karliedapuzzo/TDWS/README.md

# TDWS
Senior Project 2024-25: Train Detection and Warning System.<br>

Made by Raphael Jara and Karlie D'Apuzzo
