karliedapuzzo/TDWS/Schematic Files/Senior_Project_Schematic_Design/Cart_Feb04_0515PM.xls

SHOPPING CART
This is not an invoice
04-Feb-25 17:15:47
 | Mouser # | Mfr. # | Manufacturer | Customer # | Description | RoHS | Lifecycle | Order Qty. | Price (USD) | Ext.: (USD)
1 | 651-1729128 | 1729128 | Phoenix Contact |  | Fixed Terminal Blocks 2P 5.08mm 90DEG | RoHS Compliant By Exemption |  | 12 | $0.935 | $11.22
2 | 71-CRCW06031K00FKED | CRCW06031K00FKED | Vishay |  | Thick Film Resistors - SMD D11/CRCW0603 100 1K0 1% ET3 E3 | RoHS Compliant By Exemption |  | 16 | $0.033 | $0.53
3 | 667-ERA-3AED301V | ERA-3AED301V | Panasonic |  | Thin Film Resistors - SMD 0603 300ohms 25ppm 0.5% AEC-Q200 | RoHS Compliant By Exemption |  | 4 | $0.12 | $0.48
4 | 810-CGA3EDX7T1A106M0 | CGA3EDX7T1A106M080AU | TDK |  | Multilayer Ceramic Capacitors MLCC - SMD/SMT 0603,X7T,10V,10uF,+/-20%,0.8mm, AEC-Q200 | RoHS Compliant | New Product | 8 | $0.49 | $3.92
5 | 485-4479 | 4479 | Adafruit |  | Multiple Function Sensor Development Tools Adafruit Triple-axis Magnetometer - LIS3MDL - STEMMA QT / Qwiic | RoHS Compliant |  | 3 | $9.95 | $29.85
6 | 187-CL32Y476KPVVPNE | CL32Y476KPVVPNE | Samsung Electro-Mechanics |  | Multilayer Ceramic Capacitors MLCC - SMD/SMT 47uF X7S 10V 1210 Auto grade | RoHS Compliant | New Product | 8 | $1.04 | $8.32
7 | 941-C503DWANCCBEB232 | C503D-WAN-CCBEB232 | Cree LED |  | White LEDs White Round | RoHS Compliant |  | 16 | $0.273 | $4.37
8 | 474-PRT-16581 | PRT-16581 | SparkFun Electronics |  | Headers & Wire Housings Female Header - 2x18 | RoHS Compliant |  | 8 | $1.75 | $14.00
9 | 737-PH1RB-08-UA | PH1RB-08-UA | Adam Tech |  | Headers & Wire Housings CONN HEADER R/A 8POS 2.54MM | RoHS Compliant | New At Mouser | 4 | $0.23 | $0.92
10 | 653-A6FR-4101 | A6FR-4101 | Omron |  | DIP Switches / SIP Switches 4 Pole Short Actuator (white) | RoHS Compliant |  | 4 | $1.13 | $4.52
By submitting your order you agree to these terms and conditions. (https://www.mouser.com/saleterms) |  |  |  |  |  |  |  |  | Merchandise: | $78.13
Prices are reflected at the date and time shown. |  |  |  |  |  |  |  |  | Shipping Charge: | $7.99
