karliedapuzzo/TDWS/TDWS_PIC24_FILES/Main_Project/TDWS_Main_Prgram.X/queuelogs/debugtool.txt

65914 1741394754487 GEN4_TO_CONTROLLER_LOG:GEN4_DEBUG_INT_LOG_PIC24FJ128GL306 BitSetInfo: Address = 1a0, Mask = 4000, SetVal = 4000, Type = FileRegs
65914 1741394754487 GEN4_TO_CONTROLLER_LOG:GEN4_DEBUG_INT_LOG_PIC24FJ128GL306 BitSetInfo: Values:
65914 1741394754487 GEN4_TO_CONTROLLER_LOG:GEN4_DEBUG_INT_LOG_PIC24FJ128GL306 BitSetInfo: Address = 1a2, Mask = 4000, SetVal = 4000, Type = FileRegs
65914 1741394754487 GEN4_TO_CONTROLLER_LOG:GEN4_DEBUG_INT_LOG_PIC24FJ128GL306 BitSetInfo: Values:
65914 1741394754487 GEN4_TO_CONTROLLER_LOG:GEN4_DEBUG_INT_LOG_PIC24FJ128GL306 BitSetInfo: Address = 1ae, Mask = 4000, SetVal = 4000, Type = FileRegs
65914 1741394754487 GEN4_TO_CONTROLLER_LOG:GEN4_DEBUG_INT_LOG_PIC24FJ128GL306 BitSetInfo: Values:
65914 1741394754487 GEN4_TO_CONTROLLER_LOG:GEN4_DEBUG_INT_LOG_PIC24FJ128GL306 BitSetInfo: Address = 1b0, Mask = 4000, SetVal = 4000, Type = FileRegs
65914 1741394754487 GEN4_TO_CONTROLLER_LOG:GEN4_DEBUG_INT_LOG_PIC24FJ128GL306 BitSetInfo: Values:
65914 1741394754487 GEN4_TO_CONTROLLER_LOG:GEN4_DEBUG_INT_LOG_PIC24FJ128GL306 BitSetInfo: Address = 1cc, Mask = 4000, SetVal = 4000, Type = FileRegs
65914 1741394754487 GEN4_TO_CONTROLLER_LOG:GEN4_DEBUG_INT_LOG_PIC24FJ128GL306 BitSetInfo: Values:
65914 1741394754487 GEN4_TO_CONTROLLER_LOG:GEN4_DEBUG_INT_LOG_PIC24FJ128GL306 BitSetInfo: Address = 26c, Mask = 4000, SetVal = 4000, Type = FileRegs
65914 1741394754487 GEN4_TO_CONTROLLER_LOG:GEN4_DEBUG_INT_LOG_PIC24FJ128GL306 BitSetInfo: Values:
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
65914 1741394754487 GEN4_TO_CONTROLLER_LOG:GEN4_DEBUG_INT_LOG_PIC24FJ128GL306 BitSetInfo: Address = 4c4, Mask = 4000, SetVal = 4000, Type = FileRegs
65914 1741394754487 GEN4_TO_CONTROLLER_LOG:GEN4_DEBUG_INT_LOG_PIC24FJ128GL306 BitSetInfo: Values:
65914 1741394754487 GEN4_TO_CONTROLLER_LOG:GEN4_DEBUG_INT_LOG_PIC24FJ128GL306 BitSetInfo: Address = 540, Mask = 4000, SetVal = 4000, Type = FileRegs
65914 1741394754487 GEN4_TO_CONTROLLER_LOG:GEN4_DEBUG_INT_LOG_PIC24FJ128GL306 BitSetInfo: Values:
65914 1741394754487 GEN4_TO_CONTROLLER_LOG:GEN4_DEBUG_INT_LOG_PIC24FJ128GL306 BitSetInfo: Address = 65c, Mask = 4000, SetVal = 4000, Type = FileRegs
65914 1741394754487 GEN4_TO_CONTROLLER_LOG:GEN4_DEBUG_INT_LOG_PIC24FJ128GL306 BitSetInfo: Values:
65914 1741394754487 GEN4_TO_CONTROLLER_LOG:GEN4_DEBUG_INT_LOG_PIC24FJ128GL306 BitSetInfo: Address = 734, Mask = 4000, SetVal = 4000, Type = FileRegs
65914 1741394754487 GEN4_TO_CONTROLLER_LOG:GEN4_DEBUG_INT_LOG_PIC24FJ128GL306 BitSetInfo: Values:
65914 1741394754487 GEN4_TO_CONTROLLER_LOG:GEN4_DEBUG_INT_LOG_PIC24FJ128GL306 BitSetInfo: Address = fd0036, Mask = 1, SetVal = 1, Type = Emulation
65914 1741394754487 GEN4_TO_CONTROLLER_LOG:GEN4_DEBUG_INT_LOG_PIC24FJ128GL306 Payload End
65914 1741394754487 XXXX 1741394754487, Thread 65914: XXXX 1741394754487, Entering Thread 65914: Commands::runScriptWithUpload, script name = ReadRAM  
65914 1741394754487 XXXX 1741394754487, Thread 65914: XXXX 1741394754487, Entering Thread 65914: ToolCommUsb::readTransfer, sideData is 0x28 bytes long, transferDataLength is 0x2 bytes long  
65914 1741394754490 XXXX 1741394754490, Thread 65914: XXXX 1741394754490, Exiting Thread 65914: ToolCommUsb::readTransfer,  cr.status = 0x0  
65914 1741394754490 XXXX 1741394754490, Thread 65914: XXXX 1741394754490, Exiting Thread 65914: Commands::runScriptWithUpload  
65914 1741394754490 XXXX 1741394754490, Thread 65914: XXXX 1741394754490, Entering Thread 65914: Commands::runScriptWithDownload, script name = WriteRAM  
65914 1741394754495 XXXX 1741394754495, Thread 65914: XXXX 1741394754495, Exiting Thread 65914: Commands::runScriptWithDownload(WriteRAM)  
65914 1741394754495 XXXX 1741394754495, Thread 65914: XXXX 1741394754495, Entering Thread 65914: Commands::runScriptWithUpload, script name = ReadRAM  
65914 1741394754495 XXXX 1741394754495, Thread 65914: XXXX 1741394754495, Entering Thread 65914: ToolCommUsb::readTransfer, sideData is 0x28 bytes long, transferDataLength is 0x2 bytes long  
65914 1741394754498 XXXX 1741394754498, Thread 65914: XXXX 1741394754498, Exiting Thread 65914: ToolCommUsb::readTransfer,  cr.status = 0x0  
65914 1741394754498 XXXX 1741394754498, Thread 65914: XXXX 1741394754498, Exiting Thread 65914: Commands::runScriptWithUpload  
65914 1741394754498 XXXX 1741394754498, Thread 65914: XXXX 1741394754498, Entering Thread 65914: Commands::runScriptWithDownload, script name = WriteRAM  
65914 1741394754501 XXXX 1741394754501, Thread 65914: XXXX 1741394754501, Exiting Thread 65914: Commands::runScriptWithDownload(WriteRAM)  
65914 1741394754501 XXXX 1741394754501, Thread 65914: XXXX 1741394754501, Entering Thread 65914: Commands::runScriptWithUpload, script name = ReadRAM  
65914 1741394754501 XXXX 1741394754501, Thread 65914: XXXX 1741394754501, Entering Thread 65914: ToolCommUsb::readTransfer, sideData is 0x28 bytes long, transferDataLength is 0x2 bytes long  
65914 1741394754503 XXXX 1741394754503, Thread 65914: XXXX 1741394754503, Exiting Thread 65914: ToolCommUsb::readTransfer,  cr.status = 0x0  
65914 1741394754503 XXXX 1741394754503, Thread 65914: XXXX 1741394754503, Exiting Thread 65914: Commands::runScriptWithUpload  
65914 1741394754503 XXXX 1741394754503, Thread 65914: XXXX 1741394754503, Entering Thread 65914: Commands::runScriptWithDownload, script name = WriteRAM  
65914 1741394754506 XXXX 1741394754506, Thread 65914: XXXX 1741394754506, Exiting Thread 65914: Commands::runScriptWithDownload(WriteRAM)  
65914 1741394754506 XXXX 1741394754506, Thread 65914: XXXX 1741394754506, Entering Thread 65914: Commands::runScriptWithUpload, script name = ReadRAM  
65914 1741394754506 XXXX 1741394754506, Thread 65914: XXXX 1741394754506, Entering Thread 65914: ToolCommUsb::readTransfer, sideData is 0x28 bytes long, transferDataLength is 0x2 bytes long  
65914 1741394754509 XXXX 1741394754509, Thread 65914: XXXX 1741394754509, Exiting Thread 65914: ToolCommUsb::readTransfer,  cr.status = 0x0  
65914 1741394754509 XXXX 1741394754509, Thread 65914: XXXX 1741394754509, Exiting Thread 65914: Commands::runScriptWithUpload  
65914 1741394754509 XXXX 1741394754509, Thread 65914: XXXX 1741394754509, Entering Thread 65914: Commands::runScriptWithDownload, script name = WriteRAM  
65914 1741394754512 XXXX 1741394754512, Thread 65914: XXXX 1741394754512, Exiting Thread 65914: Commands::runScriptWithDownload(WriteRAM)  
65914 1741394754512 XXXX 1741394754512, Thread 65914: XXXX 1741394754512, Entering Thread 65914: Commands::runScriptWithUpload, script name = ReadRAM  
65914 1741394754512 XXXX 1741394754512, Thread 65914: XXXX 1741394754512, Entering Thread 65914: ToolCommUsb::readTransfer, sideData is 0x28 bytes long, transferDataLength is 0x2 bytes long  
65914 1741394754514 XXXX 1741394754514, Thread 65914: XXXX 1741394754514, Exiting Thread 65914: ToolCommUsb::readTransfer,  cr.status = 0x0  
65914 1741394754514 XXXX 1741394754514, Thread 65914: XXXX 1741394754514, Exiting Thread 65914: Commands::runScriptWithUpload  
65914 1741394754514 XXXX 1741394754514, Thread 65914: XXXX 1741394754514, Entering Thread 65914: Commands::runScriptWithDownload, script name = WriteRAM  
65914 1741394754517 XXXX 1741394754517, Thread 65914: XXXX 1741394754517, Exiting Thread 65914: Commands::runScriptWithDownload(WriteRAM)  
65914 1741394754517 XXXX 1741394754517, Thread 65914: XXXX 1741394754517, Entering Thread 65914: Commands::runScriptWithUpload, script name = ReadRAM  
65914 1741394754517 XXXX 1741394754517, Thread 65914: XXXX 1741394754517, Entering Thread 65914: ToolCommUsb::readTransfer, sideData is 0x28 bytes long, transferDataLength is 0x2 bytes long  
65914 1741394754521 XXXX 1741394754521, Thread 65914: XXXX 1741394754521, Exiting Thread 65914: ToolCommUsb::readTransfer,  cr.status = 0x0  
65914 1741394754521 XXXX 1741394754521, Thread 65914: XXXX 1741394754521, Exiting Thread 65914: Commands::runScriptWithUpload  
65914 1741394754521 XXXX 1741394754521, Thread 65914: XXXX 1741394754521, Entering Thread 65914: Commands::runScriptWithDownload, script name = WriteRAM  
65914 1741394754524 XXXX 1741394754524, Thread 65914: XXXX 1741394754524, Exiting Thread 65914: Commands::runScriptWithDownload(WriteRAM)  
65914 1741394754524 XXXX 1741394754524, Thread 65914: XXXX 1741394754524, Entering Thread 65914: Commands::runScriptWithUpload, script name = ReadRAM  
65914 1741394754524 XXXX 1741394754524, Thread 65914: XXXX 1741394754524, Entering Thread 65914: ToolCommUsb::readTransfer, sideData is 0x28 bytes long, transferDataLength is 0x2 bytes long  
65914 1741394754527 XXXX 1741394754527, Thread 65914: XXXX 1741394754527, Exiting Thread 65914: ToolCommUsb::readTransfer,  cr.status = 0x0  
65914 1741394754527 XXXX 1741394754527, Thread 65914: XXXX 1741394754527, Exiting Thread 65914: Commands::runScriptWithUpload  
65914 1741394754527 XXXX 1741394754527, Thread 65914: XXXX 1741394754527, Entering Thread 65914: Commands::runScriptWithDownload, script name = WriteRAM  
65914 1741394754530 XXXX 1741394754530, Thread 65914: XXXX 1741394754530, Exiting Thread 65914: Commands::runScriptWithDownload(WriteRAM)  
65914 1741394754530 XXXX 1741394754530, Thread 65914: XXXX 1741394754530, Entering Thread 65914: Commands::runScriptWithUpload, script name = ReadRAM  
65914 1741394754530 XXXX 1741394754530, Thread 65914: XXXX 1741394754530, Entering Thread 65914: ToolCommUsb::readTransfer, sideData is 0x28 bytes long, transferDataLength is 0x2 bytes long  
65914 1741394754533 XXXX 1741394754533, Thread 65914: XXXX 1741394754533, Exiting Thread 65914: ToolCommUsb::readTransfer,  cr.status = 0x0  
65914 1741394754533 XXXX 1741394754533, Thread 65914: XXXX 1741394754533, Exiting Thread 65914: Commands::runScriptWithUpload  
65914 1741394754533 XXXX 1741394754533, Thread 65914: XXXX 1741394754533, Entering Thread 65914: Commands::runScriptWithDownload, script name = WriteRAM  
65914 1741394754536 XXXX 1741394754536, Thread 65914: XXXX 1741394754536, Exiting Thread 65914: Commands::runScriptWithDownload(WriteRAM)  
65914 1741394754536 XXXX 1741394754536, Thread 65914: XXXX 1741394754536, Entering Thread 65914: Commands::runScriptWithUpload, script name = ReadRAM  
65914 1741394754536 XXXX 1741394754536, Thread 65914: XXXX 1741394754536, Entering Thread 65914: ToolCommUsb::readTransfer, sideData is 0x28 bytes long, transferDataLength is 0x2 bytes long  
65914 1741394754539 XXXX 1741394754539, Thread 65914: XXXX 1741394754539, Exiting Thread 65914: ToolCommUsb::readTransfer,  cr.status = 0x0  
65914 1741394754539 XXXX 1741394754539, Thread 65914: XXXX 1741394754539, Exiting Thread 65914: Commands::runScriptWithUpload  
65914 1741394754539 XXXX 1741394754539, Thread 65914: XXXX 1741394754539, Entering Thread 65914: Commands::runScriptWithDownload, script name = WriteRAM  
65914 1741394754542 XXXX 1741394754542, Thread 65914: XXXX 1741394754542, Exiting Thread 65914: Commands::runScriptWithDownload(WriteRAM)  
65914 1741394754542 XXXX 1741394754542, Thread 65914: XXXX 1741394754542, Entering Thread 65914: Commands::runScriptWithUpload, script name = ReadRAM  
65914 1741394754542 XXXX 1741394754542, Thread 65914: XXXX 1741394754542, Entering Thread 65914: ToolCommUsb::readTransfer, sideData is 0x28 bytes long, transferDataLength is 0x2 bytes long  
65914 1741394754545 XXXX 1741394754545, Thread 65914: XXXX 1741394754545, Exiting Thread 65914: ToolCommUsb::readTransfer,  cr.status = 0x0  
65914 1741394754545 XXXX 1741394754545, Thread 65914: XXXX 1741394754545, Exiting Thread 65914: Commands::runScriptWithUpload  
65914 1741394754545 XXXX 1741394754545, Thread 65914: XXXX 1741394754545, Entering Thread 65914: Commands::runScriptWithDownload, script name = WriteRAM  
65914 1741394754547 XXXX 1741394754547, Thread 65914: XXXX 1741394754547, Exiting Thread 65914: Commands::runScriptWithDownload(WriteRAM)  
65914 1741394754547 XXXX 1741394754547, Thread 65914: XXXX 1741394754547, Entering Thread 65914: Commands::runScriptWithUpload, script name = ReadRAM  
65914 1741394754547 XXXX 1741394754547, Thread 65914: XXXX 1741394754547, Entering Thread 65914: ToolCommUsb::readTransfer, sideData is 0x28 bytes long, transferDataLength is 0x2 bytes long  
65914 1741394754550 XXXX 1741394754550, Thread 65914: XXXX 1741394754550, Exiting Thread 65914: ToolCommUsb::readTransfer,  cr.status = 0x0  
65914 1741394754550 XXXX 1741394754550, Thread 65914: XXXX 1741394754550, Exiting Thread 65914: Commands::runScriptWithUpload  
65914 1741394754550 XXXX 1741394754550, Thread 65914: XXXX 1741394754550, Entering Thread 65914: Commands::runScriptWithDownload, script name = WriteRAM  
65914 1741394754553 XXXX 1741394754553, Thread 65914: XXXX 1741394754553, Exiting Thread 65914: Commands::runScriptWithDownload(WriteRAM)  
65914 1741394754553 XXXX 1741394754553, Thread 65914: XXXX 1741394754553, Entering Thread 65914: Commands::runScriptWithUpload, script name = ReadRAM  
65914 1741394754553 XXXX 1741394754553, Thread 65914: XXXX 1741394754553, Entering Thread 65914: ToolCommUsb::readTransfer, sideData is 0x28 bytes long, transferDataLength is 0x2 bytes long  
65914 1741394754557 XXXX 1741394754557, Thread 65914: XXXX 1741394754557, Exiting Thread 65914: ToolCommUsb::readTransfer,  cr.status = 0x0  
65914 1741394754557 XXXX 1741394754557, Thread 65914: XXXX 1741394754557, Exiting Thread 65914: Commands::runScriptWithUpload  
65914 1741394754557 XXXX 1741394754557, Thread 65914: XXXX 1741394754557, Entering Thread 65914: Commands::runScriptWithDownload, script name = WriteRAM  
65914 1741394754559 XXXX 1741394754559, Thread 65914: XXXX 1741394754559, Exiting Thread 65914: Commands::runScriptWithDownload(WriteRAM)  
65914 1741394754559 XXXX 1741394754559, Thread 65914: XXXX 1741394754559, Entering Thread 65914: Commands::runScriptWithUpload, script name = ReadRAM  
65914 1741394754559 XXXX 1741394754559, Thread 65914: XXXX 1741394754559, Entering Thread 65914: ToolCommUsb::readTransfer, sideData is 0x28 bytes long, transferDataLength is 0x2 bytes long  
65914 1741394754562 XXXX 1741394754562, Thread 65914: XXXX 1741394754562, Exiting Thread 65914: ToolCommUsb::readTransfer,  cr.status = 0x0  
65914 1741394754562 XXXX 1741394754562, Thread 65914: XXXX 1741394754562, Exiting Thread 65914: Commands::runScriptWithUpload  
65914 1741394754562 XXXX 1741394754562, Thread 65914: XXXX 1741394754562, Entering Thread 65914: Commands::runScriptWithDownload, script name = WriteRAM  
65914 1741394754566 XXXX 1741394754566, Thread 65914: XXXX 1741394754566, Exiting Thread 65914: Commands::runScriptWithDownload(WriteRAM)  
65914 1741394754566 XXXX 1741394754566, Thread 65914: XXXX 1741394754566, Entering Thread 65914: Commands::runScriptWithUpload, script name = ReadRAM  
65914 1741394754566 XXXX 1741394754566, Thread 65914: XXXX 1741394754566, Entering Thread 65914: ToolCommUsb::readTransfer, sideData is 0x28 bytes long, transferDataLength is 0x2 bytes long  
65914 1741394754568 XXXX 1741394754568, Thread 65914: XXXX 1741394754568, Exiting Thread 65914: ToolCommUsb::readTransfer,  cr.status = 0x0  
65914 1741394754568 XXXX 1741394754568, Thread 65914: XXXX 1741394754568, Exiting Thread 65914: Commands::runScriptWithUpload  
65914 1741394754568 XXXX 1741394754568, Thread 65914: XXXX 1741394754568, Entering Thread 65914: Commands::runScriptWithDownload, script name = WriteRAM  
65914 1741394754570 XXXX 1741394754570, Thread 65914: XXXX 1741394754570, Exiting Thread 65914: Commands::runScriptWithDownload(WriteRAM)  
65914 1741394754570 XXXX 1741394754570, Thread 65914: XXXX 1741394754570, Entering Thread 65914: Commands::runScriptWithUpload, script name = ReadRAM  
65914 1741394754570 XXXX 1741394754570, Thread 65914: XXXX 1741394754570, Entering Thread 65914: ToolCommUsb::readTransfer, sideData is 0x28 bytes long, transferDataLength is 0x2 bytes long  
65914 1741394754573 XXXX 1741394754573, Thread 65914: XXXX 1741394754573, Exiting Thread 65914: ToolCommUsb::readTransfer,  cr.status = 0x0  
65914 1741394754573 XXXX 1741394754573, Thread 65914: XXXX 1741394754573, Exiting Thread 65914: Commands::runScriptWithUpload  
65914 1741394754573 XXXX 1741394754573, Thread 65914: XXXX 1741394754573, Entering Thread 65914: Commands::runScriptWithDownload, script name = WriteRAM  
65914 1741394754576 XXXX 1741394754576, Thread 65914: XXXX 1741394754576, Exiting Thread 65914: Commands::runScriptWithDownload(WriteRAM)  
65914 1741394754576 XXXX 1741394754576, Thread 65914: XXXX 1741394754576, Entering Thread 65914: Commands::runScriptWithUpload, script name = ReadRAM  
65914 1741394754576 XXXX 1741394754576, Thread 65914: XXXX 1741394754576, Entering Thread 65914: ToolCommUsb::readTransfer, sideData is 0x28 bytes long, transferDataLength is 0x2 bytes long  
65914 1741394754579 XXXX 1741394754579, Thread 65914: XXXX 1741394754579, Exiting Thread 65914: ToolCommUsb::readTransfer,  cr.status = 0x0  
65914 1741394754579 XXXX 1741394754579, Thread 65914: XXXX 1741394754579, Exiting Thread 65914: Commands::runScriptWithUpload  
65914 1741394754579 XXXX 1741394754579, Thread 65914: XXXX 1741394754579, Entering Thread 65914: Commands::runScriptWithDownload, script name = WriteRAM  
65914 1741394754582 XXXX 1741394754582, Thread 65914: XXXX 1741394754582, Exiting Thread 65914: Commands::runScriptWithDownload(WriteRAM)  
65914 1741394754582 XXXX 1741394754582, Thread 65914: XXXX 1741394754582, Entering Thread 65914: Commands::runScriptWithUpload, script name = ReadRAM  
65914 1741394754582 XXXX 1741394754582, Thread 65914: XXXX 1741394754582, Entering Thread 65914: ToolCommUsb::readTransfer, sideData is 0x28 bytes long, transferDataLength is 0x2 bytes long  
65914 1741394754586 XXXX 1741394754586, Thread 65914: XXXX 1741394754586, Exiting Thread 65914: ToolCommUsb::readTransfer,  cr.status = 0x0  
65914 1741394754586 XXXX 1741394754586, Thread 65914: XXXX 1741394754586, Exiting Thread 65914: Commands::runScriptWithUpload  
65914 1741394754586 XXXX 1741394754586, Thread 65914: XXXX 1741394754586, Entering Thread 65914: Commands::runScriptWithDownload, script name = WriteRAM  
65914 1741394754588 XXXX 1741394754588, Thread 65914: XXXX 1741394754588, Exiting Thread 65914: Commands::runScriptWithDownload(WriteRAM)  
65914 1741394754588 XXXX 1741394754588, Thread 65914: XXXX 1741394754588, Entering Thread 65914: Commands::runScriptWithUpload, script name = ReadRAM  
65914 1741394754588 XXXX 1741394754588, Thread 65914: XXXX 1741394754588, Entering Thread 65914: ToolCommUsb::readTransfer, sideData is 0x28 bytes long, transferDataLength is 0x2 bytes long  
65914 1741394754591 XXXX 1741394754591, Thread 65914: XXXX 1741394754591, Exiting Thread 65914: ToolCommUsb::readTransfer,  cr.status = 0x0  
65914 1741394754591 XXXX 1741394754591, Thread 65914: XXXX 1741394754591, Exiting Thread 65914: Commands::runScriptWithUpload  
65914 1741394754591 XXXX 1741394754591, Thread 65914: XXXX 1741394754591, Entering Thread 65914: Commands::runScriptWithDownload, script name = WriteRAM  
65914 1741394754593 XXXX 1741394754593, Thread 65914: XXXX 1741394754593, Exiting Thread 65914: Commands::runScriptWithDownload(WriteRAM)  
65914 1741394754593 XXXX 1741394754593, Thread 65914: XXXX 1741394754593, Entering Thread 65914: Commands::runScriptWithUpload, script name = ReadRAM  
65914 1741394754593 XXXX 1741394754593, Thread 65914: XXXX 1741394754593, Entering Thread 65914: ToolCommUsb::readTransfer, sideData is 0x28 bytes long, transferDataLength is 0x2 bytes long  
65914 1741394754596 XXXX 1741394754596, Thread 65914: XXXX 1741394754596, Exiting Thread 65914: ToolCommUsb::readTransfer,  cr.status = 0x0  
65914 1741394754596 XXXX 1741394754596, Thread 65914: XXXX 1741394754596, Exiting Thread 65914: Commands::runScriptWithUpload  
65914 1741394754596 XXXX 1741394754596, Thread 65914: XXXX 1741394754596, Entering Thread 65914: Commands::runScriptWithDownload, script name = WriteRAM  
65914 1741394754599 XXXX 1741394754599, Thread 65914: XXXX 1741394754599, Exiting Thread 65914: Commands::runScriptWithDownload(WriteRAM)  
65914 1741394754599 XXXX 1741394754599, Thread 65914: XXXX 1741394754599, Entering Thread 65914: Commands::runScriptWithUpload, script name = ReadRAM  
65914 1741394754599 XXXX 1741394754599, Thread 65914: XXXX 1741394754599, Entering Thread 65914: ToolCommUsb::readTransfer, sideData is 0x28 bytes long, transferDataLength is 0x2 bytes long  
65914 1741394754602 XXXX 1741394754602, Thread 65914: XXXX 1741394754602, Exiting Thread 65914: ToolCommUsb::readTransfer,  cr.status = 0x0  
65914 1741394754602 XXXX 1741394754602, Thread 65914: XXXX 1741394754602, Exiting Thread 65914: Commands::runScriptWithUpload  
65914 1741394754602 XXXX 1741394754602, Thread 65914: XXXX 1741394754602, Entering Thread 65914: Commands::runScriptWithDownload, script name = WriteRAM  
65914 1741394754605 XXXX 1741394754605, Thread 65914: XXXX 1741394754605, Exiting Thread 65914: Commands::runScriptWithDownload(WriteRAM)  
65914 1741394754605 XXXX 1741394754605, Thread 65914: XXXX 1741394754605, Entering Thread 65914: Commands::runScriptWithUpload, script name = ReadRAM  
65914 1741394754605 XXXX 1741394754605, Thread 65914: XXXX 1741394754605, Entering Thread 65914: ToolCommUsb::readTransfer, sideData is 0x28 bytes long, transferDataLength is 0x2 bytes long  
65914 1741394754608 XXXX 1741394754608, Thread 65914: XXXX 1741394754608, Exiting Thread 65914: ToolCommUsb::readTransfer,  cr.status = 0x0  
65914 1741394754608 XXXX 1741394754608, Thread 65914: XXXX 1741394754608, Exiting Thread 65914: Commands::runScriptWithUpload  
65914 1741394754608 XXXX 1741394754608, Thread 65914: XXXX 1741394754608, Entering Thread 65914: Commands::runScriptWithDownload, script name = WriteRAM  
65914 1741394754611 XXXX 1741394754611, Thread 65914: XXXX 1741394754611, Exiting Thread 65914: Commands::runScriptWithDownload(WriteRAM)  
65914 1741394754611 XXXX 1741394754611, Thread 65914: XXXX 1741394754611, Entering Thread 65914: Commands::runScriptWithUpload, script name = ReadRAM  
65914 1741394754611 XXXX 1741394754611, Thread 65914: XXXX 1741394754611, Entering Thread 65914: ToolCommUsb::readTransfer, sideData is 0x28 bytes long, transferDataLength is 0x2 bytes long  
65914 1741394754614 XXXX 1741394754614, Thread 65914: XXXX 1741394754614, Exiting Thread 65914: ToolCommUsb::readTransfer,  cr.status = 0x0  
65914 1741394754614 XXXX 1741394754614, Thread 65914: XXXX 1741394754614, Exiting Thread 65914: Commands::runScriptWithUpload  
65914 1741394754614 XXXX 1741394754614, Thread 65914: XXXX 1741394754614, Entering Thread 65914: Commands::runScriptWithDownload, script name = WriteRAM  
65914 1741394754618 XXXX 1741394754618, Thread 65914: XXXX 1741394754618, Exiting Thread 65914: Commands::runScriptWithDownload(WriteRAM)  
65914 1741394754618 XXXX 1741394754618, Thread 65914: XXXX 1741394754618, Entering Thread 65914: Commands::runScriptWithUpload, script name = ReadRAM  
65914 1741394754618 XXXX 1741394754618, Thread 65914: XXXX 1741394754618, Entering Thread 65914: ToolCommUsb::readTransfer, sideData is 0x28 bytes long, transferDataLength is 0x2 bytes long  
65914 1741394754621 XXXX 1741394754621, Thread 65914: XXXX 1741394754621, Exiting Thread 65914: ToolCommUsb::readTransfer,  cr.status = 0x0  
65914 1741394754621 XXXX 1741394754621, Thread 65914: XXXX 1741394754621, Exiting Thread 65914: Commands::runScriptWithUpload  
65914 1741394754621 XXXX 1741394754621, Thread 65914: XXXX 1741394754621, Entering Thread 65914: Commands::runScriptWithDownload, script name = WriteRAM  
65914 1741394754624 XXXX 1741394754624, Thread 65914: XXXX 1741394754624, Exiting Thread 65914: Commands::runScriptWithDownload(WriteRAM)  
65914 1741394754624 XXXX 1741394754624, Thread 65914: XXXX 1741394754624, Entering Thread 65914: Commands::runScriptWithUpload, script name = ReadRAM  
65914 1741394754624 XXXX 1741394754624, Thread 65914: XXXX 1741394754624, Entering Thread 65914: ToolCommUsb::readTransfer, sideData is 0x28 bytes long, transferDataLength is 0x2 bytes long  
65914 1741394754627 XXXX 1741394754627, Thread 65914: XXXX 1741394754627, Exiting Thread 65914: ToolCommUsb::readTransfer,  cr.status = 0x0  
65914 1741394754627 XXXX 1741394754627, Thread 65914: XXXX 1741394754627, Exiting Thread 65914: Commands::runScriptWithUpload  
65914 1741394754627 XXXX 1741394754627, Thread 65914: XXXX 1741394754627, Entering Thread 65914: Commands::runScriptWithDownload, script name = WriteRAM  
65914 1741394754630 XXXX 1741394754630, Thread 65914: XXXX 1741394754630, Exiting Thread 65914: Commands::runScriptWithDownload(WriteRAM)  
65914 1741394754630 XXXX 1741394754630, Thread 65914: XXXX 1741394754630, Entering Thread 65914: Commands::runScriptWithUpload, script name = ReadRAM  
65914 1741394754630 XXXX 1741394754630, Thread 65914: XXXX 1741394754630, Entering Thread 65914: ToolCommUsb::readTransfer, sideData is 0x28 bytes long, transferDataLength is 0x2 bytes long  
65914 1741394754632 XXXX 1741394754632, Thread 65914: XXXX 1741394754632, Exiting Thread 65914: ToolCommUsb::readTransfer,  cr.status = 0x0  
65914 1741394754632 XXXX 1741394754632, Thread 65914: XXXX 1741394754632, Exiting Thread 65914: Commands::runScriptWithUpload  
65914 1741394754632 XXXX 1741394754632, Thread 65914: XXXX 1741394754632, Entering Thread 65914: Commands::runScriptWithDownload, script name = WriteRAM  
65914 1741394754635 XXXX 1741394754635, Thread 65914: XXXX 1741394754635, Exiting Thread 65914: Commands::runScriptWithDownload(WriteRAM)  
65914 1741394754635 XXXX 1741394754635, Thread 65914: XXXX 1741394754635, Entering Thread 65914: Commands::runScriptWithUpload, script name = ReadRAM  
65914 1741394754635 XXXX 1741394754635, Thread 65914: XXXX 1741394754635, Entering Thread 65914: ToolCommUsb::readTransfer, sideData is 0x28 bytes long, transferDataLength is 0x2 bytes long  
65914 1741394754639 XXXX 1741394754639, Thread 65914: XXXX 1741394754639, Exiting Thread 65914: ToolCommUsb::readTransfer,  cr.status = 0x0  
65914 1741394754639 XXXX 1741394754639, Thread 65914: XXXX 1741394754639, Exiting Thread 65914: Commands::runScriptWithUpload  
65914 1741394754639 XXXX 1741394754639, Thread 65914: XXXX 1741394754639, Entering Thread 65914: Commands::runScriptWithDownload, script name = WriteRAM  
65914 1741394754640 XXXX 1741394754640, Thread 65914: XXXX 1741394754640, Exiting Thread 65914: Commands::runScriptWithDownload(WriteRAM)  
65914 1741394754640 XXXX 1741394754640, Thread 65914: XXXX 1741394754640, Entering Thread 65914: Commands::runScriptWithUpload, script name = ReadRAM  
65914 1741394754640 XXXX 1741394754640, Thread 65914: XXXX 1741394754640, Entering Thread 65914: ToolCommUsb::readTransfer, sideData is 0x28 bytes long, transferDataLength is 0x2 bytes long  
65914 1741394754643 XXXX 1741394754643, Thread 65914: XXXX 1741394754643, Exiting Thread 65914: ToolCommUsb::readTransfer,  cr.status = 0x0  
65914 1741394754643 XXXX 1741394754643, Thread 65914: XXXX 1741394754643, Exiting Thread 65914: Commands::runScriptWithUpload  
65914 1741394754643 XXXX 1741394754643, Thread 65914: XXXX 1741394754643, Entering Thread 65914: Commands::runScriptWithDownload, script name = WriteRAM  
65914 1741394754646 XXXX 1741394754646, Thread 65914: XXXX 1741394754646, Exiting Thread 65914: Commands::runScriptWithDownload(WriteRAM)  
65914 1741394754646 XXXX 1741394754646, Thread 65914: XXXX 1741394754646, Entering Thread 65914: Commands::runScriptWithUpload, script name = ReadRAM  
65914 1741394754646 XXXX 1741394754646, Thread 65914: XXXX 1741394754646, Entering Thread 65914: ToolCommUsb::readTransfer, sideData is 0x28 bytes long, transferDataLength is 0x2 bytes long  
65914 1741394754650 XXXX 1741394754650, Thread 65914: XXXX 1741394754650, Exiting Thread 65914: ToolCommUsb::readTransfer,  cr.status = 0x0  
65914 1741394754650 XXXX 1741394754650, Thread 65914: XXXX 1741394754650, Exiting Thread 65914: Commands::runScriptWithUpload  
65914 1741394754650 XXXX 1741394754650, Thread 65914: XXXX 1741394754650, Entering Thread 65914: Commands::runScriptWithDownload, script name = WriteRAM  
65914 1741394754653 XXXX 1741394754653, Thread 65914: XXXX 1741394754653, Exiting Thread 65914: Commands::runScriptWithDownload(WriteRAM)  
65914 1741394754653 XXXX 1741394754653, Thread 65914: XXXX 1741394754653, Entering Thread 65914: Commands::runScriptWithUpload, script name = ReadRAM  
65914 1741394754653 XXXX 1741394754653, Thread 65914: XXXX 1741394754653, Entering Thread 65914: ToolCommUsb::readTransfer, sideData is 0x28 bytes long, transferDataLength is 0x2 bytes long  
65914 1741394754655 XXXX 1741394754655, Thread 65914: XXXX 1741394754655, Exiting Thread 65914: ToolCommUsb::readTransfer,  cr.status = 0x0  
65914 1741394754655 XXXX 1741394754655, Thread 65914: XXXX 1741394754655, Exiting Thread 65914: Commands::runScriptWithUpload  
65914 1741394754655 XXXX 1741394754655, Thread 65914: XXXX 1741394754655, Entering Thread 65914: Commands::runScriptWithDownload, script name = WriteRAM  
65914 1741394754658 XXXX 1741394754658, Thread 65914: XXXX 1741394754658, Exiting Thread 65914: Commands::runScriptWithDownload(WriteRAM)  
65914 1741394754658 XXXX 1741394754658, Thread 65914: XXXX 1741394754658, Entering Thread 65914: Commands::runScriptWithUpload, script name = ReadRAM  
65914 1741394754658 XXXX 1741394754658, Thread 65914: XXXX 1741394754658, Entering Thread 65914: ToolCommUsb::readTransfer, sideData is 0x28 bytes long, transferDataLength is 0x2 bytes long  
65914 1741394754661 XXXX 1741394754661, Thread 65914: XXXX 1741394754661, Exiting Thread 65914: ToolCommUsb::readTransfer,  cr.status = 0x0  
65914 1741394754661 XXXX 1741394754661, Thread 65914: XXXX 1741394754661, Exiting Thread 65914: Commands::runScriptWithUpload  
65914 1741394754661 XXXX 1741394754661, Thread 65914: XXXX 1741394754661, Entering Thread 65914: Commands::runScriptWithDownload, script name = WriteRAM  
65914 1741394754664 XXXX 1741394754664, Thread 65914: XXXX 1741394754664, Exiting Thread 65914: Commands::runScriptWithDownload(WriteRAM)  
65914 1741394754664 XXXX 1741394754664, Thread 65914: XXXX 1741394754664, Entering Thread 65914: Commands::runScriptWithUpload, script name = ReadRAM  
65914 1741394754664 XXXX 1741394754664, Thread 65914: XXXX 1741394754664, Entering Thread 65914: ToolCommUsb::readTransfer, sideData is 0x28 bytes long, transferDataLength is 0x2 bytes long  
65914 1741394754668 XXXX 1741394754668, Thread 65914: XXXX 1741394754668, Exiting Thread 65914: ToolCommUsb::readTransfer,  cr.status = 0x0  
65914 1741394754668 XXXX 1741394754668, Thread 65914: XXXX 1741394754668, Exiting Thread 65914: Commands::runScriptWithUpload  
65914 1741394754668 XXXX 1741394754668, Thread 65914: XXXX 1741394754668, Entering Thread 65914: Commands::runScriptWithDownload, script name = WriteRAM  
65914 1741394754670 XXXX 1741394754670, Thread 65914: XXXX 1741394754670, Exiting Thread 65914: Commands::runScriptWithDownload(WriteRAM)  
65914 1741394754670 XXXX 1741394754670, Thread 65914: XXXX 1741394754670, Entering Thread 65914: Commands::runScriptWithUpload, script name = ReadRAM  
65914 1741394754670 XXXX 1741394754670, Thread 65914: XXXX 1741394754670, Entering Thread 65914: ToolCommUsb::readTransfer, sideData is 0x28 bytes long, transferDataLength is 0x2 bytes long  
65914 1741394754673 XXXX 1741394754673, Thread 65914: XXXX 1741394754673, Exiting Thread 65914: ToolCommUsb::readTransfer,  cr.status = 0x0  
65914 1741394754673 XXXX 1741394754673, Thread 65914: XXXX 1741394754673, Exiting Thread 65914: Commands::runScriptWithUpload  
65914 1741394754673 XXXX 1741394754673, Thread 65914: XXXX 1741394754673, Entering Thread 65914: Commands::runScriptWithDownload, script name = WriteRAM  
65914 1741394754676 XXXX 1741394754676, Thread 65914: XXXX 1741394754676, Exiting Thread 65914: Commands::runScriptWithDownload(WriteRAM)  
65914 1741394754676 XXXX 1741394754676, Thread 65914: XXXX 1741394754676, Entering Thread 65914: Commands::runScriptWithUpload, script name = ReadRAM  
65914 1741394754676 XXXX 1741394754676, Thread 65914: XXXX 1741394754676, Entering Thread 65914: ToolCommUsb::readTransfer, sideData is 0x28 bytes long, transferDataLength is 0x2 bytes long  
65914 1741394754680 XXXX 1741394754680, Thread 65914: XXXX 1741394754680, Exiting Thread 65914: ToolCommUsb::readTransfer,  cr.status = 0x0  
65914 1741394754680 XXXX 1741394754680, Thread 65914: XXXX 1741394754680, Exiting Thread 65914: Commands::runScriptWithUpload  
65914 1741394754680 XXXX 1741394754680, Thread 65914: XXXX 1741394754680, Entering Thread 65914: Commands::runScriptWithDownload, script name = WriteRAM  
65914 1741394754683 XXXX 1741394754683, Thread 65914: XXXX 1741394754683, Exiting Thread 65914: Commands::runScriptWithDownload(WriteRAM)  
65914 1741394754683 GEN4_TO_CONTROLLER_LOG:GEN4_DEBUG_INT_LOG_PIC24FJ128GL306 Post:SetFreezePerihperalInfo
65914 1741394754683 GEN4_TO_CONTROLLER_LOG:GEN4_DEBUG_INT_LOG_PIC24FJ128GL306 Return Value
65914 1741394754683 GEN4_TO_CONTROLLER_LOG:GEN4_DEBUG_INT_LOG_PIC24FJ128GL306 none
65914 1741394754683 GEN4_TO_CONTROLLER_LOG:GEN4_DEBUG_INT_LOG_PIC24FJ128GL306 Return End

65891 1741394755626 GEN4_TO_CONTROLLER_LOG:GEN4_DEBUG_INT_LOG_PIC24FJ128GL306 Pre:DebugReadTargetMemory
65891 1741394755626 GEN4_TO_CONTROLLER_LOG:GEN4_DEBUG_INT_LOG_PIC24FJ128GL306 Payload
65891 1741394755626 GEN4_TO_CONTROLLER_LOG:GEN4_DEBUG_INT_LOG_PIC24FJ128GL306 FileRegs
65891 1741394755626 GEN4_TO_CONTROLLER_LOG:GEN4_DEBUG_INT_LOG_PIC24FJ128GL306 81e
65891 1741394755626 GEN4_TO_CONTROLLER_LOG:GEN4_DEBUG_INT_LOG_PIC24FJ128GL306 81f
65891 1741394755626 GEN4_TO_CONTROLLER_LOG:GEN4_DEBUG_INT_LOG_PIC24FJ128GL306 Length = 2
65891 1741394755626 GEN4_TO_CONTROLLER_LOG:GEN4_DEBUG_INT_LOG_PIC24FJ128GL306 Payload End
65891 1741394755626 XXXX 1741394755626, Thread 65891: XXXX 1741394755626, Entering Thread 65891: Commands::runScriptWithUpload, script name = ReadRAM  
65891 1741394755626 XXXX 1741394755626, Thread 65891: XXXX 1741394755626, Entering Thread 65891: ToolCommUsb::readTransfer, sideData is 0x28 bytes long, transferDataLength is 0x2 bytes long  
65891 1741394755629 XXXX 1741394755629, Thread 65891: XXXX 1741394755629, Exiting Thread 65891: ToolCommUsb::readTransfer,  cr.status = 0x0  
65891 1741394755629 XXXX 1741394755629, Thread 65891: XXXX 1741394755629, Exiting Thread 65891: Commands::runScriptWithUpload  
65891 1741394755629 GEN4_TO_CONTROLLER_LOG:GEN4_DEBUG_INT_LOG_PIC24FJ128GL306 Post:DebugReadTargetMemory
65891 1741394755629 GEN4_TO_CONTROLLER_LOG:GEN4_DEBUG_INT_LOG_PIC24FJ128GL306 Return Value
65891 1741394755629 GEN4_TO_CONTROLLER_LOG:GEN4_DEBUG_INT_LOG_PIC24FJ128GL306 true
65891 1741394755629 GEN4_TO_CONTROLLER_LOG:GEN4_DEBUG_INT_LOG_PIC24FJ128GL306 Return End

65891 1741394755629 GEN4_TO_CONTROLLER_LOG:GEN4_DEBUG_INT_LOG_PIC24FJ128GL306 Pre:DebugReadTargetMemory
65891 1741394755629 GEN4_TO_CONTROLLER_LOG:GEN4_DEBUG_INT_LOG_PIC24FJ128GL306 Payload
65891 1741394755629 GEN4_TO_CONTROLLER_LOG:GEN4_DEBUG_INT_LOG_PIC24FJ128GL306 FileRegs
65891 1741394755629 GEN4_TO_CONTROLLER_LOG:GEN4_DEBUG_INT_LOG_PIC24FJ128GL306 88
65891 1741394755629 GEN4_TO_CONTROLLER_LOG:GEN4_DEBUG_INT_LOG_PIC24FJ128GL306 89
65891 1741394755629 GEN4_TO_CONTROLLER_LOG:GEN4_DEBUG_INT_LOG_PIC24FJ128GL306 Length = 2
65891 1741394755629 GEN4_TO_CONTROLLER_LOG:GEN4_DEBUG_INT_LOG_PIC24FJ128GL306 Payload End
65891 1741394755629 XXXX 1741394755629, Thread 65891: XXXX 1741394755629, Entering Thread 65891: Commands::runScriptWithUpload, script name = ReadRAM  
65891 1741394755629 XXXX 1741394755629, Thread 65891: XXXX 1741394755629, Entering Thread 65891: ToolCommUsb::readTransfer, sideData is 0x28 bytes long, transferDataLength is 0x2 bytes long  
65891 1741394755632 XXXX 1741394755632, Thread 65891: XXXX 1741394755632, Exiting Thread 65891: ToolCommUsb::readTransfer,  cr.status = 0x0  
65891 1741394755632 XXXX 1741394755632, Thread 65891: XXXX 1741394755632, Exiting Thread 65891: Commands::runScriptWithUpload  
65891 1741394755632 GEN4_TO_CONTROLLER_LOG:GEN4_DEBUG_INT_LOG_PIC24FJ128GL306 Post:DebugReadTargetMemory
65891 1741394755632 GEN4_TO_CONTROLLER_LOG:GEN4_DEBUG_INT_LOG_PIC24FJ128GL306 Return Value
65891 1741394755632 GEN4_TO_CONTROLLER_LOG:GEN4_DEBUG_INT_LOG_PIC24FJ128GL306 true
65891 1741394755632 GEN4_TO_CONTROLLER_LOG:GEN4_DEBUG_INT_LOG_PIC24FJ128GL306 Return End

65891 1741394755632 GEN4_TO_CONTROLLER_LOG:GEN4_DEBUG_INT_LOG_PIC24FJ128GL306 Pre:DebugReadTargetMemory
65891 1741394755632 GEN4_TO_CONTROLLER_LOG:GEN4_DEBUG_INT_LOG_PIC24FJ128GL306 Payload
65891 1741394755632 GEN4_TO_CONTROLLER_LOG:GEN4_DEBUG_INT_LOG_PIC24FJ128GL306 FileRegs
65891 1741394755632 GEN4_TO_CONTROLLER_LOG:GEN4_DEBUG_INT_LOG_PIC24FJ128GL306 98
65891 1741394755632 GEN4_TO_CONTROLLER_LOG:GEN4_DEBUG_INT_LOG_PIC24FJ128GL306 99
65891 1741394755632 GEN4_TO_CONTROLLER_LOG:GEN4_DEBUG_INT_LOG_PIC24FJ128GL306 Length = 2
65891 1741394755632 GEN4_TO_CONTROLLER_LOG:GEN4_DEBUG_INT_LOG_PIC24FJ128GL306 Payload End
65891 1741394755632 XXXX 1741394755632, Thread 65891: XXXX 1741394755632, Entering Thread 65891: Commands::runScriptWithUpload, script name = ReadRAM  
65891 1741394755632 XXXX 1741394755632, Thread 65891: XXXX 1741394755632, Entering Thread 65891: ToolCommUsb::readTransfer, sideData is 0x28 bytes long, transferDataLength is 0x2 bytes long  
65891 1741394755635 XXXX 1741394755635, Thread 65891: XXXX 1741394755635, Exiting Thread 65891: ToolCommUsb::readTransfer,  cr.status = 0x0  
65891 1741394755635 XXXX 1741394755635, Thread 65891: XXXX 1741394755635, Exiting Thread 65891: Commands::runScriptWithUpload  
65891 1741394755635 GEN4_TO_CONTROLLER_LOG:GEN4_DEBUG_INT_LOG_PIC24FJ128GL306 Post:DebugReadTargetMemory
65891 1741394755635 GEN4_TO_CONTROLLER_LOG:GEN4_DEBUG_INT_LOG_PIC24FJ128GL306 Return Value
65891 1741394755635 GEN4_TO_CONTROLLER_LOG:GEN4_DEBUG_INT_LOG_PIC24FJ128GL306 true
65891 1741394755635 GEN4_TO_CONTROLLER_LOG:GEN4_DEBUG_INT_LOG_PIC24FJ128GL306 Return End

65891 1741394755635 GEN4_TO_CONTROLLER_LOG:GEN4_DEBUG_INT_LOG_PIC24FJ128GL306 Pre:DebugReadTargetMemory
65891 1741394755635 GEN4_TO_CONTROLLER_LOG:GEN4_DEBUG_INT_LOG_PIC24FJ128GL306 Payload
65891 1741394755635 GEN4_TO_CONTROLLER_LOG:GEN4_DEBUG_INT_LOG_PIC24FJ128GL306 FileRegs
65891 1741394755635 GEN4_TO_CONTROLLER_LOG:GEN4_DEBUG_INT_LOG_PIC24FJ128GL306 178
65891 1741394755635 GEN4_TO_CONTROLLER_LOG:GEN4_DEBUG_INT_LOG_PIC24FJ128GL306 179
65891 1741394755635 GEN4_TO_CONTROLLER_LOG:GEN4_DEBUG_INT_LOG_PIC24FJ128GL306 Length = 2
65891 1741394755635 GEN4_TO_CONTROLLER_LOG:GEN4_DEBUG_INT_LOG_PIC24FJ128GL306 Payload End
65891 1741394755635 XXXX 1741394755635, Thread 65891: XXXX 1741394755635, Entering Thread 65891: Commands::runScriptWithUpload, script name = ReadRAM  
65891 1741394755635 XXXX 1741394755635, Thread 65891: XXXX 1741394755635, Entering Thread 65891: ToolCommUsb::readTransfer, sideData is 0x28 bytes long, transferDataLength is 0x2 bytes long  
65891 1741394755638 XXXX 1741394755638, Thread 65891: XXXX 1741394755638, Exiting Thread 65891: ToolCommUsb::readTransfer,  cr.status = 0x0  
65891 1741394755638 XXXX 1741394755638, Thread 65891: XXXX 1741394755638, Exiting Thread 65891: Commands::runScriptWithUpload  
65891 1741394755638 GEN4_TO_CONTROLLER_LOG:GEN4_DEBUG_INT_LOG_PIC24FJ128GL306 Post:DebugReadTargetMemory
65891 1741394755638 GEN4_TO_CONTROLLER_LOG:GEN4_DEBUG_INT_LOG_PIC24FJ128GL306 Return Value
65891 1741394755638 GEN4_TO_CONTROLLER_LOG:GEN4_DEBUG_INT_LOG_PIC24FJ128GL306 true
65891 1741394755638 GEN4_TO_CONTROLLER_LOG:GEN4_DEBUG_INT_LOG_PIC24FJ128GL306 Return End

66000 1741394755638 GEN4_TO_CONTROLLER_LOG:GEN4_DEBUG_INT_LOG_PIC24FJ128GL306 Pre:setTraceDescriptor
66000 1741394755638 GEN4_TO_CONTROLLER_LOG:GEN4_DEBUG_INT_LOG_PIC24FJ128GL306 Payload
66000 1741394755638 GEN4_TO_CONTROLLER_LOG:GEN4_DEBUG_INT_LOG_PIC24FJ128GL306 com.microchip.mplab.libs.RI4ToolsController.DataClasses.TraceDescriptor@43c3fec
66000 1741394755638 GEN4_TO_CONTROLLER_LOG:GEN4_DEBUG_INT_LOG_PIC24FJ128GL306 Payload End
66000 1741394755638 GEN4_TO_CONTROLLER_LOG:GEN4_DEBUG_INT_LOG_PIC24FJ128GL306 Post:setTraceDescriptor
66000 1741394755638 GEN4_TO_CONTROLLER_LOG:GEN4_DEBUG_INT_LOG_PIC24FJ128GL306 Return Value
66000 1741394755638 GEN4_TO_CONTROLLER_LOG:GEN4_DEBUG_INT_LOG_PIC24FJ128GL306 none
66000 1741394755638 GEN4_TO_CONTROLLER_LOG:GEN4_DEBUG_INT_LOG_PIC24FJ128GL306 Return End

65891 1741394755638 GEN4_TO_CONTROLLER_LOG:GEN4_DEBUG_INT_LOG_PIC24FJ128GL306 Pre:DebugReadTargetMemory
65891 1741394755638 GEN4_TO_CONTROLLER_LOG:GEN4_DEBUG_INT_LOG_PIC24FJ128GL306 Payload
65891 1741394755638 GEN4_TO_CONTROLLER_LOG:GEN4_DEBUG_INT_LOG_PIC24FJ128GL306 FileRegs
65891 1741394755638 GEN4_TO_CONTROLLER_LOG:GEN4_DEBUG_INT_LOG_PIC24FJ128GL306 196
65891 1741394755638 GEN4_TO_CONTROLLER_LOG:GEN4_DEBUG_INT_LOG_PIC24FJ128GL306 197
65891 1741394755638 GEN4_TO_CONTROLLER_LOG:GEN4_DEBUG_INT_LOG_PIC24FJ128GL306 Length = 2
65891 1741394755638 GEN4_TO_CONTROLLER_LOG:GEN4_DEBUG_INT_LOG_PIC24FJ128GL306 Payload End
65891 1741394755638 XXXX 1741394755638, Thread 65891: XXXX 1741394755638, Entering Thread 65891: Commands::runScriptWithUpload, script name = ReadRAM  
65891 1741394755638 XXXX 1741394755638, Thread 65891: XXXX 1741394755638, Entering Thread 65891: ToolCommUsb::readTransfer, sideData is 0x28 bytes long, transferDataLength is 0x2 bytes long  
65891 1741394755641 XXXX 1741394755641, Thread 65891: XXXX 1741394755641, Exiting Thread 65891: ToolCommUsb::readTransfer,  cr.status = 0x0  
65891 1741394755641 XXXX 1741394755641, Thread 65891: XXXX 1741394755641, Exiting Thread 65891: Commands::runScriptWithUpload  
65891 1741394755641 GEN4_TO_CONTROLLER_LOG:GEN4_DEBUG_INT_LOG_PIC24FJ128GL306 Post:DebugReadTargetMemory
65891 1741394755641 GEN4_TO_CONTROLLER_LOG:GEN4_DEBUG_INT_LOG_PIC24FJ128GL306 Return Value
65891 1741394755641 GEN4_TO_CONTROLLER_LOG:GEN4_DEBUG_INT_LOG_PIC24FJ128GL306 true
65891 1741394755641 GEN4_TO_CONTROLLER_LOG:GEN4_DEBUG_INT_LOG_PIC24FJ128GL306 Return End

66000 1741394755641 GEN4_TO_CONTROLLER_LOG:GEN4_DEBUG_INT_LOG_PIC24FJ128GL306 Pre:DebugWriteTargetMemory
66000 1741394755641 GEN4_TO_CONTROLLER_LOG:GEN4_DEBUG_INT_LOG_PIC24FJ128GL306 Payload
66000 1741394755641 GEN4_TO_CONTROLLER_LOG:GEN4_DEBUG_INT_LOG_PIC24FJ128GL306 Emulation
66000 1741394755641 GEN4_TO_CONTROLLER_LOG:GEN4_DEBUG_INT_LOG_PIC24FJ128GL306 fd0000
66000 1741394755641 GEN4_TO_CONTROLLER_LOG:GEN4_DEBUG_INT_LOG_PIC24FJ128GL306 fd004f
66000 1741394755641 GEN4_TO_CONTROLLER_LOG:GEN4_DEBUG_INT_LOG_PIC24FJ128GL306 Length = 80
66000 1741394755641 GEN4_TO_CONTROLLER_LOG:GEN4_DEBUG_INT_LOG_PIC24FJ128GL306 Payload End
66000 1741394755641 XXXX 1741394755641, Thread 66000: XXXX 1741394755641, Entering Thread 66000: Commands::runScriptWithDownload, script name = WriteEmu  
66000 1741394755651 XXXX 1741394755651, Thread 66000: XXXX 1741394755651, Exiting Thread 66000: Commands::runScriptWithDownload(WriteEmu)  
66000 1741394755651 GEN4_TO_CONTROLLER_LOG:GEN4_DEBUG_INT_LOG_PIC24FJ128GL306 Post:DebugWriteTargetMemory
66000 1741394755651 GEN4_TO_CONTROLLER_LOG:GEN4_DEBUG_INT_LOG_PIC24FJ128GL306 Return Value
66000 1741394755651 GEN4_TO_CONTROLLER_LOG:GEN4_DEBUG_INT_LOG_PIC24FJ128GL306 true
66000 1741394755651 GEN4_TO_CONTROLLER_LOG:GEN4_DEBUG_INT_LOG_PIC24FJ128GL306 Return End

65891 1741394755651 GEN4_TO_CONTROLLER_LOG:GEN4_DEBUG_INT_LOG_PIC24FJ128GL306 Pre:DebugReadTargetMemory
65891 1741394755651 GEN4_TO_CONTROLLER_LOG:GEN4_DEBUG_INT_LOG_PIC24FJ128GL306 Payload
65891 1741394755651 GEN4_TO_CONTROLLER_LOG:GEN4_DEBUG_INT_LOG_PIC24FJ128GL306 FileRegs
65891 1741394755651 GEN4_TO_CONTROLLER_LOG:GEN4_DEBUG_INT_LOG_PIC24FJ128GL306 19c
65891 1741394755651 GEN4_TO_CONTROLLER_LOG:GEN4_DEBUG_INT_LOG_PIC24FJ128GL306 19d
65891 1741394755651 GEN4_TO_CONTROLLER_LOG:GEN4_DEBUG_INT_LOG_PIC24FJ128GL306 Length = 2
65891 1741394755651 GEN4_TO_CONTROLLER_LOG:GEN4_DEBUG_INT_LOG_PIC24FJ128GL306 Payload End
65891 1741394755651 XXXX 1741394755651, Thread 65891: XXXX 1741394755651, Entering Thread 65891: Commands::runScriptWithUpload, script name = ReadRAM  
65891 1741394755651 XXXX 1741394755651, Thread 65891: XXXX 1741394755651, Entering Thread 65891: ToolCommUsb::readTransfer, sideData is 0x28 bytes long, transferDataLength is 0x2 bytes long  
65891 1741394755654 XXXX 1741394755654, Thread 65891: XXXX 1741394755654, Exiting Thread 65891: ToolCommUsb::readTransfer,  cr.status = 0x0  
65891 1741394755654 XXXX 1741394755654, Thread 65891: XXXX 1741394755654, Exiting Thread 65891: Commands::runScriptWithUpload  
65891 1741394755654 GEN4_TO_CONTROLLER_LOG:GEN4_DEBUG_INT_LOG_PIC24FJ128GL306 Post:DebugReadTargetMemory
65891 1741394755654 GEN4_TO_CONTROLLER_LOG:GEN4_DEBUG_INT_LOG_PIC24FJ128GL306 Return Value
65891 1741394755654 GEN4_TO_CONTROLLER_LOG:GEN4_DEBUG_INT_LOG_PIC24FJ128GL306 true
65891 1741394755654 GEN4_TO_CONTROLLER_LOG:GEN4_DEBUG_INT_LOG_PIC24FJ128GL306 Return End

66000 1741394755654 GEN4_TO_CONTROLLER_LOG:GEN4_DEBUG_INT_LOG_PIC24FJ128GL306 Pre:SetFreezePerihperalInfo
66000 1741394755654 GEN4_TO_CONTROLLER_LOG:GEN4_DEBUG_INT_LOG_PIC24FJ128GL306 Payload
66000 1741394755654 GEN4_TO_CONTROLLER_LOG:GEN4_DEBUG_INT_LOG_PIC24FJ128GL306 BitSetInfo: Values:
66000 1741394755654 GEN4_TO_CONTROLLER_LOG:GEN4_DEBUG_INT_LOG_PIC24FJ128GL306 BitSetInfo: Address = 106, Mask = 4000, SetVal = 4000, Type = FileRegs
66000 1741394755654 GEN4_TO_CONTROLLER_LOG:GEN4_DEBUG_INT_LOG_PIC24FJ128GL306 BitSetInfo: Values:
66000 1741394755654 GEN4_TO_CONTROLLER_LOG:GEN4_DEBUG_INT_LOG_PIC24FJ128GL306 BitSetInfo: Address = 114, Mask = 4000, SetVal = 4000, Type = FileRegs
66000 1741394755654 GEN4_TO_CONTROLLER_LOG:GEN4_DEBUG_INT_LOG_PIC24FJ128GL306 BitSetInfo: Values:
66000 1741394755654 GEN4_TO_CONTROLLER_LOG:GEN4_DEBUG_INT_LOG_PIC24FJ128GL306 BitSetInfo: Address = 158, Mask = 4000, SetVal = 4000, Type = FileRegs
66000 1741394755654 GEN4_TO_CONTROLLER_LOG:GEN4_DEBUG_INT_LOG_PIC24FJ128GL306 BitSetInfo: Values:
66000 1741394755654 GEN4_TO_CONTROLLER_LOG:GEN4_DEBUG_INT_LOG_PIC24FJ128GL306 BitSetInfo: Address = 168, Mask = 4000, SetVal = 4000, Type = FileRegs
66000 1741394755654 GEN4_TO_CONTROLLER_LOG:GEN4_DEBUG_INT_LOG_PIC24FJ128GL306 BitSetInfo: Values:
66000 1741394755654 GEN4_TO_CONTROLLER_LOG:GEN4_DEBUG_INT_LOG_PIC24FJ128GL306 BitSetInfo: Address = 194, Mask = 4000, SetVal = 4000, Type = FileRegs
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
66000 1741394755654 GEN4_TO_CONTROLLER_LOG:GEN4_DEBUG_INT_LOG_PIC24FJ128GL306 BitSetInfo: Values:
66000 1741394755654 GEN4_TO_CONTROLLER_LOG:GEN4_DEBUG_INT_LOG_PIC24FJ128GL306 BitSetInfo: Address = 464, Mask = 4000, SetVal = 4000, Type = FileRegs
66000 1741394755654 GEN4_TO_CONTROLLER_LOG:GEN4_DEBUG_INT_LOG_PIC24FJ128GL306 BitSetInfo: Values:
66000 1741394755654 GEN4_TO_CONTROLLER_LOG:GEN4_DEBUG_INT_LOG_PIC24FJ128GL306 BitSetInfo: Address = 470, Mask = 4000, SetVal = 4000, Type = FileRegs
66000 1741394755654 GEN4_TO_CONTROLLER_LOG:GEN4_DEBUG_INT_LOG_PIC24FJ128GL306 BitSetInfo: Values:
66000 1741394755654 GEN4_TO_CONTROLLER_LOG:GEN4_DEBUG_INT_LOG_PIC24FJ128GL306 BitSetInfo: Address = 47c, Mask = 4000, SetVal = 4000, Type = FileRegs
66000 1741394755654 GEN4_TO_CONTROLLER_LOG:GEN4_DEBUG_INT_LOG_PIC24FJ128GL306 BitSetInfo: Values:
66000 1741394755654 GEN4_TO_CONTROLLER_LOG:GEN4_DEBUG_INT_LOG_PIC24FJ128GL306 BitSetInfo: Address = 488, Mask = 4000, SetVal = 4000, Type = FileRegs
66000 1741394755654 GEN4_TO_CONTROLLER_LOG:GEN4_DEBUG_INT_LOG_PIC24FJ128GL306 BitSetInfo: Values:
66000 1741394755654 GEN4_TO_CONTROLLER_LOG:GEN4_DEBUG_INT_LOG_PIC24FJ128GL306 BitSetInfo: Address = 49a, Mask = 4000, SetVal = 4000, Type = FileRegs
66000 1741394755654 GEN4_TO_CONTROLLER_LOG:GEN4_DEBUG_INT_LOG_PIC24FJ128GL306 BitSetInfo: Values:
66000 1741394755654 GEN4_TO_CONTROLLER_LOG:GEN4_DEBUG_INT_LOG_PIC24FJ128GL306 BitSetInfo: Address = 4aa, Mask = 4000, SetVal = 4000, Type = FileRegs
66000 1741394755654 GEN4_TO_CONTROLLER_LOG:GEN4_DEBUG_INT_LOG_PIC24FJ128GL306 BitSetInfo: Values:
66000 1741394755654 GEN4_TO_CONTROLLER_LOG:GEN4_DEBUG_INT_LOG_PIC24FJ128GL306 BitSetInfo: Address = 4c4, Mask = 4000, SetVal = 4000, Type = FileRegs
66000 1741394755654 GEN4_TO_CONTROLLER_LOG:GEN4_DEBUG_INT_LOG_PIC24FJ128GL306 BitSetInfo: Values:
66000 1741394755654 GEN4_TO_CONTROLLER_LOG:GEN4_DEBUG_INT_LOG_PIC24FJ128GL306 BitSetInfo: Address = 540, Mask = 4000, SetVal = 4000, Type = FileRegs
66000 1741394755654 GEN4_TO_CONTROLLER_LOG:GEN4_DEBUG_INT_LOG_PIC24FJ128GL306 BitSetInfo: Values:
66000 1741394755654 GEN4_TO_CONTROLLER_LOG:GEN4_DEBUG_INT_LOG_PIC24FJ128GL306 BitSetInfo: Address = 65c, Mask = 4000, SetVal = 4000, Type = FileRegs
66000 1741394755654 GEN4_TO_CONTROLLER_LOG:GEN4_DEBUG_INT_LOG_PIC24FJ128GL306 BitSetInfo: Values:
66000 1741394755654 GEN4_TO_CONTROLLER_LOG:GEN4_DEBUG_INT_LOG_PIC24FJ128GL306 BitSetInfo: Address = 734, Mask = 4000, SetVal = 4000, Type = FileRegs
66000 1741394755654 GEN4_TO_CONTROLLER_LOG:GEN4_DEBUG_INT_LOG_PIC24FJ128GL306 BitSetInfo: Values:
66000 1741394755654 GEN4_TO_CONTROLLER_LOG:GEN4_DEBUG_INT_LOG_PIC24FJ128GL306 BitSetInfo: Address = fd0036, Mask = 1, SetVal = 1, Type = Emulation
66000 1741394755654 GEN4_TO_CONTROLLER_LOG:GEN4_DEBUG_INT_LOG_PIC24FJ128GL306 Payload End
66000 1741394755654 XXXX 1741394755654, Thread 66000: XXXX 1741394755654, Entering Thread 66000: Commands::runScriptWithUpload, script name = ReadRAM  
66000 1741394755654 XXXX 1741394755654, Thread 66000: XXXX 1741394755654, Entering Thread 66000: ToolCommUsb::readTransfer, sideData is 0x28 bytes long, transferDataLength is 0x2 bytes long  
66000 1741394755657 XXXX 1741394755657, Thread 66000: XXXX 1741394755657, Exiting Thread 66000: ToolCommUsb::readTransfer,  cr.status = 0x0  
66000 1741394755657 XXXX 1741394755657, Thread 66000: XXXX 1741394755657, Exiting Thread 66000: Commands::runScriptWithUpload  
66000 1741394755657 XXXX 1741394755657, Thread 66000: XXXX 1741394755657, Entering Thread 66000: Commands::runScriptWithDownload, script name = WriteRAM  
66000 1741394755661 XXXX 1741394755661, Thread 66000: XXXX 1741394755661, Exiting Thread 66000: Commands::runScriptWithDownload(WriteRAM)  
66000 1741394755661 XXXX 1741394755661, Thread 66000: XXXX 1741394755661, Entering Thread 66000: Commands::runScriptWithUpload, script name = ReadRAM  
66000 1741394755661 XXXX 1741394755661, Thread 66000: XXXX 1741394755661, Entering Thread 66000: ToolCommUsb::readTransfer, sideData is 0x28 bytes long, transferDataLength is 0x2 bytes long  
66000 1741394755664 XXXX 1741394755664, Thread 66000: XXXX 1741394755664, Exiting Thread 66000: ToolCommUsb::readTransfer,  cr.status = 0x0  
66000 1741394755664 XXXX 1741394755664, Thread 66000: XXXX 1741394755664, Exiting Thread 66000: Commands::runScriptWithUpload  
66000 1741394755664 XXXX 1741394755664, Thread 66000: XXXX 1741394755664, Entering Thread 66000: Commands::runScriptWithDownload, script name = WriteRAM  
66000 1741394755666 XXXX 1741394755666, Thread 66000: XXXX 1741394755666, Exiting Thread 66000: Commands::runScriptWithDownload(WriteRAM)  
66000 1741394755666 XXXX 1741394755666, Thread 66000: XXXX 1741394755666, Entering Thread 66000: Commands::runScriptWithUpload, script name = ReadRAM  
66000 1741394755666 XXXX 1741394755666, Thread 66000: XXXX 1741394755666, Entering Thread 66000: ToolCommUsb::readTransfer, sideData is 0x28 bytes long, transferDataLength is 0x2 bytes long  
66000 1741394755670 XXXX 1741394755670, Thread 66000: XXXX 1741394755670, Exiting Thread 66000: ToolCommUsb::readTransfer,  cr.status = 0x0  
66000 1741394755670 XXXX 1741394755670, Thread 66000: XXXX 1741394755670, Exiting Thread 66000: Commands::runScriptWithUpload  
66000 1741394755670 XXXX 1741394755670, Thread 66000: XXXX 1741394755670, Entering Thread 66000: Commands::runScriptWithDownload, script name = WriteRAM  
66000 1741394755673 XXXX 1741394755673, Thread 66000: XXXX 1741394755673, Exiting Thread 66000: Commands::runScriptWithDownload(WriteRAM)  
66000 1741394755673 XXXX 1741394755673, Thread 66000: XXXX 1741394755673, Entering Thread 66000: Commands::runScriptWithUpload, script name = ReadRAM  
66000 1741394755673 XXXX 1741394755673, Thread 66000: XXXX 1741394755673, Entering Thread 66000: ToolCommUsb::readTransfer, sideData is 0x28 bytes long, transferDataLength is 0x2 bytes long  
66000 1741394755676 XXXX 1741394755676, Thread 66000: XXXX 1741394755676, Exiting Thread 66000: ToolCommUsb::readTransfer,  cr.status = 0x0  
66000 1741394755676 XXXX 1741394755676, Thread 66000: XXXX 1741394755676, Exiting Thread 66000: Commands::runScriptWithUpload  
66000 1741394755676 XXXX 1741394755676, Thread 66000: XXXX 1741394755676, Entering Thread 66000: Commands::runScriptWithDownload, script name = WriteRAM  
66000 1741394755679 XXXX 1741394755679, Thread 66000: XXXX 1741394755679, Exiting Thread 66000: Commands::runScriptWithDownload(WriteRAM)  
66000 1741394755679 XXXX 1741394755679, Thread 66000: XXXX 1741394755679, Entering Thread 66000: Commands::runScriptWithUpload, script name = ReadRAM  
66000 1741394755679 XXXX 1741394755679, Thread 66000: XXXX 1741394755679, Entering Thread 66000: ToolCommUsb::readTransfer, sideData is 0x28 bytes long, transferDataLength is 0x2 bytes long  
66000 1741394755682 XXXX 1741394755682, Thread 66000: XXXX 1741394755682, Exiting Thread 66000: ToolCommUsb::readTransfer,  cr.status = 0x0  
66000 1741394755682 XXXX 1741394755682, Thread 66000: XXXX 1741394755682, Exiting Thread 66000: Commands::runScriptWithUpload  
66000 1741394755682 XXXX 1741394755682, Thread 66000: XXXX 1741394755682, Entering Thread 66000: Commands::runScriptWithDownload, script name = WriteRAM  
66000 1741394755685 XXXX 1741394755685, Thread 66000: XXXX 1741394755685, Exiting Thread 66000: Commands::runScriptWithDownload(WriteRAM)  
66000 1741394755685 XXXX 1741394755685, Thread 66000: XXXX 1741394755685, Entering Thread 66000: Commands::runScriptWithUpload, script name = ReadRAM  
66000 1741394755685 XXXX 1741394755685, Thread 66000: XXXX 1741394755685, Entering Thread 66000: ToolCommUsb::readTransfer, sideData is 0x28 bytes long, transferDataLength is 0x2 bytes long  
66000 1741394755688 XXXX 1741394755688, Thread 66000: XXXX 1741394755688, Exiting Thread 66000: ToolCommUsb::readTransfer,  cr.status = 0x0  
66000 1741394755688 XXXX 1741394755688, Thread 66000: XXXX 1741394755688, Exiting Thread 66000: Commands::runScriptWithUpload  
66000 1741394755688 XXXX 1741394755688, Thread 66000: XXXX 1741394755688, Entering Thread 66000: Commands::runScriptWithDownload, script name = WriteRAM  
66000 1741394755691 XXXX 1741394755691, Thread 66000: XXXX 1741394755691, Exiting Thread 66000: Commands::runScriptWithDownload(WriteRAM)  
66000 1741394755691 XXXX 1741394755691, Thread 66000: XXXX 1741394755691, Entering Thread 66000: Commands::runScriptWithUpload, script name = ReadRAM  
66000 1741394755691 XXXX 1741394755691, Thread 66000: XXXX 1741394755691, Entering Thread 66000: ToolCommUsb::readTransfer, sideData is 0x28 bytes long, transferDataLength is 0x2 bytes long  
66000 1741394755693 XXXX 1741394755693, Thread 66000: XXXX 1741394755693, Exiting Thread 66000: ToolCommUsb::readTransfer,  cr.status = 0x0  
66000 1741394755693 XXXX 1741394755693, Thread 66000: XXXX 1741394755693, Exiting Thread 66000: Commands::runScriptWithUpload  
66000 1741394755694 XXXX 1741394755694, Thread 66000: XXXX 1741394755693, Entering Thread 66000: Commands::runScriptWithDownload, script name = WriteRAM  
66000 1741394755696 XXXX 1741394755696, Thread 66000: XXXX 1741394755696, Exiting Thread 66000: Commands::runScriptWithDownload(WriteRAM)  
66000 1741394755696 XXXX 1741394755696, Thread 66000: XXXX 1741394755696, Entering Thread 66000: Commands::runScriptWithUpload, script name = ReadRAM  
66000 1741394755696 XXXX 1741394755696, Thread 66000: XXXX 1741394755696, Entering Thread 66000: ToolCommUsb::readTransfer, sideData is 0x28 bytes long, transferDataLength is 0x2 bytes long  
66000 1741394755700 XXXX 1741394755700, Thread 66000: XXXX 1741394755700, Exiting Thread 66000: ToolCommUsb::readTransfer,  cr.status = 0x0  
66000 1741394755700 XXXX 1741394755700, Thread 66000: XXXX 1741394755700, Exiting Thread 66000: Commands::runScriptWithUpload  
66000 1741394755700 XXXX 1741394755700, Thread 66000: XXXX 1741394755700, Entering Thread 66000: Commands::runScriptWithDownload, script name = WriteRAM  
66000 1741394755703 XXXX 1741394755703, Thread 66000: XXXX 1741394755703, Exiting Thread 66000: Commands::runScriptWithDownload(WriteRAM)  
66000 1741394755703 XXXX 1741394755703, Thread 66000: XXXX 1741394755703, Entering Thread 66000: Commands::runScriptWithUpload, script name = ReadRAM  
66000 1741394755703 XXXX 1741394755703, Thread 66000: XXXX 1741394755703, Entering Thread 66000: ToolCommUsb::readTransfer, sideData is 0x28 bytes long, transferDataLength is 0x2 bytes long  
66000 1741394755706 XXXX 1741394755706, Thread 66000: XXXX 1741394755706, Exiting Thread 66000: ToolCommUsb::readTransfer,  cr.status = 0x0  
66000 1741394755706 XXXX 1741394755706, Thread 66000: XXXX 1741394755706, Exiting Thread 66000: Commands::runScriptWithUpload  
66000 1741394755706 XXXX 1741394755706, Thread 66000: XXXX 1741394755706, Entering Thread 66000: Commands::runScriptWithDownload, script name = WriteRAM  
66000 1741394755708 XXXX 1741394755708, Thread 66000: XXXX 1741394755708, Exiting Thread 66000: Commands::runScriptWithDownload(WriteRAM)  
66000 1741394755709 XXXX 1741394755709, Thread 66000: XXXX 1741394755709, Entering Thread 66000: Commands::runScriptWithUpload, script name = ReadRAM  
66000 1741394755709 XXXX 1741394755709, Thread 66000: XXXX 1741394755709, Entering Thread 66000: ToolCommUsb::readTransfer, sideData is 0x28 bytes long, transferDataLength is 0x2 bytes long  
66000 1741394755711 XXXX 1741394755711, Thread 66000: XXXX 1741394755711, Exiting Thread 66000: ToolCommUsb::readTransfer,  cr.status = 0x0  
66000 1741394755711 XXXX 1741394755711, Thread 66000: XXXX 1741394755711, Exiting Thread 66000: Commands::runScriptWithUpload  
66000 1741394755711 XXXX 1741394755711, Thread 66000: XXXX 1741394755711, Entering Thread 66000: Commands::runScriptWithDownload, script name = WriteRAM  
66000 1741394755714 XXXX 1741394755714, Thread 66000: XXXX 1741394755714, Exiting Thread 66000: Commands::runScriptWithDownload(WriteRAM)  
66000 1741394755714 XXXX 1741394755714, Thread 66000: XXXX 1741394755714, Entering Thread 66000: Commands::runScriptWithUpload, script name = ReadRAM  
66000 1741394755714 XXXX 1741394755714, Thread 66000: XXXX 1741394755714, Entering Thread 66000: ToolCommUsb::readTransfer, sideData is 0x28 bytes long, transferDataLength is 0x2 bytes long  
66000 1741394755717 XXXX 1741394755717, Thread 66000: XXXX 1741394755717, Exiting Thread 66000: ToolCommUsb::readTransfer,  cr.status = 0x0  
66000 1741394755717 XXXX 1741394755717, Thread 66000: XXXX 1741394755717, Exiting Thread 66000: Commands::runScriptWithUpload  
66000 1741394755717 XXXX 1741394755717, Thread 66000: XXXX 1741394755717, Entering Thread 66000: Commands::runScriptWithDownload, script name = WriteRAM  
66000 1741394755720 XXXX 1741394755720, Thread 66000: XXXX 1741394755720, Exiting Thread 66000: Commands::runScriptWithDownload(WriteRAM)  
66000 1741394755720 XXXX 1741394755720, Thread 66000: XXXX 1741394755720, Entering Thread 66000: Commands::runScriptWithUpload, script name = ReadRAM  
66000 1741394755720 XXXX 1741394755720, Thread 66000: XXXX 1741394755720, Entering Thread 66000: ToolCommUsb::readTransfer, sideData is 0x28 bytes long, transferDataLength is 0x2 bytes long  
66000 1741394755723 XXXX 1741394755723, Thread 66000: XXXX 1741394755723, Exiting Thread 66000: ToolCommUsb::readTransfer,  cr.status = 0x0  
66000 1741394755723 XXXX 1741394755723, Thread 66000: XXXX 1741394755723, Exiting Thread 66000: Commands::runScriptWithUpload  
66000 1741394755723 XXXX 1741394755723, Thread 66000: XXXX 1741394755723, Entering Thread 66000: Commands::runScriptWithDownload, script name = WriteRAM  
66000 1741394755727 XXXX 1741394755727, Thread 66000: XXXX 1741394755727, Exiting Thread 66000: Commands::runScriptWithDownload(WriteRAM)  
66000 1741394755727 XXXX 1741394755727, Thread 66000: XXXX 1741394755727, Entering Thread 66000: Commands::runScriptWithUpload, script name = ReadRAM  
66000 1741394755727 XXXX 1741394755727, Thread 66000: XXXX 1741394755727, Entering Thread 66000: ToolCommUsb::readTransfer, sideData is 0x28 bytes long, transferDataLength is 0x2 bytes long  
66000 1741394755729 XXXX 1741394755729, Thread 66000: XXXX 1741394755729, Exiting Thread 66000: ToolCommUsb::readTransfer,  cr.status = 0x0  
66000 1741394755729 XXXX 1741394755729, Thread 66000: XXXX 1741394755729, Exiting Thread 66000: Commands::runScriptWithUpload  
66000 1741394755729 XXXX 1741394755729, Thread 66000: XXXX 1741394755729, Entering Thread 66000: Commands::runScriptWithDownload, script name = WriteRAM  
66000 1741394755732 XXXX 1741394755732, Thread 66000: XXXX 1741394755732, Exiting Thread 66000: Commands::runScriptWithDownload(WriteRAM)  
66000 1741394755732 XXXX 1741394755732, Thread 66000: XXXX 1741394755732, Entering Thread 66000: Commands::runScriptWithUpload, script name = ReadRAM  
66000 1741394755732 XXXX 1741394755732, Thread 66000: XXXX 1741394755732, Entering Thread 66000: ToolCommUsb::readTransfer, sideData is 0x28 bytes long, transferDataLength is 0x2 bytes long  
66000 1741394755734 XXXX 1741394755734, Thread 66000: XXXX 1741394755734, Exiting Thread 66000: ToolCommUsb::readTransfer,  cr.status = 0x0  
66000 1741394755734 XXXX 1741394755734, Thread 66000: XXXX 1741394755734, Exiting Thread 66000: Commands::runScriptWithUpload  
66000 1741394755734 XXXX 1741394755734, Thread 66000: XXXX 1741394755734, Entering Thread 66000: Commands::runScriptWithDownload, script name = WriteRAM  
66000 1741394755737 XXXX 1741394755737, Thread 66000: XXXX 1741394755737, Exiting Thread 66000: Commands::runScriptWithDownload(WriteRAM)  
66000 1741394755737 XXXX 1741394755737, Thread 66000: XXXX 1741394755737, Entering Thread 66000: Commands::runScriptWithUpload, script name = ReadRAM  
66000 1741394755737 XXXX 1741394755737, Thread 66000: XXXX 1741394755737, Entering Thread 66000: ToolCommUsb::readTransfer, sideData is 0x28 bytes long, transferDataLength is 0x2 bytes long  
66000 1741394755741 XXXX 1741394755741, Thread 66000: XXXX 1741394755741, Exiting Thread 66000: ToolCommUsb::readTransfer,  cr.status = 0x0  
66000 1741394755741 XXXX 1741394755741, Thread 66000: XXXX 1741394755741, Exiting Thread 66000: Commands::runScriptWithUpload  
66000 1741394755741 XXXX 1741394755741, Thread 66000: XXXX 1741394755741, Entering Thread 66000: Commands::runScriptWithDownload, script name = WriteRAM  
66000 1741394755744 XXXX 1741394755744, Thread 66000: XXXX 1741394755744, Exiting Thread 66000: Commands::runScriptWithDownload(WriteRAM)  
66000 1741394755744 XXXX 1741394755744, Thread 66000: XXXX 1741394755744, Entering Thread 66000: Commands::runScriptWithUpload, script name = ReadRAM  
66000 1741394755744 XXXX 1741394755744, Thread 66000: XXXX 1741394755744, Entering Thread 66000: ToolCommUsb::readTransfer, sideData is 0x28 bytes long, transferDataLength is 0x2 bytes long  
66000 1741394755747 XXXX 1741394755747, Thread 66000: XXXX 1741394755747, Exiting Thread 66000: ToolCommUsb::readTransfer,  cr.status = 0x0  
66000 1741394755747 XXXX 1741394755747, Thread 66000: XXXX 1741394755747, Exiting Thread 66000: Commands::runScriptWithUpload  
66000 1741394755747 XXXX 1741394755747, Thread 66000: XXXX 1741394755747, Entering Thread 66000: Commands::runScriptWithDownload, script name = WriteRAM  
66000 1741394755750 XXXX 1741394755750, Thread 66000: XXXX 1741394755750, Exiting Thread 66000: Commands::runScriptWithDownload(WriteRAM)  
66000 1741394755750 XXXX 1741394755750, Thread 66000: XXXX 1741394755750, Entering Thread 66000: Commands::runScriptWithUpload, script name = ReadRAM  
66000 1741394755750 XXXX 1741394755750, Thread 66000: XXXX 1741394755750, Entering Thread 66000: ToolCommUsb::readTransfer, sideData is 0x28 bytes long, transferDataLength is 0x2 bytes long  
66000 1741394755753 XXXX 1741394755753, Thread 66000: XXXX 1741394755753, Exiting Thread 66000: ToolCommUsb::readTransfer,  cr.status = 0x0  
66000 1741394755753 XXXX 1741394755753, Thread 66000: XXXX 1741394755753, Exiting Thread 66000: Commands::runScriptWithUpload  
66000 1741394755753 XXXX 1741394755753, Thread 66000: XXXX 1741394755753, Entering Thread 66000: Commands::runScriptWithDownload, script name = WriteRAM  
66000 1741394755756 XXXX 1741394755756, Thread 66000: XXXX 1741394755756, Exiting Thread 66000: Commands::runScriptWithDownload(WriteRAM)  
66000 1741394755756 XXXX 1741394755756, Thread 66000: XXXX 1741394755756, Entering Thread 66000: Commands::runScriptWithUpload, script name = ReadRAM  
66000 1741394755756 XXXX 1741394755756, Thread 66000: XXXX 1741394755756, Entering Thread 66000: ToolCommUsb::readTransfer, sideData is 0x28 bytes long, transferDataLength is 0x2 bytes long  
66000 1741394755759 XXXX 1741394755759, Thread 66000: XXXX 1741394755759, Exiting Thread 66000: ToolCommUsb::readTransfer,  cr.status = 0x0  
66000 1741394755759 XXXX 1741394755759, Thread 66000: XXXX 1741394755759, Exiting Thread 66000: Commands::runScriptWithUpload  
66000 1741394755759 XXXX 1741394755759, Thread 66000: XXXX 1741394755759, Entering Thread 66000: Commands::runScriptWithDownload, script name = WriteRAM  
66000 1741394755762 XXXX 1741394755762, Thread 66000: XXXX 1741394755762, Exiting Thread 66000: Commands::runScriptWithDownload(WriteRAM)  
66000 1741394755762 XXXX 1741394755762, Thread 66000: XXXX 1741394755762, Entering Thread 66000: Commands::runScriptWithUpload, script name = ReadRAM  
66000 1741394755762 XXXX 1741394755762, Thread 66000: XXXX 1741394755762, Entering Thread 66000: ToolCommUsb::readTransfer, sideData is 0x28 bytes long, transferDataLength is 0x2 bytes long  
66000 1741394755765 XXXX 1741394755765, Thread 66000: XXXX 1741394755765, Exiting Thread 66000: ToolCommUsb::readTransfer,  cr.status = 0x0  
66000 1741394755765 XXXX 1741394755765, Thread 66000: XXXX 1741394755765, Exiting Thread 66000: Commands::runScriptWithUpload  
66000 1741394755765 XXXX 1741394755765, Thread 66000: XXXX 1741394755765, Entering Thread 66000: Commands::runScriptWithDownload, script name = WriteRAM  
66000 1741394755768 XXXX 1741394755768, Thread 66000: XXXX 1741394755768, Exiting Thread 66000: Commands::runScriptWithDownload(WriteRAM)  
66000 1741394755768 XXXX 1741394755768, Thread 66000: XXXX 1741394755768, Entering Thread 66000: Commands::runScriptWithUpload, script name = ReadRAM  
66000 1741394755768 XXXX 1741394755768, Thread 66000: XXXX 1741394755768, Entering Thread 66000: ToolCommUsb::readTransfer, sideData is 0x28 bytes long, transferDataLength is 0x2 bytes long  
66000 1741394755770 XXXX 1741394755770, Thread 66000: XXXX 1741394755770, Exiting Thread 66000: ToolCommUsb::readTransfer,  cr.status = 0x0  
66000 1741394755770 XXXX 1741394755770, Thread 66000: XXXX 1741394755770, Exiting Thread 66000: Commands::runScriptWithUpload  
66000 1741394755770 XXXX 1741394755770, Thread 66000: XXXX 1741394755770, Entering Thread 66000: Commands::runScriptWithDownload, script name = WriteRAM  
66000 1741394755773 XXXX 1741394755773, Thread 66000: XXXX 1741394755773, Exiting Thread 66000: Commands::runScriptWithDownload(WriteRAM)  
66000 1741394755773 XXXX 1741394755773, Thread 66000: XXXX 1741394755773, Entering Thread 66000: Commands::runScriptWithUpload, script name = ReadRAM  
66000 1741394755773 XXXX 1741394755773, Thread 66000: XXXX 1741394755773, Entering Thread 66000: ToolCommUsb::readTransfer, sideData is 0x28 bytes long, transferDataLength is 0x2 bytes long  
66000 1741394755776 XXXX 1741394755776, Thread 66000: XXXX 1741394755776, Exiting Thread 66000: ToolCommUsb::readTransfer,  cr.status = 0x0  
66000 1741394755776 XXXX 1741394755776, Thread 66000: XXXX 1741394755776, Exiting Thread 66000: Commands::runScriptWithUpload  
66000 1741394755776 XXXX 1741394755776, Thread 66000: XXXX 1741394755776, Entering Thread 66000: Commands::runScriptWithDownload, script name = WriteRAM  
66000 1741394755779 XXXX 1741394755779, Thread 66000: XXXX 1741394755779, Exiting Thread 66000: Commands::runScriptWithDownload(WriteRAM)  
66000 1741394755779 XXXX 1741394755779, Thread 66000: XXXX 1741394755779, Entering Thread 66000: Commands::runScriptWithUpload, script name = ReadRAM  
66000 1741394755779 XXXX 1741394755779, Thread 66000: XXXX 1741394755779, Entering Thread 66000: ToolCommUsb::readTransfer, sideData is 0x28 bytes long, transferDataLength is 0x2 bytes long  
66000 1741394755782 XXXX 1741394755782, Thread 66000: XXXX 1741394755782, Exiting Thread 66000: ToolCommUsb::readTransfer,  cr.status = 0x0  
66000 1741394755782 XXXX 1741394755782, Thread 66000: XXXX 1741394755782, Exiting Thread 66000: Commands::runScriptWithUpload  
66000 1741394755782 XXXX 1741394755782, Thread 66000: XXXX 1741394755782, Entering Thread 66000: Commands::runScriptWithDownload, script name = WriteRAM  
66000 1741394755786 XXXX 1741394755786, Thread 66000: XXXX 1741394755786, Exiting Thread 66000: Commands::runScriptWithDownload(WriteRAM)  
66000 1741394755786 XXXX 1741394755786, Thread 66000: XXXX 1741394755786, Entering Thread 66000: Commands::runScriptWithUpload, script name = ReadRAM  
66000 1741394755786 XXXX 1741394755786, Thread 66000: XXXX 1741394755786, Entering Thread 66000: ToolCommUsb::readTransfer, sideData is 0x28 bytes long, transferDataLength is 0x2 bytes long  
66000 1741394755788 XXXX 1741394755788, Thread 66000: XXXX 1741394755788, Exiting Thread 66000: ToolCommUsb::readTransfer,  cr.status = 0x0  
66000 1741394755788 XXXX 1741394755788, Thread 66000: XXXX 1741394755788, Exiting Thread 66000: Commands::runScriptWithUpload  
66000 1741394755788 XXXX 1741394755788, Thread 66000: XXXX 1741394755788, Entering Thread 66000: Commands::runScriptWithDownload, script name = WriteRAM  
66000 1741394755791 XXXX 1741394755791, Thread 66000: XXXX 1741394755791, Exiting Thread 66000: Commands::runScriptWithDownload(WriteRAM)  
66000 1741394755791 XXXX 1741394755791, Thread 66000: XXXX 1741394755791, Entering Thread 66000: Commands::runScriptWithUpload, script name = ReadRAM  
66000 1741394755791 XXXX 1741394755791, Thread 66000: XXXX 1741394755791, Entering Thread 66000: ToolCommUsb::readTransfer, sideData is 0x28 bytes long, transferDataLength is 0x2 bytes long  
66000 1741394755794 XXXX 1741394755794, Thread 66000: XXXX 1741394755794, Exiting Thread 66000: ToolCommUsb::readTransfer,  cr.status = 0x0  
66000 1741394755794 XXXX 1741394755794, Thread 66000: XXXX 1741394755794, Exiting Thread 66000: Commands::runScriptWithUpload  
66000 1741394755794 XXXX 1741394755794, Thread 66000: XXXX 1741394755794, Entering Thread 66000: Commands::runScriptWithDownload, script name = WriteRAM  
66000 1741394755797 XXXX 1741394755797, Thread 66000: XXXX 1741394755797, Exiting Thread 66000: Commands::runScriptWithDownload(WriteRAM)  
66000 1741394755797 XXXX 1741394755797, Thread 66000: XXXX 1741394755797, Entering Thread 66000: Commands::runScriptWithUpload, script name = ReadRAM  
66000 1741394755797 XXXX 1741394755797, Thread 66000: XXXX 1741394755797, Entering Thread 66000: ToolCommUsb::readTransfer, sideData is 0x28 bytes long, transferDataLength is 0x2 bytes long  
66000 1741394755801 XXXX 1741394755801, Thread 66000: XXXX 1741394755801, Exiting Thread 66000: ToolCommUsb::readTransfer,  cr.status = 0x0  
66000 1741394755801 XXXX 1741394755801, Thread 66000: XXXX 1741394755801, Exiting Thread 66000: Commands::runScriptWithUpload  
66000 1741394755801 XXXX 1741394755801, Thread 66000: XXXX 1741394755801, Entering Thread 66000: Commands::runScriptWithDownload, script name = WriteRAM  
66000 1741394755803 XXXX 1741394755803, Thread 66000: XXXX 1741394755803, Exiting Thread 66000: Commands::runScriptWithDownload(WriteRAM)  
66000 1741394755803 XXXX 1741394755803, Thread 66000: XXXX 1741394755803, Entering Thread 66000: Commands::runScriptWithUpload, script name = ReadRAM  
66000 1741394755803 XXXX 1741394755803, Thread 66000: XXXX 1741394755803, Entering Thread 66000: ToolCommUsb::readTransfer, sideData is 0x28 bytes long, transferDataLength is 0x2 bytes long  
66000 1741394755806 XXXX 1741394755806, Thread 66000: XXXX 1741394755806, Exiting Thread 66000: ToolCommUsb::readTransfer,  cr.status = 0x0  
66000 1741394755806 XXXX 1741394755806, Thread 66000: XXXX 1741394755806, Exiting Thread 66000: Commands::runScriptWithUpload  
66000 1741394755806 XXXX 1741394755806, Thread 66000: XXXX 1741394755806, Entering Thread 66000: Commands::runScriptWithDownload, script name = WriteRAM  
66000 1741394755809 XXXX 1741394755809, Thread 66000: XXXX 1741394755809, Exiting Thread 66000: Commands::runScriptWithDownload(WriteRAM)  
66000 1741394755809 XXXX 1741394755809, Thread 66000: XXXX 1741394755809, Entering Thread 66000: Commands::runScriptWithUpload, script name = ReadRAM  
66000 1741394755809 XXXX 1741394755809, Thread 66000: XXXX 1741394755809, Entering Thread 66000: ToolCommUsb::readTransfer, sideData is 0x28 bytes long, transferDataLength is 0x2 bytes long  
66000 1741394755812 XXXX 1741394755812, Thread 66000: XXXX 1741394755812, Exiting Thread 66000: ToolCommUsb::readTransfer,  cr.status = 0x0  
66000 1741394755812 XXXX 1741394755812, Thread 66000: XXXX 1741394755812, Exiting Thread 66000: Commands::runScriptWithUpload  
66000 1741394755812 XXXX 1741394755812, Thread 66000: XXXX 1741394755812, Entering Thread 66000: Commands::runScriptWithDownload, script name = WriteRAM  
66000 1741394755815 XXXX 1741394755815, Thread 66000: XXXX 1741394755815, Exiting Thread 66000: Commands::runScriptWithDownload(WriteRAM)  
66000 1741394755815 XXXX 1741394755815, Thread 66000: XXXX 1741394755815, Entering Thread 66000: Commands::runScriptWithUpload, script name = ReadRAM  
66000 1741394755815 XXXX 1741394755815, Thread 66000: XXXX 1741394755815, Entering Thread 66000: ToolCommUsb::readTransfer, sideData is 0x28 bytes long, transferDataLength is 0x2 bytes long  
66000 1741394755819 XXXX 1741394755819, Thread 66000: XXXX 1741394755819, Exiting Thread 66000: ToolCommUsb::readTransfer,  cr.status = 0x0  
66000 1741394755819 XXXX 1741394755819, Thread 66000: XXXX 1741394755819, Exiting Thread 66000: Commands::runScriptWithUpload  
66000 1741394755819 XXXX 1741394755819, Thread 66000: XXXX 1741394755819, Entering Thread 66000: Commands::runScriptWithDownload, script name = WriteRAM  
66000 1741394755822 XXXX 1741394755822, Thread 66000: XXXX 1741394755822, Exiting Thread 66000: Commands::runScriptWithDownload(WriteRAM)  
66000 1741394755822 XXXX 1741394755822, Thread 66000: XXXX 1741394755822, Entering Thread 66000: Commands::runScriptWithUpload, script name = ReadRAM  
66000 1741394755822 XXXX 1741394755822, Thread 66000: XXXX 1741394755822, Entering Thread 66000: ToolCommUsb::readTransfer, sideData is 0x28 bytes long, transferDataLength is 0x2 bytes long  
66000 1741394755824 XXXX 1741394755824, Thread 66000: XXXX 1741394755824, Exiting Thread 66000: ToolCommUsb::readTransfer,  cr.status = 0x0  
66000 1741394755824 XXXX 1741394755824, Thread 66000: XXXX 1741394755824, Exiting Thread 66000: Commands::runScriptWithUpload  
66000 1741394755824 XXXX 1741394755824, Thread 66000: XXXX 1741394755824, Entering Thread 66000: Commands::runScriptWithDownload, script name = WriteRAM  
66000 1741394755827 XXXX 1741394755827, Thread 66000: XXXX 1741394755827, Exiting Thread 66000: Commands::runScriptWithDownload(WriteRAM)  
66000 1741394755827 XXXX 1741394755827, Thread 66000: XXXX 1741394755827, Entering Thread 66000: Commands::runScriptWithUpload, script name = ReadRAM  
66000 1741394755827 XXXX 1741394755827, Thread 66000: XXXX 1741394755827, Entering Thread 66000: ToolCommUsb::readTransfer, sideData is 0x28 bytes long, transferDataLength is 0x2 bytes long  
66000 1741394755830 XXXX 1741394755830, Thread 66000: XXXX 1741394755830, Exiting Thread 66000: ToolCommUsb::readTransfer,  cr.status = 0x0  
66000 1741394755830 XXXX 1741394755830, Thread 66000: XXXX 1741394755830, Exiting Thread 66000: Commands::runScriptWithUpload  
66000 1741394755830 XXXX 1741394755830, Thread 66000: XXXX 1741394755830, Entering Thread 66000: Commands::runScriptWithDownload, script name = WriteRAM  
66000 1741394755834 XXXX 1741394755834, Thread 66000: XXXX 1741394755834, Exiting Thread 66000: Commands::runScriptWithDownload(WriteRAM)  
66000 1741394755834 XXXX 1741394755834, Thread 66000: XXXX 1741394755834, Entering Thread 66000: Commands::runScriptWithUpload, script name = ReadRAM  
66000 1741394755834 XXXX 1741394755834, Thread 66000: XXXX 1741394755834, Entering Thread 66000: ToolCommUsb::readTransfer, sideData is 0x28 bytes long, transferDataLength is 0x2 bytes long  
66000 1741394755837 XXXX 1741394755837, Thread 66000: XXXX 1741394755837, Exiting Thread 66000: ToolCommUsb::readTransfer,  cr.status = 0x0  
66000 1741394755837 XXXX 1741394755837, Thread 66000: XXXX 1741394755837, Exiting Thread 66000: Commands::runScriptWithUpload  
66000 1741394755837 XXXX 1741394755837, Thread 66000: XXXX 1741394755837, Entering Thread 66000: Commands::runScriptWithDownload, script name = WriteRAM  
66000 1741394755839 XXXX 1741394755839, Thread 66000: XXXX 1741394755839, Exiting Thread 66000: Commands::runScriptWithDownload(WriteRAM)  
66000 1741394755839 XXXX 1741394755839, Thread 66000: XXXX 1741394755839, Entering Thread 66000: Commands::runScriptWithUpload, script name = ReadRAM  
66000 1741394755839 XXXX 1741394755839, Thread 66000: XXXX 1741394755839, Entering Thread 66000: ToolCommUsb::readTransfer, sideData is 0x28 bytes long, transferDataLength is 0x2 bytes long  
66000 1741394755841 XXXX 1741394755841, Thread 66000: XXXX 1741394755841, Exiting Thread 66000: ToolCommUsb::readTransfer,  cr.status = 0x0  
66000 1741394755841 XXXX 1741394755841, Thread 66000: XXXX 1741394755841, Exiting Thread 66000: Commands::runScriptWithUpload  
66000 1741394755841 XXXX 1741394755841, Thread 66000: XXXX 1741394755841, Entering Thread 66000: Commands::runScriptWithDownload, script name = WriteRAM  
66000 1741394755845 XXXX 1741394755845, Thread 66000: XXXX 1741394755845, Exiting Thread 66000: Commands::runScriptWithDownload(WriteRAM)  
66000 1741394755845 XXXX 1741394755845, Thread 66000: XXXX 1741394755845, Entering Thread 66000: Commands::runScriptWithUpload, script name = ReadRAM  
66000 1741394755845 XXXX 1741394755845, Thread 66000: XXXX 1741394755845, Entering Thread 66000: ToolCommUsb::readTransfer, sideData is 0x28 bytes long, transferDataLength is 0x2 bytes long  
66000 1741394755847 XXXX 1741394755847, Thread 66000: XXXX 1741394755847, Exiting Thread 66000: ToolCommUsb::readTransfer,  cr.status = 0x0  
66000 1741394755847 XXXX 1741394755847, Thread 66000: XXXX 1741394755847, Exiting Thread 66000: Commands::runScriptWithUpload  
66000 1741394755847 XXXX 1741394755847, Thread 66000: XXXX 1741394755847, Entering Thread 66000: Commands::runScriptWithDownload, script name = WriteRAM  
66000 1741394755850 XXXX 1741394755850, Thread 66000: XXXX 1741394755850, Exiting Thread 66000: Commands::runScriptWithDownload(WriteRAM)  
66000 1741394755850 GEN4_TO_CONTROLLER_LOG:GEN4_DEBUG_INT_LOG_PIC24FJ128GL306 Post:SetFreezePerihperalInfo
66000 1741394755850 GEN4_TO_CONTROLLER_LOG:GEN4_DEBUG_INT_LOG_PIC24FJ128GL306 Return Value
66000 1741394755850 GEN4_TO_CONTROLLER_LOG:GEN4_DEBUG_INT_LOG_PIC24FJ128GL306 none
66000 1741394755850 GEN4_TO_CONTROLLER_LOG:GEN4_DEBUG_INT_LOG_PIC24FJ128GL306 Return End

65891 1741394755850 GEN4_TO_CONTROLLER_LOG:GEN4_DEBUG_INT_LOG_PIC24FJ128GL306 Pre:DebugReadTargetMemory
65891 1741394755850 GEN4_TO_CONTROLLER_LOG:GEN4_DEBUG_INT_LOG_PIC24FJ128GL306 Payload
65891 1741394755850 GEN4_TO_CONTROLLER_LOG:GEN4_DEBUG_INT_LOG_PIC24FJ128GL306 FileRegs
65891 1741394755850 GEN4_TO_CONTROLLER_LOG:GEN4_DEBUG_INT_LOG_PIC24FJ128GL306 1a0
65891 1741394755850 GEN4_TO_CONTROLLER_LOG:GEN4_DEBUG_INT_LOG_PIC24FJ128GL306 1a1
65891 1741394755850 GEN4_TO_CONTROLLER_LOG:GEN4_DEBUG_INT_LOG_PIC24FJ128GL306 Length = 2
65891 1741394755850 GEN4_TO_CONTROLLER_LOG:GEN4_DEBUG_INT_LOG_PIC24FJ128GL306 Payload End
65891 1741394755850 XXXX 1741394755850, Thread 65891: XXXX 1741394755850, Entering Thread 65891: Commands::runScriptWithUpload, script name = ReadRAM  
65891 1741394755850 XXXX 1741394755850, Thread 65891: XXXX 1741394755850, Entering Thread 65891: ToolCommUsb::readTransfer, sideData is 0x28 bytes long, transferDataLength is 0x2 bytes long  
65891 1741394755853 XXXX 1741394755853, Thread 65891: XXXX 1741394755853, Exiting Thread 65891: ToolCommUsb::readTransfer,  cr.status = 0x0  
65891 1741394755853 XXXX 1741394755853, Thread 65891: XXXX 1741394755853, Exiting Thread 65891: Commands::runScriptWithUpload  
65891 1741394755853 GEN4_TO_CONTROLLER_LOG:GEN4_DEBUG_INT_LOG_PIC24FJ128GL306 Post:DebugReadTargetMemory
65891 1741394755853 GEN4_TO_CONTROLLER_LOG:GEN4_DEBUG_INT_LOG_PIC24FJ128GL306 Return Value
65891 1741394755853 GEN4_TO_CONTROLLER_LOG:GEN4_DEBUG_INT_LOG_PIC24FJ128GL306 true
65891 1741394755853 GEN4_TO_CONTROLLER_LOG:GEN4_DEBUG_INT_LOG_PIC24FJ128GL306 Return End

66000 1741394755853 GEN4_TO_CONTROLLER_LOG:GEN4_DEBUG_INT_LOG_PIC24FJ128GL306 Pre:GetPC
66000 1741394755853 GEN4_TO_CONTROLLER_LOG:GEN4_DEBUG_INT_LOG_PIC24FJ128GL306 Payload
66000 1741394755853 GEN4_TO_CONTROLLER_LOG:GEN4_DEBUG_INT_LOG_PIC24FJ128GL306 null
66000 1741394755853 GEN4_TO_CONTROLLER_LOG:GEN4_DEBUG_INT_LOG_PIC24FJ128GL306 Payload End
66000 1741394755853 XXXX 1741394755853, Thread 66000: XXXX 1741394755853, Entering Thread 66000: Commands::runScriptBasic, script name = GetPC, timeOut = -1 ms  
66000 1741394755855 XXXX 1741394755855, Thread 66000: XXXX 1741394755855, Exiting Thread 66000: Commands::runScriptBasic  
66000 1741394755855 GEN4_TO_CONTROLLER_LOG:GEN4_DEBUG_INT_LOG_PIC24FJ128GL306 Post:GetPC
66000 1741394755855 GEN4_TO_CONTROLLER_LOG:GEN4_DEBUG_INT_LOG_PIC24FJ128GL306 Return Value
66000 1741394755855 GEN4_TO_CONTROLLER_LOG:GEN4_DEBUG_INT_LOG_PIC24FJ128GL306 0
66000 1741394755855 GEN4_TO_CONTROLLER_LOG:GEN4_DEBUG_INT_LOG_PIC24FJ128GL306 Return End

66000 1741394755855 GEN4_TO_CONTROLLER_LOG:GEN4_DEBUG_INT_LOG_PIC24FJ128GL306 Pre:SetSoftwareBreakpoint
66000 1741394755855 GEN4_TO_CONTROLLER_LOG:GEN4_DEBUG_INT_LOG_PIC24FJ128GL306 Payload
66000 1741394755855 GEN4_TO_CONTROLLER_LOG:GEN4_DEBUG_INT_LOG_PIC24FJ128GL306 27b0
66000 1741394755855 GEN4_TO_CONTROLLER_LOG:GEN4_DEBUG_INT_LOG_PIC24FJ128GL306 da4000
66000 1741394755855 GEN4_TO_CONTROLLER_LOG:GEN4_DEBUG_INT_LOG_PIC24FJ128GL306 4
66000 1741394755855 GEN4_TO_CONTROLLER_LOG:GEN4_DEBUG_INT_LOG_PIC24FJ128GL306 Payload End
66000 1741394755855 XXXX 1741394755855, Thread 66000: XXXX 1741394755855, Entering Thread 66000: Commands::runScriptWithUpload, script name = ReadProgmemDE  
66000 1741394755855 XXXX 1741394755855, Thread 66000: XXXX 1741394755855, Entering Thread 66000: ToolCommUsb::readTransfer, sideData is 0x29 bytes long, transferDataLength is 0xc00 bytes long  
66000 1741394756247 XXXX 1741394756247, Thread 66000: XXXX 1741394756247, Exiting Thread 66000: ToolCommUsb::readTransfer,  cr.status = 0x0  
66000 1741394756247 XXXX 1741394756247, Thread 66000: XXXX 1741394756247, Exiting Thread 66000: Commands::runScriptWithUpload  
66000 1741394756247 XXXX 1741394756247, Thread 66000: XXXX 1741394756247, Entering Thread 66000: Commands::runScriptWithDownload, script name = WriteProgmemDE  
66000 1741394756566 XXXX 1741394756566, Thread 66000: XXXX 1741394756566, Exiting Thread 66000: Commands::runScriptWithDownload(WriteProgmemDE)  
66000 1741394756566 GEN4_TO_CONTROLLER_LOG:GEN4_DEBUG_INT_LOG_PIC24FJ128GL306 Post:SetSoftwareBreakpoint
66000 1741394756566 GEN4_TO_CONTROLLER_LOG:GEN4_DEBUG_INT_LOG_PIC24FJ128GL306 Return Value
66000 1741394756566 GEN4_TO_CONTROLLER_LOG:GEN4_DEBUG_INT_LOG_PIC24FJ128GL306 eb0000
66000 1741394756566 GEN4_TO_CONTROLLER_LOG:GEN4_DEBUG_INT_LOG_PIC24FJ128GL306 Return End

65891 1741394756566 GEN4_TO_CONTROLLER_LOG:GEN4_DEBUG_INT_LOG_PIC24FJ128GL306 Pre:DebugReadTargetMemory
65891 1741394756566 GEN4_TO_CONTROLLER_LOG:GEN4_DEBUG_INT_LOG_PIC24FJ128GL306 Payload
65891 1741394756566 GEN4_TO_CONTROLLER_LOG:GEN4_DEBUG_INT_LOG_PIC24FJ128GL306 FileRegs
65891 1741394756566 GEN4_TO_CONTROLLER_LOG:GEN4_DEBUG_INT_LOG_PIC24FJ128GL306 42
65891 1741394756566 GEN4_TO_CONTROLLER_LOG:GEN4_DEBUG_INT_LOG_PIC24FJ128GL306 43
65891 1741394756566 GEN4_TO_CONTROLLER_LOG:GEN4_DEBUG_INT_LOG_PIC24FJ128GL306 Length = 2
65891 1741394756566 GEN4_TO_CONTROLLER_LOG:GEN4_DEBUG_INT_LOG_PIC24FJ128GL306 Payload End
65891 1741394756566 XXXX 1741394756566, Thread 65891: XXXX 1741394756566, Entering Thread 65891: Commands::runScriptWithUpload, script name = ReadRAM  
65891 1741394756566 XXXX 1741394756566, Thread 65891: XXXX 1741394756566, Entering Thread 65891: ToolCommUsb::readTransfer, sideData is 0x28 bytes long, transferDataLength is 0x2 bytes long  
65891 1741394756571 XXXX 1741394756571, Thread 65891: XXXX 1741394756571, Exiting Thread 65891: ToolCommUsb::readTransfer,  cr.status = 0x0  
65891 1741394756571 XXXX 1741394756571, Thread 65891: XXXX 1741394756571, Exiting Thread 65891: Commands::runScriptWithUpload  
65891 1741394756571 GEN4_TO_CONTROLLER_LOG:GEN4_DEBUG_INT_LOG_PIC24FJ128GL306 Post:DebugReadTargetMemory
65891 1741394756571 GEN4_TO_CONTROLLER_LOG:GEN4_DEBUG_INT_LOG_PIC24FJ128GL306 Return Value
65891 1741394756571 GEN4_TO_CONTROLLER_LOG:GEN4_DEBUG_INT_LOG_PIC24FJ128GL306 true
65891 1741394756571 GEN4_TO_CONTROLLER_LOG:GEN4_DEBUG_INT_LOG_PIC24FJ128GL306 Return End

66000 1741394756571 GEN4_TO_CONTROLLER_LOG:GEN4_DEBUG_INT_LOG_PIC24FJ128GL306 Pre:GetPC
66000 1741394756571 GEN4_TO_CONTROLLER_LOG:GEN4_DEBUG_INT_LOG_PIC24FJ128GL306 Payload
66000 1741394756571 GEN4_TO_CONTROLLER_LOG:GEN4_DEBUG_INT_LOG_PIC24FJ128GL306 null
66000 1741394756571 GEN4_TO_CONTROLLER_LOG:GEN4_DEBUG_INT_LOG_PIC24FJ128GL306 Payload End
66000 1741394756571 XXXX 1741394756571, Thread 66000: XXXX 1741394756571, Entering Thread 66000: Commands::runScriptBasic, script name = GetPC, timeOut = -1 ms  
66000 1741394756572 XXXX 1741394756572, Thread 66000: XXXX 1741394756572, Exiting Thread 66000: Commands::runScriptBasic  
66000 1741394756572 GEN4_TO_CONTROLLER_LOG:GEN4_DEBUG_INT_LOG_PIC24FJ128GL306 Post:GetPC
66000 1741394756572 GEN4_TO_CONTROLLER_LOG:GEN4_DEBUG_INT_LOG_PIC24FJ128GL306 Return Value
66000 1741394756572 GEN4_TO_CONTROLLER_LOG:GEN4_DEBUG_INT_LOG_PIC24FJ128GL306 0
66000 1741394756572 GEN4_TO_CONTROLLER_LOG:GEN4_DEBUG_INT_LOG_PIC24FJ128GL306 Return End

66000 1741394756572 GEN4_TO_CONTROLLER_LOG:GEN4_DEBUG_INT_LOG_PIC24FJ128GL306 Pre:GetPC
66000 1741394756572 GEN4_TO_CONTROLLER_LOG:GEN4_DEBUG_INT_LOG_PIC24FJ128GL306 Payload
66000 1741394756572 GEN4_TO_CONTROLLER_LOG:GEN4_DEBUG_INT_LOG_PIC24FJ128GL306 null
66000 1741394756572 GEN4_TO_CONTROLLER_LOG:GEN4_DEBUG_INT_LOG_PIC24FJ128GL306 Payload End
66000 1741394756572 XXXX 1741394756572, Thread 66000: XXXX 1741394756572, Entering Thread 66000: Commands::runScriptBasic, script name = GetPC, timeOut = -1 ms  
66000 1741394756574 XXXX 1741394756572, Thread 66000: XXXX 1741394756572, Exiting Thread 66000: Commands::runScriptBasic  
66000 1741394756574 GEN4_TO_CONTROLLER_LOG:GEN4_DEBUG_INT_LOG_PIC24FJ128GL306 Post:GetPC
66000 1741394756574 GEN4_TO_CONTROLLER_LOG:GEN4_DEBUG_INT_LOG_PIC24FJ128GL306 Return Value
66000 1741394756574 GEN4_TO_CONTROLLER_LOG:GEN4_DEBUG_INT_LOG_PIC24FJ128GL306 0
66000 1741394756574 GEN4_TO_CONTROLLER_LOG:GEN4_DEBUG_INT_LOG_PIC24FJ128GL306 Return End

66000 1741394756574 GEN4_TO_CONTROLLER_LOG:GEN4_DEBUG_INT_LOG_PIC24FJ128GL306 Pre:SetSoftwareBreakpoint
66000 1741394756574 GEN4_TO_CONTROLLER_LOG:GEN4_DEBUG_INT_LOG_PIC24FJ128GL306 Payload
66000 1741394756574 GEN4_TO_CONTROLLER_LOG:GEN4_DEBUG_INT_LOG_PIC24FJ128GL306 25e8
66000 1741394756574 GEN4_TO_CONTROLLER_LOG:GEN4_DEBUG_INT_LOG_PIC24FJ128GL306 da4000
66000 1741394756574 GEN4_TO_CONTROLLER_LOG:GEN4_DEBUG_INT_LOG_PIC24FJ128GL306 4
66000 1741394756574 GEN4_TO_CONTROLLER_LOG:GEN4_DEBUG_INT_LOG_PIC24FJ128GL306 Payload End
66000 1741394756574 XXXX 1741394756574, Thread 66000: XXXX 1741394756574, Entering Thread 66000: Commands::runScriptWithUpload, script name = ReadProgmemDE  
66000 1741394756574 XXXX 1741394756574, Thread 66000: XXXX 1741394756574, Entering Thread 66000: ToolCommUsb::readTransfer, sideData is 0x29 bytes long, transferDataLength is 0xc00 bytes long  
66000 1741394756964 XXXX 1741394756964, Thread 66000: XXXX 1741394756964, Exiting Thread 66000: ToolCommUsb::readTransfer,  cr.status = 0x0  
66000 1741394756964 XXXX 1741394756964, Thread 66000: XXXX 1741394756964, Exiting Thread 66000: Commands::runScriptWithUpload  
66000 1741394756964 XXXX 1741394756964, Thread 66000: XXXX 1741394756964, Entering Thread 66000: Commands::runScriptWithDownload, script name = WriteProgmemDE  
66000 1741394757286 XXXX 1741394757286, Thread 66000: XXXX 1741394757286, Exiting Thread 66000: Commands::runScriptWithDownload(WriteProgmemDE)  
66000 1741394757286 GEN4_TO_CONTROLLER_LOG:GEN4_DEBUG_INT_LOG_PIC24FJ128GL306 Post:SetSoftwareBreakpoint
66000 1741394757286 GEN4_TO_CONTROLLER_LOG:GEN4_DEBUG_INT_LOG_PIC24FJ128GL306 Return Value
66000 1741394757286 GEN4_TO_CONTROLLER_LOG:GEN4_DEBUG_INT_LOG_PIC24FJ128GL306 209cd0
66000 1741394757286 GEN4_TO_CONTROLLER_LOG:GEN4_DEBUG_INT_LOG_PIC24FJ128GL306 Return End

66000 1741394757286 GEN4_TO_CONTROLLER_LOG:GEN4_DEBUG_INT_LOG_PIC24FJ128GL306 Pre:GetPC
66000 1741394757286 GEN4_TO_CONTROLLER_LOG:GEN4_DEBUG_INT_LOG_PIC24FJ128GL306 Payload
66000 1741394757286 GEN4_TO_CONTROLLER_LOG:GEN4_DEBUG_INT_LOG_PIC24FJ128GL306 null
66000 1741394757286 GEN4_TO_CONTROLLER_LOG:GEN4_DEBUG_INT_LOG_PIC24FJ128GL306 Payload End
66000 1741394757286 XXXX 1741394757286, Thread 66000: XXXX 1741394757286, Entering Thread 66000: Commands::runScriptBasic, script name = GetPC, timeOut = -1 ms  
66000 1741394757287 XXXX 1741394757287, Thread 66000: XXXX 1741394757287, Exiting Thread 66000: Commands::runScriptBasic  
66000 1741394757287 GEN4_TO_CONTROLLER_LOG:GEN4_DEBUG_INT_LOG_PIC24FJ128GL306 Post:GetPC
66000 1741394757287 GEN4_TO_CONTROLLER_LOG:GEN4_DEBUG_INT_LOG_PIC24FJ128GL306 Return Value
66000 1741394757287 GEN4_TO_CONTROLLER_LOG:GEN4_DEBUG_INT_LOG_PIC24FJ128GL306 0
66000 1741394757287 GEN4_TO_CONTROLLER_LOG:GEN4_DEBUG_INT_LOG_PIC24FJ128GL306 Return End

66000 1741394757287 GEN4_TO_CONTROLLER_LOG:GEN4_DEBUG_INT_LOG_PIC24FJ128GL306 Pre:GetPC
66000 1741394757287 GEN4_TO_CONTROLLER_LOG:GEN4_DEBUG_INT_LOG_PIC24FJ128GL306 Payload
66000 1741394757287 GEN4_TO_CONTROLLER_LOG:GEN4_DEBUG_INT_LOG_PIC24FJ128GL306 null
66000 1741394757287 GEN4_TO_CONTROLLER_LOG:GEN4_DEBUG_INT_LOG_PIC24FJ128GL306 Payload End
66000 1741394757287 XXXX 1741394757287, Thread 66000: XXXX 1741394757287, Entering Thread 66000: Commands::runScriptBasic, script name = GetPC, timeOut = -1 ms  
66000 1741394757289 XXXX 1741394757289, Thread 66000: XXXX 1741394757289, Exiting Thread 66000: Commands::runScriptBasic  
66000 1741394757289 GEN4_TO_CONTROLLER_LOG:GEN4_DEBUG_INT_LOG_PIC24FJ128GL306 Post:GetPC
66000 1741394757289 GEN4_TO_CONTROLLER_LOG:GEN4_DEBUG_INT_LOG_PIC24FJ128GL306 Return Value
66000 1741394757289 GEN4_TO_CONTROLLER_LOG:GEN4_DEBUG_INT_LOG_PIC24FJ128GL306 0
66000 1741394757289 GEN4_TO_CONTROLLER_LOG:GEN4_DEBUG_INT_LOG_PIC24FJ128GL306 Return End

66000 1741394757289 GEN4_TO_CONTROLLER_LOG:GEN4_DEBUG_INT_LOG_PIC24FJ128GL306 Pre:SetSoftwareBreakpoint
66000 1741394757289 GEN4_TO_CONTROLLER_LOG:GEN4_DEBUG_INT_LOG_PIC24FJ128GL306 Payload
66000 1741394757289 GEN4_TO_CONTROLLER_LOG:GEN4_DEBUG_INT_LOG_PIC24FJ128GL306 260e
66000 1741394757289 GEN4_TO_CONTROLLER_LOG:GEN4_DEBUG_INT_LOG_PIC24FJ128GL306 da4000
66000 1741394757289 GEN4_TO_CONTROLLER_LOG:GEN4_DEBUG_INT_LOG_PIC24FJ128GL306 4
66000 1741394757289 GEN4_TO_CONTROLLER_LOG:GEN4_DEBUG_INT_LOG_PIC24FJ128GL306 Payload End
66000 1741394757289 XXXX 1741394757289, Thread 66000: XXXX 1741394757289, Entering Thread 66000: Commands::runScriptWithUpload, script name = ReadProgmemDE  
66000 1741394757289 XXXX 1741394757289, Thread 66000: XXXX 1741394757289, Entering Thread 66000: ToolCommUsb::readTransfer, sideData is 0x29 bytes long, transferDataLength is 0xc00 bytes long  
66000 1741394757680 XXXX 1741394757680, Thread 66000: XXXX 1741394757680, Exiting Thread 66000: ToolCommUsb::readTransfer,  cr.status = 0x0  
66000 1741394757680 XXXX 1741394757680, Thread 66000: XXXX 1741394757680, Exiting Thread 66000: Commands::runScriptWithUpload  
66000 1741394757680 XXXX 1741394757680, Thread 66000: XXXX 1741394757680, Entering Thread 66000: Commands::runScriptWithDownload, script name = WriteProgmemDE  
66000 1741394758000 XXXX 1741394758000, Thread 66000: XXXX 1741394758000, Exiting Thread 66000: Commands::runScriptWithDownload(WriteProgmemDE)  
66000 1741394758000 GEN4_TO_CONTROLLER_LOG:GEN4_DEBUG_INT_LOG_PIC24FJ128GL306 Post:SetSoftwareBreakpoint
66000 1741394758000 GEN4_TO_CONTROLLER_LOG:GEN4_DEBUG_INT_LOG_PIC24FJ128GL306 Return Value
66000 1741394758000 GEN4_TO_CONTROLLER_LOG:GEN4_DEBUG_INT_LOG_PIC24FJ128GL306 eb0000
66000 1741394758000 GEN4_TO_CONTROLLER_LOG:GEN4_DEBUG_INT_LOG_PIC24FJ128GL306 Return End

66000 1741394758000 GEN4_TO_CONTROLLER_LOG:GEN4_DEBUG_INT_LOG_PIC24FJ128GL306 Pre:GetPC
66000 1741394758000 GEN4_TO_CONTROLLER_LOG:GEN4_DEBUG_INT_LOG_PIC24FJ128GL306 Payload
66000 1741394758000 GEN4_TO_CONTROLLER_LOG:GEN4_DEBUG_INT_LOG_PIC24FJ128GL306 null
66000 1741394758000 GEN4_TO_CONTROLLER_LOG:GEN4_DEBUG_INT_LOG_PIC24FJ128GL306 Payload End
66000 1741394758002 XXXX 1741394758002, Thread 66000: XXXX 1741394758000, Entering Thread 66000: Commands::runScriptBasic, script name = GetPC, timeOut = -1 ms  
66000 1741394758004 XXXX 1741394758004, Thread 66000: XXXX 1741394758004, Exiting Thread 66000: Commands::runScriptBasic  
66000 1741394758004 GEN4_TO_CONTROLLER_LOG:GEN4_DEBUG_INT_LOG_PIC24FJ128GL306 Post:GetPC
66000 1741394758004 GEN4_TO_CONTROLLER_LOG:GEN4_DEBUG_INT_LOG_PIC24FJ128GL306 Return Value
66000 1741394758004 GEN4_TO_CONTROLLER_LOG:GEN4_DEBUG_INT_LOG_PIC24FJ128GL306 0
66000 1741394758004 GEN4_TO_CONTROLLER_LOG:GEN4_DEBUG_INT_LOG_PIC24FJ128GL306 Return End

66000 1741394758004 GEN4_TO_CONTROLLER_LOG:GEN4_DEBUG_INT_LOG_PIC24FJ128GL306 Pre:GetPC
66000 1741394758004 GEN4_TO_CONTROLLER_LOG:GEN4_DEBUG_INT_LOG_PIC24FJ128GL306 Payload
66000 1741394758004 GEN4_TO_CONTROLLER_LOG:GEN4_DEBUG_INT_LOG_PIC24FJ128GL306 null
66000 1741394758004 GEN4_TO_CONTROLLER_LOG:GEN4_DEBUG_INT_LOG_PIC24FJ128GL306 Payload End
66000 1741394758004 XXXX 1741394758004, Thread 66000: XXXX 1741394758004, Entering Thread 66000: Commands::runScriptBasic, script name = GetPC, timeOut = -1 ms  
66000 1741394758005 XXXX 1741394758005, Thread 66000: XXXX 1741394758005, Exiting Thread 66000: Commands::runScriptBasic  
66000 1741394758005 GEN4_TO_CONTROLLER_LOG:GEN4_DEBUG_INT_LOG_PIC24FJ128GL306 Post:GetPC
66000 1741394758005 GEN4_TO_CONTROLLER_LOG:GEN4_DEBUG_INT_LOG_PIC24FJ128GL306 Return Value
66000 1741394758005 GEN4_TO_CONTROLLER_LOG:GEN4_DEBUG_INT_LOG_PIC24FJ128GL306 0
66000 1741394758005 GEN4_TO_CONTROLLER_LOG:GEN4_DEBUG_INT_LOG_PIC24FJ128GL306 Return End

66000 1741394758005 GEN4_TO_CONTROLLER_LOG:GEN4_DEBUG_INT_LOG_PIC24FJ128GL306 Pre:SetSoftwareBreakpoint
66000 1741394758005 GEN4_TO_CONTROLLER_LOG:GEN4_DEBUG_INT_LOG_PIC24FJ128GL306 Payload
66000 1741394758005 GEN4_TO_CONTROLLER_LOG:GEN4_DEBUG_INT_LOG_PIC24FJ128GL306 2628
66000 1741394758005 GEN4_TO_CONTROLLER_LOG:GEN4_DEBUG_INT_LOG_PIC24FJ128GL306 da4000
66000 1741394758005 GEN4_TO_CONTROLLER_LOG:GEN4_DEBUG_INT_LOG_PIC24FJ128GL306 4
66000 1741394758005 GEN4_TO_CONTROLLER_LOG:GEN4_DEBUG_INT_LOG_PIC24FJ128GL306 Payload End
66000 1741394758005 XXXX 1741394758005, Thread 66000: XXXX 1741394758005, Entering Thread 66000: Commands::runScriptWithUpload, script name = ReadProgmemDE  
66000 1741394758005 XXXX 1741394758005, Thread 66000: XXXX 1741394758005, Entering Thread 66000: ToolCommUsb::readTransfer, sideData is 0x29 bytes long, transferDataLength is 0xc00 bytes long  
66000 1741394758397 XXXX 1741394758397, Thread 66000: XXXX 1741394758397, Exiting Thread 66000: ToolCommUsb::readTransfer,  cr.status = 0x0  
66000 1741394758397 XXXX 1741394758397, Thread 66000: XXXX 1741394758397, Exiting Thread 66000: Commands::runScriptWithUpload  
66000 1741394758397 XXXX 1741394758397, Thread 66000: XXXX 1741394758397, Entering Thread 66000: Commands::runScriptWithDownload, script name = WriteProgmemDE  
66000 1741394758718 XXXX 1741394758718, Thread 66000: XXXX 1741394758718, Exiting Thread 66000: Commands::runScriptWithDownload(WriteProgmemDE)  
66000 1741394758718 GEN4_TO_CONTROLLER_LOG:GEN4_DEBUG_INT_LOG_PIC24FJ128GL306 Post:SetSoftwareBreakpoint
66000 1741394758718 GEN4_TO_CONTROLLER_LOG:GEN4_DEBUG_INT_LOG_PIC24FJ128GL306 Return Value
66000 1741394758718 GEN4_TO_CONTROLLER_LOG:GEN4_DEBUG_INT_LOG_PIC24FJ128GL306 ef287c
66000 1741394758718 GEN4_TO_CONTROLLER_LOG:GEN4_DEBUG_INT_LOG_PIC24FJ128GL306 Return End

66000 1741394758718 GEN4_TO_CONTROLLER_LOG:GEN4_DEBUG_INT_LOG_PIC24FJ128GL306 Pre:GetPC
66000 1741394758718 GEN4_TO_CONTROLLER_LOG:GEN4_DEBUG_INT_LOG_PIC24FJ128GL306 Payload
66000 1741394758718 GEN4_TO_CONTROLLER_LOG:GEN4_DEBUG_INT_LOG_PIC24FJ128GL306 null
66000 1741394758718 GEN4_TO_CONTROLLER_LOG:GEN4_DEBUG_INT_LOG_PIC24FJ128GL306 Payload End
66000 1741394758718 XXXX 1741394758718, Thread 66000: XXXX 1741394758718, Entering Thread 66000: Commands::runScriptBasic, script name = GetPC, timeOut = -1 ms  
66000 1741394758720 XXXX 1741394758720, Thread 66000: XXXX 1741394758720, Exiting Thread 66000: Commands::runScriptBasic  
66000 1741394758720 GEN4_TO_CONTROLLER_LOG:GEN4_DEBUG_INT_LOG_PIC24FJ128GL306 Post:GetPC
66000 1741394758720 GEN4_TO_CONTROLLER_LOG:GEN4_DEBUG_INT_LOG_PIC24FJ128GL306 Return Value
66000 1741394758720 GEN4_TO_CONTROLLER_LOG:GEN4_DEBUG_INT_LOG_PIC24FJ128GL306 0
66000 1741394758720 GEN4_TO_CONTROLLER_LOG:GEN4_DEBUG_INT_LOG_PIC24FJ128GL306 Return End

66000 1741394758720 GEN4_TO_CONTROLLER_LOG:GEN4_DEBUG_INT_LOG_PIC24FJ128GL306 Pre:GetPC
66000 1741394758720 GEN4_TO_CONTROLLER_LOG:GEN4_DEBUG_INT_LOG_PIC24FJ128GL306 Payload
66000 1741394758720 GEN4_TO_CONTROLLER_LOG:GEN4_DEBUG_INT_LOG_PIC24FJ128GL306 null
66000 1741394758720 GEN4_TO_CONTROLLER_LOG:GEN4_DEBUG_INT_LOG_PIC24FJ128GL306 Payload End
66000 1741394758720 XXXX 1741394758720, Thread 66000: XXXX 1741394758720, Entering Thread 66000: Commands::runScriptBasic, script name = GetPC, timeOut = -1 ms  
66000 1741394758723 XXXX 1741394758723, Thread 66000: XXXX 1741394758723, Exiting Thread 66000: Commands::runScriptBasic  
66000 1741394758723 GEN4_TO_CONTROLLER_LOG:GEN4_DEBUG_INT_LOG_PIC24FJ128GL306 Post:GetPC
66000 1741394758723 GEN4_TO_CONTROLLER_LOG:GEN4_DEBUG_INT_LOG_PIC24FJ128GL306 Return Value
66000 1741394758723 GEN4_TO_CONTROLLER_LOG:GEN4_DEBUG_INT_LOG_PIC24FJ128GL306 0
66000 1741394758723 GEN4_TO_CONTROLLER_LOG:GEN4_DEBUG_INT_LOG_PIC24FJ128GL306 Return End

66000 1741394758723 GEN4_TO_CONTROLLER_LOG:GEN4_DEBUG_INT_LOG_PIC24FJ128GL306 Pre:SetSoftwareBreakpoint
66000 1741394758723 GEN4_TO_CONTROLLER_LOG:GEN4_DEBUG_INT_LOG_PIC24FJ128GL306 Payload
66000 1741394758723 GEN4_TO_CONTROLLER_LOG:GEN4_DEBUG_INT_LOG_PIC24FJ128GL306 263a
66000 1741394758723 GEN4_TO_CONTROLLER_LOG:GEN4_DEBUG_INT_LOG_PIC24FJ128GL306 da4000
66000 1741394758723 GEN4_TO_CONTROLLER_LOG:GEN4_DEBUG_INT_LOG_PIC24FJ128GL306 4
66000 1741394758723 GEN4_TO_CONTROLLER_LOG:GEN4_DEBUG_INT_LOG_PIC24FJ128GL306 Payload End
66000 1741394758723 XXXX 1741394758723, Thread 66000: XXXX 1741394758723, Entering Thread 66000: Commands::runScriptWithUpload, script name = ReadProgmemDE  
66000 1741394758723 XXXX 1741394758723, Thread 66000: XXXX 1741394758723, Entering Thread 66000: ToolCommUsb::readTransfer, sideData is 0x29 bytes long, transferDataLength is 0xc00 bytes long  
66000 1741394759113 XXXX 1741394759113, Thread 66000: XXXX 1741394759113, Exiting Thread 66000: ToolCommUsb::readTransfer,  cr.status = 0x0  
66000 1741394759113 XXXX 1741394759113, Thread 66000: XXXX 1741394759113, Exiting Thread 66000: Commands::runScriptWithUpload  
66000 1741394759113 XXXX 1741394759113, Thread 66000: XXXX 1741394759113, Entering Thread 66000: Commands::runScriptWithDownload, script name = WriteProgmemDE  
66000 1741394759434 XXXX 1741394759434, Thread 66000: XXXX 1741394759434, Exiting Thread 66000: Commands::runScriptWithDownload(WriteProgmemDE)  
66000 1741394759434 GEN4_TO_CONTROLLER_LOG:GEN4_DEBUG_INT_LOG_PIC24FJ128GL306 Post:SetSoftwareBreakpoint
66000 1741394759434 GEN4_TO_CONTROLLER_LOG:GEN4_DEBUG_INT_LOG_PIC24FJ128GL306 Return Value
66000 1741394759434 GEN4_TO_CONTROLLER_LOG:GEN4_DEBUG_INT_LOG_PIC24FJ128GL306 209cf0
66000 1741394759434 GEN4_TO_CONTROLLER_LOG:GEN4_DEBUG_INT_LOG_PIC24FJ128GL306 Return End

66000 1741394759434 GEN4_TO_CONTROLLER_LOG:GEN4_DEBUG_INT_LOG_PIC24FJ128GL306 Pre:GetPC
66000 1741394759434 GEN4_TO_CONTROLLER_LOG:GEN4_DEBUG_INT_LOG_PIC24FJ128GL306 Payload
66000 1741394759434 GEN4_TO_CONTROLLER_LOG:GEN4_DEBUG_INT_LOG_PIC24FJ128GL306 null
66000 1741394759434 GEN4_TO_CONTROLLER_LOG:GEN4_DEBUG_INT_LOG_PIC24FJ128GL306 Payload End
66000 1741394759434 XXXX 1741394759434, Thread 66000: XXXX 1741394759434, Entering Thread 66000: Commands::runScriptBasic, script name = GetPC, timeOut = -1 ms  
66000 1741394759436 XXXX 1741394759436, Thread 66000: XXXX 1741394759436, Exiting Thread 66000: Commands::runScriptBasic  
66000 1741394759436 GEN4_TO_CONTROLLER_LOG:GEN4_DEBUG_INT_LOG_PIC24FJ128GL306 Post:GetPC
66000 1741394759436 GEN4_TO_CONTROLLER_LOG:GEN4_DEBUG_INT_LOG_PIC24FJ128GL306 Return Value
66000 1741394759436 GEN4_TO_CONTROLLER_LOG:GEN4_DEBUG_INT_LOG_PIC24FJ128GL306 0
66000 1741394759436 GEN4_TO_CONTROLLER_LOG:GEN4_DEBUG_INT_LOG_PIC24FJ128GL306 Return End

66000 1741394759436 GEN4_TO_CONTROLLER_LOG:GEN4_DEBUG_INT_LOG_PIC24FJ128GL306 Pre:GetPC
66000 1741394759436 GEN4_TO_CONTROLLER_LOG:GEN4_DEBUG_INT_LOG_PIC24FJ128GL306 Payload
66000 1741394759436 GEN4_TO_CONTROLLER_LOG:GEN4_DEBUG_INT_LOG_PIC24FJ128GL306 null
66000 1741394759436 GEN4_TO_CONTROLLER_LOG:GEN4_DEBUG_INT_LOG_PIC24FJ128GL306 Payload End
66000 1741394759436 XXXX 1741394759436, Thread 66000: XXXX 1741394759436, Entering Thread 66000: Commands::runScriptBasic, script name = GetPC, timeOut = -1 ms  
66000 1741394759438 XXXX 1741394759438, Thread 66000: XXXX 1741394759438, Exiting Thread 66000: Commands::runScriptBasic  
66000 1741394759438 GEN4_TO_CONTROLLER_LOG:GEN4_DEBUG_INT_LOG_PIC24FJ128GL306 Post:GetPC
66000 1741394759438 GEN4_TO_CONTROLLER_LOG:GEN4_DEBUG_INT_LOG_PIC24FJ128GL306 Return Value
66000 1741394759438 GEN4_TO_CONTROLLER_LOG:GEN4_DEBUG_INT_LOG_PIC24FJ128GL306 0
66000 1741394759438 GEN4_TO_CONTROLLER_LOG:GEN4_DEBUG_INT_LOG_PIC24FJ128GL306 Return End

66000 1741394759438 GEN4_TO_CONTROLLER_LOG:GEN4_DEBUG_INT_LOG_PIC24FJ128GL306 Pre:GetPC
66000 1741394759438 GEN4_TO_CONTROLLER_LOG:GEN4_DEBUG_INT_LOG_PIC24FJ128GL306 Payload
66000 1741394759438 GEN4_TO_CONTROLLER_LOG:GEN4_DEBUG_INT_LOG_PIC24FJ128GL306 null
66000 1741394759438 GEN4_TO_CONTROLLER_LOG:GEN4_DEBUG_INT_LOG_PIC24FJ128GL306 Payload End
66000 1741394759438 XXXX 1741394759438, Thread 66000: XXXX 1741394759438, Entering Thread 66000: Commands::runScriptBasic, script name = GetPC, timeOut = -1 ms  
66000 1741394759439 XXXX 1741394759439, Thread 66000: XXXX 1741394759439, Exiting Thread 66000: Commands::runScriptBasic  
66000 1741394759439 GEN4_TO_CONTROLLER_LOG:GEN4_DEBUG_INT_LOG_PIC24FJ128GL306 Post:GetPC
66000 1741394759439 GEN4_TO_CONTROLLER_LOG:GEN4_DEBUG_INT_LOG_PIC24FJ128GL306 Return Value
66000 1741394759439 GEN4_TO_CONTROLLER_LOG:GEN4_DEBUG_INT_LOG_PIC24FJ128GL306 0
66000 1741394759439 GEN4_TO_CONTROLLER_LOG:GEN4_DEBUG_INT_LOG_PIC24FJ128GL306 Return End

66000 1741394759443 GEN4_TO_CONTROLLER_LOG:GEN4_DEBUG_INT_LOG_PIC24FJ128GL306 Pre:RunTarget
66000 1741394759443 GEN4_TO_CONTROLLER_LOG:GEN4_DEBUG_INT_LOG_PIC24FJ128GL306 Payload
66000 1741394759443 GEN4_TO_CONTROLLER_LOG:GEN4_DEBUG_INT_LOG_PIC24FJ128GL306 com.microchip.mplab.mdbcore.RI4Tool.DebugHandler@252eca98
66000 1741394759443 GEN4_TO_CONTROLLER_LOG:GEN4_DEBUG_INT_LOG_PIC24FJ128GL306 Payload End
66000 1741394759443 XXXX 1741394759443, Thread 66000: XXXX 1741394759443, Entering Thread 66000: Commands::runScriptBasic, script name = Run, timeOut = -1 ms  
66000 1741394759444 XXXX 1741394759444, Thread 66000: XXXX 1741394759444, Exiting Thread 66000: Commands::runScriptBasic  
66000 1741394759444 GEN4_TO_CONTROLLER_LOG:GEN4_DEBUG_INT_LOG_PIC24FJ128GL306 Post:RunTarget
66000 1741394759444 GEN4_TO_CONTROLLER_LOG:GEN4_DEBUG_INT_LOG_PIC24FJ128GL306 Return Value
66000 1741394759444 GEN4_TO_CONTROLLER_LOG:GEN4_DEBUG_INT_LOG_PIC24FJ128GL306 true
66000 1741394759444 GEN4_TO_CONTROLLER_LOG:GEN4_DEBUG_INT_LOG_PIC24FJ128GL306 Return End
66000 1741394759700 XXXX 1741394759700, Thread 66000: XXXX 1741394759700, Entering Thread 66000: Commands::runScriptBasic, script name = GetHaltStatus, timeOut = -1 ms  
66000 1741394759702 XXXX 1741394759702, Thread 66000: XXXX 1741394759702, Exiting Thread 66000: Commands::runScriptBasic  
66000 1741394759801 XXXX 1741394759801, Thread 66000: XXXX 1741394759801, Entering Thread 66000: Commands::runScriptBasic, script name = GetHaltStatus, timeOut = -1 ms  
66000 1741394759802 XXXX 1741394759802, Thread 66000: XXXX 1741394759802, Exiting Thread 66000: Commands::runScriptBasic  
66000 1741394759902 XXXX 1741394759902, Thread 66000: XXXX 1741394759902, Entering Thread 66000: Commands::runScriptBasic, script name = GetHaltStatus, timeOut = -1 ms  
66000 1741394759903 XXXX 1741394759903, Thread 66000: XXXX 1741394759903, Exiting Thread 66000: Commands::runScriptBasic  
66000 1741394760002 XXXX 1741394760002, Thread 66000: XXXX 1741394760002, Entering Thread 66000: Commands::runScriptBasic, script name = GetHaltStatus, timeOut = -1 ms  
66000 1741394760003 XXXX 1741394760003, Thread 66000: XXXX 1741394760003, Exiting Thread 66000: Commands::runScriptBasic  
66000 1741394760103 XXXX 1741394760103, Thread 66000: XXXX 1741394760103, Entering Thread 66000: Commands::runScriptBasic, script name = GetHaltStatus, timeOut = -1 ms  
66000 1741394760105 XXXX 1741394760105, Thread 66000: XXXX 1741394760105, Exiting Thread 66000: Commands::runScriptBasic  
66000 1741394760204 XXXX 1741394760204, Thread 66000: XXXX 1741394760204, Entering Thread 66000: Commands::runScriptBasic, script name = GetHaltStatus, timeOut = -1 ms  
66000 1741394760204 XXXX 1741394760204, Thread 66000: XXXX 1741394760204, Exiting Thread 66000: Commands::runScriptBasic  
66000 1741394760307 XXXX 1741394760307, Thread 66000: XXXX 1741394760307, Entering Thread 66000: Commands::runScriptBasic, script name = GetHaltStatus, timeOut = -1 ms  
66000 1741394760308 XXXX 1741394760308, Thread 66000: XXXX 1741394760308, Exiting Thread 66000: Commands::runScriptBasic  
66000 1741394760408 XXXX 1741394760408, Thread 66000: XXXX 1741394760408, Entering Thread 66000: Commands::runScriptBasic, script name = GetHaltStatus, timeOut = -1 ms  
66000 1741394760408 XXXX 1741394760408, Thread 66000: XXXX 1741394760408, Exiting Thread 66000: Commands::runScriptBasic  
66000 1741394760510 XXXX 1741394760510, Thread 66000: XXXX 1741394760510, Entering Thread 66000: Commands::runScriptBasic, script name = GetHaltStatus, timeOut = -1 ms  
66000 1741394760510 XXXX 1741394760510, Thread 66000: XXXX 1741394760510, Exiting Thread 66000: Commands::runScriptBasic  
66000 1741394760612 XXXX 1741394760612, Thread 66000: XXXX 1741394760612, Entering Thread 66000: Commands::runScriptBasic, script name = GetHaltStatus, timeOut = -1 ms  
66000 1741394760612 XXXX 1741394760612, Thread 66000: XXXX 1741394760612, Exiting Thread 66000: Commands::runScriptBasic  
66000 1741394760715 XXXX 1741394760715, Thread 66000: XXXX 1741394760715, Entering Thread 66000: Commands::runScriptBasic, script name = GetHaltStatus, timeOut = -1 ms  
66000 1741394760717 XXXX 1741394760717, Thread 66000: XXXX 1741394760717, Exiting Thread 66000: Commands::runScriptBasic  
66000 1741394760817 XXXX 1741394760817, Thread 66000: XXXX 1741394760817, Entering Thread 66000: Commands::runScriptBasic, script name = GetHaltStatus, timeOut = -1 ms  
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
66000 1741394763258 XXXX 1741394763258, Thread 66000: XXXX 1741394763258, Exiting Thread 66000: Commands::runScriptBasic  
66000 1741394763359 XXXX 1741394763359, Thread 66000: XXXX 1741394763359, Entering Thread 66000: Commands::runScriptBasic, script name = GetHaltStatus, timeOut = -1 ms  
66000 1741394763360 XXXX 1741394763360, Thread 66000: XXXX 1741394763360, Exiting Thread 66000: Commands::runScriptBasic  
66000 1741394763459 XXXX 1741394763459, Thread 66000: XXXX 1741394763459, Entering Thread 66000: Commands::runScriptBasic, script name = GetHaltStatus, timeOut = -1 ms  
66000 1741394763459 XXXX 1741394763459, Thread 66000: XXXX 1741394763459, Exiting Thread 66000: Commands::runScriptBasic  
66000 1741394763560 XXXX 1741394763560, Thread 66000: XXXX 1741394763560, Entering Thread 66000: Commands::runScriptBasic, script name = GetHaltStatus, timeOut = -1 ms  
66000 1741394763562 XXXX 1741394763562, Thread 66000: XXXX 1741394763562, Exiting Thread 66000: Commands::runScriptBasic  
66000 1741394763661 XXXX 1741394763661, Thread 66000: XXXX 1741394763661, Entering Thread 66000: Commands::runScriptBasic, script name = GetHaltStatus, timeOut = -1 ms  
66000 1741394763661 XXXX 1741394763661, Thread 66000: XXXX 1741394763661, Exiting Thread 66000: Commands::runScriptBasic  
66000 1741394763762 XXXX 1741394763762, Thread 66000: XXXX 1741394763762, Entering Thread 66000: Commands::runScriptBasic, script name = GetHaltStatus, timeOut = -1 ms  
66000 1741394763763 XXXX 1741394763763, Thread 66000: XXXX 1741394763763, Exiting Thread 66000: Commands::runScriptBasic  
66000 1741394763863 XXXX 1741394763863, Thread 66000: XXXX 1741394763863, Entering Thread 66000: Commands::runScriptBasic, script name = GetHaltStatus, timeOut = -1 ms  
66000 1741394763863 XXXX 1741394763863, Thread 66000: XXXX 1741394763863, Exiting Thread 66000: Commands::runScriptBasic  
66000 1741394763965 XXXX 1741394763965, Thread 66000: XXXX 1741394763965, Entering Thread 66000: Commands::runScriptBasic, script name = GetHaltStatus, timeOut = -1 ms  
66000 1741394763965 XXXX 1741394763965, Thread 66000: XXXX 1741394763965, Exiting Thread 66000: Commands::runScriptBasic  
66000 1741394764066 XXXX 1741394764066, Thread 66000: XXXX 1741394764066, Entering Thread 66000: Commands::runScriptBasic, script name = GetHaltStatus, timeOut = -1 ms  
66000 1741394764066 XXXX 1741394764066, Thread 66000: XXXX 1741394764066, Exiting Thread 66000: Commands::runScriptBasic  
66000 1741394764168 XXXX 1741394764168, Thread 66000: XXXX 1741394764168, Entering Thread 66000: Commands::runScriptBasic, script name = GetHaltStatus, timeOut = -1 ms  
66000 1741394764169 XXXX 1741394764169, Thread 66000: XXXX 1741394764169, Exiting Thread 66000: Commands::runScriptBasic  
66000 1741394764270 XXXX 1741394764270, Thread 66000: XXXX 1741394764270, Entering Thread 66000: Commands::runScriptBasic, script name = GetHaltStatus, timeOut = -1 ms  
66000 1741394764270 XXXX 1741394764270, Thread 66000: XXXX 1741394764270, Exiting Thread 66000: Commands::runScriptBasic  

65891 1741394764330 GEN4_TO_CONTROLLER_LOG:GEN4_DEBUG_INT_LOG_PIC24FJ128GL306 Pre:DebugReadTargetMemory
65891 1741394764330 GEN4_TO_CONTROLLER_LOG:GEN4_DEBUG_INT_LOG_PIC24FJ128GL306 Payload
65891 1741394764330 GEN4_TO_CONTROLLER_LOG:GEN4_DEBUG_INT_LOG_PIC24FJ128GL306 FileRegs
65891 1741394764330 GEN4_TO_CONTROLLER_LOG:GEN4_DEBUG_INT_LOG_PIC24FJ128GL306 1c
65891 1741394764330 GEN4_TO_CONTROLLER_LOG:GEN4_DEBUG_INT_LOG_PIC24FJ128GL306 1d
65891 1741394764330 GEN4_TO_CONTROLLER_LOG:GEN4_DEBUG_INT_LOG_PIC24FJ128GL306 Length = 2
65891 1741394764330 GEN4_TO_CONTROLLER_LOG:GEN4_DEBUG_INT_LOG_PIC24FJ128GL306 Payload End
65891 1741394764330 XXXX 1741394764330, Thread 65891: XXXX 1741394764330, Entering Thread 65891: Commands::runScriptWithUpload, script name = ReadRAM  
65891 1741394764330 XXXX 1741394764330, Thread 65891: XXXX 1741394764330, Entering Thread 65891: ToolCommUsb::readTransfer, sideData is 0x28 bytes long, transferDataLength is 0x2 bytes long  
43 1741394828397 GEN4_CONNECT_DIAGNOSTICS:Calling Update on plug and play observer com.microchip.mplab.mdbcore.RI4Tool.RI4ToolBase$RI4PlugNPlayObserver@6e586484
43 1741394828397 GEN4_CONNECT_DIAGNOSTICS:Entering plug and play Update(). Attached PID = 810b
43 1741394828397 GEN4_CONNECT_DIAGNOSTICS:Entering MPLABCommEvent handler
43 1741394828397 GEN4_CONNECT_DIAGNOSTICS:MPLABCommEvent.pid = 810b
43 1741394828397 GEN4_CONNECT_DIAGNOSTICS:eventType = MPLABCOMM_TOOL_UNPLUGGED
43 1741394828569 GEN4_CONNECT_DIAGNOSTICS:Exiting plug and play Update()
65888 1741394838570 GEN4_CONNECT_DIAGNOSTICS:MPLABCommTool is null
66134 1741394925284 XXXX 1741394925284, Thread 66134: ToolCommUsb::read, com.Received returned -1 
66134 1741394925285 XXXX 1741394925285, Thread 66134: ToolCommUsb::DataReader::run, fatal RI4ControllerException: {null} 
65891 1741394925288 XXXX 1741394925288, Thread 65891: com.Send returned false 

65888 1741394925288 GEN4_TO_CONTROLLER_LOG:GEN4_CONNECT_INT_LOG_PIC24FJ128GL306 Pre:GetFirmwareInfo
65888 1741394925288 GEN4_TO_CONTROLLER_LOG:GEN4_CONNECT_INT_LOG_PIC24FJ128GL306 Payload
65888 1741394925288 GEN4_TO_CONTROLLER_LOG:GEN4_CONNECT_INT_LOG_PIC24FJ128GL306 null
65888 1741394925288 GEN4_TO_CONTROLLER_LOG:GEN4_CONNECT_INT_LOG_PIC24FJ128GL306 Payload End
65888 1741394925288 XXXX 1741394925288, Thread 65888: com.Send returned false 
65888 1741394925288 XXXX 1741394925288, Thread 65888: execCommand: exception after writeSideChanel null 
65888 1741394925288 GEN4_CONNECT_DIAGNOSTICS:Removing plug and play observer com.microchip.mplab.mdbcore.RI4Tool.RI4ToolBase$RI4PlugNPlayObserver@6e586484
65888 1741394925288 GEN4_CONNECT_DIAGNOSTICS:Begin PlugNPlayObservers list dump:
65888 1741394925288 GEN4_CONNECT_DIAGNOSTICS:End PlugNPlayObservers list dump:
