karliedapuzzo/TDWS/TDWS_PIC24_FILES/Test_projects/LoRa_receiver_test.X/queuelogs/debugtool.txt

10680 1736374535199 XXXX 1736374535199, Thread 10680: XXXX 1736374535199, Exiting Thread 10680: Commands::runScriptBasic  
10680 1736374535300 XXXX 1736374535300, Thread 10680: XXXX 1736374535300, Entering Thread 10680: Commands::runScriptBasic, script name = GetHaltStatus, timeOut = -1 ms  
10680 1736374535301 XXXX 1736374535301, Thread 10680: XXXX 1736374535301, Exiting Thread 10680: Commands::runScriptBasic  
10680 1736374535401 XXXX 1736374535401, Thread 10680: XXXX 1736374535401, Entering Thread 10680: Commands::runScriptBasic, script name = GetHaltStatus, timeOut = -1 ms  
10680 1736374535403 XXXX 1736374535403, Thread 10680: XXXX 1736374535403, Exiting Thread 10680: Commands::runScriptBasic  
10680 1736374535503 XXXX 1736374535503, Thread 10680: XXXX 1736374535503, Entering Thread 10680: Commands::runScriptBasic, script name = GetHaltStatus, timeOut = -1 ms  
10680 1736374535503 XXXX 1736374535503, Thread 10680: XXXX 1736374535503, Exiting Thread 10680: Commands::runScriptBasic  
10680 1736374535603 XXXX 1736374535603, Thread 10680: XXXX 1736374535603, Entering Thread 10680: Commands::runScriptBasic, script name = GetHaltStatus, timeOut = -1 ms  
10680 1736374535603 XXXX 1736374535603, Thread 10680: XXXX 1736374535603, Exiting Thread 10680: Commands::runScriptBasic  
10680 1736374535705 XXXX 1736374535705, Thread 10680: XXXX 1736374535705, Entering Thread 10680: Commands::runScriptBasic, script name = GetHaltStatus, timeOut = -1 ms  
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
10680 1736374585390 XXXX 1736374585390, Thread 10680: XXXX 1736374585390, Exiting Thread 10680: Commands::runScriptBasic  
10680 1736374585493 XXXX 1736374585493, Thread 10680: XXXX 1736374585493, Entering Thread 10680: Commands::runScriptBasic, script name = GetHaltStatus, timeOut = -1 ms  
10680 1736374585495 XXXX 1736374585495, Thread 10680: XXXX 1736374585495, Exiting Thread 10680: Commands::runScriptBasic  
10680 1736374585593 XXXX 1736374585593, Thread 10680: XXXX 1736374585593, Entering Thread 10680: Commands::runScriptBasic, script name = GetHaltStatus, timeOut = -1 ms  
10680 1736374585593 XXXX 1736374585593, Thread 10680: XXXX 1736374585593, Exiting Thread 10680: Commands::runScriptBasic  
10680 1736374585694 XXXX 1736374585694, Thread 10680: XXXX 1736374585694, Entering Thread 10680: Commands::runScriptBasic, script name = GetHaltStatus, timeOut = -1 ms  
10680 1736374585694 XXXX 1736374585694, Thread 10680: XXXX 1736374585694, Exiting Thread 10680: Commands::runScriptBasic  
10680 1736374585796 XXXX 1736374585796, Thread 10680: XXXX 1736374585796, Entering Thread 10680: Commands::runScriptBasic, script name = GetHaltStatus, timeOut = -1 ms  
10680 1736374585798 XXXX 1736374585798, Thread 10680: XXXX 1736374585798, Exiting Thread 10680: Commands::runScriptBasic  
10680 1736374585897 XXXX 1736374585897, Thread 10680: XXXX 1736374585897, Entering Thread 10680: Commands::runScriptBasic, script name = GetHaltStatus, timeOut = -1 ms  
10680 1736374585898 XXXX 1736374585898, Thread 10680: XXXX 1736374585898, Exiting Thread 10680: Commands::runScriptBasic  
10680 1736374585998 XXXX 1736374585998, Thread 10680: XXXX 1736374585998, Entering Thread 10680: Commands::runScriptBasic, script name = GetHaltStatus, timeOut = -1 ms  
10680 1736374586001 XXXX 1736374586001, Thread 10680: com.Send returned false 
10680 1736374586002 XXXX 1736374586002, Thread 10680: transfer: exception after writeHeaderAndGetResult null 
10680 1736374586002 XXXX 1736374586002, Thread 10680: XXXX 1736374586002, Entering Thread 10680: ToolCommUsb::recoverFromProtocolError, type = NO_SCRIPT  
10680 1736374586002 XXXX 1736374586002, Thread 10680: Send Abort Script Engine Command 
10680 1736374586002 XXXX 1736374586002, Thread 10680: XXXX 1736374586002, Entering Thread 10680: ToolCommUsb::killScriptEngine  
10680 1736374586002 XXXX 1736374586002, Thread 10680: com.Send returned false 
10680 1736374586002 XXXX 1736374586002, Thread 10680: Failed sending Abort Script Engine Command. Set nuclear option = true 
10680 1736374586002 XXXX 1736374586002, Thread 10680: About to nuke 
10680 1736374586002 XXXX 1736374586002, Thread 10680: XXXX 1736374586002, Entering Thread 10680: ToolCommUsb::nuclearOption  
10680 1736374586004 XXXX 1736374586004, Thread 10680: com.Send returned false
