karliedapuzzo/TDWS/TDWS_PIC24_FILES/Test_projects/radar_TDWS.X/queuelogs/debugtool.txt

299 1741642282776 GEN4_CONNECT_DIAGNOSTICS:Removing plug and play observer com.microchip.mplab.mdbcore.RI4Tool.RI4ToolBase$RI4PlugNPlayObserver@692da397
299 1741642282776 GEN4_CONNECT_DIAGNOSTICS:Begin PlugNPlayObservers list dump:
299 1741642282776 GEN4_CONNECT_DIAGNOSTICS:End PlugNPlayObservers list dump:
299 1741642282837 GEN4_CONNECT_DIAGNOSTICS:Calling RIDbgToolCom.Disconnect
299 1741642282837 GEN4_CONNECT_DIAGNOSTICS:Calling MPLABCommTool.Detach to remove tool from plug and play list
299 1741642282837 GEN4_CONNECT_DIAGNOSTICS:Calling RIDbgToolCom.DisconnectFromMPlabComm
299 1741642282837 GEN4_CONNECT_DIAGNOSTICS:Calling MPLABCommTool.Disconnect
310 1741642314553 GEN4_CONNECT_DIAGNOSTICS:MPLABCommTool is NOT null
310 1741642314553 GEN4_CONNECT_DIAGNOSTICS:AttachedToolPID = 9036, AttachedToolVID = 4d8
310 1741642314553 GEN4_CONNECT_DIAGNOSTICS:transport type = USB
310 1741642314553 GEN4_CONNECT_DIAGNOSTICS:AttachedToolPID = 9036, AttachedToolVID = 4d8
310 1741642314557 com.microchip.mplab.mdbcore.RealICETool.RIDbgToolCom
310 1741642314557 GEN4_CONNECT_DIAGNOSTICS:Before MPLABCommTool.Connect()
310 1741642314559 GEN4_CONNECT_DIAGNOSTICS:After MPLABCommTool.Connect()
310 1741642314559 GEN4_CONNECT_DIAGNOSTICS:MPLABCommTool.Connect() returned MPLABCOMM_NO_ERROR
310 1741642314559 GEN4_CONNECT_DIAGNOSTICS:Attaching to MPLABCommTool plugnplay
310 1741642314559 GEN4_CONNECT_DIAGNOSTICS:Adding new plug and play observer com.microchip.mplab.mdbcore.RI4Tool.RI4ToolBase$RI4PlugNPlayObserver@4bab2744
310 1741642314559 GEN4_CONNECT_DIAGNOSTICS:Begin PlugNPlayObservers list dump:
310 1741642314559 GEN4_CONNECT_DIAGNOSTICS:com.microchip.mplab.mdbcore.RI4Tool.RI4ToolBase$RI4PlugNPlayObserver@4bab2744
310 1741642314559 GEN4_CONNECT_DIAGNOSTICS:End PlugNPlayObservers list dump:
310 1741642314559 GEN4_CONNECT_DIAGNOSTICS:Registering for alternate PNP notifications. CommPnPCriteria.cPIDList = [9035], CommPnPCriteria.cSerialNumber = 020026702ryn038688

310 1741642314731 GEN4_TO_CONTROLLER_LOG:GEN4_INIT_INT_LOG_PIC24FJ128GL306 Pre:init
310 1741642314731 GEN4_TO_CONTROLLER_LOG:GEN4_INIT_INT_LOG_PIC24FJ128GL306 Payload
310 1741642314731 GEN4_TO_CONTROLLER_LOG:GEN4_INIT_INT_LOG_PIC24FJ128GL306 DeviceInfo: Values:
310 1741642314731 GEN4_TO_CONTROLLER_LOG:GEN4_INIT_INT_LOG_PIC24FJ128GL306 DeviceInfo: pcAddress = 0000002e, Vpp = 3.25, useRowEraseIfVoltageIsLow = false, voltageBelowWhichUseRowErase = 0.00, deviceName = PIC24FJ128GL306, programmerType = PIC24FJ
310 1741642314731 GEN4_TO_CONTROLLER_LOG:GEN4_INIT_INT_LOG_PIC24FJ128GL306 DeviceInfo: MemInfo values:
310 1741642314731 GEN4_TO_CONTROLLER_LOG:GEN4_INIT_INT_LOG_PIC24FJ128GL306 DeviceInfo: mask = ffffff, exists = true, startAddr = 00000000, endAddr = 00015eff, rowSize = 0800, rowEraseSize = 0800, addrInc = 0002, widthProgram = 0004
310 1741642314731 GEN4_TO_CONTROLLER_LOG:GEN4_INIT_INT_LOG_PIC24FJ128GL306 DeviceInfo: mask = ffffff, exists = true, startAddr = 00015f00, endAddr = 00015fff, rowSize = 0001, rowEraseSize = 0000, addrInc = 0002, widthProgram = 0004
310 1741642314731 GEN4_TO_CONTROLLER_LOG:GEN4_INIT_INT_LOG_PIC24FJ128GL306 DeviceInfo: mask = 0000, exists = false, startAddr = 00000000, endAddr = 00000000, rowSize = 0000, rowEraseSize = 0000, addrInc = 0000, widthProgram = 0000
310 1741642314731 GEN4_TO_CONTROLLER_LOG:GEN4_INIT_INT_LOG_PIC24FJ128GL306 DeviceInfo: mask = 0000, exists = false, startAddr = 00000000, endAddr = 00000000, rowSize = 0000, rowEraseSize = 0000, addrInc = 0000, widthProgram = 0000
310 1741642314731 GEN4_TO_CONTROLLER_LOG:GEN4_INIT_INT_LOG_PIC24FJ128GL306 DeviceInfo: mask = 0000, exists = false, startAddr = 00000000, endAddr = 00000000, rowSize = 0000, rowEraseSize = 0000, addrInc = 0000, widthProgram = 0000
310 1741642314731 GEN4_TO_CONTROLLER_LOG:GEN4_INIT_INT_LOG_PIC24FJ128GL306 DeviceInfo: mask = ffffff, exists = true, startAddr = 00800000, endAddr = 008017ff, rowSize = 0800, rowEraseSize = 0800, addrInc = 0002, widthProgram = 0004
310 1741642314731 GEN4_TO_CONTROLLER_LOG:GEN4_INIT_INT_LOG_PIC24FJ128GL306 DeviceInfo: mask = 0000, exists = false, startAddr = 00000000, endAddr = 00000000, rowSize = 0000, rowEraseSize = 0000, addrInc = 0002, widthProgram = 0002
310 1741642314731 GEN4_TO_CONTROLLER_LOG:GEN4_INIT_INT_LOG_PIC24FJ128GL306 DeviceInfo: mask = 0000, exists = false, startAddr = 00000000, endAddr = 00000000, rowSize = 0000, rowEraseSize = 0000, addrInc = 0000, widthProgram = 0000
310 1741642314731 GEN4_TO_CONTROLLER_LOG:GEN4_INIT_INT_LOG_PIC24FJ128GL306 DeviceInfo: mask = 0000, exists = false, startAddr = 00000000, endAddr = 00000000, rowSize = 0000, rowEraseSize = 0000, addrInc = 0000, widthProgram = 0000
310 1741642314731 GEN4_TO_CONTROLLER_LOG:GEN4_INIT_INT_LOG_PIC24FJ128GL306 DeviceInfo: mask = 0000, exists = false, startAddr = 00000000, endAddr = 00000000, rowSize = 0000, rowEraseSize = 0000, addrInc = 0000, widthProgram = 0000
310 1741642314731 GEN4_TO_CONTROLLER_LOG:GEN4_INIT_INT_LOG_PIC24FJ128GL306 DeviceInfo: mask = 0000, exists = false, startAddr = 00000000, endAddr = 00000000, rowSize = 0000, rowEraseSize = 0000, addrInc = 0002, widthProgram = 0002
310 1741642314731 GEN4_TO_CONTROLLER_LOG:GEN4_INIT_INT_LOG_PIC24FJ128GL306 DeviceInfo: mask = 0000, exists = false, startAddr = 00000000, endAddr = 00000000, rowSize = 0000, rowEraseSize = 0000, addrInc = 0000, widthProgram = 0000
310 1741642314731 GEN4_TO_CONTROLLER_LOG:GEN4_INIT_INT_LOG_PIC24FJ128GL306 DeviceInfo: mask = 0000, exists = false, startAddr = 00000000, endAddr = 00000000, rowSize = 0000, rowEraseSize = 0000, addrInc = 0000, widthProgram = 0000
310 1741642314731 GEN4_TO_CONTROLLER_LOG:GEN4_INIT_INT_LOG_PIC24FJ128GL306 DeviceInfo: mask = ffffff, exists = true, startAddr = 00801700, endAddr = 008017ff, rowSize = 0001, rowEraseSize = 0000, addrInc = 0002, widthProgram = 0004
310 1741642314731 GEN4_TO_CONTROLLER_LOG:GEN4_INIT_INT_LOG_PIC24FJ128GL306 DeviceInfo: mask = 0000, exists = false, startAddr = 00000000, endAddr = 00000000, rowSize = 0000, rowEraseSize = 0000, addrInc = 0000, widthProgram = 0000
310 1741642314731 GEN4_TO_CONTROLLER_LOG:GEN4_INIT_INT_LOG_PIC24FJ128GL306 DeviceInfo: mask = 0000, exists = false, startAddr = 00000000, endAddr = 00000000, rowSize = 0000, rowEraseSize = 0000, addrInc = 0000, widthProgram = 0000
310 1741642314731 GEN4_TO_CONTROLLER_LOG:GEN4_INIT_INT_LOG_PIC24FJ128GL306 DeviceInfo: mask = 7fffffff, exists = true, startAddr = 00ff0000, endAddr = 00ff0003, rowSize = 0001, rowEraseSize = 0000, addrInc = 0001, widthProgram = 0001
310 1741642314731 GEN4_TO_CONTROLLER_LOG:GEN4_INIT_INT_LOG_PIC24FJ128GL306 DeviceInfo: mask = 0000, exists = false, startAddr = 00000000, endAddr = 00000000, rowSize = 0000, rowEraseSize = 0000, addrInc = 0000, widthProgram = 0000
310 1741642314731 GEN4_TO_CONTROLLER_LOG:GEN4_INIT_INT_LOG_PIC24FJ128GL306 DeviceInfo: mask = 0000, exists = false, startAddr = 00000000, endAddr = 00000000, rowSize = 0000, rowEraseSize = 0000, addrInc = 0000, widthProgram = 0000
310 1741642314731 GEN4_TO_CONTROLLER_LOG:GEN4_INIT_INT_LOG_PIC24FJ128GL306 DeviceInfo: mask = 0000, exists = false, startAddr = 00000000, endAddr = 00000000, rowSize = 0000, rowEraseSize = 0000, addrInc = 0000, widthProgram = 0000
310 1741642314731 GEN4_TO_CONTROLLER_LOG:GEN4_INIT_INT_LOG_PIC24FJ128GL306 DeviceInfo: mask = 0000, exists = false, startAddr = 00000000, endAddr = 00000000, rowSize = 0000, rowEraseSize = 0000, addrInc = 0000, widthProgram = 0000
310 1741642314731 GEN4_TO_CONTROLLER_LOG:GEN4_INIT_INT_LOG_PIC24FJ128GL306 DeviceInfo: mask = 0000, exists = false, startAddr = 00000000, endAddr = 00000000, rowSize = 0000, rowEraseSize = 0000, addrInc = 0000, widthProgram = 0000
310 1741642314731 GEN4_TO_CONTROLLER_LOG:GEN4_INIT_INT_LOG_PIC24FJ128GL306 DeviceInfo: mask = 0000, exists = true, startAddr = 00801600, endAddr = 00801609, rowSize = 0000, rowEraseSize = 0000, addrInc = 0002, widthProgram = 0004
310 1741642314731 GEN4_TO_CONTROLLER_LOG:GEN4_INIT_INT_LOG_PIC24FJ128GL306 DeviceInfo: CfgRequiredBitsMask Values:
310 1741642314731 GEN4_TO_CONTROLLER_LOG:GEN4_INIT_INT_LOG_PIC24FJ128GL306 Address = 00015f00, Mask = 00008fef
310 1741642314731 GEN4_TO_CONTROLLER_LOG:GEN4_INIT_INT_LOG_PIC24FJ128GL306 Address = 00015f10, Mask = 00001fff
310 1741642314731 GEN4_TO_CONTROLLER_LOG:GEN4_INIT_INT_LOG_PIC24FJ128GL306 Address = 00015f14, Mask = 00ff7fff
310 1741642314731 GEN4_TO_CONTROLLER_LOG:GEN4_INIT_INT_LOG_PIC24FJ128GL306 Address = 00015f18, Mask = 000000ff
310 1741642314731 GEN4_TO_CONTROLLER_LOG:GEN4_INIT_INT_LOG_PIC24FJ128GL306 Address = 00015f1c, Mask = 000000ff
310 1741642314731 GEN4_TO_CONTROLLER_LOG:GEN4_INIT_INT_LOG_PIC24FJ128GL306 Address = 00015f20, Mask = 00006bff
310 1741642314731 GEN4_TO_CONTROLLER_LOG:GEN4_INIT_INT_LOG_PIC24FJ128GL306 Address = 00015f24, Mask = 0000000f
310 1741642314731 GEN4_TO_CONTROLLER_LOG:GEN4_INIT_INT_LOG_PIC24FJ128GL306 Address = 00015f28, Mask = 00000003
310 1741642314731 GEN4_TO_CONTROLLER_LOG:GEN4_INIT_INT_LOG_PIC24FJ128GL306 Address = 00015f2c, Mask = 0000ffff
310 1741642314731 GEN4_TO_CONTROLLER_LOG:GEN4_INIT_INT_LOG_PIC24FJ128GL306 Address = 00015f30, Mask = 0000ffff
310 1741642314731 GEN4_TO_CONTROLLER_LOG:GEN4_INIT_INT_LOG_PIC24FJ128GL306 Address = 00015f34, Mask = 0000ffff
310 1741642314731 GEN4_TO_CONTROLLER_LOG:GEN4_INIT_INT_LOG_PIC24FJ128GL306 Address = 00015f38, Mask = 0000ffff
310 1741642314731 GEN4_TO_CONTROLLER_LOG:GEN4_INIT_INT_LOG_PIC24FJ128GL306 Address = 00015f3c, Mask = 00000001
310 1741642314731 GEN4_TO_CONTROLLER_LOG:GEN4_INIT_INT_LOG_PIC24FJ128GL306 Address = 00015f40, Mask = 0000041e
310 1741642314731 GEN4_TO_CONTROLLER_LOG:GEN4_INIT_INT_LOG_PIC24FJ128GL306 BasicInfo: Values:
310 1741642314731 GEN4_TO_CONTROLLER_LOG:GEN4_INIT_INT_LOG_PIC24FJ128GL306 BasicInfo: InputStream = com.microchip.mplab.libs.toolpacksupport.EquatableFileInputStream@a3c86b5, ToolFlavor = PIC32C
310 1741642314731 GEN4_TO_CONTROLLER_LOG:GEN4_INIT_INT_LOG_PIC24FJ128GL306 Payload End
310 1741642314732 GEN4_TO_CONTROLLER_LOG:GEN4_INIT_INT_LOG_PIC24FJ128GL306 Post:init
310 1741642314732 GEN4_TO_CONTROLLER_LOG:GEN4_INIT_INT_LOG_PIC24FJ128GL306 Return Value
310 1741642314732 GEN4_TO_CONTROLLER_LOG:GEN4_INIT_INT_LOG_PIC24FJ128GL306 none
310 1741642314732 GEN4_TO_CONTROLLER_LOG:GEN4_INIT_INT_LOG_PIC24FJ128GL306 Return End

310 1741642314733 GEN4_TO_CONTROLLER_LOG:GEN4_INIT_INT_LOG_PIC24FJ128GL306 Pre:GetInterfaceProvider
310 1741642314733 GEN4_TO_CONTROLLER_LOG:GEN4_INIT_INT_LOG_PIC24FJ128GL306 Payload
310 1741642314733 GEN4_TO_CONTROLLER_LOG:GEN4_INIT_INT_LOG_PIC24FJ128GL306 RI4DebugInterface
310 1741642314733 GEN4_TO_CONTROLLER_LOG:GEN4_INIT_INT_LOG_PIC24FJ128GL306 Payload End
310 1741642314733 GEN4_TO_CONTROLLER_LOG:GEN4_INIT_INT_LOG_PIC24FJ128GL306 Post:GetInterfaceProvider
310 1741642314733 GEN4_TO_CONTROLLER_LOG:GEN4_INIT_INT_LOG_PIC24FJ128GL306 Return Value
310 1741642314733 GEN4_TO_CONTROLLER_LOG:GEN4_INIT_INT_LOG_PIC24FJ128GL306 com.microchip.mplab.libs.RI4ToolsController.implementations.RI4DebugInterfaceImpl@c0d4d40
310 1741642314733 GEN4_TO_CONTROLLER_LOG:GEN4_INIT_INT_LOG_PIC24FJ128GL306 Return End

310 1741642314733 GEN4_TO_CONTROLLER_LOG:GEN4_INIT_INT_LOG_PIC24FJ128GL306 Pre:GetInterfaceProvider
310 1741642314733 GEN4_TO_CONTROLLER_LOG:GEN4_INIT_INT_LOG_PIC24FJ128GL306 Payload
310 1741642314733 GEN4_TO_CONTROLLER_LOG:GEN4_INIT_INT_LOG_PIC24FJ128GL306 RI4ProgramInterface
310 1741642314733 GEN4_TO_CONTROLLER_LOG:GEN4_INIT_INT_LOG_PIC24FJ128GL306 Payload End
310 1741642314733 GEN4_TO_CONTROLLER_LOG:GEN4_INIT_INT_LOG_PIC24FJ128GL306 Post:GetInterfaceProvider
310 1741642314733 GEN4_TO_CONTROLLER_LOG:GEN4_INIT_INT_LOG_PIC24FJ128GL306 Return Value
310 1741642314733 GEN4_TO_CONTROLLER_LOG:GEN4_INIT_INT_LOG_PIC24FJ128GL306 com.microchip.mplab.libs.RI4ToolsController.implementations.RI4ProgramInterfaceImpl@5de615b1
310 1741642314733 GEN4_TO_CONTROLLER_LOG:GEN4_INIT_INT_LOG_PIC24FJ128GL306 Return End

310 1741642314734 GEN4_TO_CONTROLLER_LOG:GEN4_INIT_INT_LOG_PIC24FJ128GL306 Pre:GetInterfaceProvider
310 1741642314734 GEN4_TO_CONTROLLER_LOG:GEN4_INIT_INT_LOG_PIC24FJ128GL306 Payload
310 1741642314734 GEN4_TO_CONTROLLER_LOG:GEN4_INIT_INT_LOG_PIC24FJ128GL306 RI4ConnectInterface
310 1741642314734 GEN4_TO_CONTROLLER_LOG:GEN4_INIT_INT_LOG_PIC24FJ128GL306 Payload End
310 1741642314734 GEN4_TO_CONTROLLER_LOG:GEN4_INIT_INT_LOG_PIC24FJ128GL306 Post:GetInterfaceProvider
310 1741642314734 GEN4_TO_CONTROLLER_LOG:GEN4_INIT_INT_LOG_PIC24FJ128GL306 Return Value
310 1741642314734 GEN4_TO_CONTROLLER_LOG:GEN4_INIT_INT_LOG_PIC24FJ128GL306 com.microchip.mplab.libs.PK4ToolsController.PK4ConnectInterfaceImpl@4fe5984e
310 1741642314734 GEN4_TO_CONTROLLER_LOG:GEN4_INIT_INT_LOG_PIC24FJ128GL306 Return End

310 1741642314734 GEN4_TO_CONTROLLER_LOG:GEN4_INIT_INT_LOG_PIC24FJ128GL306 Pre:GetInterfaceProvider
310 1741642314734 GEN4_TO_CONTROLLER_LOG:GEN4_INIT_INT_LOG_PIC24FJ128GL306 Payload
310 1741642314734 GEN4_TO_CONTROLLER_LOG:GEN4_INIT_INT_LOG_PIC24FJ128GL306 RI4ControllerDiagnosticsInterface
310 1741642314734 GEN4_TO_CONTROLLER_LOG:GEN4_INIT_INT_LOG_PIC24FJ128GL306 Payload End
310 1741642314734 GEN4_TO_CONTROLLER_LOG:GEN4_INIT_INT_LOG_PIC24FJ128GL306 Post:GetInterfaceProvider
310 1741642314734 GEN4_TO_CONTROLLER_LOG:GEN4_INIT_INT_LOG_PIC24FJ128GL306 Return Value
310 1741642314734 GEN4_TO_CONTROLLER_LOG:GEN4_INIT_INT_LOG_PIC24FJ128GL306 com.microchip.mplab.libs.RI4ToolsController.implementations.RI4ControllerDiagnosticsInterfaceImpl@34ec5647
310 1741642314734 GEN4_TO_CONTROLLER_LOG:GEN4_INIT_INT_LOG_PIC24FJ128GL306 Return End

310 1741642314734 GEN4_TO_CONTROLLER_LOG:GEN4_INIT_INT_LOG_PIC24FJ128GL306 Pre:GetInterfaceProvider
310 1741642314734 GEN4_TO_CONTROLLER_LOG:GEN4_INIT_INT_LOG_PIC24FJ128GL306 Payload
310 1741642314734 GEN4_TO_CONTROLLER_LOG:GEN4_INIT_INT_LOG_PIC24FJ128GL306 ProgrammerToGo
310 1741642314734 GEN4_TO_CONTROLLER_LOG:GEN4_INIT_INT_LOG_PIC24FJ128GL306 Payload End
310 1741642314734 GEN4_TO_CONTROLLER_LOG:GEN4_INIT_INT_LOG_PIC24FJ128GL306 Post:GetInterfaceProvider
310 1741642314734 GEN4_TO_CONTROLLER_LOG:GEN4_INIT_INT_LOG_PIC24FJ128GL306 Return Value
310 1741642314734 GEN4_TO_CONTROLLER_LOG:GEN4_INIT_INT_LOG_PIC24FJ128GL306 com.microchip.mplab.libs.RI4ToolsController.implementations.ProgrammerToGoImpl@52ed7ad7
310 1741642314734 GEN4_TO_CONTROLLER_LOG:GEN4_INIT_INT_LOG_PIC24FJ128GL306 Return End

310 1741642314734 GEN4_TO_CONTROLLER_LOG:GEN4_INIT_INT_LOG_PIC24FJ128GL306 Pre:GetInterfaceProvider
310 1741642314734 GEN4_TO_CONTROLLER_LOG:GEN4_INIT_INT_LOG_PIC24FJ128GL306 Payload
310 1741642314734 GEN4_TO_CONTROLLER_LOG:GEN4_INIT_INT_LOG_PIC24FJ128GL306 Status
310 1741642314734 GEN4_TO_CONTROLLER_LOG:GEN4_INIT_INT_LOG_PIC24FJ128GL306 Payload End
310 1741642314734 GEN4_TO_CONTROLLER_LOG:GEN4_INIT_INT_LOG_PIC24FJ128GL306 Post:GetInterfaceProvider
310 1741642314734 GEN4_TO_CONTROLLER_LOG:GEN4_INIT_INT_LOG_PIC24FJ128GL306 Return Value
310 1741642314734 GEN4_TO_CONTROLLER_LOG:GEN4_INIT_INT_LOG_PIC24FJ128GL306 null
310 1741642314734 GEN4_TO_CONTROLLER_LOG:GEN4_INIT_INT_LOG_PIC24FJ128GL306 Return End

310 1741642314742 GEN4_TO_CONTROLLER_LOG:GEN4_PROGRAM_INT_LOG_PIC24FJ128GL306 Pre:SetProgramExec
310 1741642314742 GEN4_TO_CONTROLLER_LOG:GEN4_PROGRAM_INT_LOG_PIC24FJ128GL306 Payload
310 1741642314742 GEN4_TO_CONTROLLER_LOG:GEN4_PROGRAM_INT_LOG_PIC24FJ128GL306 Test
310 1741642314742 GEN4_TO_CONTROLLER_LOG:GEN4_PROGRAM_INT_LOG_PIC24FJ128GL306 800000
310 1741642314742 GEN4_TO_CONTROLLER_LOG:GEN4_PROGRAM_INT_LOG_PIC24FJ128GL306 Length = 3108
310 1741642314742 GEN4_TO_CONTROLLER_LOG:GEN4_PROGRAM_INT_LOG_PIC24FJ128GL306 Payload End
310 1741642314742 GEN4_TO_CONTROLLER_LOG:GEN4_PROGRAM_INT_LOG_PIC24FJ128GL306 Post:SetProgramExec
310 1741642314742 GEN4_TO_CONTROLLER_LOG:GEN4_PROGRAM_INT_LOG_PIC24FJ128GL306 Return Value
310 1741642314742 GEN4_TO_CONTROLLER_LOG:GEN4_PROGRAM_INT_LOG_PIC24FJ128GL306 true
310 1741642314742 GEN4_TO_CONTROLLER_LOG:GEN4_PROGRAM_INT_LOG_PIC24FJ128GL306 Return End

310 1741642314746 GEN4_TO_CONTROLLER_LOG:GEN4_PROGRAM_INT_LOG_PIC24FJ128GL306 Pre:SetDebugExec
310 1741642314746 GEN4_TO_CONTROLLER_LOG:GEN4_PROGRAM_INT_LOG_PIC24FJ128GL306 Payload
310 1741642314746 GEN4_TO_CONTROLLER_LOG:GEN4_PROGRAM_INT_LOG_PIC24FJ128GL306 Test
310 1741642314746 GEN4_TO_CONTROLLER_LOG:GEN4_PROGRAM_INT_LOG_PIC24FJ128GL306 800000
310 1741642314746 GEN4_TO_CONTROLLER_LOG:GEN4_PROGRAM_INT_LOG_PIC24FJ128GL306 Length = 2640
310 1741642314746 GEN4_TO_CONTROLLER_LOG:GEN4_PROGRAM_INT_LOG_PIC24FJ128GL306 Payload End
310 1741642314747 GEN4_TO_CONTROLLER_LOG:GEN4_PROGRAM_INT_LOG_PIC24FJ128GL306 Post:SetDebugExec
310 1741642314747 GEN4_TO_CONTROLLER_LOG:GEN4_PROGRAM_INT_LOG_PIC24FJ128GL306 Return Value
310 1741642314747 GEN4_TO_CONTROLLER_LOG:GEN4_PROGRAM_INT_LOG_PIC24FJ128GL306 true
310 1741642314747 GEN4_TO_CONTROLLER_LOG:GEN4_PROGRAM_INT_LOG_PIC24FJ128GL306 Return End

310 1741642314747 GEN4_TO_CONTROLLER_LOG:GEN4_CONNECT_INT_LOG_PIC24FJ128GL306 Pre:EstablishCommunincations
310 1741642314747 GEN4_TO_CONTROLLER_LOG:GEN4_CONNECT_INT_LOG_PIC24FJ128GL306 Payload
310 1741642314747 GEN4_TO_CONTROLLER_LOG:GEN4_CONNECT_INT_LOG_PIC24FJ128GL306 com.microchip.mplab.mdbcore.PK5Tool.PK5Com@1ae51053
310 1741642314747 GEN4_TO_CONTROLLER_LOG:GEN4_CONNECT_INT_LOG_PIC24FJ128GL306 Payload End
310 1741642314748 GEN4_TO_CONTROLLER_LOG:GEN4_CONNECT_INT_LOG_PIC24FJ128GL306 Post:EstablishCommunincations
310 1741642314748 GEN4_TO_CONTROLLER_LOG:GEN4_CONNECT_INT_LOG_PIC24FJ128GL306 Return Value
310 1741642314748 GEN4_TO_CONTROLLER_LOG:GEN4_CONNECT_INT_LOG_PIC24FJ128GL306 true
310 1741642314748 GEN4_TO_CONTROLLER_LOG:GEN4_CONNECT_INT_LOG_PIC24FJ128GL306 Return End

310 1741642314748 GEN4_TO_CONTROLLER_LOG:GEN4_CONNECT_INT_LOG_PIC24FJ128GL306 Pre:GetFirmwareInfo
310 1741642314748 GEN4_TO_CONTROLLER_LOG:GEN4_CONNECT_INT_LOG_PIC24FJ128GL306 Payload
310 1741642314748 GEN4_TO_CONTROLLER_LOG:GEN4_CONNECT_INT_LOG_PIC24FJ128GL306 null
310 1741642314748 GEN4_TO_CONTROLLER_LOG:GEN4_CONNECT_INT_LOG_PIC24FJ128GL306 Payload End
310 1741642314749 GEN4_CONNECT_DIAGNOSTICS:MPLABCommTool is null

310 1741642314749 GEN4_TO_CONTROLLER_LOG:GEN4_CONNECT_INT_LOG_PIC24FJ128GL306 Pre:GetFirmwareInfo
310 1741642314749 GEN4_TO_CONTROLLER_LOG:GEN4_CONNECT_INT_LOG_PIC24FJ128GL306 Payload
310 1741642314749 GEN4_TO_CONTROLLER_LOG:GEN4_CONNECT_INT_LOG_PIC24FJ128GL306 null
310 1741642314749 GEN4_TO_CONTROLLER_LOG:GEN4_CONNECT_INT_LOG_PIC24FJ128GL306 Payload End
310 1741642314752 GEN4_CONNECT_DIAGNOSTICS:Removing plug and play observer com.microchip.mplab.mdbcore.RI4Tool.RI4ToolBase$RI4PlugNPlayObserver@4bab2744
310 1741642314752 GEN4_CONNECT_DIAGNOSTICS:Begin PlugNPlayObservers list dump:
310 1741642314752 GEN4_CONNECT_DIAGNOSTICS:End PlugNPlayObservers list dump:
310 1741642314806 GEN4_CONNECT_DIAGNOSTICS:Calling RIDbgToolCom.Disconnect
310 1741642314806 GEN4_CONNECT_DIAGNOSTICS:Calling MPLABCommTool.Detach to remove tool from plug and play list
310 1741642314806 GEN4_CONNECT_DIAGNOSTICS:Calling RIDbgToolCom.DisconnectFromMPlabComm
310 1741642314806 GEN4_CONNECT_DIAGNOSTICS:Calling MPLABCommTool.Disconnect
465 1741642346235 GEN4_CONNECT_DIAGNOSTICS:MPLABCommTool is NOT null
465 1741642346235 GEN4_CONNECT_DIAGNOSTICS:AttachedToolPID = 9036, AttachedToolVID = 4d8
465 1741642346235 GEN4_CONNECT_DIAGNOSTICS:transport type = USB
465 1741642346235 GEN4_CONNECT_DIAGNOSTICS:AttachedToolPID = 9036, AttachedToolVID = 4d8
465 1741642346237 com.microchip.mplab.mdbcore.RealICETool.RIDbgToolCom
465 1741642346237 GEN4_CONNECT_DIAGNOSTICS:Before MPLABCommTool.Connect()
465 1741642346239 GEN4_CONNECT_DIAGNOSTICS:After MPLABCommTool.Connect()
465 1741642346239 GEN4_CONNECT_DIAGNOSTICS:MPLABCommTool.Connect() returned MPLABCOMM_NO_ERROR
465 1741642346239 GEN4_CONNECT_DIAGNOSTICS:Attaching to MPLABCommTool plugnplay
465 1741642346239 GEN4_CONNECT_DIAGNOSTICS:Adding new plug and play observer com.microchip.mplab.mdbcore.RI4Tool.RI4ToolBase$RI4PlugNPlayObserver@1521f9bf
465 1741642346239 GEN4_CONNECT_DIAGNOSTICS:Begin PlugNPlayObservers list dump:
465 1741642346239 GEN4_CONNECT_DIAGNOSTICS:com.microchip.mplab.mdbcore.RI4Tool.RI4ToolBase$RI4PlugNPlayObserver@1521f9bf
465 1741642346239 GEN4_CONNECT_DIAGNOSTICS:End PlugNPlayObservers list dump:
465 1741642346239 GEN4_CONNECT_DIAGNOSTICS:Registering for alternate PNP notifications. CommPnPCriteria.cPIDList = [9035], CommPnPCriteria.cSerialNumber = 020026702ryn038688

465 1741642346311 GEN4_TO_CONTROLLER_LOG:GEN4_INIT_INT_LOG_PIC24FJ128GL306 Pre:init
465 1741642346311 GEN4_TO_CONTROLLER_LOG:GEN4_INIT_INT_LOG_PIC24FJ128GL306 Payload
465 1741642346311 GEN4_TO_CONTROLLER_LOG:GEN4_INIT_INT_LOG_PIC24FJ128GL306 DeviceInfo: Values:
465 1741642346311 GEN4_TO_CONTROLLER_LOG:GEN4_INIT_INT_LOG_PIC24FJ128GL306 DeviceInfo: pcAddress = 0000002e, Vpp = 3.25, useRowEraseIfVoltageIsLow = false, voltageBelowWhichUseRowErase = 0.00, deviceName = PIC24FJ128GL306, programmerType = PIC24FJ
465 1741642346311 GEN4_TO_CONTROLLER_LOG:GEN4_INIT_INT_LOG_PIC24FJ128GL306 DeviceInfo: MemInfo values:
465 1741642346311 GEN4_TO_CONTROLLER_LOG:GEN4_INIT_INT_LOG_PIC24FJ128GL306 DeviceInfo: mask = ffffff, exists = true, startAddr = 00000000, endAddr = 00015eff, rowSize = 0800, rowEraseSize = 0800, addrInc = 0002, widthProgram = 0004
465 1741642346311 GEN4_TO_CONTROLLER_LOG:GEN4_INIT_INT_LOG_PIC24FJ128GL306 DeviceInfo: mask = ffffff, exists = true, startAddr = 00015f00, endAddr = 00015fff, rowSize = 0001, rowEraseSize = 0000, addrInc = 0002, widthProgram = 0004
465 1741642346311 GEN4_TO_CONTROLLER_LOG:GEN4_INIT_INT_LOG_PIC24FJ128GL306 DeviceInfo: mask = 0000, exists = false, startAddr = 00000000, endAddr = 00000000, rowSize = 0000, rowEraseSize = 0000, addrInc = 0000, widthProgram = 0000
465 1741642346311 GEN4_TO_CONTROLLER_LOG:GEN4_INIT_INT_LOG_PIC24FJ128GL306 DeviceInfo: mask = 0000, exists = false, startAddr = 00000000, endAddr = 00000000, rowSize = 0000, rowEraseSize = 0000, addrInc = 0000, widthProgram = 0000
465 1741642346311 GEN4_TO_CONTROLLER_LOG:GEN4_INIT_INT_LOG_PIC24FJ128GL306 DeviceInfo: mask = 0000, exists = false, startAddr = 00000000, endAddr = 00000000, rowSize = 0000, rowEraseSize = 0000, addrInc = 0000, widthProgram = 0000
465 1741642346312 GEN4_TO_CONTROLLER_LOG:GEN4_INIT_INT_LOG_PIC24FJ128GL306 DeviceInfo: mask = ffffff, exists = true, startAddr = 00800000, endAddr = 008017ff, rowSize = 0800, rowEraseSize = 0800, addrInc = 0002, widthProgram = 0004
465 1741642346312 GEN4_TO_CONTROLLER_LOG:GEN4_INIT_INT_LOG_PIC24FJ128GL306 DeviceInfo: mask = 0000, exists = false, startAddr = 00000000, endAddr = 00000000, rowSize = 0000, rowEraseSize = 0000, addrInc = 0002, widthProgram = 0002
465 1741642346312 GEN4_TO_CONTROLLER_LOG:GEN4_INIT_INT_LOG_PIC24FJ128GL306 DeviceInfo: mask = 0000, exists = false, startAddr = 00000000, endAddr = 00000000, rowSize = 0000, rowEraseSize = 0000, addrInc = 0000, widthProgram = 0000
465 1741642346312 GEN4_TO_CONTROLLER_LOG:GEN4_INIT_INT_LOG_PIC24FJ128GL306 DeviceInfo: mask = 0000, exists = false, startAddr = 00000000, endAddr = 00000000, rowSize = 0000, rowEraseSize = 0000, addrInc = 0000, widthProgram = 0000
465 1741642346312 GEN4_TO_CONTROLLER_LOG:GEN4_INIT_INT_LOG_PIC24FJ128GL306 DeviceInfo: mask = 0000, exists = false, startAddr = 00000000, endAddr = 00000000, rowSize = 0000, rowEraseSize = 0000, addrInc = 0000, widthProgram = 0000
465 1741642346312 GEN4_TO_CONTROLLER_LOG:GEN4_INIT_INT_LOG_PIC24FJ128GL306 DeviceInfo: mask = 0000, exists = false, startAddr = 00000000, endAddr = 00000000, rowSize = 0000, rowEraseSize = 0000, addrInc = 0002, widthProgram = 0002
465 1741642346312 GEN4_TO_CONTROLLER_LOG:GEN4_INIT_INT_LOG_PIC24FJ128GL306 DeviceInfo: mask = 0000, exists = false, startAddr = 00000000, endAddr = 00000000, rowSize = 0000, rowEraseSize = 0000, addrInc = 0000, widthProgram = 0000
465 1741642346312 GEN4_TO_CONTROLLER_LOG:GEN4_INIT_INT_LOG_PIC24FJ128GL306 DeviceInfo: mask = 0000, exists = false, startAddr = 00000000, endAddr = 00000000, rowSize = 0000, rowEraseSize = 0000, addrInc = 0000, widthProgram = 0000
465 1741642346312 GEN4_TO_CONTROLLER_LOG:GEN4_INIT_INT_LOG_PIC24FJ128GL306 DeviceInfo: mask = ffffff, exists = true, startAddr = 00801700, endAddr = 008017ff, rowSize = 0001, rowEraseSize = 0000, addrInc = 0002, widthProgram = 0004
465 1741642346312 GEN4_TO_CONTROLLER_LOG:GEN4_INIT_INT_LOG_PIC24FJ128GL306 DeviceInfo: mask = 0000, exists = false, startAddr = 00000000, endAddr = 00000000, rowSize = 0000, rowEraseSize = 0000, addrInc = 0000, widthProgram = 0000
465 1741642346312 GEN4_TO_CONTROLLER_LOG:GEN4_INIT_INT_LOG_PIC24FJ128GL306 DeviceInfo: mask = 0000, exists = false, startAddr = 00000000, endAddr = 00000000, rowSize = 0000, rowEraseSize = 0000, addrInc = 0000, widthProgram = 0000
465 1741642346312 GEN4_TO_CONTROLLER_LOG:GEN4_INIT_INT_LOG_PIC24FJ128GL306 DeviceInfo: mask = 7fffffff, exists = true, startAddr = 00ff0000, endAddr = 00ff0003, rowSize = 0001, rowEraseSize = 0000, addrInc = 0001, widthProgram = 0001
465 1741642346312 GEN4_TO_CONTROLLER_LOG:GEN4_INIT_INT_LOG_PIC24FJ128GL306 DeviceInfo: mask = 0000, exists = false, startAddr = 00000000, endAddr = 00000000, rowSize = 0000, rowEraseSize = 0000, addrInc = 0000, widthProgram = 0000
465 1741642346312 GEN4_TO_CONTROLLER_LOG:GEN4_INIT_INT_LOG_PIC24FJ128GL306 DeviceInfo: mask = 0000, exists = false, startAddr = 00000000, endAddr = 00000000, rowSize = 0000, rowEraseSize = 0000, addrInc = 0000, widthProgram = 0000
465 1741642346312 GEN4_TO_CONTROLLER_LOG:GEN4_INIT_INT_LOG_PIC24FJ128GL306 DeviceInfo: mask = 0000, exists = false, startAddr = 00000000, endAddr = 00000000, rowSize = 0000, rowEraseSize = 0000, addrInc = 0000, widthProgram = 0000
465 1741642346312 GEN4_TO_CONTROLLER_LOG:GEN4_INIT_INT_LOG_PIC24FJ128GL306 DeviceInfo: mask = 0000, exists = false, startAddr = 00000000, endAddr = 00000000, rowSize = 0000, rowEraseSize = 0000, addrInc = 0000, widthProgram = 0000
465 1741642346312 GEN4_TO_CONTROLLER_LOG:GEN4_INIT_INT_LOG_PIC24FJ128GL306 DeviceInfo: mask = 0000, exists = false, startAddr = 00000000, endAddr = 00000000, rowSize = 0000, rowEraseSize = 0000, addrInc = 0000, widthProgram = 0000
465 1741642346312 GEN4_TO_CONTROLLER_LOG:GEN4_INIT_INT_LOG_PIC24FJ128GL306 DeviceInfo: mask = 0000, exists = true, startAddr = 00801600, endAddr = 00801609, rowSize = 0000, rowEraseSize = 0000, addrInc = 0002, widthProgram = 0004
465 1741642346312 GEN4_TO_CONTROLLER_LOG:GEN4_INIT_INT_LOG_PIC24FJ128GL306 DeviceInfo: CfgRequiredBitsMask Values:
465 1741642346312 GEN4_TO_CONTROLLER_LOG:GEN4_INIT_INT_LOG_PIC24FJ128GL306 Address = 00015f00, Mask = 00008fef
465 1741642346312 GEN4_TO_CONTROLLER_LOG:GEN4_INIT_INT_LOG_PIC24FJ128GL306 Address = 00015f10, Mask = 00001fff
465 1741642346312 GEN4_TO_CONTROLLER_LOG:GEN4_INIT_INT_LOG_PIC24FJ128GL306 Address = 00015f14, Mask = 00ff7fff
465 1741642346312 GEN4_TO_CONTROLLER_LOG:GEN4_INIT_INT_LOG_PIC24FJ128GL306 Address = 00015f18, Mask = 000000ff
465 1741642346312 GEN4_TO_CONTROLLER_LOG:GEN4_INIT_INT_LOG_PIC24FJ128GL306 Address = 00015f1c, Mask = 000000ff
465 1741642346312 GEN4_TO_CONTROLLER_LOG:GEN4_INIT_INT_LOG_PIC24FJ128GL306 Address = 00015f20, Mask = 00006bff
465 1741642346312 GEN4_TO_CONTROLLER_LOG:GEN4_INIT_INT_LOG_PIC24FJ128GL306 Address = 00015f24, Mask = 0000000f
465 1741642346312 GEN4_TO_CONTROLLER_LOG:GEN4_INIT_INT_LOG_PIC24FJ128GL306 Address = 00015f28, Mask = 00000003
465 1741642346312 GEN4_TO_CONTROLLER_LOG:GEN4_INIT_INT_LOG_PIC24FJ128GL306 Address = 00015f2c, Mask = 0000ffff
465 1741642346312 GEN4_TO_CONTROLLER_LOG:GEN4_INIT_INT_LOG_PIC24FJ128GL306 Address = 00015f30, Mask = 0000ffff
465 1741642346312 GEN4_TO_CONTROLLER_LOG:GEN4_INIT_INT_LOG_PIC24FJ128GL306 Address = 00015f34, Mask = 0000ffff
465 1741642346312 GEN4_TO_CONTROLLER_LOG:GEN4_INIT_INT_LOG_PIC24FJ128GL306 Address = 00015f38, Mask = 0000ffff
465 1741642346312 GEN4_TO_CONTROLLER_LOG:GEN4_INIT_INT_LOG_PIC24FJ128GL306 Address = 00015f3c, Mask = 00000001
465 1741642346312 GEN4_TO_CONTROLLER_LOG:GEN4_INIT_INT_LOG_PIC24FJ128GL306 Address = 00015f40, Mask = 0000041e
465 1741642346312 GEN4_TO_CONTROLLER_LOG:GEN4_INIT_INT_LOG_PIC24FJ128GL306 BasicInfo: Values:
465 1741642346312 GEN4_TO_CONTROLLER_LOG:GEN4_INIT_INT_LOG_PIC24FJ128GL306 BasicInfo: InputStream = com.microchip.mplab.libs.toolpacksupport.EquatableFileInputStream@a3c86b5, ToolFlavor = PIC32C
465 1741642346312 GEN4_TO_CONTROLLER_LOG:GEN4_INIT_INT_LOG_PIC24FJ128GL306 Payload End
465 1741642346312 GEN4_TO_CONTROLLER_LOG:GEN4_INIT_INT_LOG_PIC24FJ128GL306 Post:init
465 1741642346312 GEN4_TO_CONTROLLER_LOG:GEN4_INIT_INT_LOG_PIC24FJ128GL306 Return Value
465 1741642346312 GEN4_TO_CONTROLLER_LOG:GEN4_INIT_INT_LOG_PIC24FJ128GL306 none
465 1741642346312 GEN4_TO_CONTROLLER_LOG:GEN4_INIT_INT_LOG_PIC24FJ128GL306 Return End

465 1741642346312 GEN4_TO_CONTROLLER_LOG:GEN4_INIT_INT_LOG_PIC24FJ128GL306 Pre:GetInterfaceProvider
465 1741642346312 GEN4_TO_CONTROLLER_LOG:GEN4_INIT_INT_LOG_PIC24FJ128GL306 Payload
465 1741642346312 GEN4_TO_CONTROLLER_LOG:GEN4_INIT_INT_LOG_PIC24FJ128GL306 RI4DebugInterface
465 1741642346312 GEN4_TO_CONTROLLER_LOG:GEN4_INIT_INT_LOG_PIC24FJ128GL306 Payload End
465 1741642346312 GEN4_TO_CONTROLLER_LOG:GEN4_INIT_INT_LOG_PIC24FJ128GL306 Post:GetInterfaceProvider
465 1741642346312 GEN4_TO_CONTROLLER_LOG:GEN4_INIT_INT_LOG_PIC24FJ128GL306 Return Value
465 1741642346312 GEN4_TO_CONTROLLER_LOG:GEN4_INIT_INT_LOG_PIC24FJ128GL306 com.microchip.mplab.libs.RI4ToolsController.implementations.RI4DebugInterfaceImpl@2eb19861
465 1741642346312 GEN4_TO_CONTROLLER_LOG:GEN4_INIT_INT_LOG_PIC24FJ128GL306 Return End

465 1741642346313 GEN4_TO_CONTROLLER_LOG:GEN4_INIT_INT_LOG_PIC24FJ128GL306 Pre:GetInterfaceProvider
465 1741642346313 GEN4_TO_CONTROLLER_LOG:GEN4_INIT_INT_LOG_PIC24FJ128GL306 Payload
465 1741642346313 GEN4_TO_CONTROLLER_LOG:GEN4_INIT_INT_LOG_PIC24FJ128GL306 RI4ProgramInterface
465 1741642346313 GEN4_TO_CONTROLLER_LOG:GEN4_INIT_INT_LOG_PIC24FJ128GL306 Payload End
465 1741642346313 GEN4_TO_CONTROLLER_LOG:GEN4_INIT_INT_LOG_PIC24FJ128GL306 Post:GetInterfaceProvider
465 1741642346313 GEN4_TO_CONTROLLER_LOG:GEN4_INIT_INT_LOG_PIC24FJ128GL306 Return Value
465 1741642346313 GEN4_TO_CONTROLLER_LOG:GEN4_INIT_INT_LOG_PIC24FJ128GL306 com.microchip.mplab.libs.RI4ToolsController.implementations.RI4ProgramInterfaceImpl@72bec2e4
465 1741642346313 GEN4_TO_CONTROLLER_LOG:GEN4_INIT_INT_LOG_PIC24FJ128GL306 Return End

465 1741642346315 GEN4_TO_CONTROLLER_LOG:GEN4_INIT_INT_LOG_PIC24FJ128GL306 Pre:GetInterfaceProvider
465 1741642346315 GEN4_TO_CONTROLLER_LOG:GEN4_INIT_INT_LOG_PIC24FJ128GL306 Payload
465 1741642346315 GEN4_TO_CONTROLLER_LOG:GEN4_INIT_INT_LOG_PIC24FJ128GL306 RI4ConnectInterface
465 1741642346315 GEN4_TO_CONTROLLER_LOG:GEN4_INIT_INT_LOG_PIC24FJ128GL306 Payload End
465 1741642346315 GEN4_TO_CONTROLLER_LOG:GEN4_INIT_INT_LOG_PIC24FJ128GL306 Post:GetInterfaceProvider
465 1741642346315 GEN4_TO_CONTROLLER_LOG:GEN4_INIT_INT_LOG_PIC24FJ128GL306 Return Value
465 1741642346315 GEN4_TO_CONTROLLER_LOG:GEN4_INIT_INT_LOG_PIC24FJ128GL306 com.microchip.mplab.libs.PK4ToolsController.PK4ConnectInterfaceImpl@6848310d
465 1741642346315 GEN4_TO_CONTROLLER_LOG:GEN4_INIT_INT_LOG_PIC24FJ128GL306 Return End

465 1741642346315 GEN4_TO_CONTROLLER_LOG:GEN4_INIT_INT_LOG_PIC24FJ128GL306 Pre:GetInterfaceProvider
465 1741642346315 GEN4_TO_CONTROLLER_LOG:GEN4_INIT_INT_LOG_PIC24FJ128GL306 Payload
465 1741642346315 GEN4_TO_CONTROLLER_LOG:GEN4_INIT_INT_LOG_PIC24FJ128GL306 RI4ControllerDiagnosticsInterface
465 1741642346315 GEN4_TO_CONTROLLER_LOG:GEN4_INIT_INT_LOG_PIC24FJ128GL306 Payload End
465 1741642346315 GEN4_TO_CONTROLLER_LOG:GEN4_INIT_INT_LOG_PIC24FJ128GL306 Post:GetInterfaceProvider
465 1741642346315 GEN4_TO_CONTROLLER_LOG:GEN4_INIT_INT_LOG_PIC24FJ128GL306 Return Value
465 1741642346315 GEN4_TO_CONTROLLER_LOG:GEN4_INIT_INT_LOG_PIC24FJ128GL306 com.microchip.mplab.libs.RI4ToolsController.implementations.RI4ControllerDiagnosticsInterfaceImpl@51bbacdd
465 1741642346315 GEN4_TO_CONTROLLER_LOG:GEN4_INIT_INT_LOG_PIC24FJ128GL306 Return End

465 1741642346315 GEN4_TO_CONTROLLER_LOG:GEN4_INIT_INT_LOG_PIC24FJ128GL306 Pre:GetInterfaceProvider
465 1741642346315 GEN4_TO_CONTROLLER_LOG:GEN4_INIT_INT_LOG_PIC24FJ128GL306 Payload
465 1741642346315 GEN4_TO_CONTROLLER_LOG:GEN4_INIT_INT_LOG_PIC24FJ128GL306 ProgrammerToGo
465 1741642346315 GEN4_TO_CONTROLLER_LOG:GEN4_INIT_INT_LOG_PIC24FJ128GL306 Payload End
465 1741642346315 GEN4_TO_CONTROLLER_LOG:GEN4_INIT_INT_LOG_PIC24FJ128GL306 Post:GetInterfaceProvider
465 1741642346315 GEN4_TO_CONTROLLER_LOG:GEN4_INIT_INT_LOG_PIC24FJ128GL306 Return Value
465 1741642346315 GEN4_TO_CONTROLLER_LOG:GEN4_INIT_INT_LOG_PIC24FJ128GL306 com.microchip.mplab.libs.RI4ToolsController.implementations.ProgrammerToGoImpl@73eb541b
465 1741642346315 GEN4_TO_CONTROLLER_LOG:GEN4_INIT_INT_LOG_PIC24FJ128GL306 Return End

465 1741642346315 GEN4_TO_CONTROLLER_LOG:GEN4_INIT_INT_LOG_PIC24FJ128GL306 Pre:GetInterfaceProvider
465 1741642346315 GEN4_TO_CONTROLLER_LOG:GEN4_INIT_INT_LOG_PIC24FJ128GL306 Payload
465 1741642346315 GEN4_TO_CONTROLLER_LOG:GEN4_INIT_INT_LOG_PIC24FJ128GL306 Status
465 1741642346315 GEN4_TO_CONTROLLER_LOG:GEN4_INIT_INT_LOG_PIC24FJ128GL306 Payload End
465 1741642346315 GEN4_TO_CONTROLLER_LOG:GEN4_INIT_INT_LOG_PIC24FJ128GL306 Post:GetInterfaceProvider
465 1741642346315 GEN4_TO_CONTROLLER_LOG:GEN4_INIT_INT_LOG_PIC24FJ128GL306 Return Value
465 1741642346315 GEN4_TO_CONTROLLER_LOG:GEN4_INIT_INT_LOG_PIC24FJ128GL306 null
465 1741642346315 GEN4_TO_CONTROLLER_LOG:GEN4_INIT_INT_LOG_PIC24FJ128GL306 Return End

465 1741642346324 GEN4_TO_CONTROLLER_LOG:GEN4_PROGRAM_INT_LOG_PIC24FJ128GL306 Pre:SetProgramExec
465 1741642346324 GEN4_TO_CONTROLLER_LOG:GEN4_PROGRAM_INT_LOG_PIC24FJ128GL306 Payload
465 1741642346324 GEN4_TO_CONTROLLER_LOG:GEN4_PROGRAM_INT_LOG_PIC24FJ128GL306 Test
465 1741642346324 GEN4_TO_CONTROLLER_LOG:GEN4_PROGRAM_INT_LOG_PIC24FJ128GL306 800000
465 1741642346324 GEN4_TO_CONTROLLER_LOG:GEN4_PROGRAM_INT_LOG_PIC24FJ128GL306 Length = 3108
465 1741642346324 GEN4_TO_CONTROLLER_LOG:GEN4_PROGRAM_INT_LOG_PIC24FJ128GL306 Payload End
465 1741642346325 GEN4_TO_CONTROLLER_LOG:GEN4_PROGRAM_INT_LOG_PIC24FJ128GL306 Post:SetProgramExec
465 1741642346325 GEN4_TO_CONTROLLER_LOG:GEN4_PROGRAM_INT_LOG_PIC24FJ128GL306 Return Value
465 1741642346325 GEN4_TO_CONTROLLER_LOG:GEN4_PROGRAM_INT_LOG_PIC24FJ128GL306 true
465 1741642346325 GEN4_TO_CONTROLLER_LOG:GEN4_PROGRAM_INT_LOG_PIC24FJ128GL306 Return End

465 1741642346328 GEN4_TO_CONTROLLER_LOG:GEN4_PROGRAM_INT_LOG_PIC24FJ128GL306 Pre:SetDebugExec
465 1741642346328 GEN4_TO_CONTROLLER_LOG:GEN4_PROGRAM_INT_LOG_PIC24FJ128GL306 Payload
465 1741642346328 GEN4_TO_CONTROLLER_LOG:GEN4_PROGRAM_INT_LOG_PIC24FJ128GL306 Test
465 1741642346328 GEN4_TO_CONTROLLER_LOG:GEN4_PROGRAM_INT_LOG_PIC24FJ128GL306 800000
465 1741642346328 GEN4_TO_CONTROLLER_LOG:GEN4_PROGRAM_INT_LOG_PIC24FJ128GL306 Length = 2640
465 1741642346328 GEN4_TO_CONTROLLER_LOG:GEN4_PROGRAM_INT_LOG_PIC24FJ128GL306 Payload End
465 1741642346328 GEN4_TO_CONTROLLER_LOG:GEN4_PROGRAM_INT_LOG_PIC24FJ128GL306 Post:SetDebugExec
465 1741642346328 GEN4_TO_CONTROLLER_LOG:GEN4_PROGRAM_INT_LOG_PIC24FJ128GL306 Return Value
465 1741642346328 GEN4_TO_CONTROLLER_LOG:GEN4_PROGRAM_INT_LOG_PIC24FJ128GL306 true
465 1741642346328 GEN4_TO_CONTROLLER_LOG:GEN4_PROGRAM_INT_LOG_PIC24FJ128GL306 Return End

465 1741642346328 GEN4_TO_CONTROLLER_LOG:GEN4_CONNECT_INT_LOG_PIC24FJ128GL306 Pre:EstablishCommunincations
465 1741642346328 GEN4_TO_CONTROLLER_LOG:GEN4_CONNECT_INT_LOG_PIC24FJ128GL306 Payload
465 1741642346328 GEN4_TO_CONTROLLER_LOG:GEN4_CONNECT_INT_LOG_PIC24FJ128GL306 com.microchip.mplab.mdbcore.PK5Tool.PK5Com@6660fdc4
465 1741642346328 GEN4_TO_CONTROLLER_LOG:GEN4_CONNECT_INT_LOG_PIC24FJ128GL306 Payload End
465 1741642346328 GEN4_TO_CONTROLLER_LOG:GEN4_CONNECT_INT_LOG_PIC24FJ128GL306 Post:EstablishCommunincations
465 1741642346328 GEN4_TO_CONTROLLER_LOG:GEN4_CONNECT_INT_LOG_PIC24FJ128GL306 Return Value
465 1741642346328 GEN4_TO_CONTROLLER_LOG:GEN4_CONNECT_INT_LOG_PIC24FJ128GL306 true
465 1741642346328 GEN4_TO_CONTROLLER_LOG:GEN4_CONNECT_INT_LOG_PIC24FJ128GL306 Return End

465 1741642346328 GEN4_TO_CONTROLLER_LOG:GEN4_CONNECT_INT_LOG_PIC24FJ128GL306 Pre:GetFirmwareInfo
465 1741642346328 GEN4_TO_CONTROLLER_LOG:GEN4_CONNECT_INT_LOG_PIC24FJ128GL306 Payload
465 1741642346328 GEN4_TO_CONTROLLER_LOG:GEN4_CONNECT_INT_LOG_PIC24FJ128GL306 null
465 1741642346328 GEN4_TO_CONTROLLER_LOG:GEN4_CONNECT_INT_LOG_PIC24FJ128GL306 Payload End
465 1741642346330 GEN4_TO_CONTROLLER_LOG:GEN4_CONNECT_INT_LOG_PIC24FJ128GL306 Post:GetFirmwareInfo
465 1741642346330 GEN4_TO_CONTROLLER_LOG:GEN4_CONNECT_INT_LOG_PIC24FJ128GL306 Return Value
465 1741642346330 GEN4_TO_CONTROLLER_LOG:GEN4_CONNECT_INT_LOG_PIC24FJ128GL306 FirmwareInfo: Values:
465 1741642346330 GEN4_TO_CONTROLLER_LOG:GEN4_CONNECT_INT_LOG_PIC24FJ128GL306 FirmwareInfo: boot = false, bootVer = 00.00.10, apVer = 02.01.38, fpgaVer = ff.ff.ff, scriptVer = 00.06.71, macAddress = 0505083705471804948484949485155, devID = a1020e01, devID1 = 2, devSN0 = ffffffff, devSN1 = ffffffff, serialNumber = 020026702RYN038688, appCommitID = null, scriptCommitID = 74cdf38a4d, PCB_ID = 2
465 1741642346330 GEN4_TO_CONTROLLER_LOG:GEN4_CONNECT_INT_LOG_PIC24FJ128GL306 Return End
465 1741642346334 XXXX 1741642346334, Thread 465: XXXX 1741642346334, Entering Thread 465: Commands::runScriptWithUpload with script contents. contents[0] = 0x5e, ...  
465 1741642346335 XXXX 1741642346335, Thread 465: XXXX 1741642346335, Entering Thread 465: ToolCommUsb::readTransfer, sideData is 0xd bytes long, transferDataLength is 0x4 bytes long  
465 1741642346337 XXXX 1741642346337, Thread 465: ToolCommUsb::writeHeaderAndGetResponse, response does not meach. got = 0x200afe1, expected 0xd 
465 1741642346337 XXXX 1741642346337, Thread 465: readTransfer: exception after writeHeaderAndGetAck Protocol failure: In writeHeaderAndGetResponse expected 0xd received 0x200afe1 
465 1741642346337 XXXX 1741642346337, Thread 465: XXXX 1741642346337, Entering Thread 465: ToolCommUsb::recoverFromProtocolError, type = NO_SCRIPT  
465 1741642346337 XXXX 1741642346337, Thread 465: Send Abort Script Engine Command 
465 1741642346337 XXXX 1741642346337, Thread 465: XXXX 1741642346337, Entering Thread 465: ToolCommUsb::killScriptEngine  
465 1741642346338 XXXX 1741642346338, Thread 465: XXXX 1741642346338, Exiting Thread 465: ToolCommUsb::killScriptEngine  
465 1741642346339 XXXX 1741642346338, Thread 465: Successfully Sent Abort Script EngineCommand 
465 1741642346339 XXXX 1741642346339, Thread 465: Exiting recoverFromProtocolError 
465 1741642346339 XXXX 1741642346339, Thread 465: XXXX 1741642346339, Exiting Thread 465: ToolCommUsb::recoverFromProtocolError,  
465 1741642346339 XXXX 1741642346339, Thread 465: readTransfer: after recoverFromProtocolError 
465 1741642346340 GEN4_CONNECT_DIAGNOSTICS:ENTERING: com.microchip.mplab.mdbcore.RI4Tool.ConnectionHandler.CheckForFWUpdates()
465 1741642346348 GEN4_CONNECT_DIAGNOSTICS:Created FirmwareUpdateHandler com.microchip.mplab.mdbcore.PK5Tool.PK5FirmwareUpdateHandler@29d2eddb
465 1741642346348 GEN4_CONNECT_DIAGNOSTICS:ENTERING: com.microchip.mplab.mdbcore.RI4Tool.FirmwareUpdateHandler.GetUpdateInfo()
465 1741642346349 GEN4_CONNECT_DIAGNOSTICS:Parsing file  for firmware updates
465 1741642346349 GEN4_CONNECT_DIAGNOSTICS:ENTERING: com.microchip.mplab.mdbcore.RI4Tool.FirmwareUpdateHandler.ri4ParseSelectedVersionsFromJamFile()
465 1741642346349 GEN4_CONNECT_DIAGNOSTICS:Jame file line = app.hex,020138
465 1741642346349 GEN4_CONNECT_DIAGNOSTICS:Jame file line = boot.hex,000010
465 1741642346349 GEN4_CONNECT_DIAGNOSTICS:Jame file line = scripts.xml,000671
465 1741642346351 GEN4_CONNECT_DIAGNOSTICS:Selected firmware version for Boot = 00.00.10
465 1741642346351 GEN4_CONNECT_DIAGNOSTICS:Selected firmware version for ap = 02.01.38
465 1741642346351 GEN4_CONNECT_DIAGNOSTICS:EXITING: com.microchip.mplab.mdbcore.RI4Tool.FirmwareUpdateHandler.ri4ParseSelectedVersionsFromJamFile()
465 1741642346351 GEN4_CONNECT_DIAGNOSTICS:EXITING: com.microchip.mplab.mdbcore.RI4Tool.FirmwareUpdateHandler.GetUpdateInfo()
465 1741642346351 GEN4_CONNECT_DIAGNOSTICS:ENTERING: com.microchip.mplab.mdbcore.RI4Tool.FirmwareUpdateHandler.updateRI4ToolsFirmware(FirmwareInfo, UpdateMessage)
465 1741642346355 GEN4_CONNECT_DIAGNOSTICS:appNeedsUpdate returned false
465 1741642346355 GEN4_CONNECT_DIAGNOSTICS:EXITING: com.microchip.mplab.mdbcore.RI4Tool.FirmwareUpdateHandler.updateRI4ToolsFirmware(FirmwareInfo, UpdateMessage)
465 1741642346356 GEN4_CONNECT_DIAGNOSTICS:EXITING: com.microchip.mplab.mdbcore.RI4Tool.ConnectionHandler.CheckForFWUpdates()

465 1741642346358 GEN4_TO_CONTROLLER_LOG:GEN4_CONNECT_INT_LOG_PIC24FJ128GL306 Pre:SetPowerInfo
465 1741642346358 GEN4_TO_CONTROLLER_LOG:GEN4_CONNECT_INT_LOG_PIC24FJ128GL306 Payload
465 1741642346358 GEN4_TO_CONTROLLER_LOG:GEN4_CONNECT_INT_LOG_PIC24FJ128GL306 PowerInfo: Values:
465 1741642346359 GEN4_TO_CONTROLLER_LOG:GEN4_CONNECT_INT_LOG_PIC24FJ128GL306 PowerInfo: shotDownSystem = false, isToolPower = false, voltage = 3.250000, useVppFirst = false, useLowVoltageProgramming = true, useMaintainActivePower = false
465 1741642346359 GEN4_TO_CONTROLLER_LOG:GEN4_CONNECT_INT_LOG_PIC24FJ128GL306 Payload End
465 1741642346359 XXXX 1741642346359, Thread 465: XXXX 1741642346359, Entering Thread 465: Commands::runScriptBasic with script contents. contents[0] = 0x39, ...  
465 1741642346360 XXXX 1741642346360, Thread 465: XXXX 1741642346360, Exiting Thread 465: Commands::runScriptBasic  
465 1741642346360 XXXX 1741642346360, Thread 465: XXXX 1741642346360, Entering Thread 465: Commands::runScriptBasic with script contents. contents[0] = 0x46, ...  
465 1741642346361 XXXX 1741642346361, Thread 465: ToolCommUsb::writeHeaderAndGetResponse, response does not meach. got = 0x7, expected 0xd 
465 1741642346361 XXXX 1741642346361, Thread 465: transfer: exception after writeHeaderAndGetResult Protocol failure: In writeHeaderAndGetResponse expected 0xd received 0x7 
465 1741642346361 XXXX 1741642346361, Thread 465: XXXX 1741642346361, Entering Thread 465: ToolCommUsb::recoverFromProtocolError, type = NO_SCRIPT  
465 1741642346361 XXXX 1741642346361, Thread 465: Send Abort Script Engine Command 
465 1741642346361 XXXX 1741642346361, Thread 465: XXXX 1741642346361, Entering Thread 465: ToolCommUsb::killScriptEngine  
465 1741642346362 GEN4_CONNECT_DIAGNOSTICS:MPLABCommTool is null

465 1741642346362 GEN4_TO_CONTROLLER_LOG:GEN4_CONNECT_INT_LOG_PIC24FJ128GL306 Pre:GetFirmwareInfo
465 1741642346362 GEN4_TO_CONTROLLER_LOG:GEN4_CONNECT_INT_LOG_PIC24FJ128GL306 Payload
465 1741642346362 GEN4_TO_CONTROLLER_LOG:GEN4_CONNECT_INT_LOG_PIC24FJ128GL306 null
465 1741642346362 GEN4_TO_CONTROLLER_LOG:GEN4_CONNECT_INT_LOG_PIC24FJ128GL306 Payload End
465 1741642346363 GEN4_CONNECT_DIAGNOSTICS:Removing plug and play observer com.microchip.mplab.mdbcore.RI4Tool.RI4ToolBase$RI4PlugNPlayObserver@1521f9bf
465 1741642346363 GEN4_CONNECT_DIAGNOSTICS:Begin PlugNPlayObservers list dump:
465 1741642346363 GEN4_CONNECT_DIAGNOSTICS:End PlugNPlayObservers list dump:
465 1741642346417 GEN4_CONNECT_DIAGNOSTICS:Calling RIDbgToolCom.Disconnect
465 1741642346417 GEN4_CONNECT_DIAGNOSTICS:Calling MPLABCommTool.Detach to remove tool from plug and play list
465 1741642346417 GEN4_CONNECT_DIAGNOSTICS:Calling RIDbgToolCom.DisconnectFromMPlabComm
465 1741642346417 GEN4_CONNECT_DIAGNOSTICS:Calling MPLABCommTool.Disconnect
477 1741642363819 GEN4_CONNECT_DIAGNOSTICS:MPLABCommTool is NOT null
477 1741642363819 GEN4_CONNECT_DIAGNOSTICS:AttachedToolPID = 9036, AttachedToolVID = 4d8
477 1741642363819 GEN4_CONNECT_DIAGNOSTICS:transport type = USB
477 1741642363819 GEN4_CONNECT_DIAGNOSTICS:AttachedToolPID = 9036, AttachedToolVID = 4d8
477 1741642363822 com.microchip.mplab.mdbcore.RealICETool.RIDbgToolCom
477 1741642363822 GEN4_CONNECT_DIAGNOSTICS:Before MPLABCommTool.Connect()
477 1741642363823 GEN4_CONNECT_DIAGNOSTICS:After MPLABCommTool.Connect()
477 1741642363823 GEN4_CONNECT_DIAGNOSTICS:MPLABCommTool.Connect() returned MPLABCOMM_NO_ERROR
477 1741642363824 GEN4_CONNECT_DIAGNOSTICS:Attaching to MPLABCommTool plugnplay
477 1741642363824 GEN4_CONNECT_DIAGNOSTICS:Adding new plug and play observer com.microchip.mplab.mdbcore.RI4Tool.RI4ToolBase$RI4PlugNPlayObserver@65a99556
477 1741642363824 GEN4_CONNECT_DIAGNOSTICS:Begin PlugNPlayObservers list dump:
477 1741642363824 GEN4_CONNECT_DIAGNOSTICS:com.microchip.mplab.mdbcore.RI4Tool.RI4ToolBase$RI4PlugNPlayObserver@65a99556
477 1741642363824 GEN4_CONNECT_DIAGNOSTICS:End PlugNPlayObservers list dump:
477 1741642363824 GEN4_CONNECT_DIAGNOSTICS:Registering for alternate PNP notifications. CommPnPCriteria.cPIDList = [9035], CommPnPCriteria.cSerialNumber = 020026702ryn038688

477 1741642363899 GEN4_TO_CONTROLLER_LOG:GEN4_INIT_INT_LOG_PIC24FJ128GL306 Pre:init
477 1741642363899 GEN4_TO_CONTROLLER_LOG:GEN4_INIT_INT_LOG_PIC24FJ128GL306 Payload
477 1741642363899 GEN4_TO_CONTROLLER_LOG:GEN4_INIT_INT_LOG_PIC24FJ128GL306 DeviceInfo: Values:
477 1741642363899 GEN4_TO_CONTROLLER_LOG:GEN4_INIT_INT_LOG_PIC24FJ128GL306 DeviceInfo: pcAddress = 0000002e, Vpp = 3.25, useRowEraseIfVoltageIsLow = false, voltageBelowWhichUseRowErase = 0.00, deviceName = PIC24FJ128GL306, programmerType = PIC24FJ
477 1741642363899 GEN4_TO_CONTROLLER_LOG:GEN4_INIT_INT_LOG_PIC24FJ128GL306 DeviceInfo: MemInfo values:
477 1741642363899 GEN4_TO_CONTROLLER_LOG:GEN4_INIT_INT_LOG_PIC24FJ128GL306 DeviceInfo: mask = ffffff, exists = true, startAddr = 00000000, endAddr = 00015eff, rowSize = 0800, rowEraseSize = 0800, addrInc = 0002, widthProgram = 0004
477 1741642363899 GEN4_TO_CONTROLLER_LOG:GEN4_INIT_INT_LOG_PIC24FJ128GL306 DeviceInfo: mask = ffffff, exists = true, startAddr = 00015f00, endAddr = 00015fff, rowSize = 0001, rowEraseSize = 0000, addrInc = 0002, widthProgram = 0004
477 1741642363899 GEN4_TO_CONTROLLER_LOG:GEN4_INIT_INT_LOG_PIC24FJ128GL306 DeviceInfo: mask = 0000, exists = false, startAddr = 00000000, endAddr = 00000000, rowSize = 0000, rowEraseSize = 0000, addrInc = 0000, widthProgram = 0000
477 1741642363899 GEN4_TO_CONTROLLER_LOG:GEN4_INIT_INT_LOG_PIC24FJ128GL306 DeviceInfo: mask = 0000, exists = false, startAddr = 00000000, endAddr = 00000000, rowSize = 0000, rowEraseSize = 0000, addrInc = 0000, widthProgram = 0000
477 1741642363899 GEN4_TO_CONTROLLER_LOG:GEN4_INIT_INT_LOG_PIC24FJ128GL306 DeviceInfo: mask = 0000, exists = false, startAddr = 00000000, endAddr = 00000000, rowSize = 0000, rowEraseSize = 0000, addrInc = 0000, widthProgram = 0000
477 1741642363899 GEN4_TO_CONTROLLER_LOG:GEN4_INIT_INT_LOG_PIC24FJ128GL306 DeviceInfo: mask = ffffff, exists = true, startAddr = 00800000, endAddr = 008017ff, rowSize = 0800, rowEraseSize = 0800, addrInc = 0002, widthProgram = 0004
477 1741642363899 GEN4_TO_CONTROLLER_LOG:GEN4_INIT_INT_LOG_PIC24FJ128GL306 DeviceInfo: mask = 0000, exists = false, startAddr = 00000000, endAddr = 00000000, rowSize = 0000, rowEraseSize = 0000, addrInc = 0002, widthProgram = 0002
477 1741642363899 GEN4_TO_CONTROLLER_LOG:GEN4_INIT_INT_LOG_PIC24FJ128GL306 DeviceInfo: mask = 0000, exists = false, startAddr = 00000000, endAddr = 00000000, rowSize = 0000, rowEraseSize = 0000, addrInc = 0000, widthProgram = 0000
477 1741642363899 GEN4_TO_CONTROLLER_LOG:GEN4_INIT_INT_LOG_PIC24FJ128GL306 DeviceInfo: mask = 0000, exists = false, startAddr = 00000000, endAddr = 00000000, rowSize = 0000, rowEraseSize = 0000, addrInc = 0000, widthProgram = 0000
477 1741642363899 GEN4_TO_CONTROLLER_LOG:GEN4_INIT_INT_LOG_PIC24FJ128GL306 DeviceInfo: mask = 0000, exists = false, startAddr = 00000000, endAddr = 00000000, rowSize = 0000, rowEraseSize = 0000, addrInc = 0000, widthProgram = 0000
477 1741642363899 GEN4_TO_CONTROLLER_LOG:GEN4_INIT_INT_LOG_PIC24FJ128GL306 DeviceInfo: mask = 0000, exists = false, startAddr = 00000000, endAddr = 00000000, rowSize = 0000, rowEraseSize = 0000, addrInc = 0002, widthProgram = 0002
477 1741642363899 GEN4_TO_CONTROLLER_LOG:GEN4_INIT_INT_LOG_PIC24FJ128GL306 DeviceInfo: mask = 0000, exists = false, startAddr = 00000000, endAddr = 00000000, rowSize = 0000, rowEraseSize = 0000, addrInc = 0000, widthProgram = 0000
477 1741642363899 GEN4_TO_CONTROLLER_LOG:GEN4_INIT_INT_LOG_PIC24FJ128GL306 DeviceInfo: mask = 0000, exists = false, startAddr = 00000000, endAddr = 00000000, rowSize = 0000, rowEraseSize = 0000, addrInc = 0000, widthProgram = 0000
477 1741642363899 GEN4_TO_CONTROLLER_LOG:GEN4_INIT_INT_LOG_PIC24FJ128GL306 DeviceInfo: mask = ffffff, exists = true, startAddr = 00801700, endAddr = 008017ff, rowSize = 0001, rowEraseSize = 0000, addrInc = 0002, widthProgram = 0004
477 1741642363899 GEN4_TO_CONTROLLER_LOG:GEN4_INIT_INT_LOG_PIC24FJ128GL306 DeviceInfo: mask = 0000, exists = false, startAddr = 00000000, endAddr = 00000000, rowSize = 0000, rowEraseSize = 0000, addrInc = 0000, widthProgram = 0000
477 1741642363899 GEN4_TO_CONTROLLER_LOG:GEN4_INIT_INT_LOG_PIC24FJ128GL306 DeviceInfo: mask = 0000, exists = false, startAddr = 00000000, endAddr = 00000000, rowSize = 0000, rowEraseSize = 0000, addrInc = 0000, widthProgram = 0000
477 1741642363899 GEN4_TO_CONTROLLER_LOG:GEN4_INIT_INT_LOG_PIC24FJ128GL306 DeviceInfo: mask = 7fffffff, exists = true, startAddr = 00ff0000, endAddr = 00ff0003, rowSize = 0001, rowEraseSize = 0000, addrInc = 0001, widthProgram = 0001
477 1741642363900 GEN4_TO_CONTROLLER_LOG:GEN4_INIT_INT_LOG_PIC24FJ128GL306 DeviceInfo: mask = 0000, exists = false, startAddr = 00000000, endAddr = 00000000, rowSize = 0000, rowEraseSize = 0000, addrInc = 0000, widthProgram = 0000
477 1741642363900 GEN4_TO_CONTROLLER_LOG:GEN4_INIT_INT_LOG_PIC24FJ128GL306 DeviceInfo: mask = 0000, exists = false, startAddr = 00000000, endAddr = 00000000, rowSize = 0000, rowEraseSize = 0000, addrInc = 0000, widthProgram = 0000
477 1741642363900 GEN4_TO_CONTROLLER_LOG:GEN4_INIT_INT_LOG_PIC24FJ128GL306 DeviceInfo: mask = 0000, exists = false, startAddr = 00000000, endAddr = 00000000, rowSize = 0000, rowEraseSize = 0000, addrInc = 0000, widthProgram = 0000
477 1741642363900 GEN4_TO_CONTROLLER_LOG:GEN4_INIT_INT_LOG_PIC24FJ128GL306 DeviceInfo: mask = 0000, exists = false, startAddr = 00000000, endAddr = 00000000, rowSize = 0000, rowEraseSize = 0000, addrInc = 0000, widthProgram = 0000
477 1741642363900 GEN4_TO_CONTROLLER_LOG:GEN4_INIT_INT_LOG_PIC24FJ128GL306 DeviceInfo: mask = 0000, exists = false, startAddr = 00000000, endAddr = 00000000, rowSize = 0000, rowEraseSize = 0000, addrInc = 0000, widthProgram = 0000
477 1741642363900 GEN4_TO_CONTROLLER_LOG:GEN4_INIT_INT_LOG_PIC24FJ128GL306 DeviceInfo: mask = 0000, exists = true, startAddr = 00801600, endAddr = 00801609, rowSize = 0000, rowEraseSize = 0000, addrInc = 0002, widthProgram = 0004
477 1741642363900 GEN4_TO_CONTROLLER_LOG:GEN4_INIT_INT_LOG_PIC24FJ128GL306 DeviceInfo: CfgRequiredBitsMask Values:
477 1741642363900 GEN4_TO_CONTROLLER_LOG:GEN4_INIT_INT_LOG_PIC24FJ128GL306 Address = 00015f00, Mask = 00008fef
477 1741642363900 GEN4_TO_CONTROLLER_LOG:GEN4_INIT_INT_LOG_PIC24FJ128GL306 Address = 00015f10, Mask = 00001fff
477 1741642363900 GEN4_TO_CONTROLLER_LOG:GEN4_INIT_INT_LOG_PIC24FJ128GL306 Address = 00015f14, Mask = 00ff7fff
477 1741642363900 GEN4_TO_CONTROLLER_LOG:GEN4_INIT_INT_LOG_PIC24FJ128GL306 Address = 00015f18, Mask = 000000ff
477 1741642363900 GEN4_TO_CONTROLLER_LOG:GEN4_INIT_INT_LOG_PIC24FJ128GL306 Address = 00015f1c, Mask = 000000ff
477 1741642363900 GEN4_TO_CONTROLLER_LOG:GEN4_INIT_INT_LOG_PIC24FJ128GL306 Address = 00015f20, Mask = 00006bff
477 1741642363900 GEN4_TO_CONTROLLER_LOG:GEN4_INIT_INT_LOG_PIC24FJ128GL306 Address = 00015f24, Mask = 0000000f
477 1741642363900 GEN4_TO_CONTROLLER_LOG:GEN4_INIT_INT_LOG_PIC24FJ128GL306 Address = 00015f28, Mask = 00000003
477 1741642363900 GEN4_TO_CONTROLLER_LOG:GEN4_INIT_INT_LOG_PIC24FJ128GL306 Address = 00015f2c, Mask = 0000ffff
477 1741642363900 GEN4_TO_CONTROLLER_LOG:GEN4_INIT_INT_LOG_PIC24FJ128GL306 Address = 00015f30, Mask = 0000ffff
477 1741642363900 GEN4_TO_CONTROLLER_LOG:GEN4_INIT_INT_LOG_PIC24FJ128GL306 Address = 00015f34, Mask = 0000ffff
477 1741642363900 GEN4_TO_CONTROLLER_LOG:GEN4_INIT_INT_LOG_PIC24FJ128GL306 Address = 00015f38, Mask = 0000ffff
477 1741642363900 GEN4_TO_CONTROLLER_LOG:GEN4_INIT_INT_LOG_PIC24FJ128GL306 Address = 00015f3c, Mask = 00000001
477 1741642363900 GEN4_TO_CONTROLLER_LOG:GEN4_INIT_INT_LOG_PIC24FJ128GL306 Address = 00015f40, Mask = 0000041e
477 1741642363900 GEN4_TO_CONTROLLER_LOG:GEN4_INIT_INT_LOG_PIC24FJ128GL306 BasicInfo: Values:
477 1741642363900 GEN4_TO_CONTROLLER_LOG:GEN4_INIT_INT_LOG_PIC24FJ128GL306 BasicInfo: InputStream = com.microchip.mplab.libs.toolpacksupport.EquatableFileInputStream@a3c86b5, ToolFlavor = PIC32C
477 1741642363900 GEN4_TO_CONTROLLER_LOG:GEN4_INIT_INT_LOG_PIC24FJ128GL306 Payload End
477 1741642363900 GEN4_TO_CONTROLLER_LOG:GEN4_INIT_INT_LOG_PIC24FJ128GL306 Post:init
477 1741642363900 GEN4_TO_CONTROLLER_LOG:GEN4_INIT_INT_LOG_PIC24FJ128GL306 Return Value
477 1741642363900 GEN4_TO_CONTROLLER_LOG:GEN4_INIT_INT_LOG_PIC24FJ128GL306 none
477 1741642363900 GEN4_TO_CONTROLLER_LOG:GEN4_INIT_INT_LOG_PIC24FJ128GL306 Return End

477 1741642363900 GEN4_TO_CONTROLLER_LOG:GEN4_INIT_INT_LOG_PIC24FJ128GL306 Pre:GetInterfaceProvider
477 1741642363900 GEN4_TO_CONTROLLER_LOG:GEN4_INIT_INT_LOG_PIC24FJ128GL306 Payload
477 1741642363900 GEN4_TO_CONTROLLER_LOG:GEN4_INIT_INT_LOG_PIC24FJ128GL306 RI4DebugInterface
477 1741642363900 GEN4_TO_CONTROLLER_LOG:GEN4_INIT_INT_LOG_PIC24FJ128GL306 Payload End
477 1741642363900 GEN4_TO_CONTROLLER_LOG:GEN4_INIT_INT_LOG_PIC24FJ128GL306 Post:GetInterfaceProvider
477 1741642363900 GEN4_TO_CONTROLLER_LOG:GEN4_INIT_INT_LOG_PIC24FJ128GL306 Return Value
477 1741642363900 GEN4_TO_CONTROLLER_LOG:GEN4_INIT_INT_LOG_PIC24FJ128GL306 com.microchip.mplab.libs.RI4ToolsController.implementations.RI4DebugInterfaceImpl@48cdb33c
477 1741642363900 GEN4_TO_CONTROLLER_LOG:GEN4_INIT_INT_LOG_PIC24FJ128GL306 Return End

477 1741642363901 GEN4_TO_CONTROLLER_LOG:GEN4_INIT_INT_LOG_PIC24FJ128GL306 Pre:GetInterfaceProvider
477 1741642363901 GEN4_TO_CONTROLLER_LOG:GEN4_INIT_INT_LOG_PIC24FJ128GL306 Payload
477 1741642363901 GEN4_TO_CONTROLLER_LOG:GEN4_INIT_INT_LOG_PIC24FJ128GL306 RI4ProgramInterface
477 1741642363901 GEN4_TO_CONTROLLER_LOG:GEN4_INIT_INT_LOG_PIC24FJ128GL306 Payload End
477 1741642363901 GEN4_TO_CONTROLLER_LOG:GEN4_INIT_INT_LOG_PIC24FJ128GL306 Post:GetInterfaceProvider
477 1741642363901 GEN4_TO_CONTROLLER_LOG:GEN4_INIT_INT_LOG_PIC24FJ128GL306 Return Value
477 1741642363901 GEN4_TO_CONTROLLER_LOG:GEN4_INIT_INT_LOG_PIC24FJ128GL306 com.microchip.mplab.libs.RI4ToolsController.implementations.RI4ProgramInterfaceImpl@61e78c56
477 1741642363901 GEN4_TO_CONTROLLER_LOG:GEN4_INIT_INT_LOG_PIC24FJ128GL306 Return End

477 1741642363901 GEN4_TO_CONTROLLER_LOG:GEN4_INIT_INT_LOG_PIC24FJ128GL306 Pre:GetInterfaceProvider
477 1741642363901 GEN4_TO_CONTROLLER_LOG:GEN4_INIT_INT_LOG_PIC24FJ128GL306 Payload
477 1741642363901 GEN4_TO_CONTROLLER_LOG:GEN4_INIT_INT_LOG_PIC24FJ128GL306 RI4ConnectInterface
477 1741642363901 GEN4_TO_CONTROLLER_LOG:GEN4_INIT_INT_LOG_PIC24FJ128GL306 Payload End
477 1741642363901 GEN4_TO_CONTROLLER_LOG:GEN4_INIT_INT_LOG_PIC24FJ128GL306 Post:GetInterfaceProvider
477 1741642363901 GEN4_TO_CONTROLLER_LOG:GEN4_INIT_INT_LOG_PIC24FJ128GL306 Return Value
477 1741642363901 GEN4_TO_CONTROLLER_LOG:GEN4_INIT_INT_LOG_PIC24FJ128GL306 com.microchip.mplab.libs.PK4ToolsController.PK4ConnectInterfaceImpl@7eebe9b1
477 1741642363901 GEN4_TO_CONTROLLER_LOG:GEN4_INIT_INT_LOG_PIC24FJ128GL306 Return End

477 1741642363901 GEN4_TO_CONTROLLER_LOG:GEN4_INIT_INT_LOG_PIC24FJ128GL306 Pre:GetInterfaceProvider
477 1741642363901 GEN4_TO_CONTROLLER_LOG:GEN4_INIT_INT_LOG_PIC24FJ128GL306 Payload
477 1741642363901 GEN4_TO_CONTROLLER_LOG:GEN4_INIT_INT_LOG_PIC24FJ128GL306 RI4ControllerDiagnosticsInterface
477 1741642363901 GEN4_TO_CONTROLLER_LOG:GEN4_INIT_INT_LOG_PIC24FJ128GL306 Payload End
477 1741642363901 GEN4_TO_CONTROLLER_LOG:GEN4_INIT_INT_LOG_PIC24FJ128GL306 Post:GetInterfaceProvider
477 1741642363901 GEN4_TO_CONTROLLER_LOG:GEN4_INIT_INT_LOG_PIC24FJ128GL306 Return Value
477 1741642363901 GEN4_TO_CONTROLLER_LOG:GEN4_INIT_INT_LOG_PIC24FJ128GL306 com.microchip.mplab.libs.RI4ToolsController.implementations.RI4ControllerDiagnosticsInterfaceImpl@d672638
477 1741642363901 GEN4_TO_CONTROLLER_LOG:GEN4_INIT_INT_LOG_PIC24FJ128GL306 Return End

477 1741642363901 GEN4_TO_CONTROLLER_LOG:GEN4_INIT_INT_LOG_PIC24FJ128GL306 Pre:GetInterfaceProvider
477 1741642363901 GEN4_TO_CONTROLLER_LOG:GEN4_INIT_INT_LOG_PIC24FJ128GL306 Payload
477 1741642363901 GEN4_TO_CONTROLLER_LOG:GEN4_INIT_INT_LOG_PIC24FJ128GL306 ProgrammerToGo
477 1741642363901 GEN4_TO_CONTROLLER_LOG:GEN4_INIT_INT_LOG_PIC24FJ128GL306 Payload End
477 1741642363901 GEN4_TO_CONTROLLER_LOG:GEN4_INIT_INT_LOG_PIC24FJ128GL306 Post:GetInterfaceProvider
477 1741642363901 GEN4_TO_CONTROLLER_LOG:GEN4_INIT_INT_LOG_PIC24FJ128GL306 Return Value
477 1741642363901 GEN4_TO_CONTROLLER_LOG:GEN4_INIT_INT_LOG_PIC24FJ128GL306 com.microchip.mplab.libs.RI4ToolsController.implementations.ProgrammerToGoImpl@289630fb
477 1741642363901 GEN4_TO_CONTROLLER_LOG:GEN4_INIT_INT_LOG_PIC24FJ128GL306 Return End

477 1741642363901 GEN4_TO_CONTROLLER_LOG:GEN4_INIT_INT_LOG_PIC24FJ128GL306 Pre:GetInterfaceProvider
477 1741642363901 GEN4_TO_CONTROLLER_LOG:GEN4_INIT_INT_LOG_PIC24FJ128GL306 Payload
477 1741642363901 GEN4_TO_CONTROLLER_LOG:GEN4_INIT_INT_LOG_PIC24FJ128GL306 Status
477 1741642363901 GEN4_TO_CONTROLLER_LOG:GEN4_INIT_INT_LOG_PIC24FJ128GL306 Payload End
477 1741642363901 GEN4_TO_CONTROLLER_LOG:GEN4_INIT_INT_LOG_PIC24FJ128GL306 Post:GetInterfaceProvider
477 1741642363901 GEN4_TO_CONTROLLER_LOG:GEN4_INIT_INT_LOG_PIC24FJ128GL306 Return Value
477 1741642363901 GEN4_TO_CONTROLLER_LOG:GEN4_INIT_INT_LOG_PIC24FJ128GL306 null
477 1741642363901 GEN4_TO_CONTROLLER_LOG:GEN4_INIT_INT_LOG_PIC24FJ128GL306 Return End

477 1741642363925 GEN4_TO_CONTROLLER_LOG:GEN4_PROGRAM_INT_LOG_PIC24FJ128GL306 Pre:SetProgramExec
477 1741642363925 GEN4_TO_CONTROLLER_LOG:GEN4_PROGRAM_INT_LOG_PIC24FJ128GL306 Payload
477 1741642363925 GEN4_TO_CONTROLLER_LOG:GEN4_PROGRAM_INT_LOG_PIC24FJ128GL306 Test
477 1741642363925 GEN4_TO_CONTROLLER_LOG:GEN4_PROGRAM_INT_LOG_PIC24FJ128GL306 800000
477 1741642363925 GEN4_TO_CONTROLLER_LOG:GEN4_PROGRAM_INT_LOG_PIC24FJ128GL306 Length = 3108
477 1741642363925 GEN4_TO_CONTROLLER_LOG:GEN4_PROGRAM_INT_LOG_PIC24FJ128GL306 Payload End
477 1741642363925 GEN4_TO_CONTROLLER_LOG:GEN4_PROGRAM_INT_LOG_PIC24FJ128GL306 Post:SetProgramExec
477 1741642363925 GEN4_TO_CONTROLLER_LOG:GEN4_PROGRAM_INT_LOG_PIC24FJ128GL306 Return Value
477 1741642363925 GEN4_TO_CONTROLLER_LOG:GEN4_PROGRAM_INT_LOG_PIC24FJ128GL306 true
477 1741642363925 GEN4_TO_CONTROLLER_LOG:GEN4_PROGRAM_INT_LOG_PIC24FJ128GL306 Return End

477 1741642363930 GEN4_TO_CONTROLLER_LOG:GEN4_PROGRAM_INT_LOG_PIC24FJ128GL306 Pre:SetDebugExec
477 1741642363930 GEN4_TO_CONTROLLER_LOG:GEN4_PROGRAM_INT_LOG_PIC24FJ128GL306 Payload
477 1741642363930 GEN4_TO_CONTROLLER_LOG:GEN4_PROGRAM_INT_LOG_PIC24FJ128GL306 Test
477 1741642363930 GEN4_TO_CONTROLLER_LOG:GEN4_PROGRAM_INT_LOG_PIC24FJ128GL306 800000
477 1741642363930 GEN4_TO_CONTROLLER_LOG:GEN4_PROGRAM_INT_LOG_PIC24FJ128GL306 Length = 2640
477 1741642363930 GEN4_TO_CONTROLLER_LOG:GEN4_PROGRAM_INT_LOG_PIC24FJ128GL306 Payload End
477 1741642363930 GEN4_TO_CONTROLLER_LOG:GEN4_PROGRAM_INT_LOG_PIC24FJ128GL306 Post:SetDebugExec
477 1741642363930 GEN4_TO_CONTROLLER_LOG:GEN4_PROGRAM_INT_LOG_PIC24FJ128GL306 Return Value
477 1741642363930 GEN4_TO_CONTROLLER_LOG:GEN4_PROGRAM_INT_LOG_PIC24FJ128GL306 true
477 1741642363930 GEN4_TO_CONTROLLER_LOG:GEN4_PROGRAM_INT_LOG_PIC24FJ128GL306 Return End

477 1741642363940 GEN4_TO_CONTROLLER_LOG:GEN4_CONNECT_INT_LOG_PIC24FJ128GL306 Pre:EstablishCommunincations
477 1741642363940 GEN4_TO_CONTROLLER_LOG:GEN4_CONNECT_INT_LOG_PIC24FJ128GL306 Payload
477 1741642363940 GEN4_TO_CONTROLLER_LOG:GEN4_CONNECT_INT_LOG_PIC24FJ128GL306 com.microchip.mplab.mdbcore.PK5Tool.PK5Com@34490ee4
477 1741642363940 GEN4_TO_CONTROLLER_LOG:GEN4_CONNECT_INT_LOG_PIC24FJ128GL306 Payload End
477 1741642363940 GEN4_TO_CONTROLLER_LOG:GEN4_CONNECT_INT_LOG_PIC24FJ128GL306 Post:EstablishCommunincations
477 1741642363940 GEN4_TO_CONTROLLER_LOG:GEN4_CONNECT_INT_LOG_PIC24FJ128GL306 Return Value
477 1741642363940 GEN4_TO_CONTROLLER_LOG:GEN4_CONNECT_INT_LOG_PIC24FJ128GL306 true
477 1741642363940 GEN4_TO_CONTROLLER_LOG:GEN4_CONNECT_INT_LOG_PIC24FJ128GL306 Return End

477 1741642363940 GEN4_TO_CONTROLLER_LOG:GEN4_CONNECT_INT_LOG_PIC24FJ128GL306 Pre:GetFirmwareInfo
477 1741642363940 GEN4_TO_CONTROLLER_LOG:GEN4_CONNECT_INT_LOG_PIC24FJ128GL306 Payload
477 1741642363940 GEN4_TO_CONTROLLER_LOG:GEN4_CONNECT_INT_LOG_PIC24FJ128GL306 null
477 1741642363940 GEN4_TO_CONTROLLER_LOG:GEN4_CONNECT_INT_LOG_PIC24FJ128GL306 Payload End
477 1741642363943 GEN4_TO_CONTROLLER_LOG:GEN4_CONNECT_INT_LOG_PIC24FJ128GL306 Post:GetFirmwareInfo
477 1741642363943 GEN4_TO_CONTROLLER_LOG:GEN4_CONNECT_INT_LOG_PIC24FJ128GL306 Return Value
477 1741642363943 GEN4_TO_CONTROLLER_LOG:GEN4_CONNECT_INT_LOG_PIC24FJ128GL306 FirmwareInfo: Values:
477 1741642363944 GEN4_TO_CONTROLLER_LOG:GEN4_CONNECT_INT_LOG_PIC24FJ128GL306 FirmwareInfo: boot = false, bootVer = 00.00.10, apVer = 02.01.38, fpgaVer = ff.ff.ff, scriptVer = 00.06.71, macAddress = 0505083705471804948484949485155, devID = a1020e01, devID1 = 2, devSN0 = ffffffff, devSN1 = ffffffff, serialNumber = 020026702RYN038688, appCommitID = null, scriptCommitID = 74cdf38a4d, PCB_ID = 2
477 1741642363944 GEN4_TO_CONTROLLER_LOG:GEN4_CONNECT_INT_LOG_PIC24FJ128GL306 Return End
477 1741642363944 XXXX 1741642363944, Thread 477: XXXX 1741642363944, Entering Thread 477: Commands::runScriptWithUpload with script contents. contents[0] = 0x5e, ...  
477 1741642363944 XXXX 1741642363944, Thread 477: XXXX 1741642363944, Entering Thread 477: ToolCommUsb::readTransfer, sideData is 0xd bytes long, transferDataLength is 0x4 bytes long  
477 1741642363973 XXXX 1741642363973, Thread 477: ToolCommUsb::writeHeaderAndGetResponse, response does not meach. got = 0x200afe1, expected 0xd 
477 1741642363973 XXXX 1741642363973, Thread 477: readTransfer: exception after writeHeaderAndGetAck Protocol failure: In writeHeaderAndGetResponse expected 0xd received 0x200afe1 
477 1741642363973 XXXX 1741642363973, Thread 477: XXXX 1741642363973, Entering Thread 477: ToolCommUsb::recoverFromProtocolError, type = NO_SCRIPT  
477 1741642363974 XXXX 1741642363973, Thread 477: Send Abort Script Engine Command 
477 1741642363974 XXXX 1741642363974, Thread 477: XXXX 1741642363974, Entering Thread 477: ToolCommUsb::killScriptEngine  
477 1741642363975 XXXX 1741642363975, Thread 477: XXXX 1741642363975, Exiting Thread 477: ToolCommUsb::killScriptEngine  
477 1741642363975 XXXX 1741642363975, Thread 477: Successfully Sent Abort Script EngineCommand 
477 1741642363975 XXXX 1741642363975, Thread 477: Exiting recoverFromProtocolError 
477 1741642363975 XXXX 1741642363975, Thread 477: XXXX 1741642363975, Exiting Thread 477: ToolCommUsb::recoverFromProtocolError,  
477 1741642363975 XXXX 1741642363975, Thread 477: readTransfer: after recoverFromProtocolError 
477 1741642363976 GEN4_CONNECT_DIAGNOSTICS:ENTERING: com.microchip.mplab.mdbcore.RI4Tool.ConnectionHandler.CheckForFWUpdates()
477 1741642363976 GEN4_CONNECT_DIAGNOSTICS:Created FirmwareUpdateHandler com.microchip.mplab.mdbcore.PK5Tool.PK5FirmwareUpdateHandler@75ce8c83
477 1741642363976 GEN4_CONNECT_DIAGNOSTICS:ENTERING: com.microchip.mplab.mdbcore.RI4Tool.FirmwareUpdateHandler.GetUpdateInfo()
477 1741642363977 GEN4_CONNECT_DIAGNOSTICS:Parsing file  for firmware updates
477 1741642363977 GEN4_CONNECT_DIAGNOSTICS:ENTERING: com.microchip.mplab.mdbcore.RI4Tool.FirmwareUpdateHandler.ri4ParseSelectedVersionsFromJamFile()
477 1741642363977 GEN4_CONNECT_DIAGNOSTICS:Jame file line = app.hex,020138
477 1741642363977 GEN4_CONNECT_DIAGNOSTICS:Jame file line = boot.hex,000010
477 1741642363977 GEN4_CONNECT_DIAGNOSTICS:Jame file line = scripts.xml,000671
477 1741642363977 GEN4_CONNECT_DIAGNOSTICS:Selected firmware version for Boot = 00.00.10
477 1741642363977 GEN4_CONNECT_DIAGNOSTICS:Selected firmware version for ap = 02.01.38
477 1741642363977 GEN4_CONNECT_DIAGNOSTICS:EXITING: com.microchip.mplab.mdbcore.RI4Tool.FirmwareUpdateHandler.ri4ParseSelectedVersionsFromJamFile()
477 1741642363977 GEN4_CONNECT_DIAGNOSTICS:EXITING: com.microchip.mplab.mdbcore.RI4Tool.FirmwareUpdateHandler.GetUpdateInfo()
477 1741642363977 GEN4_CONNECT_DIAGNOSTICS:ENTERING: com.microchip.mplab.mdbcore.RI4Tool.FirmwareUpdateHandler.updateRI4ToolsFirmware(FirmwareInfo, UpdateMessage)
477 1741642363981 GEN4_CONNECT_DIAGNOSTICS:appNeedsUpdate returned false
477 1741642363981 GEN4_CONNECT_DIAGNOSTICS:EXITING: com.microchip.mplab.mdbcore.RI4Tool.FirmwareUpdateHandler.updateRI4ToolsFirmware(FirmwareInfo, UpdateMessage)
477 1741642363981 GEN4_CONNECT_DIAGNOSTICS:EXITING: com.microchip.mplab.mdbcore.RI4Tool.ConnectionHandler.CheckForFWUpdates()

477 1741642363983 GEN4_TO_CONTROLLER_LOG:GEN4_CONNECT_INT_LOG_PIC24FJ128GL306 Pre:SetPowerInfo
477 1741642363983 GEN4_TO_CONTROLLER_LOG:GEN4_CONNECT_INT_LOG_PIC24FJ128GL306 Payload
477 1741642363983 GEN4_TO_CONTROLLER_LOG:GEN4_CONNECT_INT_LOG_PIC24FJ128GL306 PowerInfo: Values:
477 1741642363983 GEN4_TO_CONTROLLER_LOG:GEN4_CONNECT_INT_LOG_PIC24FJ128GL306 PowerInfo: shotDownSystem = false, isToolPower = false, voltage = 3.250000, useVppFirst = false, useLowVoltageProgramming = true, useMaintainActivePower = false
477 1741642363983 GEN4_TO_CONTROLLER_LOG:GEN4_CONNECT_INT_LOG_PIC24FJ128GL306 Payload End
477 1741642363983 XXXX 1741642363983, Thread 477: XXXX 1741642363983, Entering Thread 477: Commands::runScriptBasic with script contents. contents[0] = 0x39, ...  
477 1741642363985 GEN4_CONNECT_DIAGNOSTICS:MPLABCommTool is null

477 1741642363985 GEN4_TO_CONTROLLER_LOG:GEN4_CONNECT_INT_LOG_PIC24FJ128GL306 Pre:GetFirmwareInfo
477 1741642363985 GEN4_TO_CONTROLLER_LOG:GEN4_CONNECT_INT_LOG_PIC24FJ128GL306 Payload
477 1741642363985 GEN4_TO_CONTROLLER_LOG:GEN4_CONNECT_INT_LOG_PIC24FJ128GL306 null
477 1741642363985 GEN4_TO_CONTROLLER_LOG:GEN4_CONNECT_INT_LOG_PIC24FJ128GL306 Payload End
477 1741642363986 GEN4_CONNECT_DIAGNOSTICS:Removing plug and play observer com.microchip.mplab.mdbcore.RI4Tool.RI4ToolBase$RI4PlugNPlayObserver@65a99556
477 1741642363986 GEN4_CONNECT_DIAGNOSTICS:Begin PlugNPlayObservers list dump:
477 1741642363986 GEN4_CONNECT_DIAGNOSTICS:End PlugNPlayObservers list dump:
477 1741642364037 GEN4_CONNECT_DIAGNOSTICS:Calling RIDbgToolCom.Disconnect
477 1741642364037 GEN4_CONNECT_DIAGNOSTICS:Calling MPLABCommTool.Detach to remove tool from plug and play list
477 1741642364037 GEN4_CONNECT_DIAGNOSTICS:Calling RIDbgToolCom.DisconnectFromMPlabComm
477 1741642364037 GEN4_CONNECT_DIAGNOSTICS:Calling MPLABCommTool.Disconnect
491 1741642374332 GEN4_CONNECT_DIAGNOSTICS:MPLABCommTool is NOT null
491 1741642374332 GEN4_CONNECT_DIAGNOSTICS:AttachedToolPID = 9036, AttachedToolVID = 4d8
491 1741642374332 GEN4_CONNECT_DIAGNOSTICS:transport type = USB
491 1741642374332 GEN4_CONNECT_DIAGNOSTICS:AttachedToolPID = 9036, AttachedToolVID = 4d8
491 1741642374335 com.microchip.mplab.mdbcore.RealICETool.RIDbgToolCom
491 1741642374335 GEN4_CONNECT_DIAGNOSTICS:Before MPLABCommTool.Connect()
491 1741642374337 GEN4_CONNECT_DIAGNOSTICS:After MPLABCommTool.Connect()
491 1741642374337 GEN4_CONNECT_DIAGNOSTICS:MPLABCommTool.Connect() returned MPLABCOMM_NO_ERROR
491 1741642374337 GEN4_CONNECT_DIAGNOSTICS:Attaching to MPLABCommTool plugnplay
491 1741642374337 GEN4_CONNECT_DIAGNOSTICS:Adding new plug and play observer com.microchip.mplab.mdbcore.RI4Tool.RI4ToolBase$RI4PlugNPlayObserver@185c4a37
491 1741642374337 GEN4_CONNECT_DIAGNOSTICS:Begin PlugNPlayObservers list dump:
491 1741642374337 GEN4_CONNECT_DIAGNOSTICS:com.microchip.mplab.mdbcore.RI4Tool.RI4ToolBase$RI4PlugNPlayObserver@185c4a37
491 1741642374337 GEN4_CONNECT_DIAGNOSTICS:End PlugNPlayObservers list dump:
491 1741642374337 GEN4_CONNECT_DIAGNOSTICS:Registering for alternate PNP notifications. CommPnPCriteria.cPIDList = [9035], CommPnPCriteria.cSerialNumber = 020026702ryn038688

491 1741642374415 GEN4_TO_CONTROLLER_LOG:GEN4_INIT_INT_LOG_PIC24FJ128GL306 Pre:init
491 1741642374415 GEN4_TO_CONTROLLER_LOG:GEN4_INIT_INT_LOG_PIC24FJ128GL306 Payload
491 1741642374415 GEN4_TO_CONTROLLER_LOG:GEN4_INIT_INT_LOG_PIC24FJ128GL306 DeviceInfo: Values:
491 1741642374415 GEN4_TO_CONTROLLER_LOG:GEN4_INIT_INT_LOG_PIC24FJ128GL306 DeviceInfo: pcAddress = 0000002e, Vpp = 3.25, useRowEraseIfVoltageIsLow = false, voltageBelowWhichUseRowErase = 0.00, deviceName = PIC24FJ128GL306, programmerType = PIC24FJ
491 1741642374415 GEN4_TO_CONTROLLER_LOG:GEN4_INIT_INT_LOG_PIC24FJ128GL306 DeviceInfo: MemInfo values:
491 1741642374415 GEN4_TO_CONTROLLER_LOG:GEN4_INIT_INT_LOG_PIC24FJ128GL306 DeviceInfo: mask = ffffff, exists = true, startAddr = 00000000, endAddr = 00015eff, rowSize = 0800, rowEraseSize = 0800, addrInc = 0002, widthProgram = 0004
491 1741642374415 GEN4_TO_CONTROLLER_LOG:GEN4_INIT_INT_LOG_PIC24FJ128GL306 DeviceInfo: mask = ffffff, exists = true, startAddr = 00015f00, endAddr = 00015fff, rowSize = 0001, rowEraseSize = 0000, addrInc = 0002, widthProgram = 0004
491 1741642374415 GEN4_TO_CONTROLLER_LOG:GEN4_INIT_INT_LOG_PIC24FJ128GL306 DeviceInfo: mask = 0000, exists = false, startAddr = 00000000, endAddr = 00000000, rowSize = 0000, rowEraseSize = 0000, addrInc = 0000, widthProgram = 0000
491 1741642374415 GEN4_TO_CONTROLLER_LOG:GEN4_INIT_INT_LOG_PIC24FJ128GL306 DeviceInfo: mask = 0000, exists = false, startAddr = 00000000, endAddr = 00000000, rowSize = 0000, rowEraseSize = 0000, addrInc = 0000, widthProgram = 0000
491 1741642374415 GEN4_TO_CONTROLLER_LOG:GEN4_INIT_INT_LOG_PIC24FJ128GL306 DeviceInfo: mask = 0000, exists = false, startAddr = 00000000, endAddr = 00000000, rowSize = 0000, rowEraseSize = 0000, addrInc = 0000, widthProgram = 0000
491 1741642374415 GEN4_TO_CONTROLLER_LOG:GEN4_INIT_INT_LOG_PIC24FJ128GL306 DeviceInfo: mask = ffffff, exists = true, startAddr = 00800000, endAddr = 008017ff, rowSize = 0800, rowEraseSize = 0800, addrInc = 0002, widthProgram = 0004
491 1741642374415 GEN4_TO_CONTROLLER_LOG:GEN4_INIT_INT_LOG_PIC24FJ128GL306 DeviceInfo: mask = 0000, exists = false, startAddr = 00000000, endAddr = 00000000, rowSize = 0000, rowEraseSize = 0000, addrInc = 0002, widthProgram = 0002
491 1741642374415 GEN4_TO_CONTROLLER_LOG:GEN4_INIT_INT_LOG_PIC24FJ128GL306 DeviceInfo: mask = 0000, exists = false, startAddr = 00000000, endAddr = 00000000, rowSize = 0000, rowEraseSize = 0000, addrInc = 0000, widthProgram = 0000
491 1741642374415 GEN4_TO_CONTROLLER_LOG:GEN4_INIT_INT_LOG_PIC24FJ128GL306 DeviceInfo: mask = 0000, exists = false, startAddr = 00000000, endAddr = 00000000, rowSize = 0000, rowEraseSize = 0000, addrInc = 0000, widthProgram = 0000
491 1741642374415 GEN4_TO_CONTROLLER_LOG:GEN4_INIT_INT_LOG_PIC24FJ128GL306 DeviceInfo: mask = 0000, exists = false, startAddr = 00000000, endAddr = 00000000, rowSize = 0000, rowEraseSize = 0000, addrInc = 0000, widthProgram = 0000
491 1741642374415 GEN4_TO_CONTROLLER_LOG:GEN4_INIT_INT_LOG_PIC24FJ128GL306 DeviceInfo: mask = 0000, exists = false, startAddr = 00000000, endAddr = 00000000, rowSize = 0000, rowEraseSize = 0000, addrInc = 0002, widthProgram = 0002
491 1741642374415 GEN4_TO_CONTROLLER_LOG:GEN4_INIT_INT_LOG_PIC24FJ128GL306 DeviceInfo: mask = 0000, exists = false, startAddr = 00000000, endAddr = 00000000, rowSize = 0000, rowEraseSize = 0000, addrInc = 0000, widthProgram = 0000
491 1741642374415 GEN4_TO_CONTROLLER_LOG:GEN4_INIT_INT_LOG_PIC24FJ128GL306 DeviceInfo: mask = 0000, exists = false, startAddr = 00000000, endAddr = 00000000, rowSize = 0000, rowEraseSize = 0000, addrInc = 0000, widthProgram = 0000
491 1741642374415 GEN4_TO_CONTROLLER_LOG:GEN4_INIT_INT_LOG_PIC24FJ128GL306 DeviceInfo: mask = ffffff, exists = true, startAddr = 00801700, endAddr = 008017ff, rowSize = 0001, rowEraseSize = 0000, addrInc = 0002, widthProgram = 0004
491 1741642374415 GEN4_TO_CONTROLLER_LOG:GEN4_INIT_INT_LOG_PIC24FJ128GL306 DeviceInfo: mask = 0000, exists = false, startAddr = 00000000, endAddr = 00000000, rowSize = 0000, rowEraseSize = 0000, addrInc = 0000, widthProgram = 0000
491 1741642374415 GEN4_TO_CONTROLLER_LOG:GEN4_INIT_INT_LOG_PIC24FJ128GL306 DeviceInfo: mask = 0000, exists = false, startAddr = 00000000, endAddr = 00000000, rowSize = 0000, rowEraseSize = 0000, addrInc = 0000, widthProgram = 0000
491 1741642374415 GEN4_TO_CONTROLLER_LOG:GEN4_INIT_INT_LOG_PIC24FJ128GL306 DeviceInfo: mask = 7fffffff, exists = true, startAddr = 00ff0000, endAddr = 00ff0003, rowSize = 0001, rowEraseSize = 0000, addrInc = 0001, widthProgram = 0001
491 1741642374415 GEN4_TO_CONTROLLER_LOG:GEN4_INIT_INT_LOG_PIC24FJ128GL306 DeviceInfo: mask = 0000, exists = false, startAddr = 00000000, endAddr = 00000000, rowSize = 0000, rowEraseSize = 0000, addrInc = 0000, widthProgram = 0000
491 1741642374415 GEN4_TO_CONTROLLER_LOG:GEN4_INIT_INT_LOG_PIC24FJ128GL306 DeviceInfo: mask = 0000, exists = false, startAddr = 00000000, endAddr = 00000000, rowSize = 0000, rowEraseSize = 0000, addrInc = 0000, widthProgram = 0000
491 1741642374415 GEN4_TO_CONTROLLER_LOG:GEN4_INIT_INT_LOG_PIC24FJ128GL306 DeviceInfo: mask = 0000, exists = false, startAddr = 00000000, endAddr = 00000000, rowSize = 0000, rowEraseSize = 0000, addrInc = 0000, widthProgram = 0000
491 1741642374415 GEN4_TO_CONTROLLER_LOG:GEN4_INIT_INT_LOG_PIC24FJ128GL306 DeviceInfo: mask = 0000, exists = false, startAddr = 00000000, endAddr = 00000000, rowSize = 0000, rowEraseSize = 0000, addrInc = 0000, widthProgram = 0000
491 1741642374415 GEN4_TO_CONTROLLER_LOG:GEN4_INIT_INT_LOG_PIC24FJ128GL306 DeviceInfo: mask = 0000, exists = false, startAddr = 00000000, endAddr = 00000000, rowSize = 0000, rowEraseSize = 0000, addrInc = 0000, widthProgram = 0000
491 1741642374415 GEN4_TO_CONTROLLER_LOG:GEN4_INIT_INT_LOG_PIC24FJ128GL306 DeviceInfo: mask = 0000, exists = true, startAddr = 00801600, endAddr = 00801609, rowSize = 0000, rowEraseSize = 0000, addrInc = 0002, widthProgram = 0004
491 1741642374415 GEN4_TO_CONTROLLER_LOG:GEN4_INIT_INT_LOG_PIC24FJ128GL306 DeviceInfo: CfgRequiredBitsMask Values:
491 1741642374416 GEN4_TO_CONTROLLER_LOG:GEN4_INIT_INT_LOG_PIC24FJ128GL306 Address = 00015f00, Mask = 00008fef
491 1741642374416 GEN4_TO_CONTROLLER_LOG:GEN4_INIT_INT_LOG_PIC24FJ128GL306 Address = 00015f10, Mask = 00001fff
491 1741642374416 GEN4_TO_CONTROLLER_LOG:GEN4_INIT_INT_LOG_PIC24FJ128GL306 Address = 00015f14, Mask = 00ff7fff
491 1741642374416 GEN4_TO_CONTROLLER_LOG:GEN4_INIT_INT_LOG_PIC24FJ128GL306 Address = 00015f18, Mask = 000000ff
491 1741642374416 GEN4_TO_CONTROLLER_LOG:GEN4_INIT_INT_LOG_PIC24FJ128GL306 Address = 00015f1c, Mask = 000000ff
491 1741642374416 GEN4_TO_CONTROLLER_LOG:GEN4_INIT_INT_LOG_PIC24FJ128GL306 Address = 00015f20, Mask = 00006bff
491 1741642374416 GEN4_TO_CONTROLLER_LOG:GEN4_INIT_INT_LOG_PIC24FJ128GL306 Address = 00015f24, Mask = 0000000f
491 1741642374416 GEN4_TO_CONTROLLER_LOG:GEN4_INIT_INT_LOG_PIC24FJ128GL306 Address = 00015f28, Mask = 00000003
491 1741642374416 GEN4_TO_CONTROLLER_LOG:GEN4_INIT_INT_LOG_PIC24FJ128GL306 Address = 00015f2c, Mask = 0000ffff
491 1741642374416 GEN4_TO_CONTROLLER_LOG:GEN4_INIT_INT_LOG_PIC24FJ128GL306 Address = 00015f30, Mask = 0000ffff
491 1741642374416 GEN4_TO_CONTROLLER_LOG:GEN4_INIT_INT_LOG_PIC24FJ128GL306 Address = 00015f34, Mask = 0000ffff
491 1741642374416 GEN4_TO_CONTROLLER_LOG:GEN4_INIT_INT_LOG_PIC24FJ128GL306 Address = 00015f38, Mask = 0000ffff
491 1741642374416 GEN4_TO_CONTROLLER_LOG:GEN4_INIT_INT_LOG_PIC24FJ128GL306 Address = 00015f3c, Mask = 00000001
491 1741642374416 GEN4_TO_CONTROLLER_LOG:GEN4_INIT_INT_LOG_PIC24FJ128GL306 Address = 00015f40, Mask = 0000041e
491 1741642374416 GEN4_TO_CONTROLLER_LOG:GEN4_INIT_INT_LOG_PIC24FJ128GL306 BasicInfo: Values:
491 1741642374416 GEN4_TO_CONTROLLER_LOG:GEN4_INIT_INT_LOG_PIC24FJ128GL306 BasicInfo: InputStream = com.microchip.mplab.libs.toolpacksupport.EquatableFileInputStream@a3c86b5, ToolFlavor = PIC32C
491 1741642374416 GEN4_TO_CONTROLLER_LOG:GEN4_INIT_INT_LOG_PIC24FJ128GL306 Payload End
491 1741642374417 GEN4_TO_CONTROLLER_LOG:GEN4_INIT_INT_LOG_PIC24FJ128GL306 Post:init
491 1741642374417 GEN4_TO_CONTROLLER_LOG:GEN4_INIT_INT_LOG_PIC24FJ128GL306 Return Value
491 1741642374417 GEN4_TO_CONTROLLER_LOG:GEN4_INIT_INT_LOG_PIC24FJ128GL306 none
491 1741642374417 GEN4_TO_CONTROLLER_LOG:GEN4_INIT_INT_LOG_PIC24FJ128GL306 Return End

491 1741642374417 GEN4_TO_CONTROLLER_LOG:GEN4_INIT_INT_LOG_PIC24FJ128GL306 Pre:GetInterfaceProvider
491 1741642374417 GEN4_TO_CONTROLLER_LOG:GEN4_INIT_INT_LOG_PIC24FJ128GL306 Payload
491 1741642374417 GEN4_TO_CONTROLLER_LOG:GEN4_INIT_INT_LOG_PIC24FJ128GL306 RI4DebugInterface
491 1741642374417 GEN4_TO_CONTROLLER_LOG:GEN4_INIT_INT_LOG_PIC24FJ128GL306 Payload End
491 1741642374417 GEN4_TO_CONTROLLER_LOG:GEN4_INIT_INT_LOG_PIC24FJ128GL306 Post:GetInterfaceProvider
491 1741642374417 GEN4_TO_CONTROLLER_LOG:GEN4_INIT_INT_LOG_PIC24FJ128GL306 Return Value
491 1741642374417 GEN4_TO_CONTROLLER_LOG:GEN4_INIT_INT_LOG_PIC24FJ128GL306 com.microchip.mplab.libs.RI4ToolsController.implementations.RI4DebugInterfaceImpl@1432ba0b
491 1741642374417 GEN4_TO_CONTROLLER_LOG:GEN4_INIT_INT_LOG_PIC24FJ128GL306 Return End

491 1741642374429 GEN4_TO_CONTROLLER_LOG:GEN4_INIT_INT_LOG_PIC24FJ128GL306 Pre:GetInterfaceProvider
491 1741642374429 GEN4_TO_CONTROLLER_LOG:GEN4_INIT_INT_LOG_PIC24FJ128GL306 Payload
491 1741642374429 GEN4_TO_CONTROLLER_LOG:GEN4_INIT_INT_LOG_PIC24FJ128GL306 RI4ProgramInterface
491 1741642374429 GEN4_TO_CONTROLLER_LOG:GEN4_INIT_INT_LOG_PIC24FJ128GL306 Payload End
491 1741642374429 GEN4_TO_CONTROLLER_LOG:GEN4_INIT_INT_LOG_PIC24FJ128GL306 Post:GetInterfaceProvider
491 1741642374429 GEN4_TO_CONTROLLER_LOG:GEN4_INIT_INT_LOG_PIC24FJ128GL306 Return Value
491 1741642374429 GEN4_TO_CONTROLLER_LOG:GEN4_INIT_INT_LOG_PIC24FJ128GL306 com.microchip.mplab.libs.RI4ToolsController.implementations.RI4ProgramInterfaceImpl@66e5c5d3
491 1741642374429 GEN4_TO_CONTROLLER_LOG:GEN4_INIT_INT_LOG_PIC24FJ128GL306 Return End

491 1741642374429 GEN4_TO_CONTROLLER_LOG:GEN4_INIT_INT_LOG_PIC24FJ128GL306 Pre:GetInterfaceProvider
491 1741642374429 GEN4_TO_CONTROLLER_LOG:GEN4_INIT_INT_LOG_PIC24FJ128GL306 Payload
491 1741642374429 GEN4_TO_CONTROLLER_LOG:GEN4_INIT_INT_LOG_PIC24FJ128GL306 RI4ConnectInterface
491 1741642374429 GEN4_TO_CONTROLLER_LOG:GEN4_INIT_INT_LOG_PIC24FJ128GL306 Payload End
491 1741642374429 GEN4_TO_CONTROLLER_LOG:GEN4_INIT_INT_LOG_PIC24FJ128GL306 Post:GetInterfaceProvider
491 1741642374429 GEN4_TO_CONTROLLER_LOG:GEN4_INIT_INT_LOG_PIC24FJ128GL306 Return Value
491 1741642374429 GEN4_TO_CONTROLLER_LOG:GEN4_INIT_INT_LOG_PIC24FJ128GL306 com.microchip.mplab.libs.PK4ToolsController.PK4ConnectInterfaceImpl@1c1236ca
491 1741642374429 GEN4_TO_CONTROLLER_LOG:GEN4_INIT_INT_LOG_PIC24FJ128GL306 Return End

491 1741642374429 GEN4_TO_CONTROLLER_LOG:GEN4_INIT_INT_LOG_PIC24FJ128GL306 Pre:GetInterfaceProvider
491 1741642374429 GEN4_TO_CONTROLLER_LOG:GEN4_INIT_INT_LOG_PIC24FJ128GL306 Payload
491 1741642374429 GEN4_TO_CONTROLLER_LOG:GEN4_INIT_INT_LOG_PIC24FJ128GL306 RI4ControllerDiagnosticsInterface
491 1741642374429 GEN4_TO_CONTROLLER_LOG:GEN4_INIT_INT_LOG_PIC24FJ128GL306 Payload End
491 1741642374429 GEN4_TO_CONTROLLER_LOG:GEN4_INIT_INT_LOG_PIC24FJ128GL306 Post:GetInterfaceProvider
491 1741642374429 GEN4_TO_CONTROLLER_LOG:GEN4_INIT_INT_LOG_PIC24FJ128GL306 Return Value
491 1741642374433 GEN4_TO_CONTROLLER_LOG:GEN4_INIT_INT_LOG_PIC24FJ128GL306 com.microchip.mplab.libs.RI4ToolsController.implementations.RI4ControllerDiagnosticsInterfaceImpl@24fbe958
491 1741642374433 GEN4_TO_CONTROLLER_LOG:GEN4_INIT_INT_LOG_PIC24FJ128GL306 Return End

491 1741642374433 GEN4_TO_CONTROLLER_LOG:GEN4_INIT_INT_LOG_PIC24FJ128GL306 Pre:GetInterfaceProvider
491 1741642374433 GEN4_TO_CONTROLLER_LOG:GEN4_INIT_INT_LOG_PIC24FJ128GL306 Payload
491 1741642374433 GEN4_TO_CONTROLLER_LOG:GEN4_INIT_INT_LOG_PIC24FJ128GL306 ProgrammerToGo
491 1741642374433 GEN4_TO_CONTROLLER_LOG:GEN4_INIT_INT_LOG_PIC24FJ128GL306 Payload End
491 1741642374433 GEN4_TO_CONTROLLER_LOG:GEN4_INIT_INT_LOG_PIC24FJ128GL306 Post:GetInterfaceProvider
491 1741642374433 GEN4_TO_CONTROLLER_LOG:GEN4_INIT_INT_LOG_PIC24FJ128GL306 Return Value
491 1741642374433 GEN4_TO_CONTROLLER_LOG:GEN4_INIT_INT_LOG_PIC24FJ128GL306 com.microchip.mplab.libs.RI4ToolsController.implementations.ProgrammerToGoImpl@2598ed2e
491 1741642374433 GEN4_TO_CONTROLLER_LOG:GEN4_INIT_INT_LOG_PIC24FJ128GL306 Return End

491 1741642374433 GEN4_TO_CONTROLLER_LOG:GEN4_INIT_INT_LOG_PIC24FJ128GL306 Pre:GetInterfaceProvider
491 1741642374433 GEN4_TO_CONTROLLER_LOG:GEN4_INIT_INT_LOG_PIC24FJ128GL306 Payload
491 1741642374433 GEN4_TO_CONTROLLER_LOG:GEN4_INIT_INT_LOG_PIC24FJ128GL306 Status
491 1741642374433 GEN4_TO_CONTROLLER_LOG:GEN4_INIT_INT_LOG_PIC24FJ128GL306 Payload End
491 1741642374433 GEN4_TO_CONTROLLER_LOG:GEN4_INIT_INT_LOG_PIC24FJ128GL306 Post:GetInterfaceProvider
491 1741642374433 GEN4_TO_CONTROLLER_LOG:GEN4_INIT_INT_LOG_PIC24FJ128GL306 Return Value
491 1741642374433 GEN4_TO_CONTROLLER_LOG:GEN4_INIT_INT_LOG_PIC24FJ128GL306 null
491 1741642374433 GEN4_TO_CONTROLLER_LOG:GEN4_INIT_INT_LOG_PIC24FJ128GL306 Return End

491 1741642374463 GEN4_TO_CONTROLLER_LOG:GEN4_PROGRAM_INT_LOG_PIC24FJ128GL306 Pre:SetProgramExec
491 1741642374463 GEN4_TO_CONTROLLER_LOG:GEN4_PROGRAM_INT_LOG_PIC24FJ128GL306 Payload
491 1741642374463 GEN4_TO_CONTROLLER_LOG:GEN4_PROGRAM_INT_LOG_PIC24FJ128GL306 Test
491 1741642374463 GEN4_TO_CONTROLLER_LOG:GEN4_PROGRAM_INT_LOG_PIC24FJ128GL306 800000
491 1741642374463 GEN4_TO_CONTROLLER_LOG:GEN4_PROGRAM_INT_LOG_PIC24FJ128GL306 Length = 3108
491 1741642374463 GEN4_TO_CONTROLLER_LOG:GEN4_PROGRAM_INT_LOG_PIC24FJ128GL306 Payload End
491 1741642374464 GEN4_TO_CONTROLLER_LOG:GEN4_PROGRAM_INT_LOG_PIC24FJ128GL306 Post:SetProgramExec
491 1741642374464 GEN4_TO_CONTROLLER_LOG:GEN4_PROGRAM_INT_LOG_PIC24FJ128GL306 Return Value
491 1741642374464 GEN4_TO_CONTROLLER_LOG:GEN4_PROGRAM_INT_LOG_PIC24FJ128GL306 true
491 1741642374464 GEN4_TO_CONTROLLER_LOG:GEN4_PROGRAM_INT_LOG_PIC24FJ128GL306 Return End

491 1741642374469 GEN4_TO_CONTROLLER_LOG:GEN4_PROGRAM_INT_LOG_PIC24FJ128GL306 Pre:SetDebugExec
491 1741642374469 GEN4_TO_CONTROLLER_LOG:GEN4_PROGRAM_INT_LOG_PIC24FJ128GL306 Payload
491 1741642374469 GEN4_TO_CONTROLLER_LOG:GEN4_PROGRAM_INT_LOG_PIC24FJ128GL306 Test
491 1741642374469 GEN4_TO_CONTROLLER_LOG:GEN4_PROGRAM_INT_LOG_PIC24FJ128GL306 800000
491 1741642374469 GEN4_TO_CONTROLLER_LOG:GEN4_PROGRAM_INT_LOG_PIC24FJ128GL306 Length = 2640
491 1741642374469 GEN4_TO_CONTROLLER_LOG:GEN4_PROGRAM_INT_LOG_PIC24FJ128GL306 Payload End
491 1741642374470 GEN4_TO_CONTROLLER_LOG:GEN4_PROGRAM_INT_LOG_PIC24FJ128GL306 Post:SetDebugExec
491 1741642374470 GEN4_TO_CONTROLLER_LOG:GEN4_PROGRAM_INT_LOG_PIC24FJ128GL306 Return Value
491 1741642374470 GEN4_TO_CONTROLLER_LOG:GEN4_PROGRAM_INT_LOG_PIC24FJ128GL306 true
491 1741642374470 GEN4_TO_CONTROLLER_LOG:GEN4_PROGRAM_INT_LOG_PIC24FJ128GL306 Return End

491 1741642374470 GEN4_TO_CONTROLLER_LOG:GEN4_CONNECT_INT_LOG_PIC24FJ128GL306 Pre:EstablishCommunincations
491 1741642374470 GEN4_TO_CONTROLLER_LOG:GEN4_CONNECT_INT_LOG_PIC24FJ128GL306 Payload
491 1741642374470 GEN4_TO_CONTROLLER_LOG:GEN4_CONNECT_INT_LOG_PIC24FJ128GL306 com.microchip.mplab.mdbcore.PK5Tool.PK5Com@49c149b0
491 1741642374470 GEN4_TO_CONTROLLER_LOG:GEN4_CONNECT_INT_LOG_PIC24FJ128GL306 Payload End
491 1741642374470 GEN4_TO_CONTROLLER_LOG:GEN4_CONNECT_INT_LOG_PIC24FJ128GL306 Post:EstablishCommunincations
491 1741642374470 GEN4_TO_CONTROLLER_LOG:GEN4_CONNECT_INT_LOG_PIC24FJ128GL306 Return Value
491 1741642374470 GEN4_TO_CONTROLLER_LOG:GEN4_CONNECT_INT_LOG_PIC24FJ128GL306 true
491 1741642374470 GEN4_TO_CONTROLLER_LOG:GEN4_CONNECT_INT_LOG_PIC24FJ128GL306 Return End

491 1741642374470 GEN4_TO_CONTROLLER_LOG:GEN4_CONNECT_INT_LOG_PIC24FJ128GL306 Pre:GetFirmwareInfo
491 1741642374470 GEN4_TO_CONTROLLER_LOG:GEN4_CONNECT_INT_LOG_PIC24FJ128GL306 Payload
491 1741642374470 GEN4_TO_CONTROLLER_LOG:GEN4_CONNECT_INT_LOG_PIC24FJ128GL306 null
491 1741642374470 GEN4_TO_CONTROLLER_LOG:GEN4_CONNECT_INT_LOG_PIC24FJ128GL306 Payload End
