karliedapuzzo/TDWS/TDWS_PIC24_FILES/Test_projects/LoRaReceiverTesting.X/queuelogs/debugtool.txt

408 1737143571713 GEN4_CONNECT_DIAGNOSTICS:MPLABCommTool is null

408 1737143571713 GEN4_TO_CONTROLLER_LOG:GEN4_CONNECT_INT_LOG_PIC24FJ128GL306 Pre:GetFirmwareInfo
408 1737143571713 GEN4_TO_CONTROLLER_LOG:GEN4_CONNECT_INT_LOG_PIC24FJ128GL306 Payload
408 1737143571713 GEN4_TO_CONTROLLER_LOG:GEN4_CONNECT_INT_LOG_PIC24FJ128GL306 null
408 1737143571713 GEN4_TO_CONTROLLER_LOG:GEN4_CONNECT_INT_LOG_PIC24FJ128GL306 Payload End
408 1737143581713 XXXX 1737143581713, Thread 408: com.Send returned false 
408 1737143581713 XXXX 1737143581713, Thread 408: execCommand: exception after writeSideChanel null 
408 1737143581715 GEN4_CONNECT_DIAGNOSTICS:Removing plug and play observer com.microchip.mplab.mdbcore.RI4Tool.RI4ToolBase$RI4PlugNPlayObserver@224249c0
408 1737143581715 GEN4_CONNECT_DIAGNOSTICS:Begin PlugNPlayObservers list dump:
408 1737143581715 GEN4_CONNECT_DIAGNOSTICS:End PlugNPlayObservers list dump:
408 1737143581768 GEN4_CONNECT_DIAGNOSTICS:Calling RIDbgToolCom.Disconnect
408 1737143581768 GEN4_CONNECT_DIAGNOSTICS:Calling MPLABCommTool.Detach to remove tool from plug and play list
408 1737143581768 GEN4_CONNECT_DIAGNOSTICS:Calling RIDbgToolCom.DisconnectFromMPlabComm
408 1737143581768 GEN4_CONNECT_DIAGNOSTICS:Calling MPLABCommTool.Disconnect
432 1737143588557 GEN4_CONNECT_DIAGNOSTICS:MPLABCommTool is NOT null
432 1737143588557 GEN4_CONNECT_DIAGNOSTICS:AttachedToolPID = 810b, AttachedToolVID = 4d8
432 1737143588557 GEN4_CONNECT_DIAGNOSTICS:transport type = USB
432 1737143588557 GEN4_CONNECT_DIAGNOSTICS:AttachedToolPID = 810b, AttachedToolVID = 4d8
432 1737143588561 com.microchip.mplab.mdbcore.RealICETool.RIDbgToolCom
432 1737143588561 GEN4_CONNECT_DIAGNOSTICS:Before MPLABCommTool.Connect()
432 1737143588563 GEN4_CONNECT_DIAGNOSTICS:After MPLABCommTool.Connect()
432 1737143588563 GEN4_CONNECT_DIAGNOSTICS:MPLABCommTool.Connect() returned MPLABCOMM_NO_ERROR
432 1737143588563 GEN4_CONNECT_DIAGNOSTICS:Attaching to MPLABCommTool plugnplay
432 1737143588563 GEN4_CONNECT_DIAGNOSTICS:Adding new plug and play observer com.microchip.mplab.mdbcore.RI4Tool.RI4ToolBase$RI4PlugNPlayObserver@76969fdb
432 1737143588563 GEN4_CONNECT_DIAGNOSTICS:Begin PlugNPlayObservers list dump:
432 1737143588563 GEN4_CONNECT_DIAGNOSTICS:com.microchip.mplab.mdbcore.RI4Tool.RI4ToolBase$RI4PlugNPlayObserver@76969fdb
432 1737143588563 GEN4_CONNECT_DIAGNOSTICS:End PlugNPlayObservers list dump:
432 1737143588563 GEN4_CONNECT_DIAGNOSTICS:Registering for alternate PNP notifications. CommPnPCriteria.cPIDList = [810A, 8109, 2184], CommPnPCriteria.cSerialNumber = bur204820193

432 1737143588609 GEN4_TO_CONTROLLER_LOG:GEN4_INIT_INT_LOG_PIC24FJ128GL306 Pre:init
432 1737143588609 GEN4_TO_CONTROLLER_LOG:GEN4_INIT_INT_LOG_PIC24FJ128GL306 Payload
432 1737143588609 GEN4_TO_CONTROLLER_LOG:GEN4_INIT_INT_LOG_PIC24FJ128GL306 DeviceInfo: Values:
432 1737143588609 GEN4_TO_CONTROLLER_LOG:GEN4_INIT_INT_LOG_PIC24FJ128GL306 DeviceInfo: pcAddress = 0000002e, Vpp = 3.25, useRowEraseIfVoltageIsLow = false, voltageBelowWhichUseRowErase = 0.00, deviceName = PIC24FJ128GL306, programmerType = PIC24FJ
432 1737143588609 GEN4_TO_CONTROLLER_LOG:GEN4_INIT_INT_LOG_PIC24FJ128GL306 DeviceInfo: MemInfo values:
432 1737143588609 GEN4_TO_CONTROLLER_LOG:GEN4_INIT_INT_LOG_PIC24FJ128GL306 DeviceInfo: mask = ffffff, exists = true, startAddr = 00000000, endAddr = 00015eff, rowSize = 0800, rowEraseSize = 0800, addrInc = 0002, widthProgram = 0004
432 1737143588609 GEN4_TO_CONTROLLER_LOG:GEN4_INIT_INT_LOG_PIC24FJ128GL306 DeviceInfo: mask = ffffff, exists = true, startAddr = 00015f00, endAddr = 00015fff, rowSize = 0001, rowEraseSize = 0000, addrInc = 0002, widthProgram = 0004
432 1737143588609 GEN4_TO_CONTROLLER_LOG:GEN4_INIT_INT_LOG_PIC24FJ128GL306 DeviceInfo: mask = 0000, exists = false, startAddr = 00000000, endAddr = 00000000, rowSize = 0000, rowEraseSize = 0000, addrInc = 0000, widthProgram = 0000
432 1737143588609 GEN4_TO_CONTROLLER_LOG:GEN4_INIT_INT_LOG_PIC24FJ128GL306 DeviceInfo: mask = 0000, exists = false, startAddr = 00000000, endAddr = 00000000, rowSize = 0000, rowEraseSize = 0000, addrInc = 0000, widthProgram = 0000
432 1737143588609 GEN4_TO_CONTROLLER_LOG:GEN4_INIT_INT_LOG_PIC24FJ128GL306 DeviceInfo: mask = 0000, exists = false, startAddr = 00000000, endAddr = 00000000, rowSize = 0000, rowEraseSize = 0000, addrInc = 0000, widthProgram = 0000
432 1737143588609 GEN4_TO_CONTROLLER_LOG:GEN4_INIT_INT_LOG_PIC24FJ128GL306 DeviceInfo: mask = ffffff, exists = true, startAddr = 00800000, endAddr = 008017ff, rowSize = 0800, rowEraseSize = 0800, addrInc = 0002, widthProgram = 0004
432 1737143588609 GEN4_TO_CONTROLLER_LOG:GEN4_INIT_INT_LOG_PIC24FJ128GL306 DeviceInfo: mask = 0000, exists = false, startAddr = 00000000, endAddr = 00000000, rowSize = 0000, rowEraseSize = 0000, addrInc = 0002, widthProgram = 0002
432 1737143588609 GEN4_TO_CONTROLLER_LOG:GEN4_INIT_INT_LOG_PIC24FJ128GL306 DeviceInfo: mask = 0000, exists = false, startAddr = 00000000, endAddr = 00000000, rowSize = 0000, rowEraseSize = 0000, addrInc = 0000, widthProgram = 0000
432 1737143588609 GEN4_TO_CONTROLLER_LOG:GEN4_INIT_INT_LOG_PIC24FJ128GL306 DeviceInfo: mask = 0000, exists = false, startAddr = 00000000, endAddr = 00000000, rowSize = 0000, rowEraseSize = 0000, addrInc = 0000, widthProgram = 0000
432 1737143588609 GEN4_TO_CONTROLLER_LOG:GEN4_INIT_INT_LOG_PIC24FJ128GL306 DeviceInfo: mask = 0000, exists = false, startAddr = 00000000, endAddr = 00000000, rowSize = 0000, rowEraseSize = 0000, addrInc = 0000, widthProgram = 0000
432 1737143588609 GEN4_TO_CONTROLLER_LOG:GEN4_INIT_INT_LOG_PIC24FJ128GL306 DeviceInfo: mask = 0000, exists = false, startAddr = 00000000, endAddr = 00000000, rowSize = 0000, rowEraseSize = 0000, addrInc = 0002, widthProgram = 0002
432 1737143588609 GEN4_TO_CONTROLLER_LOG:GEN4_INIT_INT_LOG_PIC24FJ128GL306 DeviceInfo: mask = 0000, exists = false, startAddr = 00000000, endAddr = 00000000, rowSize = 0000, rowEraseSize = 0000, addrInc = 0000, widthProgram = 0000
432 1737143588609 GEN4_TO_CONTROLLER_LOG:GEN4_INIT_INT_LOG_PIC24FJ128GL306 DeviceInfo: mask = 0000, exists = false, startAddr = 00000000, endAddr = 00000000, rowSize = 0000, rowEraseSize = 0000, addrInc = 0000, widthProgram = 0000
432 1737143588609 GEN4_TO_CONTROLLER_LOG:GEN4_INIT_INT_LOG_PIC24FJ128GL306 DeviceInfo: mask = ffffff, exists = true, startAddr = 00801700, endAddr = 008017ff, rowSize = 0001, rowEraseSize = 0000, addrInc = 0002, widthProgram = 0004
432 1737143588609 GEN4_TO_CONTROLLER_LOG:GEN4_INIT_INT_LOG_PIC24FJ128GL306 DeviceInfo: mask = 0000, exists = false, startAddr = 00000000, endAddr = 00000000, rowSize = 0000, rowEraseSize = 0000, addrInc = 0000, widthProgram = 0000
432 1737143588609 GEN4_TO_CONTROLLER_LOG:GEN4_INIT_INT_LOG_PIC24FJ128GL306 DeviceInfo: mask = 0000, exists = false, startAddr = 00000000, endAddr = 00000000, rowSize = 0000, rowEraseSize = 0000, addrInc = 0000, widthProgram = 0000
432 1737143588609 GEN4_TO_CONTROLLER_LOG:GEN4_INIT_INT_LOG_PIC24FJ128GL306 DeviceInfo: mask = 7fffffff, exists = true, startAddr = 00ff0000, endAddr = 00ff0003, rowSize = 0001, rowEraseSize = 0000, addrInc = 0001, widthProgram = 0001
432 1737143588609 GEN4_TO_CONTROLLER_LOG:GEN4_INIT_INT_LOG_PIC24FJ128GL306 DeviceInfo: mask = 0000, exists = false, startAddr = 00000000, endAddr = 00000000, rowSize = 0000, rowEraseSize = 0000, addrInc = 0000, widthProgram = 0000
432 1737143588609 GEN4_TO_CONTROLLER_LOG:GEN4_INIT_INT_LOG_PIC24FJ128GL306 DeviceInfo: mask = 0000, exists = false, startAddr = 00000000, endAddr = 00000000, rowSize = 0000, rowEraseSize = 0000, addrInc = 0000, widthProgram = 0000
432 1737143588609 GEN4_TO_CONTROLLER_LOG:GEN4_INIT_INT_LOG_PIC24FJ128GL306 DeviceInfo: mask = 0000, exists = false, startAddr = 00000000, endAddr = 00000000, rowSize = 0000, rowEraseSize = 0000, addrInc = 0000, widthProgram = 0000
432 1737143588609 GEN4_TO_CONTROLLER_LOG:GEN4_INIT_INT_LOG_PIC24FJ128GL306 DeviceInfo: mask = 0000, exists = false, startAddr = 00000000, endAddr = 00000000, rowSize = 0000, rowEraseSize = 0000, addrInc = 0000, widthProgram = 0000
432 1737143588609 GEN4_TO_CONTROLLER_LOG:GEN4_INIT_INT_LOG_PIC24FJ128GL306 DeviceInfo: mask = 0000, exists = false, startAddr = 00000000, endAddr = 00000000, rowSize = 0000, rowEraseSize = 0000, addrInc = 0000, widthProgram = 0000
432 1737143588609 GEN4_TO_CONTROLLER_LOG:GEN4_INIT_INT_LOG_PIC24FJ128GL306 DeviceInfo: mask = 0000, exists = true, startAddr = 00801600, endAddr = 00801609, rowSize = 0000, rowEraseSize = 0000, addrInc = 0002, widthProgram = 0004
432 1737143588609 GEN4_TO_CONTROLLER_LOG:GEN4_INIT_INT_LOG_PIC24FJ128GL306 CfgRequiredBitsMask Values:
432 1737143588609 GEN4_TO_CONTROLLER_LOG:GEN4_INIT_INT_LOG_PIC24FJ128GL306 Address = 00015f00, Mask = 00008fef
432 1737143588609 GEN4_TO_CONTROLLER_LOG:GEN4_INIT_INT_LOG_PIC24FJ128GL306 Address = 00015f10, Mask = 00001fff
432 1737143588609 GEN4_TO_CONTROLLER_LOG:GEN4_INIT_INT_LOG_PIC24FJ128GL306 Address = 00015f14, Mask = 00ff7fff
432 1737143588609 GEN4_TO_CONTROLLER_LOG:GEN4_INIT_INT_LOG_PIC24FJ128GL306 Address = 00015f18, Mask = 000000ff
432 1737143588609 GEN4_TO_CONTROLLER_LOG:GEN4_INIT_INT_LOG_PIC24FJ128GL306 Address = 00015f1c, Mask = 000000ff
432 1737143588609 GEN4_TO_CONTROLLER_LOG:GEN4_INIT_INT_LOG_PIC24FJ128GL306 Address = 00015f20, Mask = 00006bff
432 1737143588609 GEN4_TO_CONTROLLER_LOG:GEN4_INIT_INT_LOG_PIC24FJ128GL306 Address = 00015f24, Mask = 0000000f
432 1737143588609 GEN4_TO_CONTROLLER_LOG:GEN4_INIT_INT_LOG_PIC24FJ128GL306 Address = 00015f28, Mask = 00000003
432 1737143588609 GEN4_TO_CONTROLLER_LOG:GEN4_INIT_INT_LOG_PIC24FJ128GL306 Address = 00015f2c, Mask = 0000ffff
432 1737143588609 GEN4_TO_CONTROLLER_LOG:GEN4_INIT_INT_LOG_PIC24FJ128GL306 Address = 00015f30, Mask = 0000ffff
432 1737143588609 GEN4_TO_CONTROLLER_LOG:GEN4_INIT_INT_LOG_PIC24FJ128GL306 Address = 00015f34, Mask = 0000ffff
432 1737143588609 GEN4_TO_CONTROLLER_LOG:GEN4_INIT_INT_LOG_PIC24FJ128GL306 Address = 00015f38, Mask = 0000ffff
432 1737143588609 GEN4_TO_CONTROLLER_LOG:GEN4_INIT_INT_LOG_PIC24FJ128GL306 Address = 00015f3c, Mask = 00000001
432 1737143588609 GEN4_TO_CONTROLLER_LOG:GEN4_INIT_INT_LOG_PIC24FJ128GL306 Address = 00015f40, Mask = 0000041e
432 1737143588609 GEN4_TO_CONTROLLER_LOG:GEN4_INIT_INT_LOG_PIC24FJ128GL306 BasicInfo: Values:
432 1737143588609 GEN4_TO_CONTROLLER_LOG:GEN4_INIT_INT_LOG_PIC24FJ128GL306 BasicInfo: InputStream = com.microchip.mplab.libs.toolpacksupport.EquatableFileInputStream@a604c829, ToolFlavor = PICKit4
432 1737143588609 GEN4_TO_CONTROLLER_LOG:GEN4_INIT_INT_LOG_PIC24FJ128GL306 Payload End
432 1737143588610 GEN4_TO_CONTROLLER_LOG:GEN4_INIT_INT_LOG_PIC24FJ128GL306 Post:init
432 1737143588610 GEN4_TO_CONTROLLER_LOG:GEN4_INIT_INT_LOG_PIC24FJ128GL306 Return Value
432 1737143588610 GEN4_TO_CONTROLLER_LOG:GEN4_INIT_INT_LOG_PIC24FJ128GL306 none
432 1737143588610 GEN4_TO_CONTROLLER_LOG:GEN4_INIT_INT_LOG_PIC24FJ128GL306 Return End

432 1737143588610 GEN4_TO_CONTROLLER_LOG:GEN4_INIT_INT_LOG_PIC24FJ128GL306 Pre:GetInterfaceProvider
432 1737143588610 GEN4_TO_CONTROLLER_LOG:GEN4_INIT_INT_LOG_PIC24FJ128GL306 Payload
432 1737143588610 GEN4_TO_CONTROLLER_LOG:GEN4_INIT_INT_LOG_PIC24FJ128GL306 RI4DebugInterface
432 1737143588610 GEN4_TO_CONTROLLER_LOG:GEN4_INIT_INT_LOG_PIC24FJ128GL306 Payload End
432 1737143588610 GEN4_TO_CONTROLLER_LOG:GEN4_INIT_INT_LOG_PIC24FJ128GL306 Post:GetInterfaceProvider
432 1737143588610 GEN4_TO_CONTROLLER_LOG:GEN4_INIT_INT_LOG_PIC24FJ128GL306 Return Value
432 1737143588610 GEN4_TO_CONTROLLER_LOG:GEN4_INIT_INT_LOG_PIC24FJ128GL306 com.microchip.mplab.libs.RI4ToolsController.implementations.RI4DebugInterfaceImpl@2ca71fe4
432 1737143588610 GEN4_TO_CONTROLLER_LOG:GEN4_INIT_INT_LOG_PIC24FJ128GL306 Return End

432 1737143588610 GEN4_TO_CONTROLLER_LOG:GEN4_INIT_INT_LOG_PIC24FJ128GL306 Pre:GetInterfaceProvider
432 1737143588610 GEN4_TO_CONTROLLER_LOG:GEN4_INIT_INT_LOG_PIC24FJ128GL306 Payload
432 1737143588610 GEN4_TO_CONTROLLER_LOG:GEN4_INIT_INT_LOG_PIC24FJ128GL306 RI4ProgramInterface
432 1737143588610 GEN4_TO_CONTROLLER_LOG:GEN4_INIT_INT_LOG_PIC24FJ128GL306 Payload End
432 1737143588610 GEN4_TO_CONTROLLER_LOG:GEN4_INIT_INT_LOG_PIC24FJ128GL306 Post:GetInterfaceProvider
432 1737143588610 GEN4_TO_CONTROLLER_LOG:GEN4_INIT_INT_LOG_PIC24FJ128GL306 Return Value
432 1737143588610 GEN4_TO_CONTROLLER_LOG:GEN4_INIT_INT_LOG_PIC24FJ128GL306 com.microchip.mplab.libs.RI4ToolsController.implementations.RI4ProgramInterfaceImpl@3072ac7e
432 1737143588610 GEN4_TO_CONTROLLER_LOG:GEN4_INIT_INT_LOG_PIC24FJ128GL306 Return End

432 1737143588610 GEN4_TO_CONTROLLER_LOG:GEN4_INIT_INT_LOG_PIC24FJ128GL306 Pre:GetInterfaceProvider
432 1737143588610 GEN4_TO_CONTROLLER_LOG:GEN4_INIT_INT_LOG_PIC24FJ128GL306 Payload
432 1737143588610 GEN4_TO_CONTROLLER_LOG:GEN4_INIT_INT_LOG_PIC24FJ128GL306 RI4ConnectInterface
432 1737143588610 GEN4_TO_CONTROLLER_LOG:GEN4_INIT_INT_LOG_PIC24FJ128GL306 Payload End
432 1737143588610 GEN4_TO_CONTROLLER_LOG:GEN4_INIT_INT_LOG_PIC24FJ128GL306 Post:GetInterfaceProvider
432 1737143588610 GEN4_TO_CONTROLLER_LOG:GEN4_INIT_INT_LOG_PIC24FJ128GL306 Return Value
432 1737143588610 GEN4_TO_CONTROLLER_LOG:GEN4_INIT_INT_LOG_PIC24FJ128GL306 com.microchip.mplab.libs.PK4ToolsController.PK4ConnectInterfaceImpl@72d885ec
432 1737143588610 GEN4_TO_CONTROLLER_LOG:GEN4_INIT_INT_LOG_PIC24FJ128GL306 Return End
432 1737143588610 GEN4_CONNECT_DIAGNOSTICS:acceptablePIDs = [810a, 8109, 810b]
432 1737143588610 GEN4_CONNECT_DIAGNOSTICS:otherPIDs = [2184]
432 1737143588610 GEN4_CONNECT_DIAGNOSTICS:Setting selected tool type to pk4
432 1737143588610 GEN4_CONNECT_DIAGNOSTICS:otherPIDs = [2184]
432 1737143588610 GEN4_CONNECT_DIAGNOSTICS:acceptablePIDs = [810a, 8109, 810b]

432 1737143588610 GEN4_TO_CONTROLLER_LOG:GEN4_INIT_INT_LOG_PIC24FJ128GL306 Pre:GetInterfaceProvider
432 1737143588610 GEN4_TO_CONTROLLER_LOG:GEN4_INIT_INT_LOG_PIC24FJ128GL306 Payload
432 1737143588610 GEN4_TO_CONTROLLER_LOG:GEN4_INIT_INT_LOG_PIC24FJ128GL306 RI4ControllerDiagnosticsInterface
432 1737143588610 GEN4_TO_CONTROLLER_LOG:GEN4_INIT_INT_LOG_PIC24FJ128GL306 Payload End
432 1737143588610 GEN4_TO_CONTROLLER_LOG:GEN4_INIT_INT_LOG_PIC24FJ128GL306 Post:GetInterfaceProvider
432 1737143588610 GEN4_TO_CONTROLLER_LOG:GEN4_INIT_INT_LOG_PIC24FJ128GL306 Return Value
432 1737143588610 GEN4_TO_CONTROLLER_LOG:GEN4_INIT_INT_LOG_PIC24FJ128GL306 com.microchip.mplab.libs.RI4ToolsController.implementations.RI4ControllerDiagnosticsInterfaceImpl@272406e8
432 1737143588610 GEN4_TO_CONTROLLER_LOG:GEN4_INIT_INT_LOG_PIC24FJ128GL306 Return End

432 1737143588610 GEN4_TO_CONTROLLER_LOG:GEN4_INIT_INT_LOG_PIC24FJ128GL306 Pre:GetInterfaceProvider
432 1737143588610 GEN4_TO_CONTROLLER_LOG:GEN4_INIT_INT_LOG_PIC24FJ128GL306 Payload
432 1737143588610 GEN4_TO_CONTROLLER_LOG:GEN4_INIT_INT_LOG_PIC24FJ128GL306 ProgrammerToGo
432 1737143588610 GEN4_TO_CONTROLLER_LOG:GEN4_INIT_INT_LOG_PIC24FJ128GL306 Payload End
432 1737143588610 GEN4_TO_CONTROLLER_LOG:GEN4_INIT_INT_LOG_PIC24FJ128GL306 Post:GetInterfaceProvider
432 1737143588610 GEN4_TO_CONTROLLER_LOG:GEN4_INIT_INT_LOG_PIC24FJ128GL306 Return Value
432 1737143588610 GEN4_TO_CONTROLLER_LOG:GEN4_INIT_INT_LOG_PIC24FJ128GL306 com.microchip.mplab.libs.RI4ToolsController.implementations.ProgrammerToGoImpl@33e865d7
432 1737143588610 GEN4_TO_CONTROLLER_LOG:GEN4_INIT_INT_LOG_PIC24FJ128GL306 Return End

432 1737143588610 GEN4_TO_CONTROLLER_LOG:GEN4_INIT_INT_LOG_PIC24FJ128GL306 Pre:GetInterfaceProvider
432 1737143588610 GEN4_TO_CONTROLLER_LOG:GEN4_INIT_INT_LOG_PIC24FJ128GL306 Payload
432 1737143588610 GEN4_TO_CONTROLLER_LOG:GEN4_INIT_INT_LOG_PIC24FJ128GL306 Status
432 1737143588610 GEN4_TO_CONTROLLER_LOG:GEN4_INIT_INT_LOG_PIC24FJ128GL306 Payload End
432 1737143588610 GEN4_TO_CONTROLLER_LOG:GEN4_INIT_INT_LOG_PIC24FJ128GL306 Post:GetInterfaceProvider
432 1737143588610 GEN4_TO_CONTROLLER_LOG:GEN4_INIT_INT_LOG_PIC24FJ128GL306 Return Value
432 1737143588610 GEN4_TO_CONTROLLER_LOG:GEN4_INIT_INT_LOG_PIC24FJ128GL306 null
432 1737143588610 GEN4_TO_CONTROLLER_LOG:GEN4_INIT_INT_LOG_PIC24FJ128GL306 Return End

432 1737143588616 GEN4_TO_CONTROLLER_LOG:GEN4_PROGRAM_INT_LOG_PIC24FJ128GL306 Pre:SetProgramExec
432 1737143588616 GEN4_TO_CONTROLLER_LOG:GEN4_PROGRAM_INT_LOG_PIC24FJ128GL306 Payload
432 1737143588616 GEN4_TO_CONTROLLER_LOG:GEN4_PROGRAM_INT_LOG_PIC24FJ128GL306 Test
432 1737143588616 GEN4_TO_CONTROLLER_LOG:GEN4_PROGRAM_INT_LOG_PIC24FJ128GL306 800000
432 1737143588616 GEN4_TO_CONTROLLER_LOG:GEN4_PROGRAM_INT_LOG_PIC24FJ128GL306 Length = 3108
432 1737143588616 GEN4_TO_CONTROLLER_LOG:GEN4_PROGRAM_INT_LOG_PIC24FJ128GL306 Payload End
432 1737143588616 GEN4_TO_CONTROLLER_LOG:GEN4_PROGRAM_INT_LOG_PIC24FJ128GL306 Post:SetProgramExec
432 1737143588616 GEN4_TO_CONTROLLER_LOG:GEN4_PROGRAM_INT_LOG_PIC24FJ128GL306 Return Value
432 1737143588616 GEN4_TO_CONTROLLER_LOG:GEN4_PROGRAM_INT_LOG_PIC24FJ128GL306 true
432 1737143588616 GEN4_TO_CONTROLLER_LOG:GEN4_PROGRAM_INT_LOG_PIC24FJ128GL306 Return End

432 1737143588618 GEN4_TO_CONTROLLER_LOG:GEN4_PROGRAM_INT_LOG_PIC24FJ128GL306 Pre:SetDebugExec
432 1737143588618 GEN4_TO_CONTROLLER_LOG:GEN4_PROGRAM_INT_LOG_PIC24FJ128GL306 Payload
432 1737143588618 GEN4_TO_CONTROLLER_LOG:GEN4_PROGRAM_INT_LOG_PIC24FJ128GL306 Test
432 1737143588618 GEN4_TO_CONTROLLER_LOG:GEN4_PROGRAM_INT_LOG_PIC24FJ128GL306 800000
432 1737143588618 GEN4_TO_CONTROLLER_LOG:GEN4_PROGRAM_INT_LOG_PIC24FJ128GL306 Length = 2640
432 1737143588618 GEN4_TO_CONTROLLER_LOG:GEN4_PROGRAM_INT_LOG_PIC24FJ128GL306 Payload End
432 1737143588618 GEN4_TO_CONTROLLER_LOG:GEN4_PROGRAM_INT_LOG_PIC24FJ128GL306 Post:SetDebugExec
432 1737143588618 GEN4_TO_CONTROLLER_LOG:GEN4_PROGRAM_INT_LOG_PIC24FJ128GL306 Return Value
432 1737143588618 GEN4_TO_CONTROLLER_LOG:GEN4_PROGRAM_INT_LOG_PIC24FJ128GL306 true
432 1737143588618 GEN4_TO_CONTROLLER_LOG:GEN4_PROGRAM_INT_LOG_PIC24FJ128GL306 Return End
432 1737143588620 GEN4_CONNECT_DIAGNOSTICS:ENTERING: com.microchip.mplab.mdbcore.RI4Tool.ConnectionHandler.CheckForFWUpdates()
432 1737143588620 GEN4_CONNECT_DIAGNOSTICS:Created FirmwareUpdateHandler com.microchip.mplab.mdbcore.pk4hybrid.pk4hybridFirmwareUpdateHandler@165c3e88
432 1737143588620 GEN4_CONNECT_DIAGNOSTICS:ENTERING: com.microchip.mplab.mdbcore.pk4hybrid.pk4hybridFirmwareUpdateHandler.UpdateFirmware(FirmwareInfo, UpdateMessage)
432 1737143588620 GEN4_CONNECT_DIAGNOSTICS:areWeInBoot returned false
432 1737143588620 GEN4_CONNECT_DIAGNOSTICS:inBoot = false
432 1737143588620 GEN4_CONNECT_DIAGNOSTICS:uMode = checkingVersions
432 1737143588620 GEN4_CONNECT_DIAGNOSTICS:selectedTool = pk4
432 1737143588620 GEN4_CONNECT_DIAGNOSTICS:current toolType = pk4
432 1737143588620 GEN4_CONNECT_DIAGNOSTICS:current tool mode = pk4
432 1737143588620 GEN4_CONNECT_DIAGNOSTICS:ENTERING: com.microchip.mplab.mdbcore.pk4hybrid.pk4hybridFirmwareUpdateHandler.GetUpdateInfo()
432 1737143588620 GEN4_CONNECT_DIAGNOSTICS:Parsing file  for firmware updates
432 1737143588620 GEN4_CONNECT_DIAGNOSTICS:ENTERING: com.microchip.mplab.mdbcore.pk4hybrid.pk4hybridFirmwareUpdateHandler.ParseSelectedVersionsFromJamFile()
432 1737143588620 GEN4_CONNECT_DIAGNOSTICS:Jame file line = pkob4_boot.hex,010141
432 1737143588620 GEN4_CONNECT_DIAGNOSTICS:Jame file line = scripts.xml,000747
432 1737143588620 GEN4_CONNECT_DIAGNOSTICS:Jame file line = pkob4_app1 000747, 0040C000
432 1737143588620 GEN4_CONNECT_DIAGNOSTICS:EXITING: com.microchip.mplab.mdbcore.pk4hybrid.pk4hybridFirmwareUpdateHandler.ri4ParseSelectedVersionsFromJamFile()
432 1737143588620 GEN4_CONNECT_DIAGNOSTICS:EXITING: com.microchip.mplab.mdbcore.pk4hybrid.pk4hybridFirmwareUpdateHandler.GetUpdateInfo()
432 1737143588620 GEN4_CONNECT_DIAGNOSTICS:current toolType = pk4

432 1737143588620 GEN4_TO_CONTROLLER_LOG:GEN4_CONNECT_INT_LOG_PIC24FJ128GL306 Pre:EstablishCommunincations
432 1737143588620 GEN4_TO_CONTROLLER_LOG:GEN4_CONNECT_INT_LOG_PIC24FJ128GL306 Payload
432 1737143588620 GEN4_TO_CONTROLLER_LOG:GEN4_CONNECT_INT_LOG_PIC24FJ128GL306 com.microchip.mplab.mdbcore.PK4Tool.PK4Com@27653046
432 1737143588620 GEN4_TO_CONTROLLER_LOG:GEN4_CONNECT_INT_LOG_PIC24FJ128GL306 Payload End
432 1737143588621 GEN4_TO_CONTROLLER_LOG:GEN4_CONNECT_INT_LOG_PIC24FJ128GL306 Post:EstablishCommunincations
432 1737143588621 GEN4_TO_CONTROLLER_LOG:GEN4_CONNECT_INT_LOG_PIC24FJ128GL306 Return Value
432 1737143588621 GEN4_TO_CONTROLLER_LOG:GEN4_CONNECT_INT_LOG_PIC24FJ128GL306 true
432 1737143588621 GEN4_TO_CONTROLLER_LOG:GEN4_CONNECT_INT_LOG_PIC24FJ128GL306 Return End

432 1737143588621 GEN4_TO_CONTROLLER_LOG:GEN4_CONNECT_INT_LOG_PIC24FJ128GL306 Pre:GetFirmwareInfo
432 1737143588621 GEN4_TO_CONTROLLER_LOG:GEN4_CONNECT_INT_LOG_PIC24FJ128GL306 Payload
432 1737143588621 GEN4_TO_CONTROLLER_LOG:GEN4_CONNECT_INT_LOG_PIC24FJ128GL306 null
432 1737143588621 GEN4_TO_CONTROLLER_LOG:GEN4_CONNECT_INT_LOG_PIC24FJ128GL306 Payload End
441 1737143593480 GEN4_CONNECT_DIAGNOSTICS:MPLABCommTool is null
432 1737143598624 XXXX 1737143598624, Thread 432: com.Send returned false 
432 1737143598624 XXXX 1737143598624, Thread 432: execCommand: exception after writeSideChanel null 

441 1737143598624 GEN4_TO_CONTROLLER_LOG:GEN4_CONNECT_INT_LOG_PIC24FJ128GL306 Pre:GetFirmwareInfo
441 1737143598624 GEN4_TO_CONTROLLER_LOG:GEN4_CONNECT_INT_LOG_PIC24FJ128GL306 Payload
441 1737143598624 GEN4_TO_CONTROLLER_LOG:GEN4_CONNECT_INT_LOG_PIC24FJ128GL306 null
441 1737143598624 GEN4_TO_CONTROLLER_LOG:GEN4_CONNECT_INT_LOG_PIC24FJ128GL306 Payload End
