karliedapuzzo/TDWS/TDWS_PIC24_FILES/Test_projects/LoRa_Testing.X/queuelogs/debugtool.txt

394 1735588382737 GEN4_CONNECT_DIAGNOSTICS:MPLABCommTool is NOT null
394 1735588382738 GEN4_CONNECT_DIAGNOSTICS:AttachedToolPID = 810b, AttachedToolVID = 4d8
394 1735588382738 GEN4_CONNECT_DIAGNOSTICS:transport type = USB
394 1735588382738 GEN4_CONNECT_DIAGNOSTICS:AttachedToolPID = 810b, AttachedToolVID = 4d8
394 1735588383753 com.microchip.mplab.mdbcore.RealICETool.RIDbgToolCom
394 1735588383753 GEN4_CONNECT_DIAGNOSTICS:Before MPLABCommTool.Connect()
394 1735588383753 GEN4_CONNECT_DIAGNOSTICS:After MPLABCommTool.Connect()
394 1735588383753 GEN4_CONNECT_DIAGNOSTICS:MPLABCommTool.Connect() returned MPLABCOMM_NO_ERROR
394 1735588383754 GEN4_CONNECT_DIAGNOSTICS:Attaching to MPLABCommTool plugnplay
394 1735588383763 GEN4_CONNECT_DIAGNOSTICS:Adding new plug and play observer com.microchip.mplab.mdbcore.RI4Tool.RI4ToolBase$RI4PlugNPlayObserver@6b90996
394 1735588383763 GEN4_CONNECT_DIAGNOSTICS:Begin PlugNPlayObservers list dump:
394 1735588383763 GEN4_CONNECT_DIAGNOSTICS:com.microchip.mplab.mdbcore.RI4Tool.RI4ToolBase$RI4PlugNPlayObserver@6b90996
394 1735588383763 GEN4_CONNECT_DIAGNOSTICS:End PlugNPlayObservers list dump:
394 1735588383775 GEN4_CONNECT_DIAGNOSTICS:Registering for alternate PNP notifications. CommPnPCriteria.cPIDList = [810A, 8109, 2184], CommPnPCriteria.cSerialNumber = bur204820193

394 1735588388476 GEN4_TO_CONTROLLER_LOG:GEN4_INIT_INT_LOG_PIC24FJ128GL306 Pre:init
394 1735588388476 GEN4_TO_CONTROLLER_LOG:GEN4_INIT_INT_LOG_PIC24FJ128GL306 Payload
394 1735588388476 GEN4_TO_CONTROLLER_LOG:GEN4_INIT_INT_LOG_PIC24FJ128GL306 DeviceInfo: Values:
394 1735588388476 GEN4_TO_CONTROLLER_LOG:GEN4_INIT_INT_LOG_PIC24FJ128GL306 DeviceInfo: pcAddress = 0000002e, Vpp = 3.25, useRowEraseIfVoltageIsLow = false, voltageBelowWhichUseRowErase = 0.00, deviceName = PIC24FJ128GL306, programmerType = PIC24FJ
394 1735588388476 GEN4_TO_CONTROLLER_LOG:GEN4_INIT_INT_LOG_PIC24FJ128GL306 DeviceInfo: MemInfo values:
394 1735588388476 GEN4_TO_CONTROLLER_LOG:GEN4_INIT_INT_LOG_PIC24FJ128GL306 DeviceInfo: mask = ffffff, exists = true, startAddr = 00000000, endAddr = 00015eff, rowSize = 0800, rowEraseSize = 0800, addrInc = 0002, widthProgram = 0004
394 1735588388476 GEN4_TO_CONTROLLER_LOG:GEN4_INIT_INT_LOG_PIC24FJ128GL306 DeviceInfo: mask = ffffff, exists = true, startAddr = 00015f00, endAddr = 00015fff, rowSize = 0001, rowEraseSize = 0000, addrInc = 0002, widthProgram = 0004
394 1735588388476 GEN4_TO_CONTROLLER_LOG:GEN4_INIT_INT_LOG_PIC24FJ128GL306 DeviceInfo: mask = 0000, exists = false, startAddr = 00000000, endAddr = 00000000, rowSize = 0000, rowEraseSize = 0000, addrInc = 0000, widthProgram = 0000
394 1735588388476 GEN4_TO_CONTROLLER_LOG:GEN4_INIT_INT_LOG_PIC24FJ128GL306 DeviceInfo: mask = 0000, exists = false, startAddr = 00000000, endAddr = 00000000, rowSize = 0000, rowEraseSize = 0000, addrInc = 0000, widthProgram = 0000
394 1735588388476 GEN4_TO_CONTROLLER_LOG:GEN4_INIT_INT_LOG_PIC24FJ128GL306 DeviceInfo: mask = 0000, exists = false, startAddr = 00000000, endAddr = 00000000, rowSize = 0000, rowEraseSize = 0000, addrInc = 0000, widthProgram = 0000
394 1735588388476 GEN4_TO_CONTROLLER_LOG:GEN4_INIT_INT_LOG_PIC24FJ128GL306 DeviceInfo: mask = ffffff, exists = true, startAddr = 00800000, endAddr = 008017ff, rowSize = 0800, rowEraseSize = 0800, addrInc = 0002, widthProgram = 0004
394 1735588388476 GEN4_TO_CONTROLLER_LOG:GEN4_INIT_INT_LOG_PIC24FJ128GL306 DeviceInfo: mask = 0000, exists = false, startAddr = 00000000, endAddr = 00000000, rowSize = 0000, rowEraseSize = 0000, addrInc = 0002, widthProgram = 0002
394 1735588388476 GEN4_TO_CONTROLLER_LOG:GEN4_INIT_INT_LOG_PIC24FJ128GL306 DeviceInfo: mask = 0000, exists = false, startAddr = 00000000, endAddr = 00000000, rowSize = 0000, rowEraseSize = 0000, addrInc = 0000, widthProgram = 0000
394 1735588388476 GEN4_TO_CONTROLLER_LOG:GEN4_INIT_INT_LOG_PIC24FJ128GL306 DeviceInfo: mask = 0000, exists = false, startAddr = 00000000, endAddr = 00000000, rowSize = 0000, rowEraseSize = 0000, addrInc = 0000, widthProgram = 0000
394 1735588388476 GEN4_TO_CONTROLLER_LOG:GEN4_INIT_INT_LOG_PIC24FJ128GL306 DeviceInfo: mask = 0000, exists = false, startAddr = 00000000, endAddr = 00000000, rowSize = 0000, rowEraseSize = 0000, addrInc = 0000, widthProgram = 0000
394 1735588388476 GEN4_TO_CONTROLLER_LOG:GEN4_INIT_INT_LOG_PIC24FJ128GL306 DeviceInfo: mask = 0000, exists = false, startAddr = 00000000, endAddr = 00000000, rowSize = 0000, rowEraseSize = 0000, addrInc = 0002, widthProgram = 0002
394 1735588388476 GEN4_TO_CONTROLLER_LOG:GEN4_INIT_INT_LOG_PIC24FJ128GL306 DeviceInfo: mask = 0000, exists = false, startAddr = 00000000, endAddr = 00000000, rowSize = 0000, rowEraseSize = 0000, addrInc = 0000, widthProgram = 0000
394 1735588388476 GEN4_TO_CONTROLLER_LOG:GEN4_INIT_INT_LOG_PIC24FJ128GL306 DeviceInfo: mask = 0000, exists = false, startAddr = 00000000, endAddr = 00000000, rowSize = 0000, rowEraseSize = 0000, addrInc = 0000, widthProgram = 0000
394 1735588388476 GEN4_TO_CONTROLLER_LOG:GEN4_INIT_INT_LOG_PIC24FJ128GL306 DeviceInfo: mask = ffffff, exists = true, startAddr = 00801700, endAddr = 008017ff, rowSize = 0001, rowEraseSize = 0000, addrInc = 0002, widthProgram = 0004
394 1735588388476 GEN4_TO_CONTROLLER_LOG:GEN4_INIT_INT_LOG_PIC24FJ128GL306 DeviceInfo: mask = 0000, exists = false, startAddr = 00000000, endAddr = 00000000, rowSize = 0000, rowEraseSize = 0000, addrInc = 0000, widthProgram = 0000
394 1735588388476 GEN4_TO_CONTROLLER_LOG:GEN4_INIT_INT_LOG_PIC24FJ128GL306 DeviceInfo: mask = 0000, exists = false, startAddr = 00000000, endAddr = 00000000, rowSize = 0000, rowEraseSize = 0000, addrInc = 0000, widthProgram = 0000
394 1735588388476 GEN4_TO_CONTROLLER_LOG:GEN4_INIT_INT_LOG_PIC24FJ128GL306 DeviceInfo: mask = 7fffffff, exists = true, startAddr = 00ff0000, endAddr = 00ff0003, rowSize = 0001, rowEraseSize = 0000, addrInc = 0001, widthProgram = 0001
394 1735588388476 GEN4_TO_CONTROLLER_LOG:GEN4_INIT_INT_LOG_PIC24FJ128GL306 DeviceInfo: mask = 0000, exists = false, startAddr = 00000000, endAddr = 00000000, rowSize = 0000, rowEraseSize = 0000, addrInc = 0000, widthProgram = 0000
394 1735588388476 GEN4_TO_CONTROLLER_LOG:GEN4_INIT_INT_LOG_PIC24FJ128GL306 DeviceInfo: mask = 0000, exists = false, startAddr = 00000000, endAddr = 00000000, rowSize = 0000, rowEraseSize = 0000, addrInc = 0000, widthProgram = 0000
394 1735588388476 GEN4_TO_CONTROLLER_LOG:GEN4_INIT_INT_LOG_PIC24FJ128GL306 DeviceInfo: mask = 0000, exists = false, startAddr = 00000000, endAddr = 00000000, rowSize = 0000, rowEraseSize = 0000, addrInc = 0000, widthProgram = 0000
394 1735588388476 GEN4_TO_CONTROLLER_LOG:GEN4_INIT_INT_LOG_PIC24FJ128GL306 DeviceInfo: mask = 0000, exists = false, startAddr = 00000000, endAddr = 00000000, rowSize = 0000, rowEraseSize = 0000, addrInc = 0000, widthProgram = 0000
394 1735588388476 GEN4_TO_CONTROLLER_LOG:GEN4_INIT_INT_LOG_PIC24FJ128GL306 DeviceInfo: mask = 0000, exists = false, startAddr = 00000000, endAddr = 00000000, rowSize = 0000, rowEraseSize = 0000, addrInc = 0000, widthProgram = 0000
394 1735588388476 GEN4_TO_CONTROLLER_LOG:GEN4_INIT_INT_LOG_PIC24FJ128GL306 DeviceInfo: mask = 0000, exists = true, startAddr = 00801600, endAddr = 00801609, rowSize = 0000, rowEraseSize = 0000, addrInc = 0002, widthProgram = 0004
394 1735588388476 GEN4_TO_CONTROLLER_LOG:GEN4_INIT_INT_LOG_PIC24FJ128GL306 CfgRequiredBitsMask Values:
394 1735588388476 GEN4_TO_CONTROLLER_LOG:GEN4_INIT_INT_LOG_PIC24FJ128GL306 Address = 00015f00, Mask = 00008fef
394 1735588388476 GEN4_TO_CONTROLLER_LOG:GEN4_INIT_INT_LOG_PIC24FJ128GL306 Address = 00015f10, Mask = 00001fff
394 1735588388476 GEN4_TO_CONTROLLER_LOG:GEN4_INIT_INT_LOG_PIC24FJ128GL306 Address = 00015f14, Mask = 00ff7fff
394 1735588388476 GEN4_TO_CONTROLLER_LOG:GEN4_INIT_INT_LOG_PIC24FJ128GL306 Address = 00015f18, Mask = 000000ff
394 1735588388476 GEN4_TO_CONTROLLER_LOG:GEN4_INIT_INT_LOG_PIC24FJ128GL306 Address = 00015f1c, Mask = 000000ff
394 1735588388476 GEN4_TO_CONTROLLER_LOG:GEN4_INIT_INT_LOG_PIC24FJ128GL306 Address = 00015f20, Mask = 00006bff
394 1735588388476 GEN4_TO_CONTROLLER_LOG:GEN4_INIT_INT_LOG_PIC24FJ128GL306 Address = 00015f24, Mask = 0000000f
394 1735588388476 GEN4_TO_CONTROLLER_LOG:GEN4_INIT_INT_LOG_PIC24FJ128GL306 Address = 00015f28, Mask = 00000003
394 1735588388476 GEN4_TO_CONTROLLER_LOG:GEN4_INIT_INT_LOG_PIC24FJ128GL306 Address = 00015f2c, Mask = 0000ffff
394 1735588388476 GEN4_TO_CONTROLLER_LOG:GEN4_INIT_INT_LOG_PIC24FJ128GL306 Address = 00015f30, Mask = 0000ffff
394 1735588388476 GEN4_TO_CONTROLLER_LOG:GEN4_INIT_INT_LOG_PIC24FJ128GL306 Address = 00015f34, Mask = 0000ffff
394 1735588388476 GEN4_TO_CONTROLLER_LOG:GEN4_INIT_INT_LOG_PIC24FJ128GL306 Address = 00015f38, Mask = 0000ffff
394 1735588388476 GEN4_TO_CONTROLLER_LOG:GEN4_INIT_INT_LOG_PIC24FJ128GL306 Address = 00015f3c, Mask = 00000001
394 1735588388476 GEN4_TO_CONTROLLER_LOG:GEN4_INIT_INT_LOG_PIC24FJ128GL306 Address = 00015f40, Mask = 0000041e
394 1735588388476 GEN4_TO_CONTROLLER_LOG:GEN4_INIT_INT_LOG_PIC24FJ128GL306 BasicInfo: Values:
394 1735588388476 GEN4_TO_CONTROLLER_LOG:GEN4_INIT_INT_LOG_PIC24FJ128GL306 BasicInfo: InputStream = com.microchip.mplab.libs.toolpacksupport.EquatableFileInputStream@a604c829, ToolFlavor = PICKit4
394 1735588388476 GEN4_TO_CONTROLLER_LOG:GEN4_INIT_INT_LOG_PIC24FJ128GL306 Payload End
394 1735588391411 GEN4_TO_CONTROLLER_LOG:GEN4_INIT_INT_LOG_PIC24FJ128GL306 Post:init
394 1735588391411 GEN4_TO_CONTROLLER_LOG:GEN4_INIT_INT_LOG_PIC24FJ128GL306 Return Value
394 1735588391411 GEN4_TO_CONTROLLER_LOG:GEN4_INIT_INT_LOG_PIC24FJ128GL306 none
394 1735588391411 GEN4_TO_CONTROLLER_LOG:GEN4_INIT_INT_LOG_PIC24FJ128GL306 Return End

394 1735588391411 GEN4_TO_CONTROLLER_LOG:GEN4_INIT_INT_LOG_PIC24FJ128GL306 Pre:GetInterfaceProvider
394 1735588391411 GEN4_TO_CONTROLLER_LOG:GEN4_INIT_INT_LOG_PIC24FJ128GL306 Payload
394 1735588391411 GEN4_TO_CONTROLLER_LOG:GEN4_INIT_INT_LOG_PIC24FJ128GL306 RI4DebugInterface
394 1735588391411 GEN4_TO_CONTROLLER_LOG:GEN4_INIT_INT_LOG_PIC24FJ128GL306 Payload End
394 1735588391411 GEN4_TO_CONTROLLER_LOG:GEN4_INIT_INT_LOG_PIC24FJ128GL306 Post:GetInterfaceProvider
394 1735588391411 GEN4_TO_CONTROLLER_LOG:GEN4_INIT_INT_LOG_PIC24FJ128GL306 Return Value
394 1735588391411 GEN4_TO_CONTROLLER_LOG:GEN4_INIT_INT_LOG_PIC24FJ128GL306 com.microchip.mplab.libs.RI4ToolsController.implementations.RI4DebugInterfaceImpl@7090142a
394 1735588391411 GEN4_TO_CONTROLLER_LOG:GEN4_INIT_INT_LOG_PIC24FJ128GL306 Return End

394 1735588391554 GEN4_TO_CONTROLLER_LOG:GEN4_INIT_INT_LOG_PIC24FJ128GL306 Pre:GetInterfaceProvider
394 1735588391554 GEN4_TO_CONTROLLER_LOG:GEN4_INIT_INT_LOG_PIC24FJ128GL306 Payload
394 1735588391554 GEN4_TO_CONTROLLER_LOG:GEN4_INIT_INT_LOG_PIC24FJ128GL306 RI4ProgramInterface
394 1735588391554 GEN4_TO_CONTROLLER_LOG:GEN4_INIT_INT_LOG_PIC24FJ128GL306 Payload End
394 1735588391554 GEN4_TO_CONTROLLER_LOG:GEN4_INIT_INT_LOG_PIC24FJ128GL306 Post:GetInterfaceProvider
394 1735588391554 GEN4_TO_CONTROLLER_LOG:GEN4_INIT_INT_LOG_PIC24FJ128GL306 Return Value
394 1735588391554 GEN4_TO_CONTROLLER_LOG:GEN4_INIT_INT_LOG_PIC24FJ128GL306 com.microchip.mplab.libs.RI4ToolsController.implementations.RI4ProgramInterfaceImpl@59830635
394 1735588391554 GEN4_TO_CONTROLLER_LOG:GEN4_INIT_INT_LOG_PIC24FJ128GL306 Return End

394 1735588391633 GEN4_TO_CONTROLLER_LOG:GEN4_INIT_INT_LOG_PIC24FJ128GL306 Pre:GetInterfaceProvider
394 1735588391633 GEN4_TO_CONTROLLER_LOG:GEN4_INIT_INT_LOG_PIC24FJ128GL306 Payload
394 1735588391633 GEN4_TO_CONTROLLER_LOG:GEN4_INIT_INT_LOG_PIC24FJ128GL306 RI4ConnectInterface
394 1735588391633 GEN4_TO_CONTROLLER_LOG:GEN4_INIT_INT_LOG_PIC24FJ128GL306 Payload End
394 1735588391636 GEN4_TO_CONTROLLER_LOG:GEN4_INIT_INT_LOG_PIC24FJ128GL306 Post:GetInterfaceProvider
394 1735588391636 GEN4_TO_CONTROLLER_LOG:GEN4_INIT_INT_LOG_PIC24FJ128GL306 Return Value
394 1735588391636 GEN4_TO_CONTROLLER_LOG:GEN4_INIT_INT_LOG_PIC24FJ128GL306 com.microchip.mplab.libs.PK4ToolsController.PK4ConnectInterfaceImpl@5a249eda
394 1735588391636 GEN4_TO_CONTROLLER_LOG:GEN4_INIT_INT_LOG_PIC24FJ128GL306 Return End
394 1735588391679 GEN4_CONNECT_DIAGNOSTICS:acceptablePIDs = [810a, 8109, 810b]
394 1735588391679 GEN4_CONNECT_DIAGNOSTICS:otherPIDs = [2184]
394 1735588391679 GEN4_CONNECT_DIAGNOSTICS:Setting selected tool type to pk4
394 1735588391679 GEN4_CONNECT_DIAGNOSTICS:otherPIDs = [2184]
394 1735588391679 GEN4_CONNECT_DIAGNOSTICS:acceptablePIDs = [810a, 8109, 810b]

394 1735588391682 GEN4_TO_CONTROLLER_LOG:GEN4_CONNECT_INT_LOG_PIC24FJ128GL306 Pre:selectCore
394 1735588391682 GEN4_TO_CONTROLLER_LOG:GEN4_CONNECT_INT_LOG_PIC24FJ128GL306 Payload
394 1735588391682 GEN4_TO_CONTROLLER_LOG:GEN4_CONNECT_INT_LOG_PIC24FJ128GL306 PIC24FJ128GL306
394 1735588391682 GEN4_TO_CONTROLLER_LOG:GEN4_CONNECT_INT_LOG_PIC24FJ128GL306 Payload End
394 1735588391682 GEN4_TO_CONTROLLER_LOG:GEN4_CONNECT_INT_LOG_PIC24FJ128GL306 Post:selectCore
394 1735588391682 GEN4_TO_CONTROLLER_LOG:GEN4_CONNECT_INT_LOG_PIC24FJ128GL306 Return Value
394 1735588391682 GEN4_TO_CONTROLLER_LOG:GEN4_CONNECT_INT_LOG_PIC24FJ128GL306 none
394 1735588391682 GEN4_TO_CONTROLLER_LOG:GEN4_CONNECT_INT_LOG_PIC24FJ128GL306 Return End

394 1735588391682 GEN4_TO_CONTROLLER_LOG:GEN4_INIT_INT_LOG_PIC24FJ128GL306 Pre:GetInterfaceProvider
394 1735588391682 GEN4_TO_CONTROLLER_LOG:GEN4_INIT_INT_LOG_PIC24FJ128GL306 Payload
394 1735588391682 GEN4_TO_CONTROLLER_LOG:GEN4_INIT_INT_LOG_PIC24FJ128GL306 RI4ControllerDiagnosticsInterface
394 1735588391682 GEN4_TO_CONTROLLER_LOG:GEN4_INIT_INT_LOG_PIC24FJ128GL306 Payload End
394 1735588391682 GEN4_TO_CONTROLLER_LOG:GEN4_INIT_INT_LOG_PIC24FJ128GL306 Post:GetInterfaceProvider
394 1735588391682 GEN4_TO_CONTROLLER_LOG:GEN4_INIT_INT_LOG_PIC24FJ128GL306 Return Value
394 1735588391682 GEN4_TO_CONTROLLER_LOG:GEN4_INIT_INT_LOG_PIC24FJ128GL306 com.microchip.mplab.libs.RI4ToolsController.implementations.RI4ControllerDiagnosticsInterfaceImpl@560f8260
394 1735588391682 GEN4_TO_CONTROLLER_LOG:GEN4_INIT_INT_LOG_PIC24FJ128GL306 Return End

394 1735588391682 GEN4_TO_CONTROLLER_LOG:GEN4_INIT_INT_LOG_PIC24FJ128GL306 Pre:GetInterfaceProvider
394 1735588391682 GEN4_TO_CONTROLLER_LOG:GEN4_INIT_INT_LOG_PIC24FJ128GL306 Payload
394 1735588391682 GEN4_TO_CONTROLLER_LOG:GEN4_INIT_INT_LOG_PIC24FJ128GL306 ProgrammerToGo
394 1735588391682 GEN4_TO_CONTROLLER_LOG:GEN4_INIT_INT_LOG_PIC24FJ128GL306 Payload End
394 1735588391682 GEN4_TO_CONTROLLER_LOG:GEN4_INIT_INT_LOG_PIC24FJ128GL306 Post:GetInterfaceProvider
394 1735588391682 GEN4_TO_CONTROLLER_LOG:GEN4_INIT_INT_LOG_PIC24FJ128GL306 Return Value
394 1735588391682 GEN4_TO_CONTROLLER_LOG:GEN4_INIT_INT_LOG_PIC24FJ128GL306 com.microchip.mplab.libs.RI4ToolsController.implementations.ProgrammerToGoImpl@3d469952
394 1735588391682 GEN4_TO_CONTROLLER_LOG:GEN4_INIT_INT_LOG_PIC24FJ128GL306 Return End

394 1735588391682 GEN4_TO_CONTROLLER_LOG:GEN4_INIT_INT_LOG_PIC24FJ128GL306 Pre:GetInterfaceProvider
394 1735588391682 GEN4_TO_CONTROLLER_LOG:GEN4_INIT_INT_LOG_PIC24FJ128GL306 Payload
394 1735588391682 GEN4_TO_CONTROLLER_LOG:GEN4_INIT_INT_LOG_PIC24FJ128GL306 Status
394 1735588391682 GEN4_TO_CONTROLLER_LOG:GEN4_INIT_INT_LOG_PIC24FJ128GL306 Payload End
394 1735588391682 GEN4_TO_CONTROLLER_LOG:GEN4_INIT_INT_LOG_PIC24FJ128GL306 Post:GetInterfaceProvider
394 1735588391682 GEN4_TO_CONTROLLER_LOG:GEN4_INIT_INT_LOG_PIC24FJ128GL306 Return Value
394 1735588391682 GEN4_TO_CONTROLLER_LOG:GEN4_INIT_INT_LOG_PIC24FJ128GL306 null
394 1735588391682 GEN4_TO_CONTROLLER_LOG:GEN4_INIT_INT_LOG_PIC24FJ128GL306 Return End

394 1735588391699 GEN4_TO_CONTROLLER_LOG:GEN4_PROGRAM_INT_LOG_PIC24FJ128GL306 Pre:SetProgramExec
394 1735588391699 GEN4_TO_CONTROLLER_LOG:GEN4_PROGRAM_INT_LOG_PIC24FJ128GL306 Payload
394 1735588391700 GEN4_TO_CONTROLLER_LOG:GEN4_PROGRAM_INT_LOG_PIC24FJ128GL306 Test
394 1735588391700 GEN4_TO_CONTROLLER_LOG:GEN4_PROGRAM_INT_LOG_PIC24FJ128GL306 800000
394 1735588391700 GEN4_TO_CONTROLLER_LOG:GEN4_PROGRAM_INT_LOG_PIC24FJ128GL306 Length = 3108
394 1735588391700 GEN4_TO_CONTROLLER_LOG:GEN4_PROGRAM_INT_LOG_PIC24FJ128GL306 Payload End
394 1735588391700 GEN4_TO_CONTROLLER_LOG:GEN4_PROGRAM_INT_LOG_PIC24FJ128GL306 Post:SetProgramExec
394 1735588391700 GEN4_TO_CONTROLLER_LOG:GEN4_PROGRAM_INT_LOG_PIC24FJ128GL306 Return Value
394 1735588391700 GEN4_TO_CONTROLLER_LOG:GEN4_PROGRAM_INT_LOG_PIC24FJ128GL306 true
394 1735588391700 GEN4_TO_CONTROLLER_LOG:GEN4_PROGRAM_INT_LOG_PIC24FJ128GL306 Return End

394 1735588391704 GEN4_TO_CONTROLLER_LOG:GEN4_PROGRAM_INT_LOG_PIC24FJ128GL306 Pre:SetDebugExec
394 1735588391704 GEN4_TO_CONTROLLER_LOG:GEN4_PROGRAM_INT_LOG_PIC24FJ128GL306 Payload
394 1735588391704 GEN4_TO_CONTROLLER_LOG:GEN4_PROGRAM_INT_LOG_PIC24FJ128GL306 Test
394 1735588391704 GEN4_TO_CONTROLLER_LOG:GEN4_PROGRAM_INT_LOG_PIC24FJ128GL306 800000
394 1735588391704 GEN4_TO_CONTROLLER_LOG:GEN4_PROGRAM_INT_LOG_PIC24FJ128GL306 Length = 2640
394 1735588391704 GEN4_TO_CONTROLLER_LOG:GEN4_PROGRAM_INT_LOG_PIC24FJ128GL306 Payload End
394 1735588391705 GEN4_TO_CONTROLLER_LOG:GEN4_PROGRAM_INT_LOG_PIC24FJ128GL306 Post:SetDebugExec
394 1735588391705 GEN4_TO_CONTROLLER_LOG:GEN4_PROGRAM_INT_LOG_PIC24FJ128GL306 Return Value
394 1735588391705 GEN4_TO_CONTROLLER_LOG:GEN4_PROGRAM_INT_LOG_PIC24FJ128GL306 true
394 1735588391705 GEN4_TO_CONTROLLER_LOG:GEN4_PROGRAM_INT_LOG_PIC24FJ128GL306 Return End
394 1735588391705 GEN4_CONNECT_DIAGNOSTICS:ENTERING: com.microchip.mplab.mdbcore.RI4Tool.ConnectionHandler.CheckForFWUpdates()
394 1735588391705 GEN4_CONNECT_DIAGNOSTICS:Created FirmwareUpdateHandler com.microchip.mplab.mdbcore.pk4hybrid.pk4hybridFirmwareUpdateHandler@5ff9af6b
394 1735588391705 GEN4_CONNECT_DIAGNOSTICS:ENTERING: com.microchip.mplab.mdbcore.pk4hybrid.pk4hybridFirmwareUpdateHandler.UpdateFirmware(FirmwareInfo, UpdateMessage)
394 1735588391710 GEN4_CONNECT_DIAGNOSTICS:areWeInBoot returned false
394 1735588391710 GEN4_CONNECT_DIAGNOSTICS:inBoot = false
394 1735588391710 GEN4_CONNECT_DIAGNOSTICS:uMode = checkingVersions
394 1735588391710 GEN4_CONNECT_DIAGNOSTICS:selectedTool = pk4
394 1735588391710 GEN4_CONNECT_DIAGNOSTICS:current toolType = pk4
394 1735588391710 GEN4_CONNECT_DIAGNOSTICS:current tool mode = pk4
394 1735588391710 GEN4_CONNECT_DIAGNOSTICS:ENTERING: com.microchip.mplab.mdbcore.pk4hybrid.pk4hybridFirmwareUpdateHandler.GetUpdateInfo()
394 1735588391757 GEN4_CONNECT_DIAGNOSTICS:Parsing file  for firmware updates
394 1735588391757 GEN4_CONNECT_DIAGNOSTICS:ENTERING: com.microchip.mplab.mdbcore.pk4hybrid.pk4hybridFirmwareUpdateHandler.ParseSelectedVersionsFromJamFile()
394 1735588391758 GEN4_CONNECT_DIAGNOSTICS:Jame file line = pkob4_boot.hex,010141
394 1735588391758 GEN4_CONNECT_DIAGNOSTICS:Jame file line = scripts.xml,000747
394 1735588391758 GEN4_CONNECT_DIAGNOSTICS:Jame file line = pkob4_app1 000747, 0040C000
394 1735588391758 GEN4_CONNECT_DIAGNOSTICS:EXITING: com.microchip.mplab.mdbcore.pk4hybrid.pk4hybridFirmwareUpdateHandler.ri4ParseSelectedVersionsFromJamFile()
394 1735588391758 GEN4_CONNECT_DIAGNOSTICS:EXITING: com.microchip.mplab.mdbcore.pk4hybrid.pk4hybridFirmwareUpdateHandler.GetUpdateInfo()
394 1735588391758 GEN4_CONNECT_DIAGNOSTICS:current toolType = pk4

394 1735588391758 GEN4_TO_CONTROLLER_LOG:GEN4_CONNECT_INT_LOG_PIC24FJ128GL306 Pre:EstablishCommunincations
394 1735588391758 GEN4_TO_CONTROLLER_LOG:GEN4_CONNECT_INT_LOG_PIC24FJ128GL306 Payload
394 1735588391758 GEN4_TO_CONTROLLER_LOG:GEN4_CONNECT_INT_LOG_PIC24FJ128GL306 com.microchip.mplab.mdbcore.PK4Tool.PK4Com@7e7719f6
394 1735588391758 GEN4_TO_CONTROLLER_LOG:GEN4_CONNECT_INT_LOG_PIC24FJ128GL306 Payload End
394 1735588391764 GEN4_TO_CONTROLLER_LOG:GEN4_CONNECT_INT_LOG_PIC24FJ128GL306 Post:EstablishCommunincations
394 1735588391764 GEN4_TO_CONTROLLER_LOG:GEN4_CONNECT_INT_LOG_PIC24FJ128GL306 Return Value
394 1735588391764 GEN4_TO_CONTROLLER_LOG:GEN4_CONNECT_INT_LOG_PIC24FJ128GL306 true
394 1735588391764 GEN4_TO_CONTROLLER_LOG:GEN4_CONNECT_INT_LOG_PIC24FJ128GL306 Return End

394 1735588391764 GEN4_TO_CONTROLLER_LOG:GEN4_CONNECT_INT_LOG_PIC24FJ128GL306 Pre:GetFirmwareInfo
394 1735588391764 GEN4_TO_CONTROLLER_LOG:GEN4_CONNECT_INT_LOG_PIC24FJ128GL306 Payload
394 1735588391764 GEN4_TO_CONTROLLER_LOG:GEN4_CONNECT_INT_LOG_PIC24FJ128GL306 null
394 1735588391764 GEN4_TO_CONTROLLER_LOG:GEN4_CONNECT_INT_LOG_PIC24FJ128GL306 Payload End
394 1735588391773 GEN4_TO_CONTROLLER_LOG:GEN4_CONNECT_INT_LOG_PIC24FJ128GL306 Post:GetFirmwareInfo
394 1735588391773 GEN4_TO_CONTROLLER_LOG:GEN4_CONNECT_INT_LOG_PIC24FJ128GL306 Return Value
394 1735588391773 GEN4_TO_CONTROLLER_LOG:GEN4_CONNECT_INT_LOG_PIC24FJ128GL306 FirmwareInfo: Values:
394 1735588391773 GEN4_TO_CONTROLLER_LOG:GEN4_CONNECT_INT_LOG_PIC24FJ128GL306 FirmwareInfo: boot = false, bootVer = 01.01.41, apVer = 00.07.10, fpgaVer = ff.ff.ff, scriptVer = 00.07.47, macAddress = 0495683497167524852485248485151, devID = a1020e01, devID1 = 1, devSN0 = ffffffff, devSN1 = ffffffff, serialNumber = BUR204820193, appCommitID = null, scriptCommitID = 974b928e70, PCB_ID = 80000000
394 1735588391773 GEN4_TO_CONTROLLER_LOG:GEN4_CONNECT_INT_LOG_PIC24FJ128GL306 Return End
394 1735588391777 GEN4_CONNECT_DIAGNOSTICS:appNeedsUpdate returned true
394 1735588391777 GEN4_CONNECT_DIAGNOSTICS:current toolType = pk4
394 1735588391777 GEN4_CONNECT_DIAGNOSTICS:EXITING: com.microchip.mplab.mdbcore.pk4hybrid.pk4hybridFirmwareUpdateHandler.UpdateFirmware(FirmwareInfo, UpdateMessage)
394 1735588391777 GEN4_CONNECT_DIAGNOSTICS:EXITING: com.microchip.mplab.mdbcore.RI4Tool.ConnectionHandler.CheckForFWUpdates()

394 1735588391777 GEN4_TO_CONTROLLER_LOG:GEN4_CONNECT_INT_LOG_PIC24FJ128GL306 Pre:EstablishCommunincations
394 1735588391777 GEN4_TO_CONTROLLER_LOG:GEN4_CONNECT_INT_LOG_PIC24FJ128GL306 Payload
394 1735588391777 GEN4_TO_CONTROLLER_LOG:GEN4_CONNECT_INT_LOG_PIC24FJ128GL306 com.microchip.mplab.mdbcore.PK4Tool.PK4Com@7e7719f6
394 1735588391777 GEN4_TO_CONTROLLER_LOG:GEN4_CONNECT_INT_LOG_PIC24FJ128GL306 Payload End
394 1735588391779 GEN4_TO_CONTROLLER_LOG:GEN4_CONNECT_INT_LOG_PIC24FJ128GL306 Post:EstablishCommunincations
394 1735588391779 GEN4_TO_CONTROLLER_LOG:GEN4_CONNECT_INT_LOG_PIC24FJ128GL306 Return Value
394 1735588391779 GEN4_TO_CONTROLLER_LOG:GEN4_CONNECT_INT_LOG_PIC24FJ128GL306 true
394 1735588391779 GEN4_TO_CONTROLLER_LOG:GEN4_CONNECT_INT_LOG_PIC24FJ128GL306 Return End

394 1735588391779 GEN4_TO_CONTROLLER_LOG:GEN4_CONNECT_INT_LOG_PIC24FJ128GL306 Pre:GetFirmwareInfo
394 1735588391779 GEN4_TO_CONTROLLER_LOG:GEN4_CONNECT_INT_LOG_PIC24FJ128GL306 Payload
394 1735588391779 GEN4_TO_CONTROLLER_LOG:GEN4_CONNECT_INT_LOG_PIC24FJ128GL306 null
394 1735588391779 GEN4_TO_CONTROLLER_LOG:GEN4_CONNECT_INT_LOG_PIC24FJ128GL306 Payload End
394 1735588391786 GEN4_TO_CONTROLLER_LOG:GEN4_CONNECT_INT_LOG_PIC24FJ128GL306 Post:GetFirmwareInfo
394 1735588391786 GEN4_TO_CONTROLLER_LOG:GEN4_CONNECT_INT_LOG_PIC24FJ128GL306 Return Value
394 1735588391787 GEN4_TO_CONTROLLER_LOG:GEN4_CONNECT_INT_LOG_PIC24FJ128GL306 FirmwareInfo: Values:
394 1735588391787 GEN4_TO_CONTROLLER_LOG:GEN4_CONNECT_INT_LOG_PIC24FJ128GL306 FirmwareInfo: boot = false, bootVer = 01.01.41, apVer = 00.07.10, fpgaVer = ff.ff.ff, scriptVer = 00.07.47, macAddress = 0495683497167524852485248485151, devID = a1020e01, devID1 = 1, devSN0 = ffffffff, devSN1 = ffffffff, serialNumber = BUR204820193, appCommitID = null, scriptCommitID = 974b928e70, PCB_ID = 80000000
394 1735588391787 GEN4_TO_CONTROLLER_LOG:GEN4_CONNECT_INT_LOG_PIC24FJ128GL306 Return End

394 1735588391788 GEN4_TO_CONTROLLER_LOG:GEN4_CONNECT_INT_LOG_PIC24FJ128GL306 Pre:GetFirmwareInfo
394 1735588391788 GEN4_TO_CONTROLLER_LOG:GEN4_CONNECT_INT_LOG_PIC24FJ128GL306 Payload
394 1735588391788 GEN4_TO_CONTROLLER_LOG:GEN4_CONNECT_INT_LOG_PIC24FJ128GL306 null
394 1735588391788 GEN4_TO_CONTROLLER_LOG:GEN4_CONNECT_INT_LOG_PIC24FJ128GL306 Payload End
394 1735588391796 GEN4_TO_CONTROLLER_LOG:GEN4_CONNECT_INT_LOG_PIC24FJ128GL306 Post:GetFirmwareInfo
394 1735588391796 GEN4_TO_CONTROLLER_LOG:GEN4_CONNECT_INT_LOG_PIC24FJ128GL306 Return Value
394 1735588391796 GEN4_TO_CONTROLLER_LOG:GEN4_CONNECT_INT_LOG_PIC24FJ128GL306 FirmwareInfo: Values:
394 1735588391796 GEN4_TO_CONTROLLER_LOG:GEN4_CONNECT_INT_LOG_PIC24FJ128GL306 FirmwareInfo: boot = false, bootVer = 01.01.41, apVer = 00.07.10, fpgaVer = ff.ff.ff, scriptVer = 00.07.47, macAddress = 0495683497167524852485248485151, devID = a1020e01, devID1 = 1, devSN0 = ffffffff, devSN1 = ffffffff, serialNumber = BUR204820193, appCommitID = null, scriptCommitID = 974b928e70, PCB_ID = 80000000
394 1735588391796 GEN4_TO_CONTROLLER_LOG:GEN4_CONNECT_INT_LOG_PIC24FJ128GL306 Return End
394 1735588391798 GEN4_CONNECT_DIAGNOSTICS:ENTERING: com.microchip.mplab.mdbcore.RI4Tool.ConnectionHandler.CheckForFWUpdates()
394 1735588391798 GEN4_CONNECT_DIAGNOSTICS:Created FirmwareUpdateHandler com.microchip.mplab.mdbcore.pk4hybrid.pk4hybridFirmwareUpdateHandler@5ff9af6b
394 1735588391798 GEN4_CONNECT_DIAGNOSTICS:ENTERING: com.microchip.mplab.mdbcore.pk4hybrid.pk4hybridFirmwareUpdateHandler.UpdateFirmware(FirmwareInfo, UpdateMessage)
394 1735588391798 GEN4_CONNECT_DIAGNOSTICS:areWeInBoot returned false
394 1735588391798 GEN4_CONNECT_DIAGNOSTICS:inBoot = false
394 1735588391798 GEN4_CONNECT_DIAGNOSTICS:uMode = updating
394 1735588391798 GEN4_CONNECT_DIAGNOSTICS:selectedTool = pk4
394 1735588391798 GEN4_CONNECT_DIAGNOSTICS:current toolType = pk4
394 1735588391798 GEN4_CONNECT_DIAGNOSTICS:current tool mode = pk4
394 1735588391799 GEN4_CONNECT_DIAGNOSTICS:ENTERING: com.microchip.mplab.mdbcore.pk4hybrid.pk4hybridFirmwareUpdateHandler.updatePk4HybridFirmware()
394 1735588391799 GEN4_CONNECT_DIAGNOSTICS:Don't upgrade fimware = false
394 1735588391799 GEN4_CONNECT_DIAGNOSTICS:ENTERING: com.microchip.mplab.mdbcore.pk4hybrid.pk4hybridFirmwareUpdateHandler.switchToBoot()
394 1735588391799 GEN4_CONNECT_DIAGNOSTICS:ENTERING: com.microchip.mplab.mdbcore.pk4hybrid.pk4hybridFirmwareUpdateHandler.selectConnectInterfaceMode(toolType)
394 1735588391799 GEN4_CONNECT_DIAGNOSTICS:Connect interface = com.microchip.mplab.mdbcore.RI4Tool.controllerstack.ControllerInterfacesProvider@2ce6bc88
394 1735588391799 GEN4_CONNECT_DIAGNOSTICS:EXITING: com.microchip.mplab.mdbcore.pk4hybrid.pk4hybridFirmwareUpdateHandler.selectConnectInterfaceMode(toolType)
394 1735588391799 GEN4_CONNECT_DIAGNOSTICS:calling switcher.switchToBoot()

394 1735588391799 GEN4_TO_CONTROLLER_LOG:GEN4_CONNECT_INT_LOG_PIC24FJ128GL306 Pre:EnterFirmwareUpgradeMode
394 1735588391799 GEN4_TO_CONTROLLER_LOG:GEN4_CONNECT_INT_LOG_PIC24FJ128GL306 Payload
394 1735588391799 GEN4_TO_CONTROLLER_LOG:GEN4_CONNECT_INT_LOG_PIC24FJ128GL306 null
394 1735588391799 GEN4_TO_CONTROLLER_LOG:GEN4_CONNECT_INT_LOG_PIC24FJ128GL306 Payload End
394 1735588391806 GEN4_TO_CONTROLLER_LOG:GEN4_CONNECT_INT_LOG_PIC24FJ128GL306 Post:EnterFirmwareUpgradeMode
394 1735588391806 GEN4_TO_CONTROLLER_LOG:GEN4_CONNECT_INT_LOG_PIC24FJ128GL306 Return Value
394 1735588391806 GEN4_TO_CONTROLLER_LOG:GEN4_CONNECT_INT_LOG_PIC24FJ128GL306 none
394 1735588391806 GEN4_TO_CONTROLLER_LOG:GEN4_CONNECT_INT_LOG_PIC24FJ128GL306 Return End
394 1735588391806 GEN4_CONNECT_DIAGNOSTICS:EXITING: com.microchip.mplab.mdbcore.pk4hybrid.pk4hybridFirmwareUpdateHandler.switchToBoot()
394 1735588391806 GEN4_CONNECT_DIAGNOSTICS:ENTERING: com.microchip.mplab.mdbcore.pk4hybrid.pk4hybridFirmwareUpdateHandler.updatePk4HybridFirmware()
394 1735588391806 GEN4_CONNECT_DIAGNOSTICS:EXITING: com.microchip.mplab.mdbcore.pk4hybrid.pk4hybridFirmwareUpdateHandler.UpdateFirmware(FirmwareInfo, UpdateMessage)
235 1735588392294 GEN4_CONNECT_DIAGNOSTICS:Calling Update on plug and play observer com.microchip.mplab.mdbcore.RI4Tool.RI4ToolBase$RI4PlugNPlayObserver@6b90996
235 1735588392294 GEN4_CONNECT_DIAGNOSTICS:Entering plug and play Update(). Attached PID = 810b
235 1735588392296 GEN4_CONNECT_DIAGNOSTICS:Entering MPLABCommEvent handler
235 1735588392296 GEN4_CONNECT_DIAGNOSTICS:MPLABCommEvent.pid = 810b
235 1735588392296 GEN4_CONNECT_DIAGNOSTICS:eventType = MPLABCOMM_TOOL_UNPLUGGED
235 1735588392296 GEN4_CONNECT_DIAGNOSTICS:Exiting plug and play Update()
396 1735588393212 GEN4_CONNECT_DIAGNOSTICS:Entering plug and play Update(). Attached PID = 810b
396 1735588393212 GEN4_CONNECT_DIAGNOSTICS:Entering CommPnPEvent handler
396 1735588393212 GEN4_CONNECT_DIAGNOSTICS:CommPnPEvent.pid = 810a
396 1735588393212 GEN4_CONNECT_DIAGNOSTICS:Calling MPLABCommTool.Detach to remove tool from plug and play list
396 1735588393214 GEN4_CONNECT_DIAGNOSTICS:Calling RIDbgToolCom.DisconnectFromMPlabComm
396 1735588393214 GEN4_CONNECT_DIAGNOSTICS:Calling MPLABCommTool.Disconnect
396 1735588393214 com.microchip.mplab.mdbcore.RI4Tool.switchCommTool
396 1735588393214 GEN4_CONNECT_DIAGNOSTICS:Before MPLABCommTool.Connect()
396 1735588393218 GEN4_CONNECT_DIAGNOSTICS:After MPLABCommTool.Connect()
396 1735588393218 GEN4_CONNECT_DIAGNOSTICS:MPLABCommTool.Connect() returned MPLABCOMM_NO_ERROR
396 1735588393218 GEN4_CONNECT_DIAGNOSTICS:Before detaching from MPLABCommTool plugnplay
396 1735588393218 GEN4_CONNECT_DIAGNOSTICS:Attaching to MPLABCommTool plugnplay
396 1735588393218 GEN4_CONNECT_DIAGNOSTICS:release com pnp

396 1735588393271 GEN4_TO_CONTROLLER_LOG:GEN4_CONNECT_INT_LOG_PIC24FJ128GL306 Pre:EstablishCommunincations
396 1735588393271 GEN4_TO_CONTROLLER_LOG:GEN4_CONNECT_INT_LOG_PIC24FJ128GL306 Payload
396 1735588393271 GEN4_TO_CONTROLLER_LOG:GEN4_CONNECT_INT_LOG_PIC24FJ128GL306 com.microchip.mplab.mdbcore.PK4Tool.PK4Com@7e7719f6
396 1735588393271 GEN4_TO_CONTROLLER_LOG:GEN4_CONNECT_INT_LOG_PIC24FJ128GL306 Payload End
396 1735588393271 GEN4_TO_CONTROLLER_LOG:GEN4_CONNECT_INT_LOG_PIC24FJ128GL306 Post:EstablishCommunincations
396 1735588393271 GEN4_TO_CONTROLLER_LOG:GEN4_CONNECT_INT_LOG_PIC24FJ128GL306 Return Value
396 1735588393271 GEN4_TO_CONTROLLER_LOG:GEN4_CONNECT_INT_LOG_PIC24FJ128GL306 true
396 1735588393271 GEN4_TO_CONTROLLER_LOG:GEN4_CONNECT_INT_LOG_PIC24FJ128GL306 Return End
396 1735588393271 GEN4_CONNECT_DIAGNOSTICS:Registering for alternate PNP notifications. CommPnPCriteria.cPIDList = [8109, 2184, 810B], CommPnPCriteria.cSerialNumber = bur204820193
396 1735588393272 GEN4_CONNECT_DIAGNOSTICS:eventType = MPLABCOMM_TOOL_PLUGGEDIN

396 1735588393273 GEN4_TO_CONTROLLER_LOG:GEN4_CONNECT_INT_LOG_PIC24FJ128GL306 Pre:GetFirmwareInfo
396 1735588393273 GEN4_TO_CONTROLLER_LOG:GEN4_CONNECT_INT_LOG_PIC24FJ128GL306 Payload
396 1735588393273 GEN4_TO_CONTROLLER_LOG:GEN4_CONNECT_INT_LOG_PIC24FJ128GL306 null
396 1735588393273 GEN4_TO_CONTROLLER_LOG:GEN4_CONNECT_INT_LOG_PIC24FJ128GL306 Payload End
396 1735588393308 GEN4_TO_CONTROLLER_LOG:GEN4_CONNECT_INT_LOG_PIC24FJ128GL306 Post:GetFirmwareInfo
396 1735588393308 GEN4_TO_CONTROLLER_LOG:GEN4_CONNECT_INT_LOG_PIC24FJ128GL306 Return Value
396 1735588393308 GEN4_TO_CONTROLLER_LOG:GEN4_CONNECT_INT_LOG_PIC24FJ128GL306 FirmwareInfo: Values:
396 1735588393308 GEN4_TO_CONTROLLER_LOG:GEN4_CONNECT_INT_LOG_PIC24FJ128GL306 FirmwareInfo: boot = true, bootVer = 01.01.41, apVer = 00.07.10, fpgaVer = ff.ff.ff, scriptVer = 00.07.47, macAddress = 0495683497167524852485248485151, devID = a1020e01, devID1 = 1, devSN0 = ffffffff, devSN1 = ffffffff, serialNumber = BUR204820193, appCommitID = null, scriptCommitID = 974b928e70, PCB_ID = 80000000
396 1735588393308 GEN4_TO_CONTROLLER_LOG:GEN4_CONNECT_INT_LOG_PIC24FJ128GL306 Return End
396 1735588393308 GEN4_CONNECT_DIAGNOSTICS:ENTERING: com.microchip.mplab.mdbcore.pk4hybrid.pk4hybridFirmwareUpdateHandler.UpdateFirmware(FirmwareInfo, UpdateMessage)
396 1735588393308 GEN4_CONNECT_DIAGNOSTICS:areWeInBoot returned true
396 1735588393308 GEN4_CONNECT_DIAGNOSTICS:inBoot = true
396 1735588393308 GEN4_CONNECT_DIAGNOSTICS:uMode = updating
396 1735588393308 GEN4_CONNECT_DIAGNOSTICS:selectedTool = pk4
396 1735588393308 GEN4_CONNECT_DIAGNOSTICS:current toolType = pk4
396 1735588393308 GEN4_CONNECT_DIAGNOSTICS:current tool mode = pk4
396 1735588393308 GEN4_CONNECT_DIAGNOSTICS:ENTERING: com.microchip.mplab.mdbcore.pk4hybrid.pk4hybridFirmwareUpdateHandler.updatePk4HybridFirmware()
396 1735588393308 GEN4_CONNECT_DIAGNOSTICS:Don't upgrade fimware = false
396 1735588393310 GEN4_CONNECT_DIAGNOSTICS:ENTERING: com.microchip.mplab.mdbcore.pk4hybrid.pk4hybridFirmwareUpdateHandler.preAPUpdate()
396 1735588393310 GEN4_CONNECT_DIAGNOSTICS:Begin logging appIndices to write to switcher
396 1735588393310 GEN4_CONNECT_DIAGNOSTICS:addr = 40c000
396 1735588393310 GEN4_CONNECT_DIAGNOSTICS:End logging appIndices to write to switcher
396 1735588393322 GEN4_CONNECT_DIAGNOSTICS:calling switcher.writeAppIndexWhenTalkingToScripting(0)
396 1735588393329 GEN4_CONNECT_DIAGNOSTICS:EXITING: com.microchip.mplab.mdbcore.pk4hybrid.pk4hybridFirmwareUpdateHandler.preAPUpdate()
396 1735588393329 GEN4_CONNECT_DIAGNOSTICS:ENTERING: com.microchip.mplab.mdbcore.pk4hybrid.pk4hybridFirmwareUpdateHandler.DownloadData()
396 1735588393329 GEN4_CONNECT_DIAGNOSTICS:Downloading firmware from file pkob4_app.hex
396 1735588393329 GEN4_CONNECT_DIAGNOSTICS:Downloading firmware type ap
396 1735588393378 GEN4_CONNECT_DIAGNOSTICS:FIRMWARE_UPDATE SendFirmwareDownload with type = ap

396 1735588393378 GEN4_TO_CONTROLLER_LOG:GEN4_CONNECT_INT_LOG_PIC24FJ128GL306 Pre:SendFirmareDownload
396 1735588393378 GEN4_TO_CONTROLLER_LOG:GEN4_CONNECT_INT_LOG_PIC24FJ128GL306 Payload
396 1735588393378 GEN4_TO_CONTROLLER_LOG:GEN4_CONNECT_INT_LOG_PIC24FJ128GL306 ap
396 1735588393378 GEN4_TO_CONTROLLER_LOG:GEN4_CONNECT_INT_LOG_PIC24FJ128GL306 40c000
396 1735588393378 GEN4_TO_CONTROLLER_LOG:GEN4_CONNECT_INT_LOG_PIC24FJ128GL306 Payload End
396 1735588393378 XXXX 1735588393378, Thread 396: XXXX 1735588393378, Entering Thread 396: ICD4Commands::eraseFlash, app  
396 1735588395342 XXXX 1735588395342, Thread 396: XXXX 1735588395342, Exiting Thread 396: ICD4Commands::eraseFlash  
396 1735588395342 XXXX 1735588395342, Thread 396: XXXX 1735588395342, Entering Thread 396: ICD4Commands::writePFMAndCheckCRC  
396 1735588395342 XXXX 1735588395342, Thread 396: XXXX 1735588395342, Entering Thread 396: ICD4Commands::writePFM  
396 1735588395343 XXXX 1735588395343, Thread 396: XXXX 1735588395343, Entering Thread 396: ICD4Commands::writePFMShort  
396 1735588396830 XXXX 1735588396830, Thread 396: XXXX 1735588396830, Exiting Thread 396: ICD4Commands::writePFMShort  
396 1735588396830 XXXX 1735588396830, Thread 396: XXXX 1735588396830, Exiting Thread 396: ICD4Commands::writePFM  
396 1735588397660 XXXX 1735588397660, Thread 396: XXXX 1735588397660, Exiting Thread 396: ICD4Commands::writePFMAndCheckCRC  
396 1735588397689 GEN4_TO_CONTROLLER_LOG:GEN4_CONNECT_INT_LOG_PIC24FJ128GL306 Post:SendFirmareDownload
396 1735588397689 GEN4_TO_CONTROLLER_LOG:GEN4_CONNECT_INT_LOG_PIC24FJ128GL306 Return Value
396 1735588397689 GEN4_TO_CONTROLLER_LOG:GEN4_CONNECT_INT_LOG_PIC24FJ128GL306 none
396 1735588397689 GEN4_TO_CONTROLLER_LOG:GEN4_CONNECT_INT_LOG_PIC24FJ128GL306 Return End
396 1735588397689 GEN4_CONNECT_DIAGNOSTICS:EXITING: com.microchip.mplab.mdbcore.pk4hybrid.pk4hybridFirmwareUpdateHandler.DownloadData()
396 1735588397689 GEN4_CONNECT_DIAGNOSTICS:ENTERING: com.microchip.mplab.mdbcore.pk4hybrid.pk4hybridFirmwareUpdateHandler.updatePk4HybridFirmware()
396 1735588397689 GEN4_CONNECT_DIAGNOSTICS:EXITING: com.microchip.mplab.mdbcore.pk4hybrid.pk4hybridFirmwareUpdateHandler.UpdateFirmware(FirmwareInfo, UpdateMessage)
396 1735588397689 GEN4_CONNECT_DIAGNOSTICS:Exiting plug and play Update()
235 1735588399777 GEN4_CONNECT_DIAGNOSTICS:Calling Update on plug and play observer com.microchip.mplab.mdbcore.RI4Tool.RI4ToolBase$RI4PlugNPlayObserver@6b90996
235 1735588399777 GEN4_CONNECT_DIAGNOSTICS:Entering plug and play Update(). Attached PID = 810a
235 1735588399777 GEN4_CONNECT_DIAGNOSTICS:Entering MPLABCommEvent handler
235 1735588399777 GEN4_CONNECT_DIAGNOSTICS:MPLABCommEvent.pid = 810a
235 1735588399777 GEN4_CONNECT_DIAGNOSTICS:eventType = MPLABCOMM_TOOL_UNPLUGGED
235 1735588399777 GEN4_CONNECT_DIAGNOSTICS:Exiting plug and play Update()
400 1735588400841 GEN4_CONNECT_DIAGNOSTICS:Entering plug and play Update(). Attached PID = 810a
400 1735588400841 GEN4_CONNECT_DIAGNOSTICS:Entering CommPnPEvent handler
400 1735588400841 GEN4_CONNECT_DIAGNOSTICS:CommPnPEvent.pid = 810b
400 1735588400841 GEN4_CONNECT_DIAGNOSTICS:Calling MPLABCommTool.Detach to remove tool from plug and play list
400 1735588400841 GEN4_CONNECT_DIAGNOSTICS:Calling RIDbgToolCom.DisconnectFromMPlabComm
400 1735588400841 GEN4_CONNECT_DIAGNOSTICS:Calling MPLABCommTool.Disconnect
400 1735588400841 com.microchip.mplab.mdbcore.RI4Tool.switchCommTool
400 1735588400841 GEN4_CONNECT_DIAGNOSTICS:Before MPLABCommTool.Connect()
400 1735588400841 GEN4_CONNECT_DIAGNOSTICS:After MPLABCommTool.Connect()
400 1735588400841 GEN4_CONNECT_DIAGNOSTICS:release com pnp

400 1735588400891 GEN4_TO_CONTROLLER_LOG:GEN4_CONNECT_INT_LOG_PIC24FJ128GL306 Pre:EstablishCommunincations
400 1735588400891 GEN4_TO_CONTROLLER_LOG:GEN4_CONNECT_INT_LOG_PIC24FJ128GL306 Payload
400 1735588400891 GEN4_TO_CONTROLLER_LOG:GEN4_CONNECT_INT_LOG_PIC24FJ128GL306 com.microchip.mplab.mdbcore.PK4Tool.PK4Com@7e7719f6
400 1735588400891 GEN4_TO_CONTROLLER_LOG:GEN4_CONNECT_INT_LOG_PIC24FJ128GL306 Payload End
400 1735588400891 GEN4_TO_CONTROLLER_LOG:GEN4_CONNECT_INT_LOG_PIC24FJ128GL306 Post:EstablishCommunincations
400 1735588400891 GEN4_TO_CONTROLLER_LOG:GEN4_CONNECT_INT_LOG_PIC24FJ128GL306 Return Value
400 1735588400891 GEN4_TO_CONTROLLER_LOG:GEN4_CONNECT_INT_LOG_PIC24FJ128GL306 true
400 1735588400891 GEN4_TO_CONTROLLER_LOG:GEN4_CONNECT_INT_LOG_PIC24FJ128GL306 Return End
400 1735588400891 GEN4_CONNECT_DIAGNOSTICS:Registering for alternate PNP notifications. CommPnPCriteria.cPIDList = [810A, 8109, 2184], CommPnPCriteria.cSerialNumber = bur204820193
400 1735588400891 GEN4_CONNECT_DIAGNOSTICS:eventType = MPLABCOMM_TOOL_PLUGGEDIN

400 1735588400891 GEN4_TO_CONTROLLER_LOG:GEN4_CONNECT_INT_LOG_PIC24FJ128GL306 Pre:GetFirmwareInfo
400 1735588400891 GEN4_TO_CONTROLLER_LOG:GEN4_CONNECT_INT_LOG_PIC24FJ128GL306 Payload
400 1735588400891 GEN4_TO_CONTROLLER_LOG:GEN4_CONNECT_INT_LOG_PIC24FJ128GL306 null
400 1735588400891 GEN4_TO_CONTROLLER_LOG:GEN4_CONNECT_INT_LOG_PIC24FJ128GL306 Payload End
400 1735588400893 XXXX 1735588400893, Thread 400: com.Send returned false 
400 1735588400894 XXXX 1735588400894, Thread 400: execCommand: exception after writeSideChanel null 
400 1735588400894 GEN4_CONNECT_DIAGNOSTICS:Exiting plug and play Update()
394 1735588401318 GEN4_CONNECT_DIAGNOSTICS:EXITING: com.microchip.mplab.mdbcore.RI4Tool.ConnectionHandler.CheckForFWUpdates()

394 1735588401318 GEN4_TO_CONTROLLER_LOG:GEN4_CONNECT_INT_LOG_PIC24FJ128GL306 Pre:SetPowerInfo
394 1735588401318 GEN4_TO_CONTROLLER_LOG:GEN4_CONNECT_INT_LOG_PIC24FJ128GL306 Payload
394 1735588401318 GEN4_TO_CONTROLLER_LOG:GEN4_CONNECT_INT_LOG_PIC24FJ128GL306 PowerInfo: Values:
394 1735588401318 GEN4_TO_CONTROLLER_LOG:GEN4_CONNECT_INT_LOG_PIC24FJ128GL306 PowerInfo: shotDownSystem = false, isToolPower = false, voltage = 3.300000, useVppFirst = false, useLowVoltageProgramming = true, useMaintainActivePower = false
394 1735588401318 GEN4_TO_CONTROLLER_LOG:GEN4_CONNECT_INT_LOG_PIC24FJ128GL306 Payload End
394 1735588401318 XXXX 1735588401318, Thread 394: XXXX 1735588401318, Entering Thread 394: Commands::runScriptBasic with script contents. contents[0] = 0x39, ...  
394 1735588401321 XXXX 1735588401321, Thread 394: com.Send returned false 
394 1735588401321 XXXX 1735588401321, Thread 394: transfer: exception after writeHeaderAndGetResult null 
394 1735588401321 XXXX 1735588401321, Thread 394: XXXX 1735588401321, Entering Thread 394: ToolCommUsb::recoverFromProtocolError, type = NO_SCRIPT  
394 1735588401322 XXXX 1735588401322, Thread 394: Send Abort Script Engine Command 
394 1735588401322 XXXX 1735588401322, Thread 394: XXXX 1735588401322, Entering Thread 394: ToolCommUsb::killScriptEngine  
394 1735588401322 XXXX 1735588401322, Thread 394: com.Send returned false 
394 1735588401322 XXXX 1735588401322, Thread 394: Failed sending Abort Script Engine Command. Set nuclear option = true 
394 1735588401322 XXXX 1735588401322, Thread 394: About to nuke 
394 1735588401322 XXXX 1735588401322, Thread 394: XXXX 1735588401322, Entering Thread 394: ToolCommUsb::nuclearOption  
394 1735588401322 XXXX 1735588401322, Thread 394: com.Send returned false
