karliedapuzzo/TDWS/TDWS_PIC24_FILES/Test_projects/tdws_testing.X/queuelogs/debugtool.txt

328 1729791630794 GEN4_CONNECT_DIAGNOSTICS:MPLABCommTool is NOT null
328 1729791630796 GEN4_CONNECT_DIAGNOSTICS:AttachedToolPID = 810b, AttachedToolVID = 4d8
328 1729791630796 GEN4_CONNECT_DIAGNOSTICS:transport type = USB
328 1729791630796 GEN4_CONNECT_DIAGNOSTICS:AttachedToolPID = 810b, AttachedToolVID = 4d8
328 1729791631369 com.microchip.mplab.mdbcore.RealICETool.RIDbgToolCom
328 1729791631369 GEN4_CONNECT_DIAGNOSTICS:Before MPLABCommTool.Connect()
328 1729791631369 GEN4_CONNECT_DIAGNOSTICS:After MPLABCommTool.Connect()
328 1729791631369 GEN4_CONNECT_DIAGNOSTICS:MPLABCommTool.Connect() returned MPLABCOMM_NO_ERROR
328 1729791631370 GEN4_CONNECT_DIAGNOSTICS:Attaching to MPLABCommTool plugnplay
328 1729791631386 GEN4_CONNECT_DIAGNOSTICS:Adding new plug and play observer com.microchip.mplab.mdbcore.RI4Tool.RI4ToolBase$RI4PlugNPlayObserver@48292dfe
328 1729791631386 GEN4_CONNECT_DIAGNOSTICS:Begin PlugNPlayObservers list dump:
328 1729791631386 GEN4_CONNECT_DIAGNOSTICS:com.microchip.mplab.mdbcore.RI4Tool.RI4ToolBase$RI4PlugNPlayObserver@48292dfe
328 1729791631386 GEN4_CONNECT_DIAGNOSTICS:End PlugNPlayObservers list dump:
328 1729791631431 GEN4_CONNECT_DIAGNOSTICS:Registering for alternate PNP notifications. CommPnPCriteria.cPIDList = [810A, 8109, 2184], CommPnPCriteria.cSerialNumber = bur204820193

328 1729791639150 GEN4_TO_CONTROLLER_LOG:GEN4_INIT_INT_LOG_PIC24FJ128GL306 Pre:init
328 1729791639150 GEN4_TO_CONTROLLER_LOG:GEN4_INIT_INT_LOG_PIC24FJ128GL306 Payload
328 1729791639151 GEN4_TO_CONTROLLER_LOG:GEN4_INIT_INT_LOG_PIC24FJ128GL306 DeviceInfo: Values:
328 1729791639151 GEN4_TO_CONTROLLER_LOG:GEN4_INIT_INT_LOG_PIC24FJ128GL306 DeviceInfo: pcAddress = 0000002e, Vpp = 3.25, useRowEraseIfVoltageIsLow = false, voltageBelowWhichUseRowErase = 0.00, deviceName = PIC24FJ128GL306, programmerType = PIC24FJ
328 1729791639151 GEN4_TO_CONTROLLER_LOG:GEN4_INIT_INT_LOG_PIC24FJ128GL306 DeviceInfo: MemInfo values:
328 1729791639151 GEN4_TO_CONTROLLER_LOG:GEN4_INIT_INT_LOG_PIC24FJ128GL306 DeviceInfo: mask = ffffff, exists = true, startAddr = 00000000, endAddr = 00015eff, rowSize = 0800, rowEraseSize = 0800, addrInc = 0002, widthProgram = 0004
328 1729791639151 GEN4_TO_CONTROLLER_LOG:GEN4_INIT_INT_LOG_PIC24FJ128GL306 DeviceInfo: mask = ffffff, exists = true, startAddr = 00015f00, endAddr = 00015fff, rowSize = 0001, rowEraseSize = 0000, addrInc = 0002, widthProgram = 0004
328 1729791639151 GEN4_TO_CONTROLLER_LOG:GEN4_INIT_INT_LOG_PIC24FJ128GL306 DeviceInfo: mask = 0000, exists = false, startAddr = 00000000, endAddr = 00000000, rowSize = 0000, rowEraseSize = 0000, addrInc = 0000, widthProgram = 0000
328 1729791639151 GEN4_TO_CONTROLLER_LOG:GEN4_INIT_INT_LOG_PIC24FJ128GL306 DeviceInfo: mask = 0000, exists = false, startAddr = 00000000, endAddr = 00000000, rowSize = 0000, rowEraseSize = 0000, addrInc = 0000, widthProgram = 0000
328 1729791639151 GEN4_TO_CONTROLLER_LOG:GEN4_INIT_INT_LOG_PIC24FJ128GL306 DeviceInfo: mask = 0000, exists = false, startAddr = 00000000, endAddr = 00000000, rowSize = 0000, rowEraseSize = 0000, addrInc = 0000, widthProgram = 0000
328 1729791639151 GEN4_TO_CONTROLLER_LOG:GEN4_INIT_INT_LOG_PIC24FJ128GL306 DeviceInfo: mask = ffffff, exists = true, startAddr = 00800000, endAddr = 008017ff, rowSize = 0800, rowEraseSize = 0800, addrInc = 0002, widthProgram = 0004
328 1729791639151 GEN4_TO_CONTROLLER_LOG:GEN4_INIT_INT_LOG_PIC24FJ128GL306 DeviceInfo: mask = 0000, exists = false, startAddr = 00000000, endAddr = 00000000, rowSize = 0000, rowEraseSize = 0000, addrInc = 0002, widthProgram = 0002
328 1729791639151 GEN4_TO_CONTROLLER_LOG:GEN4_INIT_INT_LOG_PIC24FJ128GL306 DeviceInfo: mask = 0000, exists = false, startAddr = 00000000, endAddr = 00000000, rowSize = 0000, rowEraseSize = 0000, addrInc = 0000, widthProgram = 0000
328 1729791639151 GEN4_TO_CONTROLLER_LOG:GEN4_INIT_INT_LOG_PIC24FJ128GL306 DeviceInfo: mask = 0000, exists = false, startAddr = 00000000, endAddr = 00000000, rowSize = 0000, rowEraseSize = 0000, addrInc = 0000, widthProgram = 0000
328 1729791639151 GEN4_TO_CONTROLLER_LOG:GEN4_INIT_INT_LOG_PIC24FJ128GL306 DeviceInfo: mask = 0000, exists = false, startAddr = 00000000, endAddr = 00000000, rowSize = 0000, rowEraseSize = 0000, addrInc = 0000, widthProgram = 0000
328 1729791639151 GEN4_TO_CONTROLLER_LOG:GEN4_INIT_INT_LOG_PIC24FJ128GL306 DeviceInfo: mask = 0000, exists = false, startAddr = 00000000, endAddr = 00000000, rowSize = 0000, rowEraseSize = 0000, addrInc = 0002, widthProgram = 0002
328 1729791639151 GEN4_TO_CONTROLLER_LOG:GEN4_INIT_INT_LOG_PIC24FJ128GL306 DeviceInfo: mask = 0000, exists = false, startAddr = 00000000, endAddr = 00000000, rowSize = 0000, rowEraseSize = 0000, addrInc = 0000, widthProgram = 0000
328 1729791639151 GEN4_TO_CONTROLLER_LOG:GEN4_INIT_INT_LOG_PIC24FJ128GL306 DeviceInfo: mask = 0000, exists = false, startAddr = 00000000, endAddr = 00000000, rowSize = 0000, rowEraseSize = 0000, addrInc = 0000, widthProgram = 0000
328 1729791639151 GEN4_TO_CONTROLLER_LOG:GEN4_INIT_INT_LOG_PIC24FJ128GL306 DeviceInfo: mask = ffffff, exists = true, startAddr = 00801700, endAddr = 008017ff, rowSize = 0001, rowEraseSize = 0000, addrInc = 0002, widthProgram = 0004
328 1729791639151 GEN4_TO_CONTROLLER_LOG:GEN4_INIT_INT_LOG_PIC24FJ128GL306 DeviceInfo: mask = 0000, exists = false, startAddr = 00000000, endAddr = 00000000, rowSize = 0000, rowEraseSize = 0000, addrInc = 0000, widthProgram = 0000
328 1729791639151 GEN4_TO_CONTROLLER_LOG:GEN4_INIT_INT_LOG_PIC24FJ128GL306 DeviceInfo: mask = 0000, exists = false, startAddr = 00000000, endAddr = 00000000, rowSize = 0000, rowEraseSize = 0000, addrInc = 0000, widthProgram = 0000
328 1729791639151 GEN4_TO_CONTROLLER_LOG:GEN4_INIT_INT_LOG_PIC24FJ128GL306 DeviceInfo: mask = 7fffffff, exists = true, startAddr = 00ff0000, endAddr = 00ff0003, rowSize = 0001, rowEraseSize = 0000, addrInc = 0001, widthProgram = 0001
328 1729791639151 GEN4_TO_CONTROLLER_LOG:GEN4_INIT_INT_LOG_PIC24FJ128GL306 DeviceInfo: mask = 0000, exists = false, startAddr = 00000000, endAddr = 00000000, rowSize = 0000, rowEraseSize = 0000, addrInc = 0000, widthProgram = 0000
328 1729791639151 GEN4_TO_CONTROLLER_LOG:GEN4_INIT_INT_LOG_PIC24FJ128GL306 DeviceInfo: mask = 0000, exists = false, startAddr = 00000000, endAddr = 00000000, rowSize = 0000, rowEraseSize = 0000, addrInc = 0000, widthProgram = 0000
328 1729791639151 GEN4_TO_CONTROLLER_LOG:GEN4_INIT_INT_LOG_PIC24FJ128GL306 DeviceInfo: mask = 0000, exists = false, startAddr = 00000000, endAddr = 00000000, rowSize = 0000, rowEraseSize = 0000, addrInc = 0000, widthProgram = 0000
328 1729791639151 GEN4_TO_CONTROLLER_LOG:GEN4_INIT_INT_LOG_PIC24FJ128GL306 DeviceInfo: mask = 0000, exists = false, startAddr = 00000000, endAddr = 00000000, rowSize = 0000, rowEraseSize = 0000, addrInc = 0000, widthProgram = 0000
328 1729791639151 GEN4_TO_CONTROLLER_LOG:GEN4_INIT_INT_LOG_PIC24FJ128GL306 DeviceInfo: mask = 0000, exists = false, startAddr = 00000000, endAddr = 00000000, rowSize = 0000, rowEraseSize = 0000, addrInc = 0000, widthProgram = 0000
328 1729791639151 GEN4_TO_CONTROLLER_LOG:GEN4_INIT_INT_LOG_PIC24FJ128GL306 DeviceInfo: mask = 0000, exists = true, startAddr = 00801600, endAddr = 00801609, rowSize = 0000, rowEraseSize = 0000, addrInc = 0002, widthProgram = 0004
328 1729791639151 GEN4_TO_CONTROLLER_LOG:GEN4_INIT_INT_LOG_PIC24FJ128GL306 CfgRequiredBitsMask Values:
328 1729791639151 GEN4_TO_CONTROLLER_LOG:GEN4_INIT_INT_LOG_PIC24FJ128GL306 Address = 00015f00, Mask = 00008fef
328 1729791639151 GEN4_TO_CONTROLLER_LOG:GEN4_INIT_INT_LOG_PIC24FJ128GL306 Address = 00015f10, Mask = 00001fff
328 1729791639151 GEN4_TO_CONTROLLER_LOG:GEN4_INIT_INT_LOG_PIC24FJ128GL306 Address = 00015f14, Mask = 00ff7fff
328 1729791639151 GEN4_TO_CONTROLLER_LOG:GEN4_INIT_INT_LOG_PIC24FJ128GL306 Address = 00015f18, Mask = 000000ff
328 1729791639151 GEN4_TO_CONTROLLER_LOG:GEN4_INIT_INT_LOG_PIC24FJ128GL306 Address = 00015f1c, Mask = 000000ff
328 1729791639151 GEN4_TO_CONTROLLER_LOG:GEN4_INIT_INT_LOG_PIC24FJ128GL306 Address = 00015f20, Mask = 00006bff
328 1729791639151 GEN4_TO_CONTROLLER_LOG:GEN4_INIT_INT_LOG_PIC24FJ128GL306 Address = 00015f24, Mask = 0000000f
328 1729791639151 GEN4_TO_CONTROLLER_LOG:GEN4_INIT_INT_LOG_PIC24FJ128GL306 Address = 00015f28, Mask = 00000003
328 1729791639151 GEN4_TO_CONTROLLER_LOG:GEN4_INIT_INT_LOG_PIC24FJ128GL306 Address = 00015f2c, Mask = 0000ffff
328 1729791639151 GEN4_TO_CONTROLLER_LOG:GEN4_INIT_INT_LOG_PIC24FJ128GL306 Address = 00015f30, Mask = 0000ffff
328 1729791639151 GEN4_TO_CONTROLLER_LOG:GEN4_INIT_INT_LOG_PIC24FJ128GL306 Address = 00015f34, Mask = 0000ffff
328 1729791639151 GEN4_TO_CONTROLLER_LOG:GEN4_INIT_INT_LOG_PIC24FJ128GL306 Address = 00015f38, Mask = 0000ffff
328 1729791639151 GEN4_TO_CONTROLLER_LOG:GEN4_INIT_INT_LOG_PIC24FJ128GL306 Address = 00015f3c, Mask = 00000001
328 1729791639151 GEN4_TO_CONTROLLER_LOG:GEN4_INIT_INT_LOG_PIC24FJ128GL306 Address = 00015f40, Mask = 0000041e
328 1729791639151 GEN4_TO_CONTROLLER_LOG:GEN4_INIT_INT_LOG_PIC24FJ128GL306 BasicInfo: Values:
328 1729791639151 GEN4_TO_CONTROLLER_LOG:GEN4_INIT_INT_LOG_PIC24FJ128GL306 BasicInfo: InputStream = com.microchip.mplab.libs.toolpacksupport.EquatableFileInputStream@a604c829, ToolFlavor = PICKit4
328 1729791639151 GEN4_TO_CONTROLLER_LOG:GEN4_INIT_INT_LOG_PIC24FJ128GL306 Payload End
328 1729791643331 GEN4_TO_CONTROLLER_LOG:GEN4_INIT_INT_LOG_PIC24FJ128GL306 Post:init
328 1729791643331 GEN4_TO_CONTROLLER_LOG:GEN4_INIT_INT_LOG_PIC24FJ128GL306 Return Value
328 1729791643331 GEN4_TO_CONTROLLER_LOG:GEN4_INIT_INT_LOG_PIC24FJ128GL306 none
328 1729791643331 GEN4_TO_CONTROLLER_LOG:GEN4_INIT_INT_LOG_PIC24FJ128GL306 Return End

328 1729791643331 GEN4_TO_CONTROLLER_LOG:GEN4_INIT_INT_LOG_PIC24FJ128GL306 Pre:GetInterfaceProvider
328 1729791643331 GEN4_TO_CONTROLLER_LOG:GEN4_INIT_INT_LOG_PIC24FJ128GL306 Payload
328 1729791643331 GEN4_TO_CONTROLLER_LOG:GEN4_INIT_INT_LOG_PIC24FJ128GL306 RI4DebugInterface
328 1729791643331 GEN4_TO_CONTROLLER_LOG:GEN4_INIT_INT_LOG_PIC24FJ128GL306 Payload End
328 1729791643331 GEN4_TO_CONTROLLER_LOG:GEN4_INIT_INT_LOG_PIC24FJ128GL306 Post:GetInterfaceProvider
328 1729791643331 GEN4_TO_CONTROLLER_LOG:GEN4_INIT_INT_LOG_PIC24FJ128GL306 Return Value
328 1729791643331 GEN4_TO_CONTROLLER_LOG:GEN4_INIT_INT_LOG_PIC24FJ128GL306 com.microchip.mplab.libs.RI4ToolsController.implementations.RI4DebugInterfaceImpl@2e19ef02
328 1729791643331 GEN4_TO_CONTROLLER_LOG:GEN4_INIT_INT_LOG_PIC24FJ128GL306 Return End

328 1729791643441 GEN4_TO_CONTROLLER_LOG:GEN4_INIT_INT_LOG_PIC24FJ128GL306 Pre:GetInterfaceProvider
328 1729791643441 GEN4_TO_CONTROLLER_LOG:GEN4_INIT_INT_LOG_PIC24FJ128GL306 Payload
328 1729791643441 GEN4_TO_CONTROLLER_LOG:GEN4_INIT_INT_LOG_PIC24FJ128GL306 RI4ProgramInterface
328 1729791643441 GEN4_TO_CONTROLLER_LOG:GEN4_INIT_INT_LOG_PIC24FJ128GL306 Payload End
328 1729791643441 GEN4_TO_CONTROLLER_LOG:GEN4_INIT_INT_LOG_PIC24FJ128GL306 Post:GetInterfaceProvider
328 1729791643441 GEN4_TO_CONTROLLER_LOG:GEN4_INIT_INT_LOG_PIC24FJ128GL306 Return Value
328 1729791643441 GEN4_TO_CONTROLLER_LOG:GEN4_INIT_INT_LOG_PIC24FJ128GL306 com.microchip.mplab.libs.RI4ToolsController.implementations.RI4ProgramInterfaceImpl@5c211a16
328 1729791643441 GEN4_TO_CONTROLLER_LOG:GEN4_INIT_INT_LOG_PIC24FJ128GL306 Return End

328 1729791643530 GEN4_TO_CONTROLLER_LOG:GEN4_INIT_INT_LOG_PIC24FJ128GL306 Pre:GetInterfaceProvider
328 1729791643530 GEN4_TO_CONTROLLER_LOG:GEN4_INIT_INT_LOG_PIC24FJ128GL306 Payload
328 1729791643530 GEN4_TO_CONTROLLER_LOG:GEN4_INIT_INT_LOG_PIC24FJ128GL306 RI4ConnectInterface
328 1729791643530 GEN4_TO_CONTROLLER_LOG:GEN4_INIT_INT_LOG_PIC24FJ128GL306 Payload End
328 1729791643533 GEN4_TO_CONTROLLER_LOG:GEN4_INIT_INT_LOG_PIC24FJ128GL306 Post:GetInterfaceProvider
328 1729791643533 GEN4_TO_CONTROLLER_LOG:GEN4_INIT_INT_LOG_PIC24FJ128GL306 Return Value
328 1729791643533 GEN4_TO_CONTROLLER_LOG:GEN4_INIT_INT_LOG_PIC24FJ128GL306 com.microchip.mplab.libs.PK4ToolsController.PK4ConnectInterfaceImpl@61f8713e
328 1729791643533 GEN4_TO_CONTROLLER_LOG:GEN4_INIT_INT_LOG_PIC24FJ128GL306 Return End
328 1729791643578 GEN4_CONNECT_DIAGNOSTICS:acceptablePIDs = [810a, 8109, 810b]
328 1729791643578 GEN4_CONNECT_DIAGNOSTICS:otherPIDs = [2184]
328 1729791643578 GEN4_CONNECT_DIAGNOSTICS:Setting selected tool type to pk4
328 1729791643578 GEN4_CONNECT_DIAGNOSTICS:otherPIDs = [2184]
328 1729791643578 GEN4_CONNECT_DIAGNOSTICS:acceptablePIDs = [810a, 8109, 810b]

328 1729791643581 GEN4_TO_CONTROLLER_LOG:GEN4_CONNECT_INT_LOG_PIC24FJ128GL306 Pre:selectCore
328 1729791643581 GEN4_TO_CONTROLLER_LOG:GEN4_CONNECT_INT_LOG_PIC24FJ128GL306 Payload
328 1729791643581 GEN4_TO_CONTROLLER_LOG:GEN4_CONNECT_INT_LOG_PIC24FJ128GL306 PIC24FJ128GL306
328 1729791643581 GEN4_TO_CONTROLLER_LOG:GEN4_CONNECT_INT_LOG_PIC24FJ128GL306 Payload End
328 1729791643581 GEN4_TO_CONTROLLER_LOG:GEN4_CONNECT_INT_LOG_PIC24FJ128GL306 Post:selectCore
328 1729791643581 GEN4_TO_CONTROLLER_LOG:GEN4_CONNECT_INT_LOG_PIC24FJ128GL306 Return Value
328 1729791643581 GEN4_TO_CONTROLLER_LOG:GEN4_CONNECT_INT_LOG_PIC24FJ128GL306 none
328 1729791643581 GEN4_TO_CONTROLLER_LOG:GEN4_CONNECT_INT_LOG_PIC24FJ128GL306 Return End

328 1729791643581 GEN4_TO_CONTROLLER_LOG:GEN4_INIT_INT_LOG_PIC24FJ128GL306 Pre:GetInterfaceProvider
328 1729791643581 GEN4_TO_CONTROLLER_LOG:GEN4_INIT_INT_LOG_PIC24FJ128GL306 Payload
328 1729791643581 GEN4_TO_CONTROLLER_LOG:GEN4_INIT_INT_LOG_PIC24FJ128GL306 RI4ControllerDiagnosticsInterface
328 1729791643581 GEN4_TO_CONTROLLER_LOG:GEN4_INIT_INT_LOG_PIC24FJ128GL306 Payload End
328 1729791643581 GEN4_TO_CONTROLLER_LOG:GEN4_INIT_INT_LOG_PIC24FJ128GL306 Post:GetInterfaceProvider
328 1729791643581 GEN4_TO_CONTROLLER_LOG:GEN4_INIT_INT_LOG_PIC24FJ128GL306 Return Value
328 1729791643581 GEN4_TO_CONTROLLER_LOG:GEN4_INIT_INT_LOG_PIC24FJ128GL306 com.microchip.mplab.libs.RI4ToolsController.implementations.RI4ControllerDiagnosticsInterfaceImpl@2a461491
328 1729791643581 GEN4_TO_CONTROLLER_LOG:GEN4_INIT_INT_LOG_PIC24FJ128GL306 Return End

328 1729791643581 GEN4_TO_CONTROLLER_LOG:GEN4_INIT_INT_LOG_PIC24FJ128GL306 Pre:GetInterfaceProvider
328 1729791643581 GEN4_TO_CONTROLLER_LOG:GEN4_INIT_INT_LOG_PIC24FJ128GL306 Payload
328 1729791643581 GEN4_TO_CONTROLLER_LOG:GEN4_INIT_INT_LOG_PIC24FJ128GL306 ProgrammerToGo
328 1729791643581 GEN4_TO_CONTROLLER_LOG:GEN4_INIT_INT_LOG_PIC24FJ128GL306 Payload End
328 1729791643581 GEN4_TO_CONTROLLER_LOG:GEN4_INIT_INT_LOG_PIC24FJ128GL306 Post:GetInterfaceProvider
328 1729791643581 GEN4_TO_CONTROLLER_LOG:GEN4_INIT_INT_LOG_PIC24FJ128GL306 Return Value
328 1729791643581 GEN4_TO_CONTROLLER_LOG:GEN4_INIT_INT_LOG_PIC24FJ128GL306 com.microchip.mplab.libs.RI4ToolsController.implementations.ProgrammerToGoImpl@5c9f1d34
328 1729791643581 GEN4_TO_CONTROLLER_LOG:GEN4_INIT_INT_LOG_PIC24FJ128GL306 Return End

328 1729791643582 GEN4_TO_CONTROLLER_LOG:GEN4_INIT_INT_LOG_PIC24FJ128GL306 Pre:GetInterfaceProvider
328 1729791643582 GEN4_TO_CONTROLLER_LOG:GEN4_INIT_INT_LOG_PIC24FJ128GL306 Payload
328 1729791643582 GEN4_TO_CONTROLLER_LOG:GEN4_INIT_INT_LOG_PIC24FJ128GL306 Status
328 1729791643582 GEN4_TO_CONTROLLER_LOG:GEN4_INIT_INT_LOG_PIC24FJ128GL306 Payload End
328 1729791643582 GEN4_TO_CONTROLLER_LOG:GEN4_INIT_INT_LOG_PIC24FJ128GL306 Post:GetInterfaceProvider
328 1729791643582 GEN4_TO_CONTROLLER_LOG:GEN4_INIT_INT_LOG_PIC24FJ128GL306 Return Value
328 1729791643582 GEN4_TO_CONTROLLER_LOG:GEN4_INIT_INT_LOG_PIC24FJ128GL306 null
328 1729791643582 GEN4_TO_CONTROLLER_LOG:GEN4_INIT_INT_LOG_PIC24FJ128GL306 Return End

328 1729791643604 GEN4_TO_CONTROLLER_LOG:GEN4_PROGRAM_INT_LOG_PIC24FJ128GL306 Pre:SetProgramExec
328 1729791643604 GEN4_TO_CONTROLLER_LOG:GEN4_PROGRAM_INT_LOG_PIC24FJ128GL306 Payload
328 1729791643611 GEN4_TO_CONTROLLER_LOG:GEN4_PROGRAM_INT_LOG_PIC24FJ128GL306 Test
328 1729791643611 GEN4_TO_CONTROLLER_LOG:GEN4_PROGRAM_INT_LOG_PIC24FJ128GL306 800000
328 1729791643611 GEN4_TO_CONTROLLER_LOG:GEN4_PROGRAM_INT_LOG_PIC24FJ128GL306 Length = 3108
328 1729791643611 GEN4_TO_CONTROLLER_LOG:GEN4_PROGRAM_INT_LOG_PIC24FJ128GL306 Payload End
328 1729791643613 GEN4_TO_CONTROLLER_LOG:GEN4_PROGRAM_INT_LOG_PIC24FJ128GL306 Post:SetProgramExec
328 1729791643613 GEN4_TO_CONTROLLER_LOG:GEN4_PROGRAM_INT_LOG_PIC24FJ128GL306 Return Value
328 1729791643613 GEN4_TO_CONTROLLER_LOG:GEN4_PROGRAM_INT_LOG_PIC24FJ128GL306 true
328 1729791643613 GEN4_TO_CONTROLLER_LOG:GEN4_PROGRAM_INT_LOG_PIC24FJ128GL306 Return End
328 1729791643614 GEN4_CONNECT_DIAGNOSTICS:ENTERING: com.microchip.mplab.mdbcore.RI4Tool.ConnectionHandler.CheckForFWUpdates()
328 1729791643614 GEN4_CONNECT_DIAGNOSTICS:Created FirmwareUpdateHandler com.microchip.mplab.mdbcore.pk4hybrid.pk4hybridFirmwareUpdateHandler@72927ecd
328 1729791643614 GEN4_CONNECT_DIAGNOSTICS:ENTERING: com.microchip.mplab.mdbcore.pk4hybrid.pk4hybridFirmwareUpdateHandler.UpdateFirmware(FirmwareInfo, UpdateMessage)
328 1729791643618 GEN4_CONNECT_DIAGNOSTICS:areWeInBoot returned false
328 1729791643618 GEN4_CONNECT_DIAGNOSTICS:inBoot = false
328 1729791643618 GEN4_CONNECT_DIAGNOSTICS:uMode = checkingVersions
328 1729791643618 GEN4_CONNECT_DIAGNOSTICS:selectedTool = pk4
328 1729791643619 GEN4_CONNECT_DIAGNOSTICS:current toolType = pk4
328 1729791643619 GEN4_CONNECT_DIAGNOSTICS:current tool mode = pk4
328 1729791643619 GEN4_CONNECT_DIAGNOSTICS:ENTERING: com.microchip.mplab.mdbcore.pk4hybrid.pk4hybridFirmwareUpdateHandler.GetUpdateInfo()
328 1729791643700 GEN4_CONNECT_DIAGNOSTICS:Parsing file  for firmware updates
328 1729791643700 GEN4_CONNECT_DIAGNOSTICS:ENTERING: com.microchip.mplab.mdbcore.pk4hybrid.pk4hybridFirmwareUpdateHandler.ParseSelectedVersionsFromJamFile()
328 1729791643700 GEN4_CONNECT_DIAGNOSTICS:Jame file line = pkob4_boot.hex,010141
328 1729791643701 GEN4_CONNECT_DIAGNOSTICS:Jame file line = scripts.xml,000747
328 1729791643701 GEN4_CONNECT_DIAGNOSTICS:Jame file line = pkob4_app1 000747, 0040C000
328 1729791643701 GEN4_CONNECT_DIAGNOSTICS:EXITING: com.microchip.mplab.mdbcore.pk4hybrid.pk4hybridFirmwareUpdateHandler.ri4ParseSelectedVersionsFromJamFile()
328 1729791643701 GEN4_CONNECT_DIAGNOSTICS:EXITING: com.microchip.mplab.mdbcore.pk4hybrid.pk4hybridFirmwareUpdateHandler.GetUpdateInfo()
328 1729791643701 GEN4_CONNECT_DIAGNOSTICS:current toolType = pk4

328 1729791643701 GEN4_TO_CONTROLLER_LOG:GEN4_CONNECT_INT_LOG_PIC24FJ128GL306 Pre:EstablishCommunincations
328 1729791643701 GEN4_TO_CONTROLLER_LOG:GEN4_CONNECT_INT_LOG_PIC24FJ128GL306 Payload
328 1729791643702 GEN4_TO_CONTROLLER_LOG:GEN4_CONNECT_INT_LOG_PIC24FJ128GL306 com.microchip.mplab.mdbcore.PK4Tool.PK4Com@508a688f
328 1729791643702 GEN4_TO_CONTROLLER_LOG:GEN4_CONNECT_INT_LOG_PIC24FJ128GL306 Payload End
328 1729791643713 GEN4_TO_CONTROLLER_LOG:GEN4_CONNECT_INT_LOG_PIC24FJ128GL306 Post:EstablishCommunincations
328 1729791643713 GEN4_TO_CONTROLLER_LOG:GEN4_CONNECT_INT_LOG_PIC24FJ128GL306 Return Value
328 1729791643713 GEN4_TO_CONTROLLER_LOG:GEN4_CONNECT_INT_LOG_PIC24FJ128GL306 true
328 1729791643713 GEN4_TO_CONTROLLER_LOG:GEN4_CONNECT_INT_LOG_PIC24FJ128GL306 Return End

328 1729791643713 GEN4_TO_CONTROLLER_LOG:GEN4_CONNECT_INT_LOG_PIC24FJ128GL306 Pre:GetFirmwareInfo
328 1729791643713 GEN4_TO_CONTROLLER_LOG:GEN4_CONNECT_INT_LOG_PIC24FJ128GL306 Payload
328 1729791643713 GEN4_TO_CONTROLLER_LOG:GEN4_CONNECT_INT_LOG_PIC24FJ128GL306 null
328 1729791643713 GEN4_TO_CONTROLLER_LOG:GEN4_CONNECT_INT_LOG_PIC24FJ128GL306 Payload End
328 1729791643722 XXXX 1729791643722, Thread 328: com.Send returned false 
328 1729791643724 XXXX 1729791643724, Thread 328: execCommand: exception after writeSideChanel null
