karliedapuzzo/TDWS/TDWS_PIC24_FILES/Test_projects/tdws_testing.X/debug/default/queuelogs/debugtool.txt

2092 1728058077939 GEN4_CONNECT_DIAGNOSTICS:MPLABCommTool is NOT null
2092 1728058077941 GEN4_CONNECT_DIAGNOSTICS:AttachedToolPID = 810b, AttachedToolVID = 4d8
2092 1728058077941 GEN4_CONNECT_DIAGNOSTICS:transport type = USB
2092 1728058077941 GEN4_CONNECT_DIAGNOSTICS:AttachedToolPID = 810b, AttachedToolVID = 4d8
2092 1728058077984 com.microchip.mplab.mdbcore.RealICETool.RIDbgToolCom
2092 1728058077984 GEN4_CONNECT_DIAGNOSTICS:Before MPLABCommTool.Connect()
2092 1728058077984 GEN4_CONNECT_DIAGNOSTICS:After MPLABCommTool.Connect()
2092 1728058077997 GEN4_CONNECT_DIAGNOSTICS:Adding new plug and play observer com.microchip.mplab.mdbcore.RI4Tool.RI4ToolBase$RI4PlugNPlayObserver@5ab6849a
2092 1728058077997 GEN4_CONNECT_DIAGNOSTICS:Begin PlugNPlayObservers list dump:
2092 1728058077997 GEN4_CONNECT_DIAGNOSTICS:com.microchip.mplab.mdbcore.RI4Tool.RI4ToolBase$RI4PlugNPlayObserver@5ab6849a
2092 1728058077997 GEN4_CONNECT_DIAGNOSTICS:End PlugNPlayObservers list dump:
2092 1728058077999 GEN4_CONNECT_DIAGNOSTICS:Registering for alternate PNP notifications. CommPnPCriteria.cPIDList = [810A, 8109, 2184], CommPnPCriteria.cSerialNumber = bur204820193

2092 1728058078102 GEN4_TO_CONTROLLER_LOG:GEN4_INIT_INT_LOG_PIC24FJ128GL306 Pre:init
2092 1728058078102 GEN4_TO_CONTROLLER_LOG:GEN4_INIT_INT_LOG_PIC24FJ128GL306 Payload
2092 1728058078102 GEN4_TO_CONTROLLER_LOG:GEN4_INIT_INT_LOG_PIC24FJ128GL306 DeviceInfo: Values:
2092 1728058078103 GEN4_TO_CONTROLLER_LOG:GEN4_INIT_INT_LOG_PIC24FJ128GL306 DeviceInfo: pcAddress = 0000002e, Vpp = 3.25, useRowEraseIfVoltageIsLow = false, voltageBelowWhichUseRowErase = 0.00, deviceName = PIC24FJ128GL306, programmerType = PIC24FJ
2092 1728058078103 GEN4_TO_CONTROLLER_LOG:GEN4_INIT_INT_LOG_PIC24FJ128GL306 DeviceInfo: MemInfo values:
2092 1728058078103 GEN4_TO_CONTROLLER_LOG:GEN4_INIT_INT_LOG_PIC24FJ128GL306 DeviceInfo: mask = ffffff, exists = true, startAddr = 00000000, endAddr = 00015eff, rowSize = 0800, rowEraseSize = 0800, addrInc = 0002, widthProgram = 0004
2092 1728058078103 GEN4_TO_CONTROLLER_LOG:GEN4_INIT_INT_LOG_PIC24FJ128GL306 DeviceInfo: mask = ffffff, exists = true, startAddr = 00015f00, endAddr = 00015fff, rowSize = 0001, rowEraseSize = 0000, addrInc = 0002, widthProgram = 0004
2092 1728058078103 GEN4_TO_CONTROLLER_LOG:GEN4_INIT_INT_LOG_PIC24FJ128GL306 DeviceInfo: mask = 0000, exists = false, startAddr = 00000000, endAddr = 00000000, rowSize = 0000, rowEraseSize = 0000, addrInc = 0000, widthProgram = 0000
2092 1728058078103 GEN4_TO_CONTROLLER_LOG:GEN4_INIT_INT_LOG_PIC24FJ128GL306 DeviceInfo: mask = 0000, exists = false, startAddr = 00000000, endAddr = 00000000, rowSize = 0000, rowEraseSize = 0000, addrInc = 0000, widthProgram = 0000
2092 1728058078103 GEN4_TO_CONTROLLER_LOG:GEN4_INIT_INT_LOG_PIC24FJ128GL306 DeviceInfo: mask = 0000, exists = false, startAddr = 00000000, endAddr = 00000000, rowSize = 0000, rowEraseSize = 0000, addrInc = 0000, widthProgram = 0000
2092 1728058078103 GEN4_TO_CONTROLLER_LOG:GEN4_INIT_INT_LOG_PIC24FJ128GL306 DeviceInfo: mask = ffffff, exists = true, startAddr = 00800000, endAddr = 008017ff, rowSize = 0800, rowEraseSize = 0800, addrInc = 0002, widthProgram = 0004
2092 1728058078103 GEN4_TO_CONTROLLER_LOG:GEN4_INIT_INT_LOG_PIC24FJ128GL306 DeviceInfo: mask = 0000, exists = false, startAddr = 00000000, endAddr = 00000000, rowSize = 0000, rowEraseSize = 0000, addrInc = 0002, widthProgram = 0002
2092 1728058078103 GEN4_TO_CONTROLLER_LOG:GEN4_INIT_INT_LOG_PIC24FJ128GL306 DeviceInfo: mask = 0000, exists = false, startAddr = 00000000, endAddr = 00000000, rowSize = 0000, rowEraseSize = 0000, addrInc = 0000, widthProgram = 0000
2092 1728058078103 GEN4_TO_CONTROLLER_LOG:GEN4_INIT_INT_LOG_PIC24FJ128GL306 DeviceInfo: mask = 0000, exists = false, startAddr = 00000000, endAddr = 00000000, rowSize = 0000, rowEraseSize = 0000, addrInc = 0000, widthProgram = 0000
2092 1728058078103 GEN4_TO_CONTROLLER_LOG:GEN4_INIT_INT_LOG_PIC24FJ128GL306 DeviceInfo: mask = 0000, exists = false, startAddr = 00000000, endAddr = 00000000, rowSize = 0000, rowEraseSize = 0000, addrInc = 0000, widthProgram = 0000
2092 1728058078103 GEN4_TO_CONTROLLER_LOG:GEN4_INIT_INT_LOG_PIC24FJ128GL306 DeviceInfo: mask = 0000, exists = false, startAddr = 00000000, endAddr = 00000000, rowSize = 0000, rowEraseSize = 0000, addrInc = 0002, widthProgram = 0002
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
2092 1728058078103 GEN4_TO_CONTROLLER_LOG:GEN4_INIT_INT_LOG_PIC24FJ128GL306 Address = 00015f38, Mask = 0000ffff
2092 1728058078103 GEN4_TO_CONTROLLER_LOG:GEN4_INIT_INT_LOG_PIC24FJ128GL306 Address = 00015f3c, Mask = 00000001
2092 1728058078103 GEN4_TO_CONTROLLER_LOG:GEN4_INIT_INT_LOG_PIC24FJ128GL306 Address = 00015f40, Mask = 0000041e
2092 1728058078103 GEN4_TO_CONTROLLER_LOG:GEN4_INIT_INT_LOG_PIC24FJ128GL306 BasicInfo: Values:
2092 1728058078103 GEN4_TO_CONTROLLER_LOG:GEN4_INIT_INT_LOG_PIC24FJ128GL306 BasicInfo: InputStream = com.microchip.mplab.libs.toolpacksupport.EquatableFileInputStream@a604c829, ToolFlavor = PICKit4
2092 1728058078103 GEN4_TO_CONTROLLER_LOG:GEN4_INIT_INT_LOG_PIC24FJ128GL306 Payload End
2092 1728058080938 GEN4_TO_CONTROLLER_LOG:GEN4_INIT_INT_LOG_PIC24FJ128GL306 Post:init
2092 1728058080938 GEN4_TO_CONTROLLER_LOG:GEN4_INIT_INT_LOG_PIC24FJ128GL306 Return Value
2092 1728058080938 GEN4_TO_CONTROLLER_LOG:GEN4_INIT_INT_LOG_PIC24FJ128GL306 none
2092 1728058080938 GEN4_TO_CONTROLLER_LOG:GEN4_INIT_INT_LOG_PIC24FJ128GL306 Return End

2092 1728058080938 GEN4_TO_CONTROLLER_LOG:GEN4_INIT_INT_LOG_PIC24FJ128GL306 Pre:GetInterfaceProvider
2092 1728058080938 GEN4_TO_CONTROLLER_LOG:GEN4_INIT_INT_LOG_PIC24FJ128GL306 Payload
2092 1728058080938 GEN4_TO_CONTROLLER_LOG:GEN4_INIT_INT_LOG_PIC24FJ128GL306 RI4DebugInterface
2092 1728058080938 GEN4_TO_CONTROLLER_LOG:GEN4_INIT_INT_LOG_PIC24FJ128GL306 Payload End
2092 1728058080938 GEN4_TO_CONTROLLER_LOG:GEN4_INIT_INT_LOG_PIC24FJ128GL306 Post:GetInterfaceProvider
2092 1728058080938 GEN4_TO_CONTROLLER_LOG:GEN4_INIT_INT_LOG_PIC24FJ128GL306 Return Value
2092 1728058080938 GEN4_TO_CONTROLLER_LOG:GEN4_INIT_INT_LOG_PIC24FJ128GL306 com.microchip.mplab.libs.RI4ToolsController.implementations.RI4DebugInterfaceImpl@776f1270
2092 1728058080938 GEN4_TO_CONTROLLER_LOG:GEN4_INIT_INT_LOG_PIC24FJ128GL306 Return End

2092 1728058080955 GEN4_TO_CONTROLLER_LOG:GEN4_INIT_INT_LOG_PIC24FJ128GL306 Pre:GetInterfaceProvider
2092 1728058080955 GEN4_TO_CONTROLLER_LOG:GEN4_INIT_INT_LOG_PIC24FJ128GL306 Payload
2092 1728058080955 GEN4_TO_CONTROLLER_LOG:GEN4_INIT_INT_LOG_PIC24FJ128GL306 RI4ProgramInterface
2092 1728058080955 GEN4_TO_CONTROLLER_LOG:GEN4_INIT_INT_LOG_PIC24FJ128GL306 Payload End
2092 1728058080955 GEN4_TO_CONTROLLER_LOG:GEN4_INIT_INT_LOG_PIC24FJ128GL306 Post:GetInterfaceProvider
2092 1728058080955 GEN4_TO_CONTROLLER_LOG:GEN4_INIT_INT_LOG_PIC24FJ128GL306 Return Value
2092 1728058080955 GEN4_TO_CONTROLLER_LOG:GEN4_INIT_INT_LOG_PIC24FJ128GL306 com.microchip.mplab.libs.RI4ToolsController.implementations.RI4ProgramInterfaceImpl@8973ed1
2092 1728058080955 GEN4_TO_CONTROLLER_LOG:GEN4_INIT_INT_LOG_PIC24FJ128GL306 Return End

2092 1728058080970 GEN4_TO_CONTROLLER_LOG:GEN4_INIT_INT_LOG_PIC24FJ128GL306 Pre:GetInterfaceProvider
2092 1728058080970 GEN4_TO_CONTROLLER_LOG:GEN4_INIT_INT_LOG_PIC24FJ128GL306 Payload
2092 1728058080970 GEN4_TO_CONTROLLER_LOG:GEN4_INIT_INT_LOG_PIC24FJ128GL306 RI4ConnectInterface
2092 1728058080970 GEN4_TO_CONTROLLER_LOG:GEN4_INIT_INT_LOG_PIC24FJ128GL306 Payload End
2092 1728058080971 GEN4_TO_CONTROLLER_LOG:GEN4_INIT_INT_LOG_PIC24FJ128GL306 Post:GetInterfaceProvider
2092 1728058080971 GEN4_TO_CONTROLLER_LOG:GEN4_INIT_INT_LOG_PIC24FJ128GL306 Return Value
2092 1728058080971 GEN4_TO_CONTROLLER_LOG:GEN4_INIT_INT_LOG_PIC24FJ128GL306 com.microchip.mplab.libs.PK4ToolsController.PK4ConnectInterfaceImpl@37931507
2092 1728058080971 GEN4_TO_CONTROLLER_LOG:GEN4_INIT_INT_LOG_PIC24FJ128GL306 Return End
2092 1728058080978 GEN4_CONNECT_DIAGNOSTICS:acceptablePIDs = [810a, 8109, 810b]
2092 1728058080978 GEN4_CONNECT_DIAGNOSTICS:otherPIDs = [2184]
2092 1728058080978 GEN4_CONNECT_DIAGNOSTICS:Setting selected tool type to pk4
2092 1728058080978 GEN4_CONNECT_DIAGNOSTICS:otherPIDs = [2184]
2092 1728058080978 GEN4_CONNECT_DIAGNOSTICS:acceptablePIDs = [810a, 8109, 810b]

2092 1728058080980 GEN4_TO_CONTROLLER_LOG:GEN4_CONNECT_INT_LOG_PIC24FJ128GL306 Pre:selectCore
2092 1728058080980 GEN4_TO_CONTROLLER_LOG:GEN4_CONNECT_INT_LOG_PIC24FJ128GL306 Payload
2092 1728058080980 GEN4_TO_CONTROLLER_LOG:GEN4_CONNECT_INT_LOG_PIC24FJ128GL306 PIC24FJ128GL306
2092 1728058080980 GEN4_TO_CONTROLLER_LOG:GEN4_CONNECT_INT_LOG_PIC24FJ128GL306 Payload End
2092 1728058080980 GEN4_TO_CONTROLLER_LOG:GEN4_CONNECT_INT_LOG_PIC24FJ128GL306 Post:selectCore
2092 1728058080980 GEN4_TO_CONTROLLER_LOG:GEN4_CONNECT_INT_LOG_PIC24FJ128GL306 Return Value
2092 1728058080980 GEN4_TO_CONTROLLER_LOG:GEN4_CONNECT_INT_LOG_PIC24FJ128GL306 none
2092 1728058080980 GEN4_TO_CONTROLLER_LOG:GEN4_CONNECT_INT_LOG_PIC24FJ128GL306 Return End

2092 1728058080980 GEN4_TO_CONTROLLER_LOG:GEN4_INIT_INT_LOG_PIC24FJ128GL306 Pre:GetInterfaceProvider
2092 1728058080980 GEN4_TO_CONTROLLER_LOG:GEN4_INIT_INT_LOG_PIC24FJ128GL306 Payload
2092 1728058080980 GEN4_TO_CONTROLLER_LOG:GEN4_INIT_INT_LOG_PIC24FJ128GL306 RI4ControllerDiagnosticsInterface
2092 1728058080980 GEN4_TO_CONTROLLER_LOG:GEN4_INIT_INT_LOG_PIC24FJ128GL306 Payload End
2092 1728058080980 GEN4_TO_CONTROLLER_LOG:GEN4_INIT_INT_LOG_PIC24FJ128GL306 Post:GetInterfaceProvider
2092 1728058080980 GEN4_TO_CONTROLLER_LOG:GEN4_INIT_INT_LOG_PIC24FJ128GL306 Return Value
2092 1728058080980 GEN4_TO_CONTROLLER_LOG:GEN4_INIT_INT_LOG_PIC24FJ128GL306 com.microchip.mplab.libs.RI4ToolsController.implementations.RI4ControllerDiagnosticsInterfaceImpl@6dcd3514
2092 1728058080980 GEN4_TO_CONTROLLER_LOG:GEN4_INIT_INT_LOG_PIC24FJ128GL306 Return End

2092 1728058080980 GEN4_TO_CONTROLLER_LOG:GEN4_INIT_INT_LOG_PIC24FJ128GL306 Pre:GetInterfaceProvider
2092 1728058080980 GEN4_TO_CONTROLLER_LOG:GEN4_INIT_INT_LOG_PIC24FJ128GL306 Payload
2092 1728058080980 GEN4_TO_CONTROLLER_LOG:GEN4_INIT_INT_LOG_PIC24FJ128GL306 ProgrammerToGo
2092 1728058080980 GEN4_TO_CONTROLLER_LOG:GEN4_INIT_INT_LOG_PIC24FJ128GL306 Payload End
2092 1728058080980 GEN4_TO_CONTROLLER_LOG:GEN4_INIT_INT_LOG_PIC24FJ128GL306 Post:GetInterfaceProvider
2092 1728058080980 GEN4_TO_CONTROLLER_LOG:GEN4_INIT_INT_LOG_PIC24FJ128GL306 Return Value
2092 1728058080980 GEN4_TO_CONTROLLER_LOG:GEN4_INIT_INT_LOG_PIC24FJ128GL306 com.microchip.mplab.libs.RI4ToolsController.implementations.ProgrammerToGoImpl@4b0f3d59
2092 1728058080980 GEN4_TO_CONTROLLER_LOG:GEN4_INIT_INT_LOG_PIC24FJ128GL306 Return End

2092 1728058080980 GEN4_TO_CONTROLLER_LOG:GEN4_INIT_INT_LOG_PIC24FJ128GL306 Pre:GetInterfaceProvider
2092 1728058080980 GEN4_TO_CONTROLLER_LOG:GEN4_INIT_INT_LOG_PIC24FJ128GL306 Payload
2092 1728058080980 GEN4_TO_CONTROLLER_LOG:GEN4_INIT_INT_LOG_PIC24FJ128GL306 Status
2092 1728058080980 GEN4_TO_CONTROLLER_LOG:GEN4_INIT_INT_LOG_PIC24FJ128GL306 Payload End
2092 1728058080980 GEN4_TO_CONTROLLER_LOG:GEN4_INIT_INT_LOG_PIC24FJ128GL306 Post:GetInterfaceProvider
2092 1728058080980 GEN4_TO_CONTROLLER_LOG:GEN4_INIT_INT_LOG_PIC24FJ128GL306 Return Value
2092 1728058080980 GEN4_TO_CONTROLLER_LOG:GEN4_INIT_INT_LOG_PIC24FJ128GL306 null
2092 1728058080980 GEN4_TO_CONTROLLER_LOG:GEN4_INIT_INT_LOG_PIC24FJ128GL306 Return End

2092 1728058080987 GEN4_TO_CONTROLLER_LOG:GEN4_PROGRAM_INT_LOG_PIC24FJ128GL306 Pre:SetProgramExec
2092 1728058080987 GEN4_TO_CONTROLLER_LOG:GEN4_PROGRAM_INT_LOG_PIC24FJ128GL306 Payload
2092 1728058080988 GEN4_TO_CONTROLLER_LOG:GEN4_PROGRAM_INT_LOG_PIC24FJ128GL306 Test
2092 1728058080988 GEN4_TO_CONTROLLER_LOG:GEN4_PROGRAM_INT_LOG_PIC24FJ128GL306 800000
2092 1728058080988 GEN4_TO_CONTROLLER_LOG:GEN4_PROGRAM_INT_LOG_PIC24FJ128GL306 Length = 3108
2092 1728058080988 GEN4_TO_CONTROLLER_LOG:GEN4_PROGRAM_INT_LOG_PIC24FJ128GL306 Payload End
2092 1728058080989 GEN4_TO_CONTROLLER_LOG:GEN4_PROGRAM_INT_LOG_PIC24FJ128GL306 Post:SetProgramExec
2092 1728058080989 GEN4_TO_CONTROLLER_LOG:GEN4_PROGRAM_INT_LOG_PIC24FJ128GL306 Return Value
2092 1728058080989 GEN4_TO_CONTROLLER_LOG:GEN4_PROGRAM_INT_LOG_PIC24FJ128GL306 true
2092 1728058080989 GEN4_TO_CONTROLLER_LOG:GEN4_PROGRAM_INT_LOG_PIC24FJ128GL306 Return End
2092 1728058080989 GEN4_CONNECT_DIAGNOSTICS:ENTERING: com.microchip.mplab.mdbcore.RI4Tool.ConnectionHandler.CheckForFWUpdates()
2092 1728058080989 GEN4_CONNECT_DIAGNOSTICS:Created FirmwareUpdateHandler com.microchip.mplab.mdbcore.pk4hybrid.pk4hybridFirmwareUpdateHandler@209d9bd0
2092 1728058080989 GEN4_CONNECT_DIAGNOSTICS:ENTERING: com.microchip.mplab.mdbcore.pk4hybrid.pk4hybridFirmwareUpdateHandler.UpdateFirmware(FirmwareInfo, UpdateMessage)
2092 1728058080992 GEN4_CONNECT_DIAGNOSTICS:areWeInBoot returned false
2092 1728058080992 GEN4_CONNECT_DIAGNOSTICS:inBoot = false
2092 1728058080992 GEN4_CONNECT_DIAGNOSTICS:uMode = checkingVersions
2092 1728058080992 GEN4_CONNECT_DIAGNOSTICS:selectedTool = pk4
2092 1728058080992 GEN4_CONNECT_DIAGNOSTICS:current toolType = pk4
2092 1728058080992 GEN4_CONNECT_DIAGNOSTICS:current tool mode = pk4
2092 1728058080992 GEN4_CONNECT_DIAGNOSTICS:ENTERING: com.microchip.mplab.mdbcore.pk4hybrid.pk4hybridFirmwareUpdateHandler.GetUpdateInfo()
2092 1728058080993 GEN4_CONNECT_DIAGNOSTICS:Parsing file  for firmware updates
2092 1728058080993 GEN4_CONNECT_DIAGNOSTICS:ENTERING: com.microchip.mplab.mdbcore.pk4hybrid.pk4hybridFirmwareUpdateHandler.ParseSelectedVersionsFromJamFile()
2092 1728058080993 GEN4_CONNECT_DIAGNOSTICS:Jame file line = pkob4_boot.hex,010141
2092 1728058080993 GEN4_CONNECT_DIAGNOSTICS:Jame file line = scripts.xml,000747
2092 1728058080993 GEN4_CONNECT_DIAGNOSTICS:Jame file line = pkob4_app1 000747, 0040C000
2092 1728058080993 GEN4_CONNECT_DIAGNOSTICS:EXITING: com.microchip.mplab.mdbcore.pk4hybrid.pk4hybridFirmwareUpdateHandler.ri4ParseSelectedVersionsFromJamFile()
2092 1728058080993 GEN4_CONNECT_DIAGNOSTICS:EXITING: com.microchip.mplab.mdbcore.pk4hybrid.pk4hybridFirmwareUpdateHandler.GetUpdateInfo()
2092 1728058080993 GEN4_CONNECT_DIAGNOSTICS:current toolType = pk4

2092 1728058080993 GEN4_TO_CONTROLLER_LOG:GEN4_CONNECT_INT_LOG_PIC24FJ128GL306 Pre:EstablishCommunincations
2092 1728058080993 GEN4_TO_CONTROLLER_LOG:GEN4_CONNECT_INT_LOG_PIC24FJ128GL306 Payload
2092 1728058080993 GEN4_TO_CONTROLLER_LOG:GEN4_CONNECT_INT_LOG_PIC24FJ128GL306 com.microchip.mplab.mdbcore.PK4Tool.PK4Com@483a4d51
2092 1728058080993 GEN4_TO_CONTROLLER_LOG:GEN4_CONNECT_INT_LOG_PIC24FJ128GL306 Payload End
2092 1728058081001 GEN4_TO_CONTROLLER_LOG:GEN4_CONNECT_INT_LOG_PIC24FJ128GL306 Post:EstablishCommunincations
2092 1728058081001 GEN4_TO_CONTROLLER_LOG:GEN4_CONNECT_INT_LOG_PIC24FJ128GL306 Return Value
2092 1728058081001 GEN4_TO_CONTROLLER_LOG:GEN4_CONNECT_INT_LOG_PIC24FJ128GL306 true
2092 1728058081001 GEN4_TO_CONTROLLER_LOG:GEN4_CONNECT_INT_LOG_PIC24FJ128GL306 Return End

2092 1728058081001 GEN4_TO_CONTROLLER_LOG:GEN4_CONNECT_INT_LOG_PIC24FJ128GL306 Pre:GetFirmwareInfo
2092 1728058081001 GEN4_TO_CONTROLLER_LOG:GEN4_CONNECT_INT_LOG_PIC24FJ128GL306 Payload
2092 1728058081001 GEN4_TO_CONTROLLER_LOG:GEN4_CONNECT_INT_LOG_PIC24FJ128GL306 null
2092 1728058081001 GEN4_TO_CONTROLLER_LOG:GEN4_CONNECT_INT_LOG_PIC24FJ128GL306 Payload End
2092 1728058081003 XXXX 1728058081003, Thread 2092: com.Send returned false 
2092 1728058081003 XXXX 1728058081003, Thread 2092: execCommand: exception after writeSideChanel null
