karliedapuzzo/TDWS/Additional Resources/Final Bill of Materials with Links.pdf

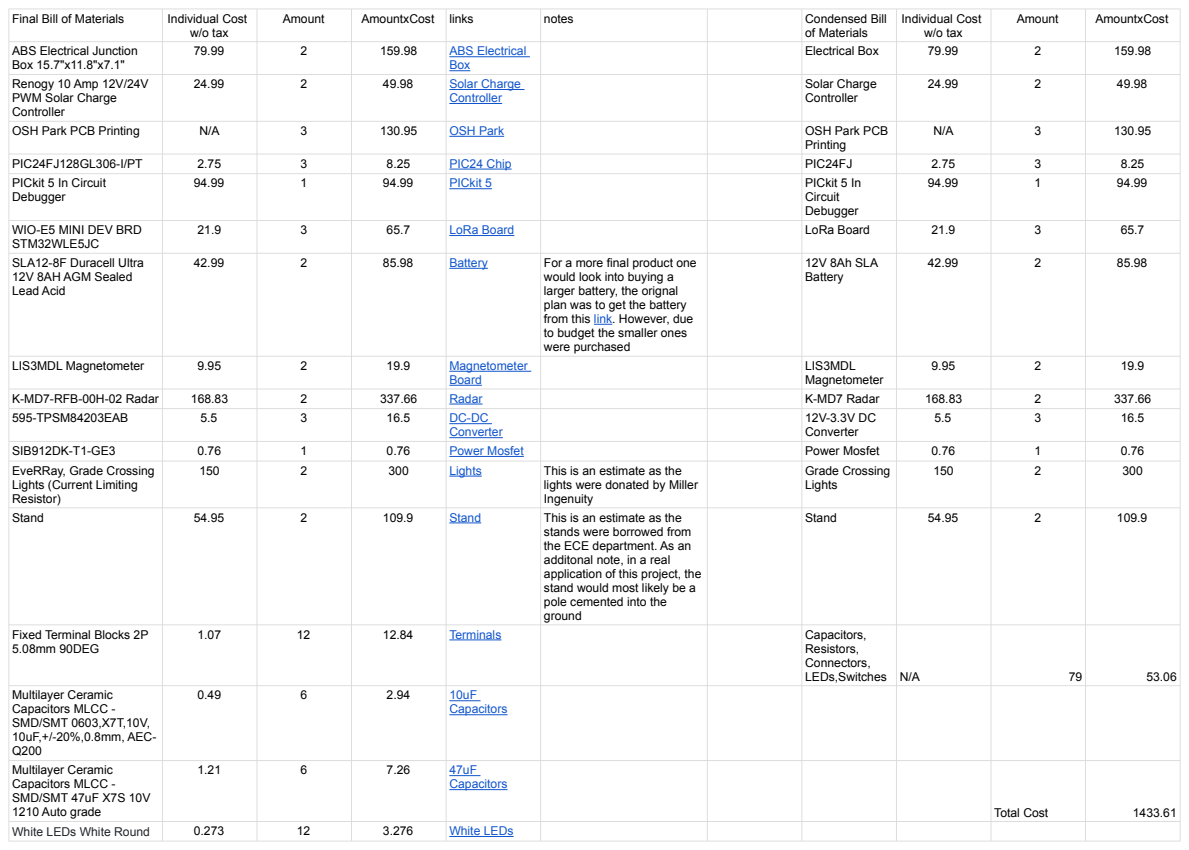
[picture p5: page 1]
Final Bill of Materials; Individual Cost; w/o tax; Amount; AmountxCost; links; notes; Condensed Bill; of Materials; Individual Cost w/o tax; ABS Electrical; Box; Electrical Box; Solar Charge; Controller; Solar Charge Controller; OSH Park PCB Printing; OSH Park; OSH Park PCB; Printing; PIC24FJ128GL306-I/PT; PIC24 Chip; PIC24FJ; PICkit 5; PICkit 5 In; Circuit Debugger; LoRa Board; Battery; For a more final product one; 12V 8Ah SLA Battery; LIS3MDL Magnetometer; Magnetometer; Board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

ABS Electrical Junction
Box 15.7"x11.8"x7.1"
Renogy 10 Amp 12V/24V
PWM Solar Charge
Controller

PICkit 5 In Circuit
Debugger

WIO-E5 MINI DEV BRD
STM32WLE5JC
SLA12-8F Duracell Ultra
12V 8AH AGM Sealed
Lead Acid

would look into buying a
larger battery, the orignal
plan was to get the battery
from this link. However, due
to budget the smaller ones
were purchased

EveRRay, Grade Crossing
Lights (Current Limiting
Resistor)

lights were donated by Miller
Ingenuity

stands were borrowed from
the ECE department. As an
additonal note, in a real
application of this project, the
stand would most likely be a
pole cemented into the
ground

Fixed Terminal Blocks 2P
5.08mm 90DEG

Headers & Wire Housings Female Header - 2x18 | 1.75 | 6 | 10.5 | Headers (https://www.mouser.com/ProductDetail/SparkFun/PRT-16581?qs=sPbYRqrBIVmf2mq2gyI4eA%3D%3D)
Headers & Wire Housings CONN HEADER R/A 8POS 2.54MM | 0.2 | 3 | 0.6 | Programmer Headers (https://www.mouser.com/ProductDetail/Adam-Tech/PH1RB-08-UA?qs=HoCaDK9Nz5cNVithjicOAg%3D%3D)
DIP Switches / SIP Switches 4 Pole Short Actuator (white) | 1.11 | 3 | 3.33 | Switches (https://www.mouser.com/ProductDetail/Omron-Electronics/A6FR-4101?qs=fAHHVMwC%252BbjNPtP%252BOhFT7Q%3D%3D)
Thin Film Resistors - SMD 220ohms 0.1% 10ppm | 0.572 | 12 | 6.864 | LED Resistors (https://www.mouser.com/ProductDetail/Vishay-Dale/TNPW0603220RBYEN?qs=iLbezkQI%252BsiHbIz3H5T35A%3D%3D)
Thin Film Resistors - SMD .1W 10Kohms .1% 0603 15ppm | 0.56 | 4 | 2.24 | 10k Resistors (https://www.mouser.com/ProductDetail/Vishay-Beyschlag/MCT06030E1002BP100?qs=hjSuqQECij8a4wyJBhoGbA%3D%3D)
Multilayer Ceramic Capacitors MLCC -SMD/SMT 100V 100000pF 5% X7R 1608 AEC-Q200 | 0.214 | 15 | 3.21 | 0.1uF Capacitors (https://www.mouser.com/ProductDetail/KEMET/C0603C104J1RACAUTO7411?qs=ulEaXIWI0c%252BJFv1YOR%252BSZg%3D%3D)
| | Total Cost | 1433.61
