karliedapuzzo/TDWS/Schematic Files/Senior_Project_Schematic_Design/senior_proj_schematic.pdf

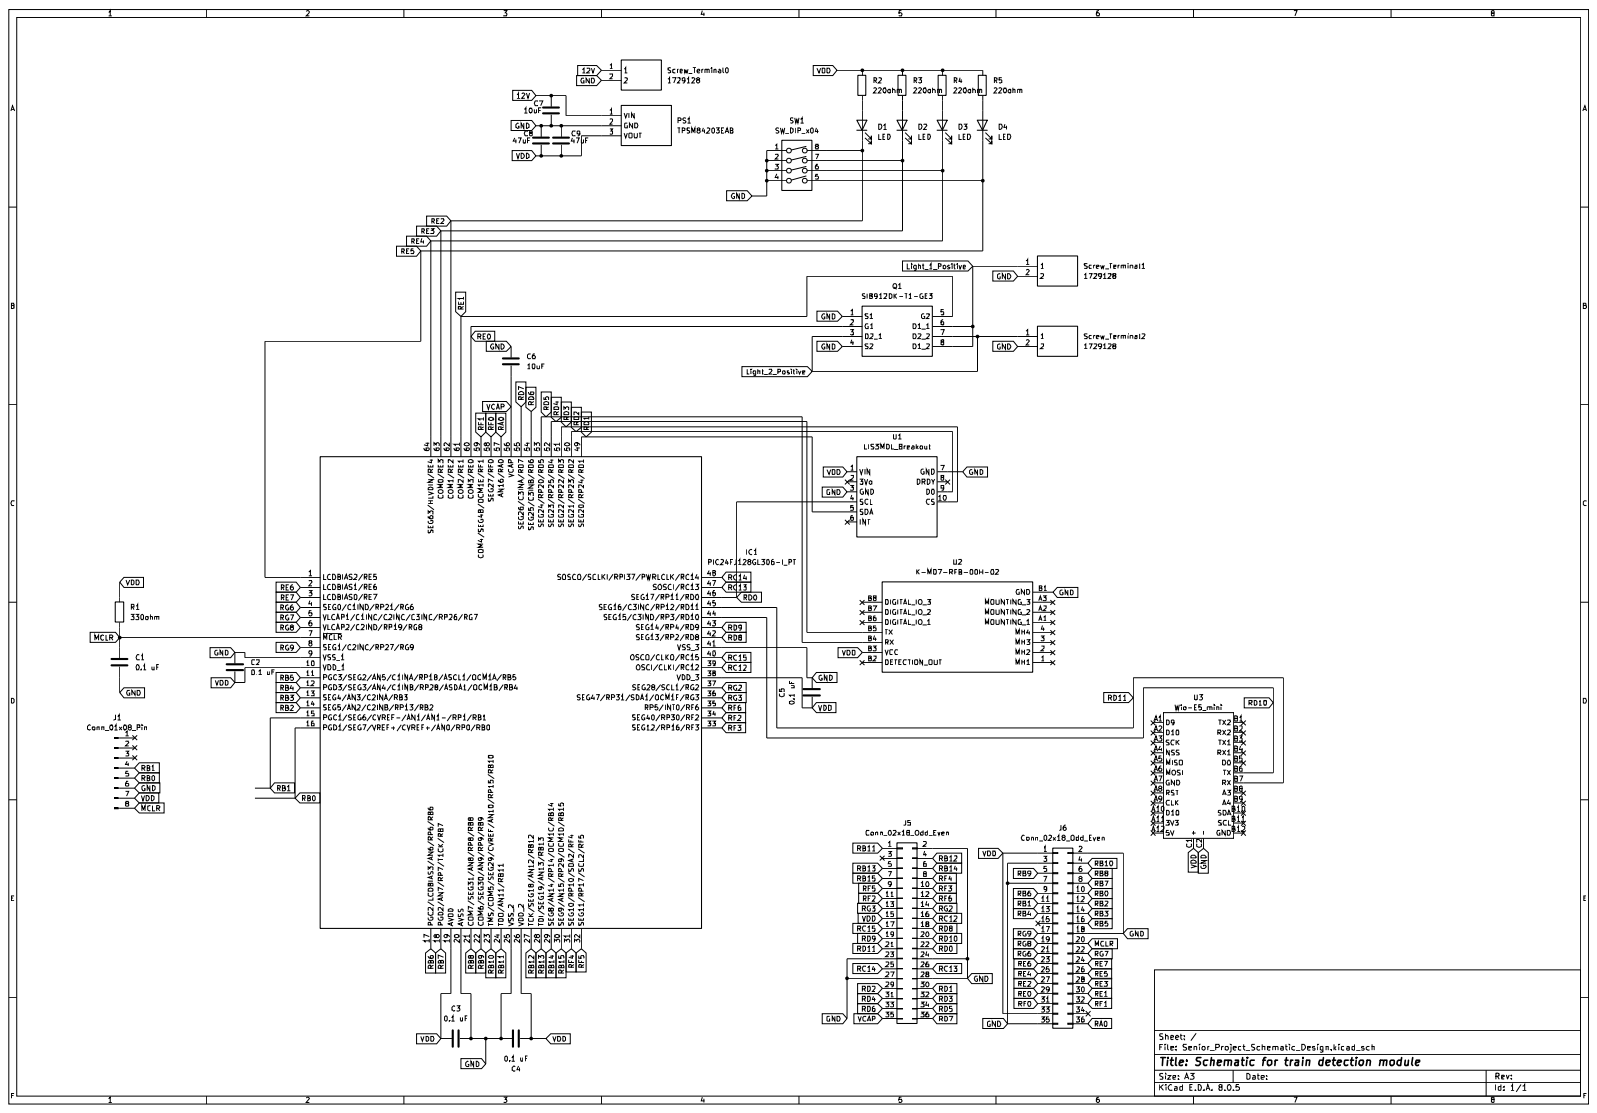
[picture p10: page 1]
