karliedapuzzo/TDWS/Schematic Files/Senior_Project_Schematic_Design/Senior_Project_Schematic_Design.kicad_pcb

## KiCad design Schematic Files/Senior_Project_Schematic_Design/Senior_Project_Schematic_Design.kicad_pcb (2025-04-16)

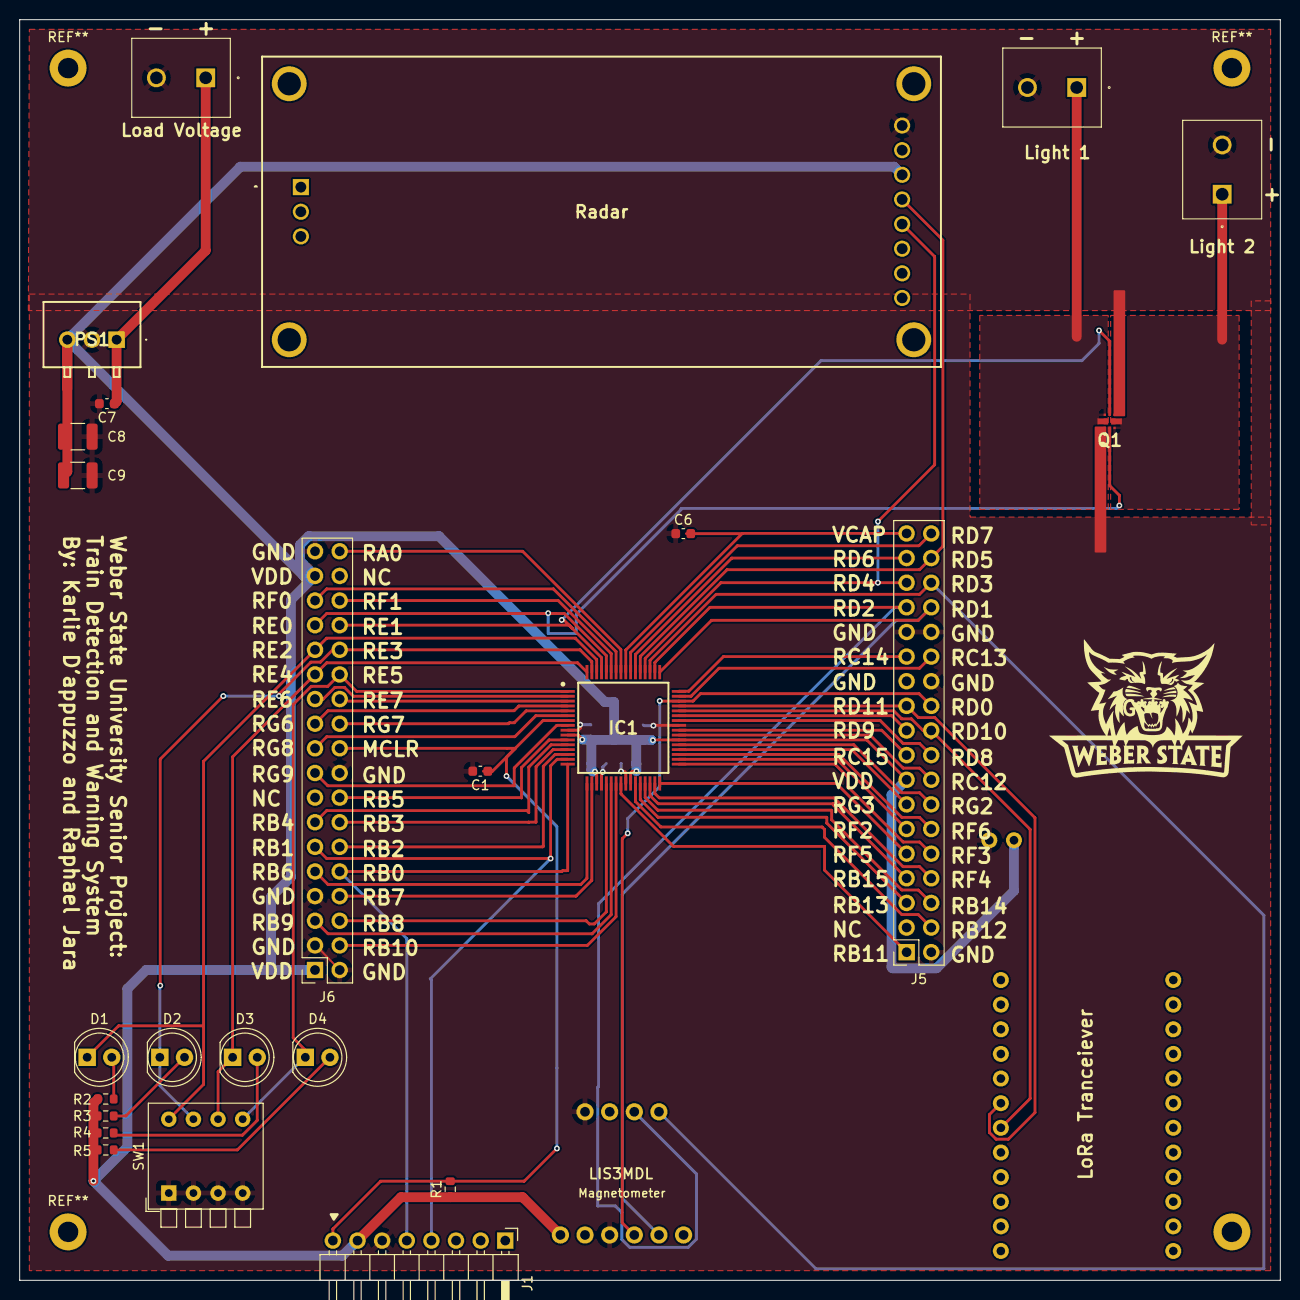
[picture p11: board Senior_Project_Schematic_Design.kicad_pcb from above]

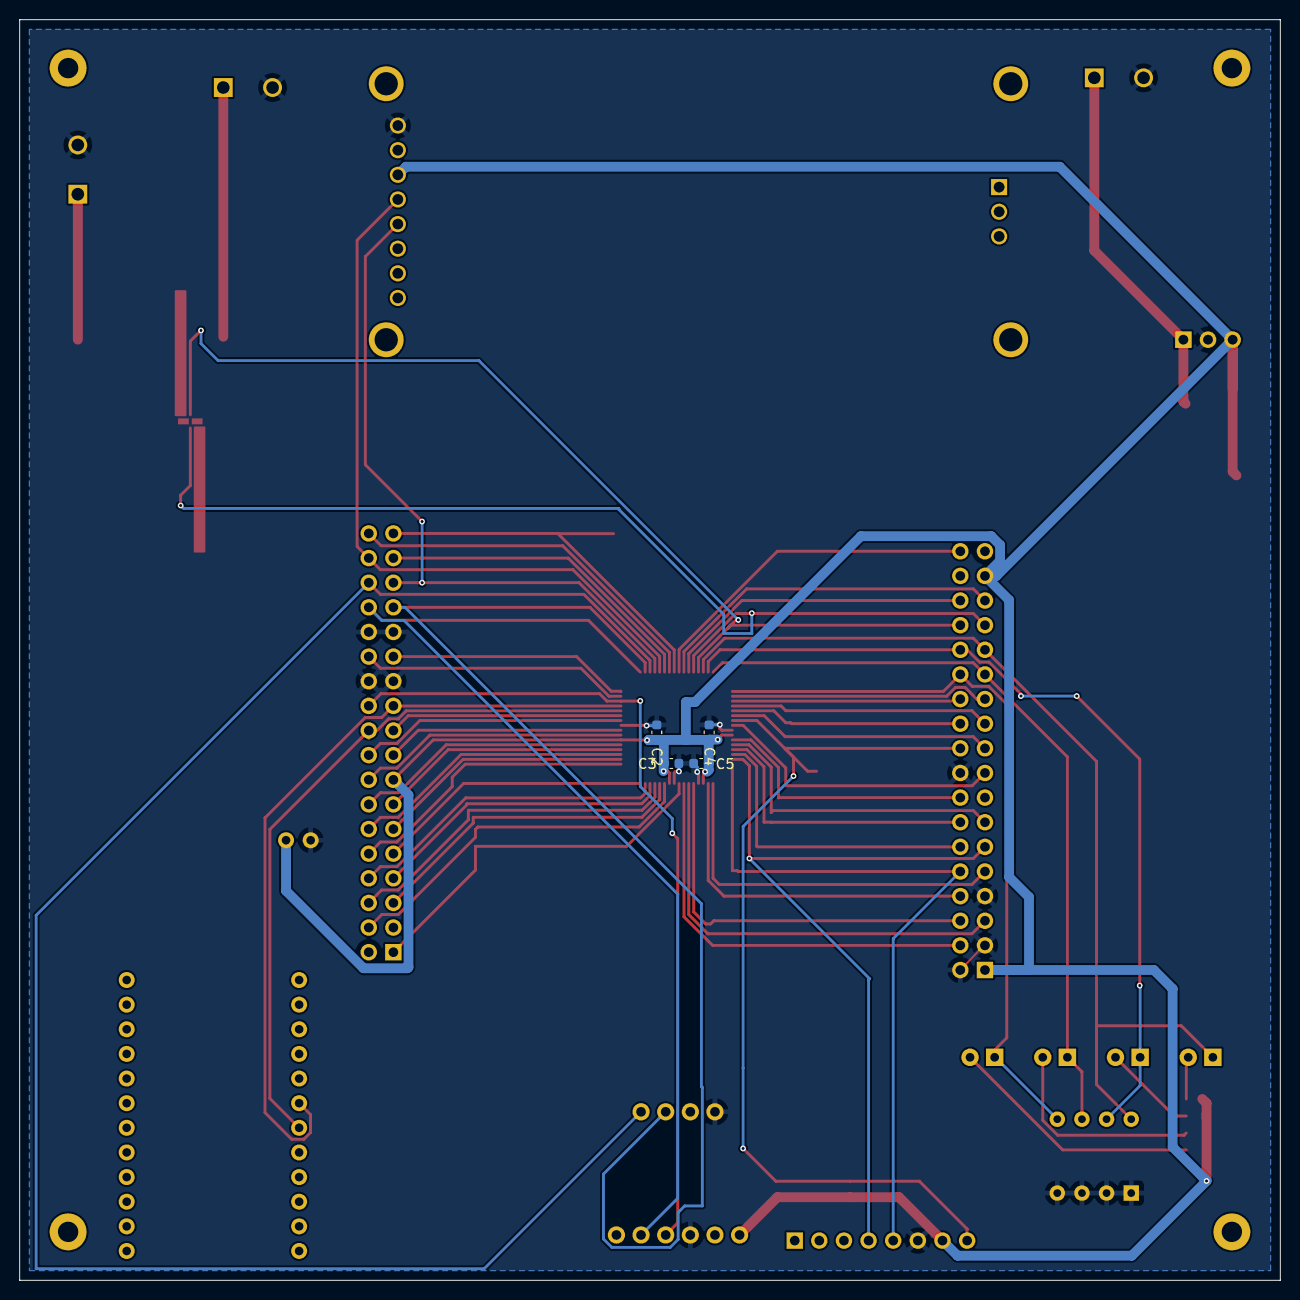
[picture p12: board Senior_Project_Schematic_Design.kicad_pcb from below]

Board: 2 copper layers, 130.0 x 130.0 mm, 31 parts (4 on the bottom side), 65 nets.

Parts:
C1, C2, C3, C4, C5: 0.1 uF; C_0603_1608Metric
C6, C7: 10uF; C_0603_1608Metric
C8, C9: 47uF; C_1210_3225Metric
D1, D2, D3, D4: LED; LED_D5.0mm
IC1: PIC24FJ128GL306-I_PT; QFP50P1200X1200X120-64N
J1: Conn_01x08_Pin; PinHeader_1x08_P2.54mm_Horizontal
J5, J6: Conn_02x18_Odd_Even; PinSocket_2x18_P2.54mm_Vertical
Light 1, Light 2: 1729128
Load Voltage: 1729128
PS1: TPSM84203EAB
Q1: SIB912DK-T1-GE3; SIB912DKT1GE3
R1: 330ohm; R_0603_1608Metric
R2, R3, R4, R5: 1kohm; R_0603_1608Metric
Radar: K-MD7-RFB-00H-02; KMD7RFB00H02
SW1: SW_DIP_x04; SW_DIP_SPSTx04_Piano_10.8x11.72mm_W7.62mm_P2.54mm
U1: LIS3MDL_Breakout; LIS3MDL
U3: Wio-E5_mini

Connections:
12V: C7.1, Load Voltage.1, PS1.1 (VIN)
GND: C1.2, C2.1, C3.1, C4.1, C5.1, C6.1, C7.2, C8.1, C9.2, IC1.9 (VSS_1), IC1.20 (AVSS), IC1.25 (VSS_2), IC1.41 (VSS_3), J1.6, J5.2, J5.23, J5.24, J5.27, J5.28, J6.2, J6.3, J6.7, J6.18, J6.35, Light 1.2, Light 2.2, Load Voltage.2, PS1.2 (GND), Q1.1 (S1), Q1.4 (S2), Radar.B1 (GND), SW1.1, SW1.2, SW1.3, SW1.4, U1.3 (GND), U1.7 (GND), U3.C2 (-)
Light_1_Positive: Light 1.1, Q1.6 (D1_1), Q1.8 (D1_2)
Light_2_Positive: Light 2.1, Q1.3 (D2_1), Q1.7 (D2_2)
MCLR: C1.1, IC1.7 (~MCLR), J1.8, J6.20, R1.2
unnamed: D1.2 (A), R2.2
unnamed: D2.2 (A), R3.2
unnamed: D3.2 (A), R4.2
unnamed: D4.2 (A), R5.2
RA0: IC1.57 (AN16/RA0), J6.36
RB0: IC1.16 (PGD1/SEG7/VREF+/CVREF+/AN0/RP0/RB0), J1.5, J6.10
RB1: IC1.15 (PGC1/SEG6/CVREF-/AN1/AN1-/RP1/RB1), J1.4, J6.11
RB2: IC1.14 (SEG5/AN2/C2INB/RP13/RB2), J6.12
RB3: IC1.13 (SEG4/AN3/C2INA/RB3), J6.14
RB4: IC1.12 (PGD3/SEG3/AN4/C1INB/RP28/ASDA1/OCM1B/RB4), J6.13
RB5: IC1.11 (PGC3/SEG2/AN5/C1INA/RP18/ASCL1/OCM1A/RB5), J6.16
RB6: IC1.17 (PGC2/LCDBIAS3/AN6/RP6/RB6), J6.9
RB7: IC1.18 (PGD2/AN7/RP7/T1CK/RB7), J6.8
RB8: IC1.21 (COM7/SEG31/AN8/RP8/RB8), J6.6
RB9: IC1.22 (COM6/SEG30/AN9/RP9/RB9), J6.5
RB10: IC1.23 (TMS/COM5/SEG29/CVREF/AN10/RP15/RB10), J6.4
RB11: IC1.24 (TDO/AN11/RB11), J5.1
RB12: IC1.27 (TCK/SEG18/AN12/RB12), J5.4
RB13: IC1.28 (TDI/SEG19/AN13/RB13), J5.5
RB14: IC1.29 (SEG8/AN14/RP14/OCM1C/RB14), J5.6
RB15: IC1.30 (SEG9/AN15/RP29/OCM1D/RB15), J5.7
RC12: IC1.39 (OSCI/CLKI/RC12), J5.16
RC13: IC1.47 (SOSCI/RC13), J5.26
RC14: IC1.48 (SOSCO/SCLKI/RPI37/PWRLCLK/RC14), J5.25
RC15: IC1.40 (OSCO/CLKO/RC15), J5.17
RD0: IC1.46 (SEG17/RP11/RD0), J5.22, U1.4 (SCL)
RD1: IC1.49 (SEG20/RP24/RD1), J5.30, U1.5 (SDA)
RD2: IC1.50 (SEG21/RP23/RD2), J5.29, U1.9 (D0)
RD3: IC1.51 (SEG22/RP22/RD3), J5.32, U1.10 (CS)
RD4: IC1.52 (SEG23/RP25/RD4), J5.31, Radar.B5 (TX)
RD5: IC1.53 (SEG24/RP20/RD5), J5.34, Radar.B4 (RX)
RD6: IC1.54 (SEG25/C3INB/RD6), J5.33
RD7: IC1.55 (SEG26/C3INA/RD7), J5.36
RD8: IC1.42 (SEG13/RP2/RD8), J5.18
RD9: IC1.43 (SEG14/RP4/RD9), J5.19
RD10: IC1.44 (SEG15/C3IND/RP3/RD10), J5.20, U3.B6 (TX)
RD11: IC1.45 (SEG16/C3INC/RP12/RD11), J5.21, U3.B7 (RX)
RE0: IC1.60 (COM3/RE0), J6.29, Q1.2 (G1)
RE1: IC1.61 (COM2/RE1), J6.30, Q1.5 (G2)
RE2: D1.1 (K), IC1.62 (COM1/RE2), J6.27, SW1.8
RE3: D2.1 (K), IC1.63 (COM0/RE3), J6.28, SW1.7
RE4: D3.1 (K), IC1.64 (SEG63/HLVDIN/RE4), J6.25, SW1.6
RE5: D4.1 (K), IC1.1 (LCDBIAS2/RE5), J6.26, SW1.5
RE6: IC1.2 (LCDBIAS1/RE6), J6.23
RE7: IC1.3 (LCDBIAS0/RE7), J6.24
RF0: IC1.58 (SEG27/RF0), J6.31
RF1: IC1.59 (COM4/SEG48/OCM1E/RF1), J6.32
RF2: IC1.34 (SEG40/RP30/RF2), J5.11
RF3: IC1.33 (SEG12/RP16/RF3), J5.10
RF4: IC1.31 (SEG10/RP10/SDA2/RF4), J5.8
RF5: IC1.32 (SEG11/RP17/SCL2/RF5), J5.9
RF6: IC1.35 (RP5/INT0/RF6), J5.12
RG2: IC1.37 (SEG28/SCL1/RG2), J5.14
RG3: IC1.36 (SEG47/RP31/SDA1/OCM1F/RG3), J5.13
RG6: IC1.4 (SEG0/C1IND/RP21/RG6), J6.21
RG7: IC1.5 (VLCAP1/C1INC/C2INC/C3INC/RP26/RG7), J6.22
RG8: IC1.6 (VLCAP2/C2IND/RP19/RG8), J6.19
RG9: IC1.8 (SEG1/C2INC/RP27/RG9), J6.17
VCAP: C6.2, IC1.56 (VCAP), J5.35
VDD: C2.2, C3.2, C4.2, C5.2, C8.2, C9.1, IC1.10 (VDD_1), IC1.19 (AVDD), IC1.26 (VDD_2), IC1.38 (VDD_3), J1.7, J5.15, J6.1, J6.33, PS1.3 (VOUT), R1.1, R2.1, R3.1, R4.1, R5.1, Radar.B3 (VCC), U1.1 (VIN), U3.C1 (+)
