karliedapuzzo/TDWS/TDWS_PIC24_FILES/Main_Project/TDWS_Main_Prgram.X/mcc_generated_files/pin_manager.h

/**
  PIN MANAGER Generated Driver File

  @Company:
    Microchip Technology Inc.

  @File Name:
    pin_manager.h

  @Summary:
    This is the generated manager file for the PIC24 / dsPIC33 / PIC32MM MCUs device.  This manager
    configures the pins direction, initial state, analog setting.
    The peripheral pin select, PPS, configuration is also handled by this manager.

  @Description:
    This source file provides implementations for PIN MANAGER.
    Generation Information :
        Product Revision  :  PIC24 / dsPIC33 / PIC32MM MCUs - 1.171.5
        Device            :  PIC24FJ128GL306
    The generated drivers are tested against the following:
        Compiler          :  XC16 v2.10
        MPLAB 	          :  MPLAB X v6.05
*/

/*
    (c) 2020 Microchip Technology Inc. and its subsidiaries. You may use this
    software and any derivatives exclusively with Microchip products.

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
    IN NO EVENT WILL MICROCHIP BE LIABLE FOR ANY INDIRECT, SPECIAL, PUNITIVE,
    INCIDENTAL OR CONSEQUENTIAL LOSS, DAMAGE, COST OR EXPENSE OF ANY KIND
    WHATSOEVER RELATED TO THE SOFTWARE, HOWEVER CAUSED, EVEN IF MICROCHIP HAS
    BEEN ADVISED OF THE POSSIBILITY OR THE DAMAGES ARE FORESEEABLE. TO THE
    FULLEST EXTENT ALLOWED BY LAW, MICROCHIP'S TOTAL LIABILITY ON ALL CLAIMS IN
    ANY WAY RELATED TO THIS SOFTWARE WILL NOT EXCEED THE AMOUNT OF FEES, IF ANY,
    THAT YOU HAVE PAID DIRECTLY TO MICROCHIP FOR THIS SOFTWARE.

    MICROCHIP PROVIDES THIS SOFTWARE CONDITIONALLY UPON YOUR ACCEPTANCE OF THESE
    TERMS.
*/

#ifndef _PIN_MANAGER_H
#define _PIN_MANAGER_H
/**
    Section: Includes
*/
#include <xc.h>

/**
    Section: Device Pin Macros
*/
/**
  @Summary
    Sets the GPIO pin, RD0, high using LATD0.

  @Description
    Sets the GPIO pin, RD0, high using LATD0.

  @Preconditions
    The RD0 must be set to an output.

  @Returns
    None.

  @Param
    None.

  @Example
    <code>
    // Set RD0 high (1)
    SCK1OUT_SetHigh();
    </code>

*/
#define SCK1OUT_SetHigh()          (_LATD0 = 1)
/**
  @Summary
    Sets the GPIO pin, RD0, low using LATD0.

  @Description
    Sets the GPIO pin, RD0, low using LATD0.

  @Preconditions
    The RD0 must be set to an output.

  @Returns
    None.

  @Param
    None.

  @Example
    <code>
    // Set RD0 low (0)
    SCK1OUT_SetLow();
    </code>

*/
#define SCK1OUT_SetLow()           (_LATD0 = 0)
/**
  @Summary
    Toggles the GPIO pin, RD0, using LATD0.

  @Description
    Toggles the GPIO pin, RD0, using LATD0.

  @Preconditions
    The RD0 must be set to an output.

  @Returns
    None.

  @Param
    None.

  @Example
    <code>
    // Toggle RD0
    SCK1OUT_Toggle();
    </code>

*/
#define SCK1OUT_Toggle()           (_LATD0 ^= 1)
/**
  @Summary
    Reads the value of the GPIO pin, RD0.

  @Description
    Reads the value of the GPIO pin, RD0.

  @Preconditions
    None.

  @Returns
    None.

  @Param
    None.

  @Example
    <code>
    uint16_t portValue;

    // Read RD0
    postValue = SCK1OUT_GetValue();
    </code>

*/
#define SCK1OUT_GetValue()         _RD0
/**
  @Summary
    Configures the GPIO pin, RD0, as an input.

  @Description
    Configures the GPIO pin, RD0, as an input.

  @Preconditions
    None.

  @Returns
    None.

  @Param
    None.

  @Example
    <code>
    // Sets the RD0 as an input
    SCK1OUT_SetDigitalInput();
    </code>

*/
#define SCK1OUT_SetDigitalInput()  (_TRISD0 = 1)
/**
  @Summary
    Configures the GPIO pin, RD0, as an output.

  @Description
    Configures the GPIO pin, RD0, as an output.

  @Preconditions
    None.

  @Returns
    None.

  @Param
    None.

  @Example
    <code>
    // Sets the RD0 as an output
    SCK1OUT_SetDigitalOutput();
    </code>

*/
#define SCK1OUT_SetDigitalOutput() (_TRISD0 = 0)
/**
  @Summary
    Sets the GPIO pin, RD1, high using LATD1.

  @Description
    Sets the GPIO pin, RD1, high using LATD1.

  @Preconditions
    The RD1 must be set to an output.

  @Returns
    None.

  @Param
    None.

  @Example
    <code>
    // Set RD1 high (1)
    SDO1_SetHigh();
    </code>

*/
#define SDO1_SetHigh()          (_LATD1 = 1)
/**
  @Summary
    Sets the GPIO pin, RD1, low using LATD1.

  @Description
    Sets the GPIO pin, RD1, low using LATD1.

  @Preconditions
    The RD1 must be set to an output.

  @Returns
    None.

  @Param
    None.

  @Example
    <code>
    // Set RD1 low (0)
    SDO1_SetLow();
    </code>

*/
#define SDO1_SetLow()           (_LATD1 = 0)
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
/**
  @Summary
    Reads the value of the GPIO pin, RE7.

  @Description
    Reads the value of the GPIO pin, RE7.

  @Preconditions
    None.

  @Returns
    None.

  @Param
    None.

  @Example
    <code>
    uint16_t portValue;

    // Read RE7
    postValue = IO_RE7_GetValue();
    </code>

*/
#define IO_RE7_GetValue()         _RE7
/**
  @Summary
    Configures the GPIO pin, RE7, as an input.

  @Description
    Configures the GPIO pin, RE7, as an input.

  @Preconditions
    None.

  @Returns
    None.

  @Param
    None.

  @Example
    <code>
    // Sets the RE7 as an input
    IO_RE7_SetDigitalInput();
    </code>

*/
#define IO_RE7_SetDigitalInput()  (_TRISE7 = 1)
/**
  @Summary
    Configures the GPIO pin, RE7, as an output.

  @Description
    Configures the GPIO pin, RE7, as an output.

  @Preconditions
    None.

  @Returns
    None.

  @Param
    None.

  @Example
    <code>
    // Sets the RE7 as an output
    IO_RE7_SetDigitalOutput();
    </code>

*/
#define IO_RE7_SetDigitalOutput() (_TRISE7 = 0)

/**
    Section: Function Prototypes
*/
/**
  @Summary
    Configures the pin settings of the PIC24FJ128GL306
    The peripheral pin select, PPS, configuration is also handled by this manager.

  @Description
    This is the generated manager file for the PIC24 / dsPIC33 / PIC32MM MCUs device.  This manager
    configures the pins direction, initial state, analog setting.
    The peripheral pin select, PPS, configuration is also handled by this manager.

  @Preconditions
    None.

  @Returns
    None.

  @Param
    None.

  @Example
    <code>
    void SYSTEM_Initialize(void)
    {
        // Other initializers are called from this function
        PIN_MANAGER_Initialize();
    }
    </code>

*/
void PIN_MANAGER_Initialize (void);



#endif
