karliedapuzzo/TDWS/TDWS_PIC24_FILES/Main_Project/TDWS_Main_Prgram.X/radar.c

/**
  Generated main.c file from MPLAB Code Configurator

  @Company
    Microchip Technology Inc.

  @File Name
    main.c

  @Summary
    This is the generated main.c using PIC24 / dsPIC33 / PIC32MM MCUs.

  @Description
    This source file provides main entry point for system initialization and application code development.
    Generation Information :
        Product Revision  :  PIC24 / dsPIC33 / PIC32MM MCUs - 1.171.5
        Device            :  PIC24FJ128GL306
    The generated drivers are tested against the following:
        Compiler          :  XC16 v2.10
        MPLAB 	          :  MPLAB X v6.05
*/

/*
    (c) 2020 Microchip Technology Inc. and its subsidiaries. You may use this
    software and any derivatives exclusively with Microchip products.

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
    IN NO EVENT WILL MICROCHIP BE LIABLE FOR ANY INDIRECT, SPECIAL, PUNITIVE,
    INCIDENTAL OR CONSEQUENTIAL LOSS, DAMAGE, COST OR EXPENSE OF ANY KIND
    WHATSOEVER RELATED TO THE SOFTWARE, HOWEVER CAUSED, EVEN IF MICROCHIP HAS
    BEEN ADVISED OF THE POSSIBILITY OR THE DAMAGES ARE FORESEEABLE. TO THE
    FULLEST EXTENT ALLOWED BY LAW, MICROCHIP'S TOTAL LIABILITY ON ALL CLAIMS IN
    ANY WAY RELATED TO THIS SOFTWARE WILL NOT EXCEED THE AMOUNT OF FEES, IF ANY,
    THAT YOU HAVE PAID DIRECTLY TO MICROCHIP FOR THIS SOFTWARE.

    MICROCHIP PROVIDES THIS SOFTWARE CONDITIONALLY UPON YOUR ACCEPTANCE OF THESE
    TERMS.
*/

/**
  Section: Included Files
*/
#include "mcc_generated_files/system.h"
#include "radar.h"
#include "mcc_generated_files/spi1.h"
#include "mcc_generated_files/pin_manager.h"
#include "mcc_generated_files/uart4.h"
#include "mcc_generated_files/interrupt_manager.h"

/*
                         Main application
 */

struct RadarData {
    uint8_t num_targets;
    uint8_t distance_low[8];
    uint8_t distance_high[8];
    int8_t speed_low[8];
    int8_t speed_high[8];
    int8_t angle_low[8];
    int8_t angle_high[8];
    uint8_t magnitude_low[8];
    uint8_t magnitude_high[8]; 
    uint8_t identification[8];
};

struct RadarParam {
    uint8_t version[19];
    uint8_t freq_channel;
    uint8_t speed_setting;
    uint8_t range_setting;
    uint8_t threshold_offset;
    uint8_t tracking_filttype;
    uint8_t minzone_detect;
    uint8_t maxzone_detect;
    int8_t minangl_detect;
    int8_t maxangl_detect;
    uint8_t minspee_detect;
    uint8_t maxspee_detect;
    uint8_t direction_filt;
};


uint8_t RADAR_facreset(void)
{
    uint8_t RFSE_test[8] = {'R', 'F', 'S', 'E', 0x00, 0x00, 0x00, 0x00};
    uint8_t RFSE_RESP_test[9];
    uint8_t error_code = 0x08;
    uint8_t i = 0;
    
    //sends command to reset radar to factory settings 
    for (i = 0; i <= 7; i++){               //shifts through all our command bytes
        UART1_Write(RFSE_test[i]);          //writes command byte to TX
        while (UART1_IsTxReady() == 0)      //holds here till we can transmit our next byte
        {
        }
    }
            
    //reads response from the initialization command
    for (i = 0; i <= 8; i++){               //shifts through all our respond bytes
        RFSE_RESP_test[i] = UART1_Read();   //reads response byte from RX
        if (i == 8){
            error_code = RFSE_RESP_test[i]; //save error_code from response from radar
        }
    }
    
    return(error_code);
}

uint8_t RADAR_disconnect(void)
{
    uint8_t GBYE_command[8] = {'G', 'B', 'Y', 'E', 0x00, 0x00, 0x00, 0x00};
    uint8_t GBYE_RESP_test[9] = {1};
    uint8_t i = 0;
    uint8_t error_code = 0x08;
    
    //sends command to initialize radar to a baud rate 
    for (i = 0; i <= 8; i++){               //shifts through all our command bytes
        UART1_Write(GBYE_command[i]);      //writes command byte to TX
        while (UART1_IsTxReady() == 0)      //holds here till we can transmit our next byte
        {
        }
    }
            
    //reads response from the initialization command
    for (i = 0; i <= 8; i++){          //shifts through all our respond bytes
        GBYE_RESP_test[i] = UART1_Read();    //reads response byte from RX
        if (i == 8){
            error_code = GBYE_RESP_test[i]; //save error_code from response from radar
        }
    }
    
    return(error_code);
}

uint8_t RADAR_init(uint8_t baud_setting)
{
    uint8_t INIT_test[8] = {'I', 'N', 'I', 'T', 0x01, 0x00, 0x00, 0x00};
    uint8_t INIT_RESP_test[9] = {1};
    uint8_t VERS_test[27] = {1};
    uint8_t i = 0;
    uint8_t error_code = 0x08;
    
    //sends command to initialize radar to a baud rate 
    for (i = 0; i <= 8; i++){               //shifts through all our command bytes
        if (i < 8){
            UART1_Write(INIT_test[i]);      //writes command byte to TX
        } else if (i == 8){
            UART1_Write(baud_setting);      //writes baud rate setting from input
        }
        while (UART1_IsTxReady() == 0)      //holds here till we can transmit our next byte
        {
        }
    }
            
    //reads response from the initialization command
    for (i = 0; i <= 8; i++){          //shifts through all our respond bytes
        INIT_RESP_test[i] = UART1_Read();    //reads response byte from RX
        if (i == 8){
            error_code = INIT_RESP_test[i]; //save error_code from response from radar
        }
    }
            
    //reads firmware_string from the initialization command
    for (i = 0; i <= 26; i++){          //shifts through all our version bytes
        VERS_test[i] = UART1_Read();    //reads response byte from RX
    }
    
    return(error_code);
}

uint8_t RADAR_mindetzone(uint8_t minimum_range)
{
    uint8_t MIRA_command[8] = {'M', 'I', 'R', 'A', 0x01, 0x00, 0x00, 0x00};
    uint8_t MIRA_RESP[9] = {1};
    uint8_t i = 0;
    uint8_t error_code = 0x08;
    
    //sends command to set minimum range of detection zone 
    for (i = 0; i <= 8; i++){               //shifts through all our command bytes
        if (i < 8){
            UART1_Write(MIRA_command[i]);      //writes command byte to TX
        } else if (i == 8){
            UART1_Write(minimum_range);     //writes minimum range setting from input
        }
        while (UART1_IsTxReady() == 0)      //holds here till we can transmit our next byte
        {
        }
    }
    
    //reads response from the initialization command
    for (i = 0; i <= 8; i++){               //shifts through all our respond bytes
        MIRA_RESP[i] = UART1_Read();   //reads response byte from RX
        if (i == 8){
            error_code = MIRA_RESP[i]; //save error_code from response from radar
        }
    }
    
    return(error_code);
}

uint8_t RADAR_maxdetzone(uint8_t maximum_range)
{
    uint8_t MARA_command[8] = {'M', 'A', 'R', 'A', 0x01, 0x00, 0x00, 0x00};
    uint8_t MARA_RESP[9] = {1};
    uint8_t i = 0;
    uint8_t error_code = 0x08;
    
    //sends command to set maximum range of detection zone 
    for (i = 0; i <= 8; i++){               //shifts through all our command bytes
        if (i < 8){
            UART1_Write(MARA_command[i]);      //writes command byte to TX
        } else if (i == 8){
            UART1_Write(maximum_range);     //writes maximum range setting from input
        }
        while (UART1_IsTxReady() == 0)      //holds here till we can transmit our next byte
        {
        }
    }
    
    //reads response from the initialization command
    for (i = 0; i <= 8; i++){               //shifts through all our respond bytes
        MARA_RESP[i] = UART1_Read();   //reads response byte from RX
        if (i == 8){
            error_code = MARA_RESP[i]; //save error_code from response from radar
        }
    }
    
    return(error_code);
}

uint8_t RADAR_threshoffset(uint8_t thresh_offset)
{
    uint8_t THOF[8] = {'T', 'H', 'O', 'F', 0x01, 0x00, 0x00, 0x00};
    uint8_t THOF_RESP[9] = {1};
    uint8_t i = 0;
    uint8_t error_code = 0x08;
    
    //sends command to set threshold offset 
    for (i = 0; i <= 8; i++){               //shifts through all our command bytes
        if (i < 8){
            UART1_Write(THOF[i]);      //writes command byte to TX
        } else if (i == 8){
            UART1_Write(thresh_offset);     //writes threshold from input
        }
        while (UART1_IsTxReady() == 0)      //holds here till we can transmit our next byte
        {
        }
    }
    
    //reads response from the initialization command
    for (i = 0; i <= 8; i++){               //shifts through all our respond bytes
        THOF_RESP[i] = UART1_Read();   //reads response byte from RX
        if (i == 8){
            error_code = THOF_RESP[i]; //save error_code from response from radar
        }
    }
    
    return(error_code);
}

uint8_t RADAR_nexttdat(struct RadarData *result)
{
    uint8_t GNFD_test[9] = {'G', 'N', 'F', 'D', 0x01, 0x00, 0x00, 0x00, 0x08};
    uint8_t GNFD_RESP_test[9] = {1};
    uint8_t TDAT_headpay[8] = {1};
    uint8_t i = 0;
    uint8_t error_code = 0x08;
    
    //sends command to ask for next data frame 
    for (i = 0; i <= 8; i++){               //shifts through all our command bytes
        UART1_Write(GNFD_test[i]);      //writes command byte to TX
        while (UART1_IsTxReady() == 0)      //holds here till we can transmit our next byte
        {
        }
    }
    
    //reads response from the next frame data request command
    for (i = 0; i <= 8; i++){               //shifts through all our respond bytes
        GNFD_RESP_test[i] = UART1_Read();   //reads response byte from RX
        if (i == 8){
            error_code = GNFD_RESP_test[i]; //save error_code from response from radar
        }
    }
    
    if (error_code == 0x00){
        for (i=0; i<=7; i++){
            TDAT_headpay[i] = UART1_Read();
        }
        result->num_targets = TDAT_headpay[4]/9;
        if (result->num_targets != 0){
            for (i=0;i <= result->num_targets - 1; i++){
                result->distance_low[i] = UART1_Read();
                result->distance_high[i] = UART1_Read();
                result->speed_low[i] = UART1_Read();
                result->speed_high[i] = UART1_Read();
                result->angle_low[i] = UART1_Read();
                result->angle_high[i] = UART1_Read();
                result->magnitude_low[i] = UART1_Read(); 
                result->magnitude_high[i] = UART1_Read();
                result->identification[i] = UART1_Read();
            }
        }
    }
    
    return(error_code);
}

uint8_t RADAR_readparam(struct RadarParam *result)
{
    uint8_t GRPS_test[8] = {'G', 'R', 'P', 'S', 0x00, 0x00, 0x00, 0x00};
    uint8_t GRPS_RESP_test[9] = {1};
    uint8_t RPST_test[8] = {1};
    uint8_t i = 0;
    uint8_t error_code = 0x08;
    
    //sends command to ask for next data frame 
    for (i = 0; i <= 7; i++){               //shifts through all our command bytes
        UART1_Write(GRPS_test[i]);      //writes command byte to TX
        while (UART1_IsTxReady() == 0)      //holds here till we can transmit our next byte
        {
        }
    }
    
    //reads response from the next frame data request command
    for (i = 0; i <= 8; i++){               //shifts through all our respond bytes
        GRPS_RESP_test[i] = UART1_Read();   //reads response byte from RX
        if (i == 8){
            error_code = GRPS_RESP_test[i]; //save error_code from response from radar
        }
    }
    
    if (error_code == 0x00){
        //read header, payload length, and version 
        for (i=0; i<= 7; i++){
            RPST_test[i] = UART1_Read();
        }
        for (i=0; i<= 18; i++){
            result->version[i] = UART1_Read();
        }
        //read parameters
        result->freq_channel = UART1_Read();
        result->speed_setting = UART1_Read();
        result->range_setting = UART1_Read();
        result->threshold_offset = UART1_Read();
        result->tracking_filttype = UART1_Read();
        result->minzone_detect = UART1_Read(); 
        result->maxzone_detect = UART1_Read();
        result->minangl_detect = UART1_Read();
        result->maxangl_detect = UART1_Read();
        result->minspee_detect = UART1_Read();
        result->maxspee_detect = UART1_Read();
        result->direction_filt = UART1_Read();
    }
    
    return(error_code);
}

uint8_t RADAR_speedset(uint8_t speed_setting){
    uint8_t RSPI_command[8] = {'R', 'S', 'P', 'I', 0x01, 0x00, 0x00, 0x00};
    uint8_t RSPI_RESP[9] = {1};
    uint8_t i = 0;
    uint8_t error_code = 0x08;
    
    //sends command to set maximum range of detection zone 
    for (i = 0; i <= 8; i++){               //shifts through all our command bytes
        if (i < 8){
            UART1_Write(RSPI_command[i]);      //writes command byte to TX
        } else if (i == 8){
            UART1_Write(speed_setting);     //writes maximum range setting from input
        }
        while (UART1_IsTxReady() == 0)      //holds here till we can transmit our next byte
        {
        }
    }
    
    //reads response from the initialization command
    for (i = 0; i <= 8; i++){               //shifts through all our respond bytes
        RSPI_RESP[i] = UART1_Read();   //reads response byte from RX
        if (i == 8){
            error_code = RSPI_RESP[i]; //save error_code from response from radar
        }
    }
    
    return(error_code);
}

uint8_t RADAR_rangeset(uint8_t range_setting){
    uint8_t RRAI_command[8] = {'R', 'R', 'A', 'I', 0x01, 0x00, 0x00, 0x00};
    uint8_t RRAI_RESP[9] = {1};
    uint8_t i = 0;
    uint8_t error_code = 0x08;
    
    //sends command to set maximum range of detection zone 
    for (i = 0; i <= 8; i++){               //shifts through all our command bytes
        if (i < 8){
            UART1_Write(RRAI_command[i]);      //writes command byte to TX
        } else if (i == 8){
            UART1_Write(range_setting);     //writes maximum range setting from input
        }
        while (UART1_IsTxReady() == 0)      //holds here till we can transmit our next byte
        {
        }
    }
    
    //reads response from the initialization command
    for (i = 0; i <= 8; i++){               //shifts through all our respond bytes
        RRAI_RESP[i] = UART1_Read();   //reads response byte from RX
        if (i == 8){
            error_code = RRAI_RESP[i]; //save error_code from response from radar
        }
    }
    
    return(error_code);
}

uint8_t RADAR_filttype(uint8_t filter_type){
    uint8_t TRFT_command[8] = {'T', 'R', 'F', 'T', 0x01, 0x00, 0x00, 0x00};
    uint8_t TRFT_RESP[9] = {1};
    uint8_t i = 0;
    uint8_t error_code = 0x08;
    
    //sends command to set maximum range of detection zone 
    for (i = 0; i <= 8; i++){               //shifts through all our command bytes
        if (i < 8){
            UART1_Write(TRFT_command[i]);      //writes command byte to TX
        } else if (i == 8){
            UART1_Write(filter_type);     //writes maximum range setting from input
        }
        while (UART1_IsTxReady() == 0)      //holds here till we can transmit our next byte
        {
        }
    }
    
    //reads response from the initialization command
    for (i = 0; i <= 8; i++){               //shifts through all our respond bytes
        TRFT_RESP[i] = UART1_Read();   //reads response byte from RX
        if (i == 8){
            error_code = TRFT_RESP[i]; //save error_code from response from radar
        }
    }
    
    return(error_code);
}

uint8_t RADAR_minangle(int8_t min_angle){
    uint8_t MIAN_command[8] = {'M', 'I', 'A', 'N', 0x01, 0x00, 0x00, 0x00};
    uint8_t MIAN_RESP[9] = {1};
    uint8_t i = 0;
    uint8_t error_code = 0x08;
    
    //sends command to set maximum range of detection zone 
    for (i = 0; i <= 8; i++){               //shifts through all our command bytes
        if (i < 8){
            UART1_Write(MIAN_command[i]);      //writes command byte to TX
        } else if (i == 8){
            UART1_Write(min_angle);     //writes maximum range setting from input
        }
        while (UART1_IsTxReady() == 0)      //holds here till we can transmit our next byte
        {
        }
    }
    
    //reads response from the initialization command
    for (i = 0; i <= 8; i++){               //shifts through all our respond bytes
        MIAN_RESP[i] = UART1_Read();   //reads response byte from RX
        if (i == 8){
            error_code = MIAN_RESP[i]; //save error_code from response from radar
        }
    }
    
    return(error_code);
}

uint8_t RADAR_maxangle(int8_t max_angle){
    uint8_t MAAN_command[8] = {'M', 'A', 'A', 'N', 0x01, 0x00, 0x00, 0x00};
    uint8_t MAAN_RESP[9] = {1};
    uint8_t i = 0;
    uint8_t error_code = 0x08;
    
    //sends command to set maximum range of detection zone 
    for (i = 0; i <= 8; i++){               //shifts through all our command bytes
        if (i < 8){
            UART1_Write(MAAN_command[i]);      //writes command byte to TX
        } else if (i == 8){
            UART1_Write(max_angle);     //writes maximum range setting from input
        }
        while (UART1_IsTxReady() == 0)      //holds here till we can transmit our next byte
        {
        }
    }
    
    //reads response from the initialization command
    for (i = 0; i <= 8; i++){               //shifts through all our respond bytes
        MAAN_RESP[i] = UART1_Read();   //reads response byte from RX
        if (i == 8){
            error_code = MAAN_RESP[i]; //save error_code from response from radar
        }
    }
    
    return(error_code);
}

uint8_t RADAR_minspeed(uint8_t min_speed){
    uint8_t MISP_command[8] = {'M', 'I', 'S', 'P', 0x01, 0x00, 0x00, 0x00};
    uint8_t MISP_RESP[9] = {1};
    uint8_t i = 0;
    uint8_t error_code = 0x08;
    
    //sends command to set maximum range of detection zone 
    for (i = 0; i <= 8; i++){               //shifts through all our command bytes
        if (i < 8){
            UART1_Write(MISP_command[i]);      //writes command byte to TX
        } else if (i == 8){
            UART1_Write(min_speed);     //writes maximum range setting from input
        }
        while (UART1_IsTxReady() == 0)      //holds here till we can transmit our next byte
        {
        }
    }
    
    //reads response from the initialization command
    for (i = 0; i <= 8; i++){               //shifts through all our respond bytes
        MISP_RESP[i] = UART1_Read();   //reads response byte from RX
        if (i == 8){
            error_code = MISP_RESP[i]; //save error_code from response from radar
        }
    }
    
    return(error_code);
}

uint8_t RADAR_maxspeed(uint8_t max_speed){
    uint8_t MASP_command[8] = {'M', 'A', 'S', 'P', 0x01, 0x00, 0x00, 0x00};
    uint8_t MASP_RESP[9] = {1};
    uint8_t i = 0;
    uint8_t error_code = 0x08;
    
    //sends command to set maximum range of detection zone 
    for (i = 0; i <= 8; i++){               //shifts through all our command bytes
        if (i < 8){
            UART1_Write(MASP_command[i]);      //writes command byte to TX
        } else if (i == 8){
            UART1_Write(max_speed);     //writes maximum range setting from input
        }
        while (UART1_IsTxReady() == 0)      //holds here till we can transmit our next byte
        {
        }
    }
    
    //reads response from the initialization command
    for (i = 0; i <= 8; i++){               //shifts through all our respond bytes
        MASP_RESP[i] = UART1_Read();   //reads response byte from RX
        if (i == 8){
            error_code = MASP_RESP[i]; //save error_code from response from radar
        }
    }
    
    return(error_code);
}

uint8_t RADAR_directset(uint8_t direction_setting){
    uint8_t DEDI_command[8] = {'D', 'E', 'D', 'I', 0x01, 0x00, 0x00, 0x00};
    uint8_t DEDI_RESP[9] = {1};
    uint8_t i = 0;
    uint8_t error_code = 0x08;
    
    //sends command to set maximum range of detection zone 
    for (i = 0; i <= 8; i++){               //shifts through all our command bytes
        if (i < 8){
            UART1_Write(DEDI_command[i]);      //writes command byte to TX
        } else if (i == 8){
            UART1_Write(direction_setting);     //writes maximum range setting from input
        }
        while (UART1_IsTxReady() == 0)      //holds here till we can transmit our next byte
        {
        }
    }
    
    //reads response from the initialization command
    for (i = 0; i <= 8; i++){               //shifts through all our respond bytes
        DEDI_RESP[i] = UART1_Read();   //reads response byte from RX
        if (i == 8){
            error_code = DEDI_RESP[i]; //save error_code from response from radar
        }
    }
    
    return(error_code);
}

uint16_t UINT8to16(uint8_t high_byte, uint8_t low_byte)
{
    uint16_t result;
    result = (high_byte << 8) | low_byte;
    return(result);
}

int16_t UINT8toINT16(uint8_t high_byte, uint8_t low_byte)
{
    int16_t result;
    result = (int16_t)((high_byte << 8) | low_byte);
    return(result);
}

void RADAR_printhead(void){
    char header[] = "ID, Distance(cm), Speed(km/h x 100), Angle(deg x 100), Magnitude of target(dB x 100)";
    uint8_t i;
    
    //sends command to set maximum range of detection zone 
    for (i = 0; i <= 85; i++){               //shifts through all our command bytes
        UART4_Write(header[i]);     //writes maximum range setting from input
        while (UART4_IsTxReady() == 0)      //holds here till we can transmit our next byte
        {
        }
    }
    UART4_Write(0x0A);     //writes maximum range setting from input
    while (UART4_IsTxReady() == 0)      //holds here till we can transmit our next byte
    {
    }
    UART4_Write(0x0D);     //writes maximum range setting from input
    while (UART4_IsTxReady() == 0)      //holds here till we can transmit our next byte
    {
    }
    
}

void RADAR_printdecimal(uint16_t number){
    char buffer[20];
    uint8_t i = 0;
    sprintf(buffer, "%d", number);
    for (i = 0; buffer[i] != '\0'; i++){
        UART4_Write(buffer[i]);     //writes maximum range setting from input
        while (UART4_IsTxReady() == 0)      //holds here till we can transmit our next byte
        {
        }
    }
}

void RADAR_printdata(struct RadarData *results){
    uint8_t i = 0;
    if (results->num_targets > 0){
        for (i=0; i <= results->num_targets - 1; i++){
        
            RADAR_printdecimal(results->identification[i]);
            UART4_Write(',');     //writes maximum range setting from input
            while (UART4_IsTxReady() == 0)      //holds here till we can transmit our next byte
            {
            }
            RADAR_printdecimal(UINT8to16(results->distance_high[i], results->distance_low[i]));     //writes maximum range setting from input
            UART4_Write(',');     //writes maximum range setting from input
            while (UART4_IsTxReady() == 0)      //holds here till we can transmit our next byte
            {
            }
            RADAR_printdecimal(UINT8toINT16(results->speed_high[i], results->speed_low[i]));     //writes maximum range setting from input
            UART4_Write(',');     //writes maximum range setting from input
            while (UART4_IsTxReady() == 0)      //holds here till we can transmit our next byte
            {
            }
            RADAR_printdecimal(UINT8toINT16(results->angle_high[i], results->angle_low[i]));     //writes maximum range setting from input
            UART4_Write(',');     //writes maximum range setting from input
            while (UART4_IsTxReady() == 0)      //holds here till we can transmit our next byte
            {
            }
            RADAR_printdecimal(UINT8to16(results->magnitude_high[i], results->magnitude_low[i]));     //writes maximum range setting from input
            UART4_Write(0x0A);     //writes maximum range setting from input
            while (UART4_IsTxReady() == 0)      //holds here till we can transmit our next byte
            {
            }
            UART4_Write(0x0D);     //writes maximum range setting from input
            while (UART4_IsTxReady() == 0)      //holds here till we can transmit our next byte
            {
            }
        }
    }
}
/**
 End of File
*/
