karliedapuzzo/TDWS/(commit log)

2025-01-01 integrated magnetometer functions into main project :D
2025-01-07 working on lora receiver code... not working :/
    [main.c]
2025-01-17 got the uart2 interrupt working yay, need to implement rest of receiver code
2025-02-12 have a way to spit out radar data to uart 4
2025-03-04 filter works I think
2025-03-04 changed up the filter a little bit
2025-03-14 fixed up the radar stuff
    [main.c, radar.c]
2025-03-17 added magnetometer detection test and also fixed the light test mode
    [main.c, pin_manager.h]
2025-04-16 added pcb schematic files
    [Cart_Feb04_0515PM.xls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]
2025-04-16 added user manual and additional charge controller manual
